FeSens/openTPU/THIRD_PARTY.md

# Third-party material

openTPU is licensed under the Apache License 2.0 ([LICENSE](LICENSE)). The files below are
generated by, derived from or copied from other projects and keep their own licences. No vendor
IP source is in this repository: the Xilinx / AMD cores (XDMA, DDR4 MIG, Aurora 64B/66B,
SmartConnect, clocking and system-management wizards) are created by the boards' Tcl at build
time from the builder's own Vivado install.

| Files | From | Licence |
|---|---|---|
| `boards/ypcb-00338/litedram/otpu_litedram.v`, `boards/bcu1525/litedram/otpu_ld4.v`, `boards/bcu1525/litedram_udimm/otpu_ld4.v`, `sim/verilator/otpu_ldc_ch.v` (Migen, through `tools/litedram/gen_ldc.py`) and their `csr.csv` / `sdram_init.py` (also under `opentpu/host/litedram*/` and `tests/data/litedram*/`) | Netlists and software headers generated by [LiteX](https://github.com/enjoy-digital/litex) and [LiteDRAM](https://github.com/enjoy-digital/litedram) (Copyright Enjoy-Digital and the LiteX developers). Each directory's `core.json` records the repositories and commits. | BSD-2-Clause |
| the VexRiscv CPU inside those netlists | [VexRiscv](https://github.com/SpinalHDL/VexRiscv) through `pythondata-cpu-vexriscv` (Copyright Spinal HDL contributors) | MIT |
| the `*.init` memory images beside those netlists | The LiteX BIOS, compiled; it links [picolibc](https://github.com/picolibc/picolibc) and LLVM's compiler-rt builtins (`pythondata-software-picolibc`, `pythondata-software-compiler_rt`) | BSD-2-Clause (LiteX); BSD-style, see picolibc's `COPYING.picolibc`; Apache-2.0 with LLVM exceptions (compiler-rt) |
| `boards/bcu1525/constraints/ddr4_c*.pins.xdc`, `ddr4_c*.udimm.pins.xdc`, `bcu1525_pins.xdc`, `bcu1525_wg_pins.xdc` (pads) | AMD XilinxBoardStore 2024.1, `boards/Xilinx/vcu1525/1.3/part0_pins.xml` (Copyright 2023 Advanced Micro Devices, Inc.) | Apache-2.0 |
| the same files (drive settings) | LiteX-Boards' `sqrl_xcu1525` platform | BSD-2-Clause |
| `boards/bcu1525/x2/pins_x2.xdc` (QSFP28 pads) | [Corundum](https://github.com/corundum/corundum)'s AU200 / VCU1525 constraints (Copyright The Regents of the University of California) | BSD-2-Clause-Views |
| `boards/bcu1525/link/otpu_link_gtcommon_bcu.v` | This project's module around the `GTYE4_COMMON` primitive. Its attribute values and tie-offs are the settings AMD's Aurora 64B/66B 13.0 core computes for 25.78125 Gb/s from a 161.1328125 MHz reference, extracted by `boards/bcu1525/link/scripts/gen_gtcommon.py` from the core's example design; none of the core's source is included. | Apache-2.0 (this project) |
| `boards/bcu1525/link/sim/otpu_link_phy_stubs.sv` (port lists) | Yosys `cells_xtra.v` | ISC |
| `tests/data/qwen36_chat_template.jinja`, `tools/pf500_models/Qwen3.6-35B-A3B/config.json` | The Qwen3.6-35B-A3B checkpoint's chat template and configuration (Alibaba Cloud), unmodified | Apache-2.0 |
| `tests/data/lfm2_chat_template.jinja` | The LFM2-2.6B checkpoint's chat template (Liquid AI, Inc.), unmodified | LFM Open License v1.0, a copy at `tests/data/LFM_OPEN_LICENSE_v1.0.txt` |
| `asic/nangate45/openlayout/skills/` | see its own `LICENSE` | as stated there |

Model weights are not in this repository; each checkpoint's licence applies to its use.
