FeSens/openTPU/docs/mxu_systolic.md

# A 2D systolic MXU (`MXU_IMPL=2`)

Goal: an MXU that scales to MCOLS = 8 (4 and 12 must also build) on the xc7k480t without the
broadcast fan-outs and the fabric adder tree that make MCOLS = 4 fail timing today
([mxu_study.md](mxu_study.md); the MCOLS = 4 builds of 2026-09-28: fmax 101-119 MHz at 97% of the
slices, worst paths route-dominated). Results must stay bit-identical to the ISA simulator, and
decode must not lose cycles.

**Since the MX column** ([mx_mxu.md](mx_mxu.md) section 9, branch `mx-rtl-prod`): the systolic
array is the only MXU (`IMPL` 0 and 1 are gone; `MXU_IMPL` must be 2), and everything after the
chain ends is new. The four `otpu_colend` DSPs and the per-column fp32 epilogue (i2f, the two
scale multiplies, the isum_4 loop) are replaced by `otpu_mxce` (rtl/tech: eight DSPs that take
each chain end times m << sh and a ninth that accumulates the whole row exactly in 48 bits), the
result FIFO holds the rows' integers, and E = MCOLS/2 lanes the columns share do the epilogue
once per output. The array below (hops, skews, the PAIR select in `otpu_pe`, row-gated pops,
command overlap) is unchanged; the column-end and epilogue lines of this page describe the
previous design.

## What changes, what stays

The MXU is a D x MCOLS dot-product engine: each advance, one D = 128-byte weight chunk (one K-block
of one output row, or two 4-bit blocks under PAIR) meets MCOLS activation blocks (ACT RAM, one per
column = one activation row), and each column reduces its 128 int8 x int8 products exactly, then
runs a per-column fp32 epilogue. `IMPL=0` broadcasts the decoded chunk to every column and sums in
a fabric tree; `IMPL=1` (study) sums along D in DSP cascades but still broadcasts the (skewed)
weights, and supports neither 4-bit weights nor PAIR.

`IMPL=2` keeps the MXU's front and back unchanged:

- the issuer, the chunk / scale FIFOs, the pop logic, the ACT RAM interface;
- the fp32 epilogue per column, in the ISA's order: i2f (exact) -> x weight scale -> x activation
  scale -> [PAIR: + partner column] -> isum_4 partial loop -> (p0+p2)+(p1+p3) -> result FIFO ->
  drain (ACC / ASCALE read-modify-write, RMAX). Integer sums are order-free; every fp op here is
  not, so the epilogue is not touched.

and replaces the dot product (operands -> s4, the exact integer block sum) with a systolic array.

## The array

```
            column 0            column 1                 column MCOLS-1
w chunk -> decode -> skew -> [hop] -> ... -> [hop] -> ... -> [hop]
                      |          |                        |
position i (chain g = i/16, stage k = i%16), in each column:
    act[j][i] (ACT RAM, delayed 1 + k + j: one SRLC32E per bit)
    M  = act * w          (DSP48E1 M register, one product per DSP)
    P  = PCIN + M         (stage k > 0; stage 0: P = M)  -> the chain's running sum
chain ends (8 per column): sub-block b = chains 2b, 2b+1 (32 positions, the 4-bit sub-block)
    v[b] = (chain 2b + chain 2b+1) * m_b   (otpu_colend: DSP b's pre-adder, multiplier, M)
    s4   = v0 + v1 + v2 + v3               (the four DSPs' PCIN cascade, DSP 3's P register)
deskew: column j's s4 delayed MCOLS-1-j cycles -> all columns aligned for the epilogue
```

- **Weights flow, not broadcast.** The chunk is decoded once (int8; int4 / E2M1 nibbles -> int8),
  skewed once per chain stage (shared SRLs, delay k), and then moves one register hop per column:
  column j sees it j cycles after column 0. Each hop register drives one DSP per position and the
  next hop: fan-out 2, not MCOLS.
- **PAIR (4-bit, 2M <= MCOLS):** columns j < M take the chunk's low block, columns j >= M its high
  block. Both decoded streams flow (2 x 8 bits per position per hop) and each column selects its
  stream with a per-command constant (`hi0[j]`) in the DSP48E1 itself (`otpu_pe`, in
  `rtl/tech/xilinx7/otpu_tech_dsp.sv`; the generic and DSP48E2 versions in `rtl/tech/generic`,
  `rtl/tech/xilinxus`: A = low, D =
  high, INMODE selects one through the pre-adder), so there is no fabric mux per position and
  column. `hi0[j]` drives the INMODE of the column's 128 DSPs (a 128 fan-out, the OOC's worst path
  at MCOLS 4: 152 MHz); it only changes between commands whose rows do not overlap.
- **Activations** stay per column (ACT RAM rows). Their delay, 1 (the decode register) + k (chain
  stage) + j (column), is at most 1 + 15 + 11 = 27 cycles for MCOLS <= 12: one SRLC32E per bit,
  the same cost as IMPL=1's chain skew alone. The column delay is free.
- **One product per DSP.** Two int8 products per DSP48E1 is not exact on a cascade (the study:
  the low field overflows after 3 accumulations), so each column has 128 product DSPs, 4 sub-block
  multipliers and the epilogue's fp multipliers: 138 DSP per column, 1,106 at MCOLS = 8 of the
  part's 1920 (measured; the rest of the design uses ~150).
- **The 4-bit sub-blocks** are 32 positions = two 16-stage chains, so the sub-block multipliers
  m_b apply at the chain ends, exactly as IMPL=0 applies them to its group sums. int8 uses
  m_b = 1. Chain length is fixed at 16 (`CL`).
- **Latency** S0 -> aligned s4: 1 (decode) + 16 (chain) + 1 (product) + 2 (v, s4) + MCOLS - 1
  (column skew, then deskew) = MCOLS + 19 cycles (23 at MCOLS 4, 27 at 8), against 7 for IMPL=0.
  It is paid once per MM command's drain (the study measured +17 cycles per MM chain for
  IMPL=1: negligible).

## Control travels with the data

Today every compute-pipeline register has the clock enable `en_c` (the pipeline freezes when a
row's next chunk has not arrived). Its fan-out and the control logic in front of it are the MXU's
worst paths on the board (the MXU `q_h` -> `mk` CE / tree / combine CE paths: 15-16 levels, ~88%
route). IMPL 2 removes it:

- **Row-gated pops.** A row's first block pops only when all of the row's chunks and scales are
  in the FIFOs (the FIFO holds a whole row already: replay requires KB <= DEPTH). A row then never
  stalls in its middle, `en_c` is constant 1, and the compute pipeline (array and epilogue) has no
  clock enable at all: a cycle without a pop is a bubble (an invalid slot), which the epilogue
  already handles between rows. The simulation checks that no row stalls.
- **Commands overlap.** The consumer used to run one command at a time: the next command's pops
  waited for the previous command's full drain (pipeline + epilogue + drain), so every MM paid the
  pipeline's latency, and IMPL 2's longer dot product (MCOLS + 19 cycles against 7) made that 16-20
  cycles more per MM. Now there are two heads over the command queue's two entries, the head `h`
  and the next command `n` (the tournament's `5cd6c39`: separate registers, no head pointer). The
  drain's head is `h` (the oldest command: its results, its ACC / ASCALE / RMAX state, its
  completion); the pop head moves to `n` (`pn`) as soon as the head's chunks have all popped,
  provided the pipeline treats both alike (the same PAIR and, under PAIR, the same M: `pr0`,
  `hi0` and `M0` are the only per-command state read after S0). The pop reads its command from
  `pop_q`, a register copy of the pop head's entry loaded with `h` and `n`, so neither side reads
  its command through a mux. The next command's rows follow the head's through the pipeline; the
  drain takes the head's rows (counted in `rows_live`, the pop head's in `rows_p`) and then moves
  on. IMPL 0 / 1 pop from `h` (no overlap).
- **Off the sequencer's path.** A command that becomes the head as it is accepted takes its chunk
  count (`c_left`) and its pop entry a cycle later, from `h` (`cl_ld`), not from the command
  (through the 16 x 16 multiply of its total) in the start cycle: it cannot pop before its release
  anyway, the pipeline is empty then, and the drained test waits for the load.
- **The result FIFO** is 64 rows for IMPL 2 (32 before): a row pops only while fewer than RF rows
  are between the pop and the drain, and one-block rows (attention scores, K = 128) fill the longer
  pipeline one per cycle; 32 blocked the pops (MLP decode +18%, LFM2 decode +4.8%).
- The drain keeps its own enable (the TMEM grant); it is outside the compute pipeline.

## Measured: area and fmax of `otpu_mxu` alone (Vivado 2026.1 OOC, synthesis + P&R)

xc7k480t-2, `otpu_mxu` out of context at a 6.667 ns clock (150 MHz), D = 128, board FIFO depth.
IMPL 0 is the tree with the DSP-cascade pair sums (`49ed2e0`); "use_dsp" is `465d629` (Vivado
infers the product DSPs); "DSP48E1" is `0cb4a7d` (`otpu_pe` instances, the stream select in the
pre-adder), the version on this branch.

| MXU | MCOLS | LUT | of which SRL | FF | slices | DSP | WNS | fmax |
|---|---|---|---|---|---|---|---|---|
| IMPL 0 (tree) | 4 | 26,389 | 163 | 15,504 | 9,479 | 282 | +0.153 | 153.5 MHz |
| IMPL 2, use_dsp | 4 | 24,426 | 2,651 | 31,540 | 12,232 | 554 | +0.332 | 157.9 MHz |
| IMPL 2, use_dsp | 8 | 47,822 | 5,440 | 60,926 | 23,706 | 1,106 | +0.045 | 151.0 MHz |
| IMPL 2, DSP48E1 | 4 | 22,504 | 2,699 | 34,894 | 12,298 | 554 | +0.109 | 152.5 MHz |
| IMPL 2, DSP48E1 | 8 | 44,779 | 5,304 | 67,997 | 24,214 | 1,106 | +0.068 | 151.5 MHz |

Per column (MCOLS 4 -> 8, DSP48E1): +5.6K LUT, +8.3K FF, +2.5K slices, +138 DSP. IMPL 0 per
column (synthesis, MCOLS 2 -> 4): +7.3K LUT, +3.4K FF, +70 DSP; in the MCOLS 2 -> 4 full builds
+7.8K LUT and +5.1K FF per column.

What this says, and what it does not:

- **LUTs go down** (-15% at MCOLS 4 against the tree; ~1.2K LUT less per column than the tree's
  synthesis). **Flip-flops more than double** (the weight hops, 2 x 8 bits per position and column,
  and the skew registers) and **DSPs double** (one product per DSP: 1,106 at MCOLS 8, ~1,250 with
  the rest of the design, 65% of the part; MCOLS 12 ~1,800, 94%).
- **OOC slices are higher** (12.3K against 9.5K at MCOLS 4). OOC P&R does not pack densely (the
  tree's 26.4K LUT would fit in 6.6K slices, the systolic array's 22.5K LUT / 34.9K FF in ~5.6K),
  so this is not the in-context density, but it is not the slice saving that would settle the
  MCOLS = 4 density cliff on its own: the full build has to show it.
- **Standalone fmax does not separate them**: the tree also makes 153 MHz alone. Its MCOLS = 4
  failure is in context (97% of the slices, route-dominated broadcast and control paths); the
  systolic array has no broadcast (fan-out 2 per hop), no compute clock enable and no fabric
  adder tree, which is what the full build tests.
- The worst paths alone: IMPL 0, the pair-sum pack register into the DSP C port; IMPL 2 at
  MCOLS 4, `hi0[j]` into the INMODE of its column's 128 DSPs (fan-out; a register per chain would
  remove it); at MCOLS 8, the weight skew SRL output into a DSP's A port (route).

## Measured: cycles (perf_qwen, board configuration, DDR3-1066, 120.755 MHz, fp4 weights)

`tools/perf_qwen.py --layers 0 --pos 256 --ddr 1066 --mhz 120.755 --wformat fp4 --head-format
int8 --bl 32 --wbl 8 --check` with PAIR and DSTEP; every run bit-exact with the ISA simulator.
Decode is one token at position 256; prefill is 6 rows (positions 256..261, `--rows 6 --logits
none`).

| model | IMPL 0, MCOLS 2 | IMPL 0, MCOLS 4 | IMPL 2, MCOLS 4 | IMPL 2, MCOLS 8 |
|---|---|---|---|---|
| LFM2 decode | 1,319,029 | 1,319,029 | 1,320,453 (+0.11%) | 1,320,668 (+0.12%) |
| Qwen3.5 decode | 4,848,785 | 4,832,273 | 4,832,035 (-0.35%) | 4,832,472 (-0.34%) |
| Qwen3 decode | 3,537,826 | | 3,541,285 (+0.10%) | |
| LFM2 prefill, 6 rows | 4,243,796 | | 2,949,361 (-31%) | 1,736,596 (-59%) |
| Qwen3.5 prefill, 6 rows | | 12,059,908 | 11,998,949 (-0.5%) | 9,323,037 (-23%) |
| Qwen3 prefill, 6 rows | 12,441,375 | | 8,979,279 (-28%) | 5,837,044 (-53%) |
| LFM2 prefill, 8 rows | 5,689,462 | | | 1,958,019 (-66%) |
| Qwen3 prefill, 8 rows | 16,559,838 | | | 6,813,500 (-59%) |

(Percentages against IMPL 0 at MCOLS 2 where it was measured; Qwen3.5's prefill against IMPL 0
at MCOLS 4. IMPL 0 ran on `11e00c4` (the tree with the DSP-cascade pair sums), IMPL 2 on the
systolic branches before the stream engine merge: `465d629` (MCOLS 4 and the 6-row MCOLS 8 runs)
and `0cb4a7d` (the 8-row runs), which have the same pipeline latency (LDOT).)

Decode does not regress (the gate: <= 1%). The overlap of commands pays IMPL 2's longer pipeline.

**The next bottleneck at MCOLS 8.** LFM2's prefill is still MXU-bound (MXU busy 95%, MAC 80.6% of
the cycles: 6 rows leave 2 of 8 columns idle). Qwen3.5's is not: DeltaNet is 65% of the cycles,
the DSTEP head steps (serial per token, 3.54M cycles of work in 9.32M, the same at any MCOLS) set
the pace, and the MXU waits 5.3M cycles in gaps after the QACT flush (`qwen35.py:1029`) and the
state window stores (`qwen35.py:1104`) in front of them. More columns do not help there; the
stream engine's state step does. Qwen3 sits between the two: MXU busy 90%, MAC 73.8%, but 9.7% of the
cycles the chunk FIFO is empty while streaming (the weight stream, not the array), and attention
is 63% of the cycles with the longest MXU gap (0.61M cycles) after the attention setup's QACT
(`attention.py:42`).

## Measured: the full build at MCOLS 4 (se-sys `2f80230`, 2026-09-29)

`make bit DDR=1066 AXI_BL=32 MCOLS=4 SE=v2`, CORE_MHZ 120.755, Vivado 2026.1 on the build host (the
stream engine v2 with its timing fixes, `202856d`, and `MXU_IMPL=2`). Timing not met: WNS
-0.381 ns (fmax 115.4 MHz), TNS -312 ns on 2,320 endpoints, WHS +0.016 ns.

| build | fmax | LUT | FF | slices | DSP | u_mxu LUT / FF / DSP |
|---|---|---|---|---|---|---|
| SE v2, MCOLS 2, IMPL 0 (`600c087`) | 117.9 MHz | 206,064 | | 64,441 (86.3%) | 301 | 19,600 / 10,435 / 142 |
| SE v2, MCOLS 4, IMPL 2 (`2f80230`) | 115.4 MHz | 210,766 | 178,678 | 68,898 (92.3%) | 713 | 25,418 / 31,570 / 554 |
| SE v1, MCOLS 4, IMPL 0 (m4b, 2026-09-28) | 115.8 MHz | 227,516 | 175,643 | ~72.3K (96.9%) | 493 | 31,459 / 19,662 / 282 |

MCOLS 2 -> 4 costs +4.7K LUT and +4.5K slices with the systolic MXU (+15.6K LUT with the tree),
so the design is 4.6 points of slices below the MCOLS 4 cliff. It still does not make
120.755 MHz: the failing paths are spread over the MXU's drain control (`q_h` -> `mk` CE and
`rx` resets, 15-16 levels, 89% route; `u_seq` -> `c_left`), the TMEM port-1 BRAM -> DMA `lb`
register (BRAM to BRAM, 5-6 levels), the AXI adapter (`qc` -> `qb_n` / `k1r_n`, 17-18 levels,
failing at MCOLS 2 too), and a few VPU / sequencer paths, all within -0.35 to -0.38 ns. The
compute array itself (hops, chains, skews) is not among them.

## Placement on the YPCB (release r2, MCOLS 8)

r2's first MCOLS 8 build (`f55949f9`, FAST, 100 MHz; MX MXU, MXU_E 8, one TMEM copy) placed but did
not route: "not routable, global congestion level 6", the router's first estimate South level 7
over 23.8% of the tiles (tile X 32-95, Y 80-239), and the same with Congestion_SpreadLogic_high.
Utilization was not the cause (60% LUT, 79% slices, 68% DSP). Each pin-box half perimeter per
net, summed per driver > load sub-block over the placed design, put about 55% of the level 7
window's wire demand on the array and its feed: the activation skews (`g_ask.g_p.u_a`) into the
PEs 15.5%, the weight hops (`wc`) 12.4% + 9%, the weight skew into column 0 6.2%, the chain ends
into the column ends 7%; the TMEM's single bank was not among the top 15. The placer had spread
each array column's 16-DSP cascade chains over 5-7 of the device's 12 DSP columns, across the
whole die, so position i of column j sat nowhere near position i of column j+1: the hop bits'
pin boxes were ~220 tiles, the design's longest.

`boards/ypcb-00338/constraints/otpu_mxu_place.tcl` (read by `create_project.tcl` for every build,
late, on the implemented netlist) LOCs the array as a grid at MCOLS 8 and up; below MCOLS 8 it
leaves the array to the placer (MCOLS 4 is better without it, below). It reads MCOLS and D from
the netlist's PE names and takes the part's column table:
- Array column j goes on one DSP column, positions 0..D-1 in order up it (the chains stay whole,
  position i is level in every column), with its column end (`otpu_mxce`, a 9-DSP cascade) above
  them and the column's scale RAM level with it. At MCOLS 8 that is DSP48_X1..X8 (tile X 14 29 34
  49 54 69 74 89), rows 10..146 of 160. Each chain's last DSP feeds its own DSP of the column end
  through fabric from its P register, so chain 0's end crosses 113 DSP rows (r2.1's m8 163ab46d:
  0 levels, 5.3-5.8 ns of route, -0.005 ns before userclk1's reroute; 76 such endpoints under
  +0.2 ns). `OTPU_MXU_CE=mid` puts the column end in the middle instead: chains 0..3 (positions
  0..63), the column end on rows 74..82, chains 4..7, the longest chain-end hop 65 rows. It does
  not pay: r2.1's m8 4f8be3d2 (mid) put the congestion on the column ends, three placer windows
  at level 5 (101-103%, tile X 27-58, Y 200-238: u_mxu, u_mem, u_seq, u_ch1) against 163ab46d's
  one, the weight feed's endpoints under +0.2 ns went from 88 to 455, and core_clk from -0.003 to
  -0.156 ns, so the default stays above the array (`top`, the same LOCs as before `mid` existed).
- The ACT RAM's memory of column j (`otpu_actram g_row[j]`: 4 pieces of 4 RAMB36, piece p = bytes
  32p..32p+31, and its scale RAM) goes in the block RAM column beside it, RAMB36_X1..X8 (tile X 17
  26 37 46 57 66 77 86). Each block RAM sits level with the 8 positions its bytes feed.
- The weight RAMs (`g_fd`, `u_fs0`, `u_fs1`) go in RAMB36_X0 (tile X 6), beside column 0. Through
  `wsel` a `g_fd` RAM's bits reach two position ranges, an 8-bit format's and a 4-bit one's (the
  high half's D/2 lower): `g_fd[1]`'s `mem_reg_5` reaches positions 58-62 and 117-125. Each goes
  level with the middle of the rows of the positions its outputs reach (`OTPU_MXU_WRAM=loads`,
  the default since r2.1: `all_fanout` from its outputs to the `g_wsk` skews), `u_fs0` / `u_fs1`
  (the scale entries, no position) at their places of the linear spread. On 163ab46d's opt
  checkpoint that leaves the farthest position 35 DSP rows from its RAM (65 for `g_fd[1]`'s
  `mem_reg_6`, which reaches positions 0-6, 63-67 and 126-127) where the linear spread in name order
  (`OTPU_MXU_WRAM=linear`, release r2 and r2.1's 163ab46d) left 75: in 163ab46d the weight feed's
  endpoints (2-3 levels, 5.0-5.7 ns of route) were 88 under +0.2 ns (worst +0.009), in 4f8be3d2
  (column ends in the middle) 455 (-0.156 ns, its worst).
- DSP X0 and X9..X11 (640 sites) stay free for the VPU, QUANT and the epilogue lanes.

It stops (an error, and `build.tcl` fails the build if its summary line is missing from the run's
log) when a name pattern matches no cells, the PEs are not MCOLS x D, or a chain is not in
position order. The LOCs it set are in the run's `otpu_mxu_place.xdc`. The environment overrides
the table: `OTPU_MXU_DSP_COLS`, `OTPU_MXU_BRAM_COLS`, `OTPU_MXU_WRAM_COL`, `OTPU_MXU_BASE`.
`OTPU_MXU_PLACE=1` places the array at any MCOLS, `OTPU_MXU_PLACE=0` at none (the summary line
then says off, as it does below MCOLS 8). DSP cascades cross clock-region rows on the
xc7k480t (25 of the free placement's 64 chains did, and every region boundary's PCOUT reaches the
next PCIN through one pip), so the columns need no gaps.

On the same opt checkpoint (`f55949f9`, default directives, 1,266 LOCs), the placer's congestion
estimate fell from 64x64 regions (North) to 16x16 (8x8 West), with no window in
`report_design_analysis -congestion`, and the design routed with no routing errors:

| | free placement | the grid |
|---|---|---|
| route | not routable (level 6; router estimate South level 7) | routed, 0 errors |
| core_clk (100 MHz) | post-place WNS -0.245 ns | routed WNS +0.013 ns, WHS +0.050 ns |
| sum of pin-box half perimeters | 6.09M tiles | 4.59M (-25%) |
| activation skews -> PEs | 587K | 33K |
| weight hops (`wc`) | 549K | 121K |
| weight skew -> column 0 | 340K | 50K |
| ACT RAM -> activation skews | 72K | 38K |
| chain ends -> column ends | 170K | 234K (the column ends above the array) |
| LUT / FF / slices | 179.3K / 148.7K / 79.1% | 177.9K / 148.7K / 78.7% |

The only failing endpoint was in the PCIe block's 500 MHz `userclk1` (-0.003 ns, inside the IP),
the class `build.tcl`'s `userclk1_reroute.tcl` routes again. The router's final report keeps
only Long-line level 5 windows (tile X 64-95, Y 240-271: XDMA's DMA 17% + 11%, u_mxu 16%). The SRL
skews and the hop registers came next to their DSPs on their own, so there are no pblocks.
No logic or cycles change.

At MCOLS 4 the grid is the worse placement, so it is off there by default. The same tree
(`d352e53d`, release r2's m4 at 133.33 MHz, the production strategy) built with it (r2m4) and
without it (r2m4ng):

| | the grid (r2m4) | the placer's (r2m4ng) |
|---|---|---|
| core_clk WNS / TNS | -0.536 / -236.1 ns | -0.281 / -33.9 ns |
| core_clk -> core_clk2x WNS / TNS | -0.390 / -146.2 ns | -0.175 / -9.8 ns |
| core_clk2x -> core_clk WNS | -0.187 ns | +0.026 ns |
| all clocks' TNS | -382.6 ns | -43.7 ns |
| the memory core's sys clock (crg) WNS | +0.019 ns | +0.098 ns |
| slices / LUT | 57,519 (77.05%) / 172,736 | 54,176 (72.57%) / 169,571 |
| the router's worst congestion | South level 5, 110% | North and East level 5, 105% / 104% |

## Plan and status

1. Done: `IMPL=2` dot product with the unchanged epilogue, bit-exact on the MM / 4-bit / PAIR RTL
   tests, the MM fuzz and test_perf at MCOLS 4 and 8, and the full models (`perf_qwen --check`).
2. Done: row-gated pops (`en_c` = 1), command overlap, the 64-row result FIFO; cycles above.
3. Done: OOC area and fmax at MCOLS 4 and 8 (above); MCOLS 12 queued.
4. Done: the PAIR select in the DSP pre-adder (`otpu_pe`).
5. The combined build (branch `se-sys`: the stream engine v2 + `MXU_IMPL=2`, MCOLS 4). `make bit`
   selects the MXU through `create_project.tcl`'s MXU argument (systolic, the default on this
   branch, or tree). MCOLS 8 after the LiteDRAM memory path frees its area.
6. Done on `se-sys2` (se-cand2 + se-sys): the drain's and the pop's command state from the head /
   next registers and `pop_q` (no head-pointer mux; `c_left` off the sequencer's path), and the
   DMA's ST read data registered before the buffer (TMEM -> `lb`). The adapter's paths go with the
   LiteDRAM memory path. The next full build waits for the user's OK.
7. Later: a registered copy of `hi0` per chain (the INMODE fan-out); the fp epilogue's area (now
   the MXU's largest LUT consumer per column).
