FeSens/openTPU/docs/offload.md

# Bigger than DRAM: MoE expert offloading

Status: phase 1, a design study, revised for path (a). Nothing here has run on the card yet.
Every number is marked as one of: measured (with where), simulated from real router traces, or
an *estimate*.

The goal (the user's) is to run models that do not fit in the card's 4 GiB, streaming from the
host and its SSD, starting with mixture-of-experts (MoE) models. An MoE decode token reads only
its top-k experts per layer, a few percent of the weights. So the card can keep the dense part
and a cache of experts on board, and fetch the rest.

**The rule: openTPU does all the computing.** The host CPU is not a compute resource. It stores
the model (SSD, page cache, RAM) and is the source of the DMA; nothing else. The card:

- routes (the router MM, and the top-k by autodecode's ARGMAX knock-out);
- asks for the experts it lacks;
- waits for them inside its own run;
- computes every expert.

A host daemon only moves bytes. An earlier version of this study also modelled a hybrid, where
the host computed the missing experts, and host-side routing. Both are gone, along with the
host fp4 kernel.

**Summary.**

- **Models (section 2).**
  - Gemma 4 E4B is dense. Its per-layer-embedding (PLE) table is what exceeds 4 GiB, and the
    host can write the token's row (section 7).
  - The Gemma 4 MoE is gemma-4-26B-A4B.
  - The best fits for the card are LFM2.5-8B-A1B (just over 4 GiB), gemma-4-26B-A4B and
    Qwen3.5-35B-A3B (3-4x the card, inside host RAM), and Qwen3-Next-80B-A3B (larger than host
    RAM: the SSD tier).
- **The hierarchy (section 1, measured on the card host).** Card DRAM runs at 14 GB/s, PCIe Gen1 at
  1.3 GB/s and the SSD at 0.51 GB/s. A missing expert costs about 10x its compute time to bring
  over Gen1.
- **Router traces (section 3; 4 texts x 2048 tokens, CPU).** At the card's cache size, a
  per-layer LRU hits:
  - 98.6% of LFM2.5-8B-A1B's picks (85% of its experts fit);
  - 76% of Gemma 4 26B-A4B's (19% fit);
  - 66% of Qwen3.5-35B-A3B's (13% fit).

  Fixed profiles transfer badly across texts: Gemma 4 gets 22-41%, Qwen3.5 11-23%.
- **Tokens per second, path (a) (section 4, simulated).**

  | Model | Gen1 | Gen2 | All resident |
  |:--|--:|--:|--:|
  | LFM2.5-8B-A1B | 13.0 | 13.5 | 13.7 |
  | gemma-4-26B-A4B | 3.9 | 5.0 | 5.9 |
  | Qwen3.5-35B-A3B | 4.2 | 5.8 | 7.8 |

  - The card computes the experts it has while the missing ones stream. That is worth +12-14%
    over waiting for the last one on Gemma 4 and Qwen3.5.
  - Prefetch from router predictions is at best neutral (Qwen3.5 at Gen2) under LRU slots.
    Otherwise it loses 1-14% with the prediction's k best, and more with its 2k best: cache
    pollution, plus the link and DRAM time of wrong guesses. With the slots by decayed use
    the model gives the k best +3-6.5% on Qwen3.5-35B-A3B, but as built they lost 5% on the
    card (section 12.5); they are off by default.
  - 4-bit experts are worth 2.3-2.9x over int8.
  - Request and flag latency (10-100 us) moves results by under 1%.
- **Design (section 5).** One new instruction, `WAITW` (wait on a DRAM word), agreed with
  autodecode. Everything else is built from autodecode's `ARGMAX`, `RLD`, the register-count
  `LOOP` and `CHAIN`. Per MoE layer, the card:
  1. posts its k expert ids to a mailbox in DRAM;
  2. computes the experts a directory in DRAM says it has;
  3. `WAITW`s on each missing expert's directory entry, which the host writes after that
     expert's DMA.

  One run per reply; no halts.
- **PCIe Gen2 (section 6).** +30% for Gemma 4, +39% for Qwen3.5-35B and +3.5% for LFM2.5.
  Parked until phase 2 runs. It is then the biggest single lever for models 3-4x the card.
- **SSD tier (section 8).** Models larger than host RAM run at the link's and the SSD's pace:
  - Qwen3-Next-80B-A3B: ~2.4 tok/s at Gen1, ~3.5 at Gen2 (*extrapolated* from Qwen3.5-35B's
    traces);
  - gpt-oss-120b and Qwen3.5-122B-A10B: under ~1 tok/s at Gen1. Their experts are large and the
    card caches only 1-4% of them.
- **Next (section 9).** LFM2.5-8B-A1B end to end on the ISA simulator, with the card's 4 GiB,
  the router on the card, per-layer LRU slots and a host DMA daemon.
- **otpu-chat (section 14).** The chat runs LFM2.5-8B-A1B, Qwen3.5-35B-A3B and gemma-4-26B-A4B
  with moe_card's engine and settings (opentpu/host/streamed.py). Each model's pool is packed
  once beside its checkpoint and checked before the image is built.
- **Lookahead expert scheduling (section 15).** OpenBMB's LES, asked for by name for MiniCPM-V
  4.7 (Qwen3.5-35B-A3B's backbone). Its prefetch of the next layer's predicted experts models
  at +1-3% here (+12% even for a perfect predictor), so it is closed. Its other half, the
  card doing the work it has while the misses stream, is taken: the shared expert now runs
  beside the request. A k = 1 MTP loop bounds at 1.25x on the 35B (15.6), and the base's MTP
  head drafts for MiniCPM-V, which has none, as well as for the base (0.78 accepted).

The tools:

- `tools/offload/survey.py`: the model survey, from the checkpoints' safetensors headers.
- `router_trace.py`: the expert choices of a Hugging Face model on a text, on CPU.
- `cachesim.py`: expert-cache hit rates on those traces, and path (a)'s event model.
- `lesim.py`: the next layer's predictions against those traces, and the decode's timeline
  with and without their prefetch (section 15).
- `mtp_bound.py`: the same timeline with a two-row MTP verify a step (15.6);
  `mtp_transplant.py`: the base 35B's MTP head's acceptance on a model's own replies (15.6).

## 1. The memory hierarchy

| Level | Size | Bandwidth | Source |
|:--|--:|--:|:--|
| Card DRAM (2 x DDR3-1066) | 4 GiB | 13.9-14.5 GB/s while decoding | card counters, README |
| PCIe Gen1 x8 (XDMA), host -> card | | 1.26-1.34 GB/s (the card host); 1.42 (the build host); 1.7 in best-placed 8 MiB calls (the build host) | `otpu-selftest`, docs/host.md |
| card -> host | | 0.84-1.00 GB/s (the card host) | `otpu-selftest` |
| one small DMA call (64 B - 4 KiB) | | 11-15 us (the build host, interrupt mode) | docs/host.md |
| Host RAM (the card host, DDR3, i7-4790) | 31 GB (23-28 free) | 22.6 GB/s (4-thread fp32 GEMV), 13.6 (1-thread sum) | measured 2026-09-29 |
| SSD (Crucial BX500 240 GB, SATA, LUKS + btrfs zstd) | 123-140 GB free | 512 MB/s (O_DIRECT, 4 MiB, 1 reader), 515-524 (2-4 readers), 227 MiB/s (128 KiB x 4) | measured 2026-09-29 |

Everything is measured on the card host, the card's host, unless marked otherwise.

- The SSD figures read a 4 GiB file of random bytes written for the test
  (`dd iflag=direct`). Reads of the models' own files go through btrfs compression, are not
  O_DIRECT, and come from the page cache.
- the card host's other disk is an HDD that is not ours.
- The card sits in the CPU's x16 slot (`max_link_speed` 8 GT/s x16 on the root port, 00:01.0),
  so a Gen2 card would train at 5 GT/s.

The ratios decide the design. Card DRAM : PCIe : SSD is 14 : 1.3 : 0.5. An expert that misses
the card's cache costs about 10x its compute time over Gen1, and 28x from the SSD. The design
has to miss rarely: size the cache, choose the eviction policy, keep experts in 4 bits. It must
also hide what it can of each miss behind the card's own work.

## 2. Models

`python3 tools/offload/survey.py --json survey.json` reads the safetensors headers of each
checkpoint, leaving out vision, audio and MTP weights. The columns:

- **Bytes:** our formats: fp4 blocks (4.25 bits per weight, docs/quant.md), with the LM head in
  int8.
- **Bytes / token:** what a decode token streams: dense, shared, top-k experts and head. The
  embedding row is looked up, not streamed.
- **On-card part:** what must stay on the card: dense, shared, head, and the embedding in int8
  when it is not tied.
- **Fits card:** allows 0.3 GB for KV / state, I/O and programs.
- **Fits host RAM:** the fp4 model in 26 GB.

| Model | Layers (MoE) | Experts, top-k | One expert | Params, total / active | Bytes / token | On-card part | Expert pool | Fits card / host RAM |
|:--|--:|--:|--:|--:|--:|--:|--:|:--|
| gemma-4-26B-A4B | 30 (30) | 128, top-8 | 3.16 MB | 25.2 / 3.82 B | 2.40 GB | 1.64 GB | 12.1 GB | no / yes |
| gemma-4-E4B | 42 (0) | dense | - | 7.5 / 4.70 B | 2.83 GB | 2.83 GB | 0.0 GB | no (yes without the PLE) / yes |
| LFM2.5-8B-A1B | 24 (22) | 32, top-4 | 5.85 MB | 8.5 / 1.69 B | 1.03 GB | 0.51 GB | 4.1 GB | no / yes |
| LFM2-8B-A1B | 24 (22) | 32, top-4 | 5.85 MB | 8.3 / 1.56 B | 0.89 GB | 0.38 GB | 4.1 GB | no / yes |
| LFM2-24B-A2B | 40 (38) | 64, top-4 | 5.01 MB | 23.8 / 2.33 B | 1.30 GB | 0.54 GB | 12.2 GB | no / yes |
| Qwen3-30B-A3B | 48 (48) | 128, top-8 | 2.51 MB | 30.5 / 3.04 B | 1.77 GB | 1.13 GB | 15.4 GB | no / yes |
| Qwen3.5-35B-A3B | 40 (40) | 256, top-8 + shared | 1.67 MB | 34.7 / 2.95 B | 1.82 GB | 1.81 GB | 17.1 GB | no / yes |
| Qwen3-Next-80B-A3B-Instruct | 48 (48) | 512, top-10 + shared | 1.67 MB | 79.7 / 3.56 B | 2.05 GB | 1.57 GB | 41.1 GB | no / no |
| Qwen3.5-122B-A10B | 48 (48) | 256, top-8 + shared | 5.01 MB | 122.1 / 9.01 B | 5.17 GB | 4.03 GB | 61.6 GB | no / no |
| gpt-oss-20b | 24 (24) | 32, top-4 | 13.22 MB | 20.9 / 3.61 B | 2.21 GB | 1.53 GB | 10.2 GB | no / yes |
| gpt-oss-120b | 36 (36) | 128, top-4 | 13.22 MB | 116.8 / 5.13 B | 3.02 GB | 1.71 GB | 60.9 GB | no / no |
| OLMoE-1B-7B-0125 | 16 (16) | 64, top-8 | 3.34 MB | 6.9 / 1.18 B | 0.68 GB | 0.36 GB | 3.4 GB | yes / yes |
| granite-3.1-3b-a800m-instruct | 32 (32) | 40, top-8 | 1.25 MB | 3.3 / 0.88 B | 0.51 GB | 0.19 GB | 1.6 GB | yes / yes |
| granite-4.0-h-tiny | 40 (40) | 64, top-6 + shared | 1.25 MB | 6.9 / 1.47 B | 0.86 GB | 0.55 GB | 3.2 GB | yes / yes |
| granite-4.0-h-small | 40 (40) | 72, top-10 + shared | 5.01 MB | 32.2 / 8.80 B | 4.88 GB | 2.88 GB | 14.4 GB | no / yes |
| DeepSeek-V2-Lite | 27 (26) | 64, top-6 + shared | 4.60 MB | 15.7 / 2.45 B | 1.41 GB | 0.91 GB | 7.6 GB | no / yes |
| Moonlight-16B-A3B-Instruct | 27 (26) | 64, top-6 + shared | 4.60 MB | 16.0 / 2.58 B | 1.54 GB | 1.17 GB | 7.6 GB | no / yes |
| SmallThinker-21BA3B-Instruct | 52 (52) | 64, top-6 | 3.13 MB | 21.5 / 3.33 B | 1.96 GB | 1.39 GB | 10.4 GB | no / yes |
| SmallThinker-4BA0.6B-Instruct | 32 (32) | 32, top-4 | 1.88 MB | 4.3 / 0.86 B | 0.58 GB | 0.58 GB | 1.9 GB | yes / yes |
| Phi-mini-MoE-instruct | 32 (32) | 16, top-2 | 6.27 MB | 7.6 / 2.23 B | 1.25 GB | 0.99 GB | 3.2 GB | no / yes |
| Mixtral-8x7B-v0.1 | 32 (32) | 8, top-2 | 93.59 MB | 46.7 / 12.75 B | 6.84 GB | 0.98 GB | 24.0 GB | no / yes |

Notes:
- **Gemma 4 E4B is dense** (`enable_moe_block` false). Its 2.82 B per-layer-embedding
  parameters (1.5 GB in fp4) are what push it over 4 GiB: 2.83 GB without them, 4.33 GB with.
- **The Gemma 4 MoE is gemma-4-26B-A4B.** It has 30 layers of 128 experts (width 704, top-8).
  Every layer also has a dense 2112-wide MLP beside the MoE, and the two outputs are added. The
  router reads the post-attention residual through its own RMSNorm, then applies softmax,
  renormalizes the top-8, and multiplies by a learned per-expert scale.
- The ones that already fit (OLMoE, Granite 3.1 3B, Granite 4.0 H Tiny, SmallThinker-4B) need
  no offloading, only the MoE block.
- Layer types:
  - Already covered: LFM2-MoE (convolution + attention: `opentpu/llm/lfm2.py`), Qwen3-MoE
    (`qwen3.py`), and Qwen3.5-MoE / Qwen3-Next (Gated DeltaNet + gated attention: `qwen35.py`).
  - Gemma 4 comes with the `gemma4` port (E2B).
  - New layers needed: gpt-oss (attention sinks, clamped SwiGLU with biases, MXFP4), DeepSeek-V2
    (MLA), Granite 4 (Mamba2).
- gpt-oss ships its experts in MXFP4 (E2M1, a power-of-two scale per 32). Our two-level format
  holds a 128-block of it exactly when its four sub-block exponents span at most 3 (a bf16 base
  times multipliers 1, 2, 4, 8). A conversion can check that per block (not measured).

## 3. Router traces and the expert cache

`tools/offload/router_trace.py` runs the Hugging Face model in bf16 on CPU, on the build host. The
weights are memory-mapped from the checkpoint under a cgroup memory limit, or offloaded to disk.
It runs over four texts of 2048 tokens each, teacher-forced:

- prose: the first chapters of *Pride and Prejudice*;
- wiki: the Wikipedia article "Roman Empire";
- code: `opentpu/isasim.py`;
- technical markdown: `docs/host.md`.

Routing is causal, so a token's experts in this prefill are the ones a decode producing that
text would pick. For every MoE layer and token, the tool records the top-k and three predictions
of it. Each prediction applies the layer's router, through its norm, to an earlier state:

- `pre`: the layer's input, before the mixer;
- `prev_r`: the previous layer's router input;
- `prev_in`: the previous layer's input.

A check re-runs each router on the recorded residual. It gets back the recorded experts for this
share of the tokens:

- LFM2.5: 98.9-99.1%;
- Gemma 4: 92.8-98.4%;
- Qwen3.5-35B-A3B: 83-89%, whose 8 of 256 experts leave more near-ties.

The rest are ties between the k-th and (k+1)-th expert. bf16 logits make those common, and a
second top-k (of 2k) breaks them the other way. The recorded choice is the model's own.

`tools/offload/cachesim.py` replays each trace in decode order: token by token, layer by layer,
a layer's k experts at once. It plays them against a cache of C expert slots, under six
policies:

- `static`: the C experts most picked in the other three texts, never replaced;
- `lru`: shared by all layers;
- `lru_layer`: the slots split evenly over the layers;
- `lfu_layer`: per layer too, the victim the cached expert of least decayed use (section 5.5);
- `lfu`: counts, with the profile as a prior (until 2026-10-23 it made room for one miss a
  request and took them all in, up to k - 1 experts over C; the column is the fixed one's,
  docs/bend.md);
- `opt`: Belady, the upper bound.

Every policy starts from the static set, because the host fills the card from a profile at
load. Hit rates are the mean over the four texts, each scored with the profile of the other
three.

Hit rates, and a token's misses under the per-layer LRU (out of L x k requests):

| Model | Cache | static | lru | lru_layer | lfu | opt | misses / token (lru_layer: mean, p90) |
|:--|:--|--:|--:|--:|--:|--:|--:|
| LFM2.5-8B-A1B | 70 slots (10%) | 0.174 | 0.000 | 0.475 | 0.216 | 0.578 | 46.2, 59 of 88 |
| LFM2.5-8B-A1B | 141 slots (20%) | 0.321 | 0.554 | 0.586 | 0.375 | 0.768 | 36.4, 50 of 88 |
| LFM2.5-8B-A1B | 211 slots (30%) | 0.425 | 0.691 | 0.704 | 0.500 | 0.861 | 26.0, 38 of 88 |
| LFM2.5-8B-A1B | 352 slots (50%) | 0.642 | 0.874 | 0.862 | 0.721 | 0.954 | 12.1, 20 of 88 |
| LFM2.5-8B-A1B | 528 slots (75%) | 0.872 | 0.983 | 0.966 | 0.925 | 0.994 | 3.0, 6 of 88 |
| LFM2.5-8B-A1B | 595 slots (85%), the card | 0.942 | 0.996 | 0.986 | 0.972 | 0.998 | 1.2, 3 of 88 |
| gemma-4-26B-A4B | 192 slots (5%) | 0.084 | 0.000 | 0.459 | 0.140 | 0.576 | 129.8, 171 of 240 |
| gemma-4-26B-A4B | 384 slots (10%) | 0.168 | 0.536 | 0.573 | 0.257 | 0.756 | 102.4, 143 of 240 |
| gemma-4-26B-A4B | 744 slots (19%), the card | 0.293 | 0.755 | 0.761 | 0.435 | 0.885 | 57.3, 91 of 240 |
| gemma-4-26B-A4B | 768 slots (20%) | 0.302 | 0.765 | 0.770 | 0.446 | 0.890 | 55.3, 89 of 240 |
| gemma-4-26B-A4B | 1152 slots (30%) | 0.437 | 0.874 | 0.869 | 0.605 | 0.947 | 31.4, 55 of 240 |
| gemma-4-26B-A4B | 1920 slots (50%) | 0.670 | 0.971 | 0.963 | 0.827 | 0.988 | 8.9, 17 of 240 |
| gemma-4-26B-A4B | 2880 slots (75%) | 0.904 | 0.997 | 0.995 | 0.977 | 0.999 | 1.2, 3 of 240 |
| Qwen3.5-35B-A3B | 512 slots (5%) | 0.072 | 0.433 | 0.471 | 0.162 | 0.659 | 169.4, 226 of 320 |
| Qwen3.5-35B-A3B | 1024 slots (10%) | 0.138 | 0.598 | 0.608 | 0.277 | 0.776 | 125.4, 179 of 320 |
| Qwen3.5-35B-A3B | 1307 slots (13%), the card | 0.177 | 0.650 | 0.656 | 0.330 | 0.815 | 110.2, 162 of 320 |
| Qwen3.5-35B-A3B | 2048 slots (20%) | 0.264 | 0.748 | 0.748 | 0.450 | 0.882 | 80.8, 124 of 320 |
| Qwen3.5-35B-A3B | 3072 slots (30%) | 0.386 | 0.845 | 0.835 | 0.586 | 0.933 | 52.8, 84 of 320 |
| Qwen3.5-35B-A3B | 5120 slots (50%) | 0.610 | 0.943 | 0.929 | 0.801 | 0.977 | 22.6, 37 of 320 |
| Qwen3.5-35B-A3B | 7680 slots (75%) | 0.862 | 0.989 | 0.982 | 0.956 | 0.996 | 5.9, 12 of 320 |

Prediction accuracy: the share of a layer's top-k that the prediction's top-k names.

| Model | pre | prev_r | prev_in |
|:--|--:|--:|--:|
| LFM2.5-8B-A1B | 0.82 | 0.67 | 0.72 |
| gemma-4-26B-A4B | 0.79 | 0.72 | 0.65 |
| Qwen3.5-35B-A3B | 0.80 | 0.64 | 0.71 |

- **Adapt, do not profile.** At the card's size, a fixed set of the experts most picked in the
  other texts catches:
  - 0.92-0.96 of LFM2.5's picks (85% of the pool);
  - only 0.22-0.41 of Gemma 4's (19%), whose own-text profile would catch 0.80;
  - 0.11-0.23 of Qwen3.5-35B-A3B's (13%).

  Which experts are popular depends on the text. LRU adapts within a few tokens (0.74-0.78 on
  every text). LFU seeded with the profile adapts too slowly (0.40-0.51).
- **Global LRU thrashes below one token's sweep.** A token asks every layer in turn, a loop of
  L x k experts. At 5% of Gemma 4's pool (192 slots, fewer than the 240 a token asks for) it
  hits nothing. Split per layer, it degrades gracefully. At the card's sizes the two are within
  a point. The runtime splits its slots per layer, which also makes eviction race-free on the
  card (section 5.2).
- **Decayed use beats recency.** Per layer, replacing the expert whose uses, each halving every
  32 requests of its layer, sum least (`lfu_layer`) misses 9-15% less than `lru_layer` at the
  card's sizes (misses a token):

  | Model | slots | lru_layer | lfu_layer |
  |:--|:--|--:|--:|
  | LFM2.5-8B-A1B | 28 a layer | 0.83 | 0.73 |
  | gemma-4-26B-A4B | 682, fp4 experts and int8 head (section 11.3) | 62.9 | 53.6 |
  | gemma-4-26B-A4B | 789, fp4 head | 53.5 | 45.3 |
  | Qwen3.5-35B-A3B | 1280, the card's (32 a layer) | 111.4 | 100.7 |

  Half-lives of 16 to 128 requests are within a point. Allotting the slots unevenly over the
  layers (from the other texts' curves) gains nothing. Unlike the undecayed `lfu` above, it
  forgets a text's old experts within some 100 tokens.
- **Room above LRU.** Belady's bound misses half as often as LRU: 27.6 against 57.3 per token
  on Gemma 4, and 59 against 110 on Qwen3.5. A policy that knew reuse better could find up to
  2x fewer misses, but the predictions below do not (section 5.4).
- **Predictions.**
  - They name 79-82% of a layer's experts one mixer ahead (`pre`), and 64-72% one layer ahead
    (`prev_r`).
  - Of the per-layer LRU's misses at the card's size, the prediction's 2k best hold 90-92%
    (`pre`) and 71-81% (`prev_r`).

## 4. Path (a): tokens per second

`cachesim.py --survey survey.json` replays each trace through an event model of path (a)
(`linksim`): the card computes everything, and the host moves the experts it lacks over PCIe.
Per token, and per MoE layer in order:

1. **The card runs the layer's mixer and router** (`d_pre` bytes of weights). It then posts its
   k expert ids: an ST to a mailbox in DRAM.
2. **The host sees the request `t_req` later.** It DMAs the missing experts one after another
   into LRU victim slots of that layer's cache. Each costs x / B_pcie + t_call. The link is one
   queue across layers.
3. **The card, meanwhile, computes what needs no missing expert:**
   - the part of the layer that needs no expert (`d_post`: Gemma 4's dense MLP, Qwen3.5's shared
     expert);
   - then the experts it has.
4. **It computes each missing expert as soon as that expert lands**, plus `t_done` for the
   directory write the host makes after the DMA and the card's `WAITW` seeing it (section 5.2).
   Each transfer's DRAM writes are charged to the card's time.
5. **After the last layer, the LM head.**

| Constant | Value | Source |
|:--|--:|:--|
| B_dram, card DRAM while decoding | 14.1 GB/s | measured (README) |
| B_pcie, host -> card | 1.3 GB/s (Gen1), 2.6 GB/s (Gen2) | measured / *estimate* x2 |
| t_call, per DMA call | 30 us | *estimate* (11-15 us measured per small call) |
| t_req, the card's ST to the host's first DMA | 30 us | *estimate*: the host polls the mailbox, one small c2h read |
| t_done, a DMA's end to the card's WAITW seeing its flag | 15 us | *estimate*: one small h2c write |
| B_ssd | 0.51 GB/s | measured |

The cache is the per-layer LRU at the card's size from the survey: 4 GiB less the on-card part
and 0.3 GB. It is warmed from the profile of the other texts, and all four texts are averaged.

| Model | card cache | all resident (bound) | Gen1, wait for the last | **Gen1** | **Gen2** | misses / token | link busy, Gen1 |
|:--|:--|--:|--:|--:|--:|--:|--:|
| LFM2.5-8B-A1B | 595 slots (85%) | 13.73 | 12.78 | **13.02** | **13.48** | 1.2 of 88 | 7% |
| gemma-4-26B-A4B | 744 slots (19%) | 5.88 | 3.38 | **3.86** | **5.00** | 57 of 240 | 54% |
| Qwen3.5-35B-A3B | 1307 slots (13%) | 7.75 | 3.69 | **4.15** | **5.77** | 110 of 320 | 60% |

(tok/s, *simulated*. "wait for the last": the card computes a layer's k experts only after its
last missing one lands.)

- **Nearly fits (LFM2.5-8B-A1B).** 85% of the experts stay on the card, and a token misses 1.2
  of its 88. Streaming them over Gen1 runs at 95% of the all-resident bound; offloading is close
  to free.
- **Three times the card (gemma-4-26B-A4B, 13.8 GB at fp4).**
  - A token misses 57 of its 240 experts: 180 MB, 138 ms of Gen1, against 170 ms of card time.
  - Waiting for each layer's last expert gives 3.38 tok/s. Computing the ones the card has while
    the others stream gives 3.86 (+14%). Gen2 gives 5.00 (+30%).
  - What is left is the link. It is 54% busy at Gen1 and in series with the card on every
    layer that misses.
- **Four times the card (Qwen3.5-35B-A3B, 18.9 GB at fp4).**
  - A token misses 110 of its 320 experts: 184 MB, 141 ms of Gen1, against 129 ms of card time.
  - Its experts are the smallest here (1.67 MB), so it misses more of them than Gemma 4 does,
    but each costs less.
  - It gets 4.15 tok/s at Gen1 (+12% from hits first) and 5.77 at Gen2 (+39%), against a
    bound of 7.75.
- **Latency does not matter.**
  - With t_req / t_done / t_call at 10 / 5 / 15 us: LFM2.5 13.03, Gemma 4 3.89.
  - At 100 / 50 / 30 us: 13.00 and 3.83.
  - The bytes are what count, so a card-side DMA engine that saves the host's reaction time
    (the XDMA descriptor bypass) is not worth building.
- **What limits Gemma 4 beyond the link is its int8 LM head:** 761 MB of the 2.4 GB a token
  reads (262,144 x 2816). An fp4 head would raise the bound from 5.9 to ~6.9 tok/s (*estimate*).

Other levers (same model, Gen1 / Gen2):

| Lever | LFM2.5-8B-A1B | gemma-4-26B-A4B |
|:--|--:|--:|
| path (a) as above: fp4 experts, card cache | 13.02 / 13.48 | 3.86 / 5.00 |
| int8 experts (8.25 bits: twice the bytes, half the slots) | 4.56 / 6.64 (306 slots; bound 9.33) | 1.68 / 2.75 (383 slots; bound 4.53) |
| smaller cache (more KV reserve) | 10.60 / 12.40 (450 slots); 7.48 / 10.34 (300) | 3.19 / 4.52 (500 slots) |
| best prefetch (section 5.4) | 12.90 / 13.45 (`pre`, k best) | 3.39 / 4.68 (`prev_r`, k best) |
| prefetch of the prediction's 2k best | 12.34 / 13.09 | 2.61 / 3.76 |

On Qwen3.5-35B-A3B the best prefetch (`pre`, k best) gives 3.89 / 5.78, against 4.15 / 5.77.

- **4-bit experts** are the largest lever after the cache itself. They halve the bytes per
  miss and double the slots in the same DRAM.
- **The cache size** matters most for the models that nearly fit. LFM2.5 loses 19% going from
  595 to 450 slots, so its KV reserve should stay small.

## 5. Design

### 5.1 Where things live

- **Card DRAM** (4 GiB):
  - **the resident part:** dense layers, shared experts, norms, the LM head, the KV cache and
    convolution / DeltaNet state, I/O, and programs;
  - **the expert cache:** fixed-size slots, one expert per slot, split per MoE layer (section
    5.5). Every part of an expert is contiguous in its slot, with the gate, up and down rows and
    their scale words at fixed offsets, so one base address names an expert. All experts of a
    model have one size, so the slots need no allocator;
  - **the directory:** one entry {slot address, present} per global expert id (the j-th MoE
    layer's expert e is j x E + e). The host writes it; the card reads it;
  - **a mailbox:** `seq`, the card's last request, and one row of its k ids; `served`, the last
    request the host has finished.
- **Host RAM:** the **expert pool**, every expert already in the card's slot format (fp4 rows
  and scale words), in 4 KiB-aligned buffers placed for fast DMA (`board.DMA_PLACE`,
  docs/host.md). The host also keeps its own copy of the directory and the LRU state. A miss is
  one DMA write, with no conversion. Every model in the table except Qwen3-Next-80B,
  Qwen3.5-122B and gpt-oss-120b fits in 26 GB at fp4.
- **SSD:** the pool as one file of slot-sized records, for models larger than host RAM
  (section 8).

### 5.2 Control: the card routes, the host serves

The card runs the whole reply as one run: autodecode's decode loop, in which the card samples
and feeds back each token. The MoE layers wait inside it. Per MoE layer, as built in phase 2
(`opentpu/llm/moe.py`, branch offload-p2):

1. **Route.**
   - The router MM gives E scores, with the model's rule on the VPU: LFM2 takes sigmoid plus
     the expert bias for the choice; Gemma 4 takes softmax.
   - A `LOOP` of k `ARGMAX` with knock-out (`RLD` of the position, a `FILL` of -3e38 there)
     gives the k ids in order and their scores; ties go to the first, as `np.argmax`.
   - The combine weights are the model's: renormalized and scaled. The global ids are the
     ids plus the layer's j x E (a word in the layer's block).
2. **Fence.** `WAITW served GE seq`, with `seq` the card's last request, read from the
   mailbox: the host has finished every earlier request. From here on, the host's only work on
   this layer's slots is the request about to be posted, which never evicts an expert it
   names. The fence is normally immediate: the host served the previous layer while the card
   computed it.
3. **Post.** The k ids to the mailbox's row, then `seq + 1` in a second `ST`, so the host never
   reads a torn request. The fence comes first, so one row is enough. `seq` is a float, and
   positive floats compare by their bits, so it works directly in `WAITW`'s GE compare. A
   float counts exactly up to 2^24 only: there `seq + 1` rounds back to `seq`, the post
   repeats the last request's number, the host sees no request, and every miss after waits
   out its WAITW (about 22 h of the 35B's decode, or 2.3 h of layer-major prefill, in one
   process). So between runs (`BoardBackend.start`), once `seq` has reached 2^23
   (`offload.SEQ_REBASE`), the host serves a request still unserved and sets the mailbox's
   `seq` and `served` back to 0 (`ExpertServer.rebase`, `RowServer.rebase`). The card reads
   both from DRAM at every post, so the programs do not change.
4. **Look up.** A `LOOP` over the ids: `RLD` of the entry's offset (id x 8, one `VOP` for
   all), `LD` of its present flag.
5. **Hits first.** A second `LOOP` over the ids with `LOOP R[present]` inside:
   - `WAITW NE 0` on the entry's address word copies the slot address to a TMEM word at once,
     and an `RLD` (RAW) puts it into a register;
   - the expert's MMs run at that register plus fixed offsets (`kernels.mlp.swiglu_down`);
   - its weighted output goes to its own row of a [k, H] tile.
6. **Misses.** A third `LOOP` with count 1 - present: the same code. There, `WAITW` waits until
   the host has written the entry after the expert's DMA, so each missing expert is computed
   as soon as it lands while the others still stream.
7. **Combine.** The k rows summed in the router's order, then added to the residual. The logits
   therefore do not depend on what the cache held.

A slot address never passes through the VPU, which would flush it as a denormal: `WAITW`
copies it from the directory to TMEM and `RLD` (RAW) takes its bits into the register. The MoE
block holds one register in all. The
resident decode's run arguments and the layer loops hold the others: LFM2.5-8B-A1B's generate
program had 2 of 15 left. It needs no index register: the per-expert values are the columns of
a small tile that each loop rotates by one, so expert i is always at column 0.

The host daemon (`opentpu/host/offload.py`, phase 2) only moves data:

1. It polls `seq` with a small c2h read.
2. It reads the k ids.
3. For each id missing from its directory copy, it:
   - picks the layer's LRU victim among the experts the request does not name;
   - writes {0, 0.0} to the victim's entry;
   - DMAs the expert into the slot;
   - writes {slot address, 1.0} to the entry.
4. It writes `served = seq`.

Hits need nothing from the host but its bookkeeping. The mailbox, directory and `served` are
ordinary DRAM words: the host reads and writes them the way `run_generate` already reads
tokens and writes the stop word during a run.

**Why it is race-free.** The only hazard would be the host evicting an expert the card is
using. Each layer has its own slots. Once the fence has passed, the only host work on a
layer's slots is the request the card then posts, which protects its own ids. The card uses a
layer's slots only between its fence and its next fence for that layer, a token later. With
S slices, only slice 0 would post, and every slice would run the same fence and waits.
Phase 2 runs one slice, as the board does.

**The instruction: `WAITW` (0x07), reserved by autodecode, run by the DMA.** Its fields follow
`LD`'s. It waits until `cmp(M32[R[ra] + w1] & w4, R[rc] + w3)` holds, then writes the word to
TMEM at `R[rb] + w2`, and an `RLD` (RAW) takes it into a register.

- Flags bits 1:0 choose the compare: 0 EQ, 1 NE, 2 GE. GE means the 32-bit difference is
  >= 0 as signed.
- `w5`: cycles between polls. The first read is immediate.
- `w6`: a timeout in cycles, 0 for none. On timeout the DMA stops the slice with an error the
  host sees, so a dead daemon cannot hang the card silently.
- It runs on the DMA unit (autodecode's form), polling through the DMA's DRAM read.
  - Its footprint is all of DRAM (read) plus the one TMEM word. Every younger instruction that
    reads or writes DRAM waits for it, and older stores (the mailbox's) land before it polls.
  - The sequencer needs nothing beyond RLD's hold.
- One requirement on the RTL: after `WAITW` sees a word the host wrote after a completed h2c
  DMA, every younger MM or LD reads that DMA's data. The host orders its data before its flag;
  the card orders its flag before its reads. The XDMA and the core meet in each channel's
  `otpu_mem_ch` and LiteDRAM, whose ordering must give this. team-lead has made this a gate of
  ld-memch's two-port work.
- In the ISA simulator, the host hook is called when every slice that can run is waiting: the
  simulated daemon, which copies experts and writes the directory. A `WAITW` that still does not
  hold is the timeout.

Everything else is built from instructions autodecode already added: `ARGMAX` (func 20), `RLD`,
`LOOP R[ra]` (predication), and `HALT CHAIN` when a program outgrows the 4096-instruction IMEM.

The hits-first split costs, per expert, an RLD of the entry's offset, an LD of its flag, an
RLD of the flag, one `WAITW` read and an RLD of the slot address: a few DRAM round trips per layer, ~0.2% of a token
(*estimate*).

**Not needed.**
- Halts per MoE layer. The first version of this study had one per MoE layer, 1.3-2.9 ms per
  token.
- Baking run-time values into immediates.
- A TOPK instruction: `ARGMAX` knock-out does it at k <= 8.
- The XDMA descriptor bypass (the card fetching by itself): latency does not matter
  (section 4), and the bypass would need a kernel driver pinning the pool.

### 5.3 Overlap

DMA into the card's DRAM runs while the card computes. The XDMA shares LiteDRAM's ports with
the core through `otpu_mem_ch`, and the streamed logits are already read during runs. On a
layer with misses, the card computes in this order while the link works:

1. the work that needs no expert (Gemma 4's dense MLP, Qwen3.5's shared expert);
2. its resident experts;
3. each missing expert as it lands.

On Gemma 4 that is +14% over waiting for the last expert, and on LFM2.5 +2% (it misses
rarely). The DMA's writes cost the card DRAM time, x / B_dram per expert, which the model
charges. That is 9% of the expert's transfer time at Gen1 and 18% at Gen2.

### 5.4 Prefetch: measured not to pay

The traces measure three early predictions of a layer's experts (section 3). In the model, a
prediction posts prefetches as a hint in the mailbox:

- it takes a slot at once (an LRU victim);
- it uses the link only when no demand transfer needs it (a demand preempts it at the next
  512 KiB chunk, each chunk one DMA call);
- its DRAM writes are charged to the card.

Every variant loses:
- with the k best: 1% on LFM2.5, and 12-14% on Gemma 4 at Gen1 (`pre` 3.34, `prev_r` 3.39,
  against 3.86);
- with the 2k best: 5-6% on LFM2.5 and 32-35% on Gemma 4.

The reasons, on Gemma 4 with `prev_r`, per token:
- 32 prefetches land, but 25 of them are evicted unused;
- the slots they take raise the demand misses from 57 to 66;
- the link goes from 54% to 84% busy.

The correct predictions are mostly experts the LRU already holds. The misses are the experts
that are hard to predict.

A perfect predictor would at most start each transfer one mixer earlier: Gemma 4's `d_pre` is
1.4 ms against 2.4 ms per expert over Gen1.

Prefetch does help when the card waits for a layer's last expert: +7% on Qwen3.5 at Gen2 (5.35
against 4.99). Computing the hits first already hides that time (5.77). The design therefore
carries no hints, and the ISA needs nothing for them.

With the slots replaced by decayed use (section 5.5), wrong guesses cost less: a prefetched
expert holds no use until a request names it, so the next miss replaces it first, not a used
expert. At 1.4 GB/s the k best of `pre` then pay on Qwen3.5-35B-A3B: 4.42 against 4.15 tok/s
at 1280 slots (10 of 23 prefetches a token wasted, against 33 of 49 under LRU). On Gemma 4
they break even (3.79 against 3.78; `prev_r` 3.86). Section 12 builds them for Qwen3.5-MoE:
the card runs each layer's router before its mixer and posts the hint.

### 5.5 Eviction

Per layer, warmed at load from a profile, with every resident weight pinned outside the cache
(dense, shared experts, norms, head). The victim is the cached expert, not in the request, of
least decayed use (`ExpertServer` policy "lfu", the default since card session 4, section
10.3):
- each use counts 2^(-age / 32), its age in requests of its layer;
- a warm expert counts one use at load;
- ties go to the least recently used.

The server keeps each expert's sum as log2 + t / 32, one update per use. It misses 9-15% less
than per-layer LRU (section 3), and on the card 2.4% less over the 35B's first 16 tokens (6.4%
over their second half).

- Undecayed LFU and static profiles lose to LRU, by 30-50 points on Gemma 4.
- Belady's bound (0.885 against 0.761 on Gemma 4) is the headroom, but predictions do not
  reach it (section 5.4).
- The per-layer split is within a point of a global LRU at the card's sizes. It is what makes
  eviction race-free without extra synchronization (section 5.2).

### 5.6 Prefill

A prefill chunk touches nearly every expert of every layer (the union of k picks over hundreds
of tokens). So it streams a layer's missing experts once per chunk, not per token.

- The card computes prefill at its MXU rate. Qwen3-0.6B 4-bit measures 103.4 tok/s: 2 x
  parameters x tok/s, about 124 G operations per second.
- For gemma-4-26B-A4B's 3.8 B active parameters that is ~16 tok/s (*estimate*). A 512-token
  chunk takes ~1 s per layer, against ~0.3 s to bring a whole layer's 128 experts (405 MB)
  over Gen1.
- Fetching layer l + 1 while layer l computes hides the transfer for chunks above ~150 tokens.

The card-side protocol covers this too: a prefill layer posts the union of its chunk's picks
and computes the resident ones first. Prefill stays compute-bound, as it is today.

### 5.7 Correctness and tests

Every model stays token-exact against the Hugging Face reference (greedy): first in the ISA
simulator, then the RTL, then the card. Offloading changes where an expert's bytes come from,
never which bytes, so the expert cache is invisible in the outputs.

The ISA simulator runs with a DRAM the size of the card's (4 GiB) and with the daemon as its
host hook. Tests:
- the logits are bit-identical to an all-resident run, on a model that fits, with a small cache
  that forces misses;
- the protocol's corner cases: all hits, all misses, a request naming an expert that another
  request's DMA is evicting, a lagging host (the fence), and the timeout.

The router runs on the card in every backend, so the three agree bit for bit. The one new risk
is routing near-ties. The card's router logits differ from bf16's, so the k-th and (k+1)-th
experts can swap where HF's would not. The check against HF will show whether greedy tokens
move, as the argmax can today.

### 5.8 What path (a) needs from autodecode

With the router on the card there is no tension left with autodecode: the card samples, feeds
back its tokens and waits for experts within one run. From autodecode's loop, path (a) needs:

1. `WAITW` in the ISA, the simulator (with the host hook) and the RTL, plus the ordering
   requirement above.
2. A host-side daemon beside `BoardBackend.run_generate`'s token reader. It shares the DMA
   device files, with one lock around each call. The token reader and the daemon are the only
   host work during a reply.
3. Room in the program. An MoE layer's expert part is three short loops. LFM2.5-8B-A1B's
   generate programs are 2577-3722 instructions of IMEM's 4096. If a model's decode step
   outgrows IMEM, it `CHAIN`s between parts, as autodecode's buckets already do.
4. Registers. The resident decode's run arguments (6 for LFM2.5: R10-R15) and the address
   registers of its layer loops leave 2-3 of R1-R15 free inside autodecode's loop. That is why
   the MoE block holds exactly one (section 5.2). A second MoE-sized feature in the same step
   would need registers back from the run arguments or the layer loops (autodecode's and
   models3's IMEM and loop work).
5. Nothing from sampling: the MoE is inside the decode step, which autodecode's loop runs
   unchanged.

### 5.9 The token's embedding row

In autodecode's loop the card feeds back its own token, so the next token's embedding row must
come from the card's DRAM. The resident decode keeps the whole table there in fp32 (vocab x H
x 4 bytes, `Image(lookup=True)`); the survey's "on-card part" (section 2) did not count it.

- **LFM2.5-8B-A1B:** 1.05 GB. With it, the 4 GiB hold 20 expert slots per layer (440 of 704,
  62%) instead of ~27. At 450 slots the model above gives 10.6 tok/s at Gen1, against 13.0 at
  595.
- **gemma-4-26B-A4B:** 262,144 x 2816 x 4 = 2.95 GB, which cannot fit beside its 1.64 GB
  on-card part.

**The fix: the card gathers the row from the tied int8 LM head.** Both models tie their
embedding to the head. An MM against a one-hot operand reads the token's row out of the head
the card already holds.
- It uses no extra DRAM and no host, and gets LFM2.5 back to ~27 slots per layer (~13 tok/s at
  Gen1, by the model above).
- The shared `kernels/gather.py` (main 77405e5) does this, and phase 2 uses it: LFM2.5-8B-A1B
  gets 28 slots per layer, and Qwen3.5-35B-A3B 32 instead of 9. The 35B's embedding is untied,
  so its rows come from an int8 table of 0.5 GB. The int8 embeddings of SmolLM3,
  Phi-4-mini and Qwen3.5-4B use it too.
- It is `Spec.embed` "int8" (main 2a04beb, `qwen3._embed`), which a MoE checkpoint's `from_hf`
  sets at any vocabulary size: beside a MoE's layers the DRAM is expert slots. The prompt's
  per-position programs and the resident decode then read every input from the image, so the
  host writes no embedding or RoPE row.

A host-written row fetched by `WAITW` (section 7) stays for rows that are not in the card at
all, such as E4B's per-layer embeddings. Phase 2's first 8B run kept the fp32 table (20 slots
per layer).

**An untied table on the host (`embed_host`).** A model whose int8 embedding table is its own
(untied, as Qwen3.5-35B-A3B's 0.5 GB) can keep it on the host instead, the way E4B keeps its
PLE records:
- The card holds a slot of the image's rows (one for a MoE engine), each row a record: its
  H int8 values, then its H / D scale words (the head's format), in whole MXU chunks
  (`qwen3.embed_record`), and a row mailbox (`RowLayout`).
- Before a run the host writes the run's rows into the slot (`Image.host_rows`, as for E4B).
  In the card's generate loop each sampled token is posted to the mailbox (`MB.post`), the
  host's `RowServer` writes its row into slot row 0 (one DMA call through the expert server's
  `BoardDram`, in order with its writes), and the next token's gather waits for `served`
  first (`MB.wait_served`, then `gather_row` of row 0). Data movement only: the host keeps
  the table as the card would hold it (`qwen3.embed_store`).
- The default: on for a MoE model with an int8 table of its own (its DRAM is expert slots),
  off for a dense one unless its image does not fit with the table (the Engine then retries
  with it on the host). A tied int8 head's rows stay the gather's. `Engine(embed_host=...)`
  and `moe_card --embed-table host|card` choose.
- Qwen3.5-35B-A3B at the board's 4 GiB: 34-35 slots a layer fit with the table on the card,
  42 (1680) with it on the host (cap 512-4096). The model of section 10.3 (decayed use, Gen1)
  gives 4.41 tok/s at 1560 slots and 4.45 at 1600, against 4.15 at the card runs' 1280
  (*projection*). On the card (sessions 5-7, section 10.4), 128 tokens: 3.86 against 3.60
  tok/s with the table on the card (+7.2%), 103 misses a decode token against 119. Its
  programs change (the gather's wait and the post); every other model's are the same (sha256:
  E2B, E4B, LFM2.5-8B-A1B, the tiny MoEs; the 35B with `embed_host=False`).
- Tests: tests/test_qwen35_moe.py (prefill, the generate loop and the resident steps bit for
  bit against the table on the card; the live fake card with both servers through one
  `BoardDram`), test_lfm2_moe.py (the generate loop), test_qwen3.py (a dense model moved to
  the host when its image does not fit, the same logits).

## 6. PCIe Gen2

| Model | tok/s, Gen1 -> Gen2 | link busy, Gen1 -> Gen2 |
|:--|--:|--:|
| LFM2.5-8B-A1B | 13.02 -> 13.48 (+3.5%) | 7% -> 4% |
| gemma-4-26B-A4B | 3.86 -> 5.00 (+30%) | 54% -> 35% |
| Qwen3.5-35B-A3B | 4.15 -> 5.77 (+39%) | 60% -> 43% |

(tok/s, *simulated* as in section 4, with Gen2 taken as twice the measured Gen1 rate.)

Gen2 x8 doubles the link: 5 GT/s, with XDMA's AXI side at 128 bits and 250 MHz instead of 125.
- It pays in proportion to the bytes that cross PCIe. For a model 3x the card it is the largest
  single lever left after 4-bit experts and hits-first overlap.
- It also halves a prefill chunk's per-layer expert stream (405 MB: 0.31 -> 0.16 s) and the
  image load (4 GiB: ~3.3 -> ~1.7 s).

The cost is a build that may not close:
- Everything in xdma_aclk goes from 125 to 250 MHz: otpu_axi_split2, the XDMA side of
  otpu_mem_ch, the LiteDRAM CSR crossing and the AXI-Lite SmartConnect.
- The earlier Gen2 attempt missed by ~0.1 ns in the IP's own placed paths (an 80 MHz build,
  docs/board.md section 5).

**Verdict: parked until phase 2 runs LFM2.5-8B-A1B end to end, then the first build for
models 3-4x the card.** LFM2.5 gains 3.5%, which does not justify a Vivado slot. Gemma 4 26B
gains 30% and Qwen3.5-35B 39%, which do once they are the target. The build to try then is a
timing-only FAST=1 CORE_MHZ=100 build with `pl_link_cap_max_link_speed {5.0_GT/s}` and
`axisten_freq {250}` in `bd_native.tcl`.

**Feasibility, 2026-10-01 (ld-memch, before any build).** The verdict's condition is met: the
35B runs end to end on the card and its token is link-bound (107 of 258 ms in PCIe writes at
1.455 GB/s).
- **The host takes 5 GT/s.** the card host's root port (00:01.0, Haswell's PEG x16) reads
  `max_link_speed` 8.0 GT/s and runs the card at x8, 2.5 GT/s. The card (01:00.0) advertises 2.5
  GT/s because the XDMA is built for Gen1. Device ID 7028 is already Xilinx's Gen2 x8 default.
- **What runs in xdma_aclk** (125 -> 250 MHz; XDMA's 7-series Gen2 x8 has a 128-bit AXI side at
  250 MHz, and the PCIe block's userclk1 goes from 250 to 500 MHz). Its worst path in the memeff
  build (f8c6c950) is +0.555 ns at 8 ns: our read data, from u_ch0's read FIFO through
  otpu_axi_split2 into XDMA's read buffer, 6.74 of 7.23 ns route (the channel's bridge sits by
  its DDR3 bank, XDMA by the PCIe block). XDMA's own worst are its reset fanouts (6.5 ns, 95%
  route), which a 4 ns constraint makes the tools replicate.

| part | plan |
|---|---|
| XDMA (DMA engine at 250 MHz; the PCIe block's userclk1 at 500 MHz) | a supported -2 configuration. The earlier attempt's misses were the IP's own block RAM paths at 500 MHz (~0.1 ns). Levers: a pblock for the IP by the PCIe block and its GTX quad, phys_opt on those cells, place / route directives |
| the DMA master's boundary (M_AXI_DMA) | register every channel at XDMA (an AXI register slice in the block design, fully registered) and put otpu_mem_ch's read data out of a register (it is the FIFO's asynchronous read today, through the split's mux), so no path crosses the die in one 4 ns cycle |
| otpu_axi_split2 | stays at 250 MHz (order FIFOs, valids from registers); out-of-context check, pipelined if it misses |
| otpu_mem_ch's XDMA side (x2) | the burst packing (16 -> 64-byte beats), B, the read return and the FIFOs' xclk ends at 250 MHz; out-of-context (tools/memch_ooc.tcl) at 4 ns. otpu_mem_ch.tcl's crossing constraints follow xclk's period |
| the LiteDRAM CSR crossing | moved out of xdma_aclk: M_AXI_MEMCAL on the SmartConnect's core_clk side, the core's ctl_clk = core_clk (the core crosses it into sys as now; no regeneration; BAR0 0x10000 unchanged). otpu_top_native.tcl's CSR max delays follow it |
| the AXI-Lite SmartConnect | only its slave side (XDMA's AXI-Lite master) stays at 250 MHz, all three masters on core_clk; Xilinx IP, it crosses the clocks itself |

- **The probe build** (step 2): FAST=1, CORE_MHZ=100, `pl_link_cap_max_link_speed {5.0_GT/s}`,
  `axisten_freq {250}`, xdma_aclk's FREQ_HZ 250 MHz. It reports WNS per clock (userclk1 at 500 MHz
  first) before any of the RTL above changes.

## 7. Gemma 4 E4B: the per-layer embeddings from the host

E4B is dense, and misses 4 GiB only by its PLE table (262,144 x 42 x 256 = 2.82 B parameters).
A token uses one row of it: 42 x 256 values, 21.5 KB in bf16 (43 KB in fp32).

- **Where it lives.** The host keeps the table: 5.6 GB in bf16 in RAM, or 1.5 / 2.8 GB in
  fp4 / int8, in the format the card reads. The rest of E4B (2.83 GB) fits on the card, with
  ~1.1 GB to spare for its KV cache.
- **How the card gets the row.** The card asks for it like an expert. After sampling a token it
  posts the token id to the mailbox. The host DMAs that row into a fixed buffer (one write of
  ~22-43 KB, ~30-40 us at Gen1) and bumps a flag.
- **Why it costs nothing.** The card's first use of the row `WAITW`s on the flag. It is used
  only when layer 0 combines its per-layer input, after that layer's attention and MLP, so the
  ~0.1 ms round trip hides behind layer 0's ~4.8 ms of weights (*estimate*).
- **The host's part is a table lookup, i.e. data movement.** The E4B decode stays at ~5.0 tok/s
  (2.83 GB streamed at 14.1 GB/s, all resident, fp4 with an int8 head; *estimate*).

## 8. The SSD tier

Three models in the survey are larger than the host's RAM at fp4:

- Qwen3-Next-80B-A3B (41 GB of experts);
- gpt-oss-120b (61 GB);
- Qwen3.5-122B-A10B (62 GB).

The host RAM then becomes the second cache level: an LRU over the pool, about 24 GB of it, fed
by the card's misses. The SSD holds the pool as one file of slot-sized records. A host miss is
on the token's path: an SSD read at 0.51 GB/s (3.3 ms for a 1.67 MB expert, 26 ms for
gpt-oss's 13.2 MB), then the DMA.

The model below is `cachesim.py --host-frac`: the host RAM limited to part of the pool, the
SSD a queue of its own ahead of the link, and the card as in section 4. Two models that fit in
host RAM stand in for the larger ones:

| Model | host RAM holds | SSD reads / token | Gen1 | Gen2 |
|:--|--:|--:|--:|--:|
| gemma-4-26B-A4B | the whole pool | 0 | 3.86 | 5.00 |
| gemma-4-26B-A4B | 50% | 6.9 | 3.50 | 4.31 |
| gemma-4-26B-A4B | 25% | 34.3 | 2.44 | 2.68 |
| Qwen3.5-35B-A3B | the whole pool | 0 | 4.15 | 5.77 |
| Qwen3.5-35B-A3B | 50% | 18.4 | 3.67 | 4.63 |
| Qwen3.5-35B-A3B | 25% | 63.5 | 2.67 | 2.95 |

(tok/s, *simulated*.) At 25% the SSD is the limit, and Gen2 barely helps.

The three larger models:

- **Qwen3-Next-80B-A3B** is the SSD tier's best case. It has Qwen3.5's layers and expert size
  (1.67 MB), 512 experts and top-10.
  - Its card caches 1452 slots (5.9% of the pool), and host RAM holds ~58%.
  - Qwen3.5-35B-A3B's traces at those two fractions give 3.18 tok/s at Gen1 and 4.49 at Gen2,
    with 158 card misses and 11.6 SSD reads per token.
  - Qwen3-Next asks 1.5x as many experts per token (480 against 320). Scaling the time beyond
    the resident bound by that, and taking Qwen3-Next's own bound (2.05 GB per token), gives
    **~2.4 tok/s at Gen1 and ~3.5 at Gen2** (*extrapolated*).
- **gpt-oss-120b and Qwen3.5-122B-A10B** are link-bound.
  - Their experts are 13.2 and 5.0 MB. Their card caches are 172 slots (3.7%) and 150 slots
    (1.2%). Qwen3.5-122B's on-card part leaves room for those 150 only if its embedding rows
    come from the host, like E4B's PLE (section 7).
  - At Gemma 4's and Qwen3.5's per-layer LRU hit rates for such small caches (0.2-0.45), a
    token sends 1.1-1.5 GB over the link: **under ~1 tok/s at Gen1, ~1.5-2 at Gen2**
    (*estimate*), before any SSD reads.
  - They need a card with more DRAM, not a better policy.

Prediction cannot hide an SSD read (3-26 ms) behind a layer (3-9 ms). A faster disk moves the
host-RAM-limited rows directly; an NVMe drive at 2.5 GB/s would make the 25% rows link-bound.

Details for the pool file:
- fp4 does not compress, so write the file with btrfs compression off (`chattr +m`).
  Compressed extents fall back to the page cache, so this keeps O_DIRECT reads direct.
- Requests of one expert (1.7-13 MB) are in the 4 MiB regime measured above.

## 9. Phase 2

The target is LFM2.5-8B-A1B end to end on the ISA simulator: the card's 4 GiB DRAM, the
router on the card, per-layer LRU expert slots and host DMA. It is built on autodecode's ISA
(ARGMAX, RLD, CHAIN), with no Vivado and no card time.

Status (branch offload-p2, on autodecode's branch): items 1-4 are built. On a tiny LFM2 MoE
with 2 slots per layer, the logits are bit-identical to an all-resident run, in prefill and in
the card's generate loop. The MoE block also runs on the RTL (autodecode's WAITW, the Verilator
board model through the host driver) with every expert resident, bit-identical to the ISA
simulator. A live daemon is not tested there: the board model runs a fixed script, with no host
during a run.

LFM2.5-8B-A1B on the ISA simulator with the card's 4 GiB (fp4 experts, int8 head, the card's
generate loop), against HF's bf16 greedy tokens (`tools/offload/moe_card.py`):

| run | slots per layer | tokens | against HF | hit rate | misses per decode token |
|---|---|---|---|---|---|
| fp32 embedding table | 20 of 32 | 16 | token-exact | 86% | 9.9 |
| gathered embedding (section 5.9) | 28 of 32 | 144 | the first 19 | 97.8% | 1.54 (2.11 in the second half) |
| the same, a longer answer ("Describe the water cycle ...") | 28 of 32 | 160 | the first 4 | 98.5% | 0.87 (0.67) |

- Both first different picks are fp4's, not the device's. At token 19 HF's bf16 logits tie four
  ways (within 0.25). At token 4 of the longer run HF ties 600 and 358 at 46.75, with 278 at
  44.05. The card ranks 278, 358 and 600 at 46.65, 46.35 and 46.12. `lfm2.emulated_logits`'
  float64 decode of the same fp4 weights, with none of the device's rounding, gives 46.74,
  46.32 and 46.17 (`tools/offload/emul_step.py`, the experts fake-quantized per use):
  quantizing the weights moves 278 up 2.7 logits, and the device's arithmetic adds nothing.
- The misses are out of 88 expert uses per token.
- On the card's own routes, cachesim's per-layer LRU at 28 slots gives 98.0% and 1.7 misses per
  token (the card: 97.8%, 1.9 over all 163 tokens). The card warms its slots with experts 0..27,
  cachesim from a profile.
- By section 4's model, those routes run at 12.7 tok/s at Gen1 (13.4 at Gen2). The resident
  bound is 13.7.

Qwen3.5-35B-A3B (item 5) has:
- the softmax rule and the shared expert (`MoESpec.rule`, `shared`);
- 16 key heads for 32 value heads (main 4ab54a4);
- 32 slots per layer with the gathered embedding.

Its generate program fits IMEM with the DeltaNet pair loop (docs/qwen35.md, group-major
DeltaNet blocks): 2,282 instructions in bucket 1. On the ISA simulator with the card's 4 GiB
(4,084 MiB image, 1,280 slots of 1.67 MB, a pool of 10,240 experts) its 16 tokens are HF's
exactly, every one picked by the card's generate loop. Of 11,840 expert requests 62.4% hit;
decode missed 95.7 experts per token (113.4 in its second half), against 111 predicted.
cachesim's per-layer LRU on the card's routes gives 64.7% and 113.1 misses per token (37
tokens), its optimum 80.5% and 62.3. That run wrote the prompt's first three embedding rows
from the host. Run again with `Spec.embed` "int8" (above), every input comes from the image:
the same 16 tokens, and the same requests, hits and misses, since the gathered rows are the
host's bit for bit.

1. **The MoE block in `ol` kernels:**
   - the router MM;
   - the selection (autodecode's `_select`), with LFM2's sigmoid + bias rule and its
     renormalized, scaled weights;
   - the expert FFN (SwiGLU) at a slot base register;
   - the combine in a fixed order.

   Also the slot layout, the directory, the mailbox and the fence, and the pool in the card's
   format (`quant` per expert).
2. **`WAITW` in the ISA simulator**, in autodecode's DMA-side form, with its host hook.
3. **The daemon** (`opentpu/host/offload.py`):
   - the pool in host RAM;
   - the directory copy and per-layer LRU;
   - DMA of misses into slots.

   The same code serves the simulator (through the hook) and the card: `BoardBackend.host`
   polls it while a run is in flight, in `wait` and in `run_generate`'s token loop, on the
   one host thread. A fake card that computes in a thread over the host's DRAM
   (`tests/test_lfm2_moe.py`) checks it: with 2 slots per layer, misses are served while the
   card waits, and the logits and tokens are the ISA simulator's bit for bit.
4. **Tests:**
   - bit-identical logits against an all-resident run, on a small MoE with a tiny cache;
   - the protocol's corner cases (section 5.7);
   - LFM2.5-8B-A1B token-exact against HF (greedy), with the card's 4 GiB DRAM.
5. **Then** Gemma 4 26B-A4B on the `gemma4` port's layers, and Qwen3.5-35B-A3B on Qwen3.5's.
6. **The card** (through team-lead), done (section 10):
   - `WAITW` in RTL (autodecode) and its ordering check;
   - the misses' DMA while the core runs;
   - tok/s against the model above.

## 10. On the card

The production bitstream (build B, 79c5707a, 133.33 MHz, DDR3-1066, WAITW and the generate
loop) ran path (a) on 2026-09-30. The host side ran on the card host, with no reload. The models were
LFM2.5-8B-A1B and Qwen3.5-35B-A3B, fp4 with an int8 head, and every token was picked by the
card's generate loop. The experts streamed from a packed pool file (each expert in the card's
slot format, packed once) into the per-layer LRU slots. The host only read the file and wrote
DRAM:

    python3 tools/offload/moe_card.py MODEL --check hf.json --cfg dev.pkl --pool pool.bin --card

The reference for each run is the ISA simulator's run with the bitstream's configuration (`--cfg`:
PAIR, DSTEP and STREAM on). The configuration changes the arithmetic: the 8B's 160-token run
with `isasim.board_config()` leaves these tokens at token 111. The card gave the simulator's
tokens, the same prefill logits (sha256) and the same misses per token:

| run | against the simulator | against HF | tok/s (wall / device) | hit rate | misses per decode token | MB streamed per decode token | host serving per token |
|---|---|---|---|---|---|---|---|
| 8B, 16 tokens, 28 slots | bit for bit | token-exact | 8.61 / 9.38 | 96.4% | 1.47 | 8.4 | 18.8 ms |
| 8B, 160 tokens ("Describe the water cycle ...") | bit for bit | the first 4 (fp4, section 9) | 10.03 / 10.10 | 98.5% | 0.89 (0.65 in the second half) | 5.2 | 10.1 ms |
| 35B-A3B, 16 tokens, 32 slots | bit for bit | token-exact | 2.02 / 2.04 | 62.4% | 95.9 (113.9) | 155 | 370 ms |

- The device rate is the token count over the run's cycles, which include the WAITW stalls on
  misses. Wall time is within 1% of device time: the host's polling loop costs nothing visible.
- The 8B decodes at 99 ms per token, of which the host's serving is about 10 ms. Section 4's
  model gives 12.7 tok/s on these routes; models3's dense runs measured about 13% under the bank
  model too.
- The 35B decodes at 490 ms per token, of which the serving is 370 ms: the run is streaming-bound.
  - The PCIe writes take 285 ms. 155 MB goes at 544 MB/s, against the 1.37 GB/s selftest
    bandwidth: each expert is one synchronous 1.67 MB write, then its 8-byte directory entry.
  - The pool reads take 89 ms (the 17 GB file, from the page cache and the disk).
  - Compute is the remaining 120 ms, so about 8 tok/s is the ceiling with the streaming
    hidden. At the selftest's write rate the writes alone would take about 115 ms per token.
- On the simulator, the last request of an 8B run (all hits) is posted but never served: the
  simulator's host hook runs only while a WAITW blocks. On the card the host serves it, so the
  card counts one more request (4 more hits).
- The checkpoints on the card's host are the routed experts' complement (1.4 GB for the 8B, 4.6
  GB for the 35B). The image build reads no expert; the pool file holds them.

The sessions' scripts are in tools/offload/sessions: `card_moe.sh` (the runs, each checked against
its references), `session5.sh` to `session8.sh` and `gen2.sh` (each session's runs, its tree in
its header), `reference.sh` and `hf_reference.sh` (the ISA simulator's and HF's references), with
the paths in `env.sh`. The host's files come from `tools/offload/strip_experts.py` (the
checkpoint without its experts) and `pack_pool.py` (the pool, packed in workers or streamed to
another host).

A pool file has a key, `<pool>.key` (`moe.pool_key`): the MXU's numerics (key 2,
`"numerics": quant.MX_NUMERICS`: the MX MXU, docs/mx_mxu.md), the quantizer's code (quant.py and
fp32.py), the experts' format, D, the layout (the pool's and the slot's) and the
checkpoint's config.json (strip_experts.py copies it as it is). `pack_pool.py init` and a run that
creates the pool write it; every run that opens the pool checks it (`moe.open_pool`), and so do
`pack` and `recv` (against the key that `send` puts first in its stream). A pool packed by another
quantizer, in another format of the same size (int4 against fp4) or from another checkpoint is
refused, with how to repack it, and so is every pool of the MXU before MX: a key 1 pool, or one
packed before keys (no key file). Their scale words are the former MXU's, so the experts are
repacked (MX image: a new pool); `pack_pool.py MODEL POOL stamp` gives a pool without a key the
key of MODEL and `--wformat` only once `sums` shows it holds this tree's bytes, and
`pack_pool.py MODEL POOL info` prints the key, or for a pool without one its format as its slot
size says (int8, or 4-bit: fp4 and int4 have the same size).

The first run found a bug. The Engine's compile worker process, which the card's backend
compiles ahead in, built its image without the MoE's `experts`: every expert resident, over
DRAM (4568 MiB for 4096). It failed at the first prefill step, before the card ran anything.
The worker now builds the image with the Engine's own keywords (`Engine._image_kw`), and
tests/test_lfm2_moe.py checks it. The ISA simulator compiles in-process and never ran into it.

### 10.1 The expert server's DMA at the link's rate

`Board.write`, which the server used through `BackendDram`, sends an expert to the card in
three steps:
- The bytes are copied out of the pool, and CHASH's swaps and the two channel runs copy them
  three more times. A numpy buffer sits 16 bytes past a page, so each channel run then bounces
  through the staging buffer for the DMA's alignment.
- Two DMA calls follow, synchronously.
- Each 8-byte directory entry and the `served` word is widened to 128 bytes, with a read of the
  card first.

On the build host's i5-12600KF, with the DMA dropped (`tools/offload/slot_bench.py --null`), that is
1.3 ms of host CPU per 1.67 MB expert. On the card's slower host, plus the DMA, the 35B paid
about 3 ms per miss. `BoardDram` (opentpu/host/offload.py, used on any transport that DMAs from
a worker thread, `dram_of`) does three things instead:
- It writes an expert's two channel runs in one pass, `np.take` of 64-byte beats with CHASH's
  swaps, from the pool's bytes into page-aligned staging buffers, then makes one DMA call per
  channel. No bounce.
- It keeps the host's own words in a shadow (`served` and the directory: the card only reads
  them) and writes them as whole 128-byte blocks, without a read.
- One worker thread makes every DMA call in order while the server stages the next expert, so
  an expert's data lands before its entry and every entry before `served`. `ExpertServer.poll`
  flushes before it returns.

tests/test_offload_server.py checks that the card's two channel memories end up byte for byte as
`Board.write` leaves them, with and without CHASH. tests/test_lfm2_moe.py runs the fake card that
computes beside the host with `BoardDram`.

The card ran it on 2026-09-30 (build B, the same references as section 10, all bit for bit):

| | before (`Board.write`) | `BoardDram` |
|---|---|---|
| `slot_bench`, 1.67 MB experts from RAM, 3 misses a request | 3.46 ms an expert, 483 MB/s | 1.74 ms, 958 MB/s (the DMA thread 1.40 GB/s) |
| `slot_bench`, 5.85 MB experts from RAM | 11.1 ms, 528 MB/s | 5.28 ms, 1109 MB/s (1.48 GB/s) |
| 35B-A3B, 16 tokens | 2.02 / 2.04 tok/s | 2.75 / 2.80 tok/s |
| 8B, 16 tokens | 8.61 / 9.38 tok/s | 9.34 / 10.04 tok/s |

The 35B's token took 357 ms. The host spent 242 ms of it answering requests, of which the DMA
thread wrote for 111 ms at 1.405 GB/s. The rest was staging, on the critical path because it was
slower than the DMA it fed: 1.69 ms an expert on the card's host (an i7-4790) against 1.19 ms
of DMA. Two things made it slow:
- The pool's pages: `np.take` read the pool file's memmap. A page not yet in the process's map
  costs a fault, and a page not in the page cache a read of the disk (about 115 MB/s on scattered
  reads), with the GIL held: the DMA thread waits too. `posix_fadvise` only asks for the read:
  nothing waits for it, or keeps the pages.
- The gather itself: about 1 ms for 1.67 MB on the i7-4790, from a cold source.

So now:
- The pool file has a split format (`opentpu.host.offload.split_order`). Each 4 KiB of an
  expert is stored as its two channel runs under CHASH, as they are when the block lands where
  the card's chunk index has even parity above its low 5 bits. Where that parity is odd, the
  two runs trade channels. `BoardDram` reads an expert with one `os.preadv` whose buffers are
  the 2 KiB pieces of its staging runs, in file order and routed by each block's parity. There
  is no gather, and the GIL is released for the copy. A slot that is not page-aligned, or a
  card without CHASH, takes the slot's bytes as before. `MO.serve` writes new pool files in
  this format (`<pool>.format`), and tools/offload/pool_split.py converts a file packed before.
- A thread reads every packed expert of the pool file once. This is the host's RAM tier in the
  page cache: for the 35B, 4333 experts, 7.2 GB. The Engine opens the pool (`moe.open_pool`)
  before it builds the image, so the read runs during the build (9 minutes for the 35B). The
  pages stay the kernel's to reclaim: nothing is pinned or locked, so other jobs on the host
  cannot run out of memory because of it. `moe_card` logs the packed experts' bytes in the page
  cache (mincore) when the pool opens, at load and at decode, and how much the thread had read.
- When no DMA is in flight (a request's first miss), `BoardDram` reads the expert in parts
  (`pieces`, 2 by default) and queues each part's DMA as soon as it is read, so the link starts
  after the first part. Each part costs one more DMA call per channel, about 50 us each (session
  2's two expert sizes: 1.67 MB at 1.395 GB/s and 5.85 MB at 1.484 GB/s fit 1.52 GB/s plus 50 us
  a call). A later miss's read overlaps the DMA ahead of it, so it goes whole.
- `BoardDram` keeps each slot's beat indices for the gather of the slot format, and writes the
  host's own words without `Board.write`'s general path.

On the card's host, with the DMA dropped (`slot_bench --null`, 1.67 MB experts, 3 misses a
request; another job's card session ran beside it):

| experts from | host ms per expert | of which staging |
|---|---|---|
| RAM, slot format, session 2's code | 1.38 | 1.00 |
| RAM, slot format | 1.16 | 1.01 |
| the pool file, slot format, in the page cache | 1.46 | 0.97, plus the read |
| the pool file, split format, in the page cache | 0.67 | 0.57 |

The 35B's projection. The DMA, at 1.19 ms an expert (session 2's 1.405 GB/s), is now the bound:
111 ms per token for its 93 misses. Each request's first staging (about 0.6 ms, about 40
requests a token) adds about 25 ms, and the entries and `served` about 5 ms. That is about 141
ms of serving per token instead of 242, so a token of about 256 ms: 3.9 tok/s, against 2.75
measured with session 2's code. The first staging in two parts exposes about 0.3 ms of it plus
two DMA calls (0.1 ms): about 7 ms a token less, so about 4.0 tok/s. The 8B, at 0.89 misses
per token, changes little.

tests/test_offload_server.py checks the split format: the order is a permutation (a short last
block included), and the records read back give the slot's bytes. `BoardDram` reading a
split-format file leaves the card's channel memories as `Board.write` does, at slots of either
page parity and off a page, with a request's first miss in 1 to 3 parts; a staging pair goes back
only after its last part (one pair, a slow link). `preadv` resumes a short read. The conversion
tool is covered too, and `PoolFile.resident` (on Linux: a file dropped from the cache, then
warmed).
tests/test_lfm2_moe.py runs the fake card with CHASH's map and a split-format pool file,
bit for bit against the ISA simulator.

### 10.2 Session 3: the split pool on the card

The card ran 4ae8dac on 2026-10-01, 02:37-02:50, on build B (79c5707a, reloaded after another
session's qualification run; the selftest passed before and after), against the same references:

| run | session 2 (`BoardDram`, slot-format pool) | session 3 (split pool, RAM tier, parts) |
|---|---|---|
| 35B-A3B, 16 tokens | 2.75 / 2.80 tok/s | **3.79 / 3.87** tok/s (+38%) |
| 8B, 160 tokens | 10.03 / 10.10 (session 1) | **10.64 / 10.71** (+6%) |

(wall / device). Both runs give the simulator's tokens and prefill logits bit for bit. The 35B
gives HF's 16 tokens; the 8B differs from HF at token 4, as before (fp4, section 9).

The 35B's decode token is 258 ms, and the host answers requests for 153 ms of it (242 in
session 2):
- 92 ms waiting for the DMA queue;
- 53 ms in the main thread: staging (0.53 ms an expert, overlapped but for each request's first
  part) and the directory;
- the rest, the mailbox reads and `served`.

The DMA thread wrote 107 ms of it, at 1.455 GB/s: the host is now bound by the link. Section
11.3's event model, with this host, predicted 3.94 tok/s.

The RAM tier: after the card host's reboot, 0.41 GB of the 35B's 7.24 GB of packed experts was
in the page cache when the pool opened. The warm thread had all of it in by the end of the image
build (552 s), and all of it was still resident at decode. The 8B's 4.12 GB went from 0 to all.

`slot_bench` on the card (3 misses a request, 1.67 MB experts):

| experts from | ms per expert | the DMA thread |
|---|---|---|
| RAM, slot format (the gather) | 1.72 | 1.44 GB/s |
| the split pool as found after the reboot (the disk) | 3.84 | 1.33 GB/s |
| the split pool warm, the first miss whole | 1.66 | 1.42 GB/s |
| the split pool warm, in 2 parts (the default) | 1.54 | 1.39 GB/s |
| the split pool warm, in 4 parts | 1.58 | 1.35 GB/s |
| the slot-format pool warm (preadv, then the gather) | 1.84 | 1.41 GB/s |

What is left:
- **Small DMA calls (host).** Each directory entry and `served` changes one 64-byte beat, but
  goes to the card as a whole 128-byte block: two DMA calls of about 50 us. One call each
  would save about 7 ms a token (*estimate*).
- **The misses themselves.** 93 a token at 1.19 ms each is 111 ms of link time. The next
  levers are a better replacement policy and more slots.

### 10.3 Session 4: one-beat writes and the decayed-use policy

The card ran 929cf9e on 2026-10-01, 04:12-04:31, on build B (79c5707a, as loaded; the selftest
passed before and after), against session 3's references. Both changes are host-only:
- each directory entry and `served` goes to the card as its one 64-byte beat, one DMA call on
  its channel, not as its 128-byte block in two calls;
- the slots' replacement by decayed use (section 5.5), run beside LRU.

| Qwen3.5-35B-A3B, 16 tokens | session 3 | session 4, LRU | session 4, decayed use |
|---|--:|--:|--:|
| tok/s (wall / device) | 3.79 / 3.87 | **3.90 / 3.98** | **3.95 / 4.04** |
| decode cycles | 551.5 M | 535.6 M | 528.7 M |
| misses a decode token (second half) | 95.9 (113.9) | 95.9 (113.9) | 93.5 (106.6) |
| the host's flush / DMA (s) | 1.47 / 1.71 | 1.28 / 1.76 | 1.34 / 1.75 |

All three give the simulator's tokens and prefill logits bit for bit, and HF's 16 tokens.

- The one-beat writes save 7.4 ms a token (the estimate was 7).
- Decayed use misses 2.4% less over the 16 decode tokens and 6.4% less over their second half;
  the traces' 2048 tokens give 9.6%. It misses more in the prompt (4508 against 4457 in all),
  before its counts build up.

`slot_bench` (1.67 MB experts, 3 misses a request): from RAM 1.61 ms an expert (1.72 in session
3), the split pool warm 1.47 ms (1.54).

The event model (section 11.3's, `--stream-policies lru,lfu`) for more slots on the 35B, tok/s
at 1.4 GB/s:

| Qwen3.5-35B-A3B | LRU | decayed use |
|:--|--:|--:|
| 1280 slots, int8 head (the card's) | 3.94 | 4.15 |
| 1440 slots | 4.08 | 4.30 |
| 1600 slots | 4.22 | 4.45 |
| fp4 head, 1280 slots | 4.24 | 4.48 |
| fp4 head, 1440 slots (the head's freed bytes) | 4.40 | 4.66 |

The fp4 head pays twice, as on Gemma 4: 254 MB fewer a token and some 150 more slots, but it
costs the 35B 2.4% perplexity. Hugging Face's final hidden states (bf16) over 900 tokens of
docs/isa.md's prose, through the head in float and in openTPU's formats (its input int8 per
block, as QACT):

| Qwen3.5-35B-A3B LM head | perplexity | KL(float, head) | top-1 as float's |
|:--|--:|--:|--:|
| float | 22.62 | 0 | 1 |
| int8 | 22.63 | 0.0003 | 0.990 |
| fp4 | 23.16 (+2.4%) | 0.018 | 0.889 |

The model has memorized the opening of Pride and Prejudice (perplexity 1.05 in every format),
so that text says nothing here. The head stays int8 by default; fp4 is an opt-in
(`head_format`), as on Gemma 4 E2B. With decayed use, Gemma 4 26B-A4B's rows in section 11.3
become 3.78 (fp4 experts, int8 head), 4.52 (fp4 head), 1.68 (int8 experts, int8 head) and
1.92 (int8 experts, fp4 head) tok/s.

### 10.4 Sessions 5-7: the embedding table on the host

Card sessions 5-7 (2026-10-01, production build B, Gen1): Qwen3.5-35B-A3B with its slots by
decayed use filling the DRAM, the whole pool (all 10240 experts) in the split format. Every
run gave the ISA simulator's tokens and prefill logits bit for bit (`q35ref16`).

- **The pool must be whole.** The card host's checkpoint has no experts, so a run that warms
  more slots, or hints, needs every expert in the pool. Session 4's pool held the 4333 its runs
  had used; it was filled from the full checkpoint (52 min, four workers on the build host).
- **The page cache.** The 17.1 GB pool does not stay whole in the host's page cache beside an
  11 GB `moe_card` process. A run right after the fill (12.3 GB resident) ran at 3.24 against
  4.11 tok/s warm. The card scripts now read the pool before each timed run and log its
  residency.
- **Noise.** At 16 tokens the same run gave 4.23 and 3.78 tok/s (the host's serving 0.64 s
  against 1.10 s). Session 7 ran 128 tokens, each run twice:

| 35B, 128 tokens | slots a layer | tok/s wall / device | misses a decode token (2nd half) | MB a decode token |
|:--|--:|--:|--:|--:|
| the table on the card | 34 | 3.59, 3.60 / 3.59, 3.60 | 119.3 (126.9) | 199 |
| the table on the host (5.9) | 42 | **3.84, 3.87 / 3.85, 3.88** | 102.7 (109.0) | 171 |

- The table on the host: **+7.2%** (3.86 against 3.60 tok/s), 14% fewer misses. The repeats
  agree within 1%. The four runs' 128 tokens are the same.
- 128 tokens run slower than 16 (103 misses a token against 79: the text moves on). The event
  model (section 10.3's, 1680 slots) gives 4.52: about 15% above the card at 128 tokens.
- The polls' reads: 25-27 us each with `BoardDram.read`'s beat read, against 90 us (12.6). The
  link ran at 1.41 GB/s while busy.

### 10.5 Session 9: the paired experts

moe-pair (main d29bfe9) runs the experts' 4-bit MMs paired, as the layers' own; before it every
expert ran at one block a cycle (its slot address, a register, failed the pairing's alignment
test). The co-simulation gave LFM2.5-8B +35-40% and the link-bound 35B and 26B +3-4%. Card
session 9 (2026-10-01, the production build after B, 72256074: B with xdma_rnum_rids 8, Gen1;
`tools/offload/sessions/session9.sh`, the first run of the repo's `card_moe.sh`) ran both trees
in one session, A B A B: A main 7d879e6 against its references, B d29bfe9 against the ISA
simulator's references remade at d29bfe9 (`reference.sh` on the build host). All 12 runs gave their
tree's tokens and prefill logits bit for bit.

| tok/s (two runs) | A, unpaired | B, paired | B / A |
|:--|:--|:--|:--|
| LFM2.5-8B-A1B, 160 tokens, 28 slots a layer | 10.65, 10.67 | 14.49, 14.53 | **+36.1%** |
| Qwen3.5-35B-A3B, 128 tokens, the table on the host | 3.40, 3.35 | 2.78, 2.21 | (the host's) |
| gemma-4-26B-A4B, 128 tokens | 2.69, 2.66 | 2.40, 2.37 | (other tokens) |

- LFM2.5-8B decodes from its slots (0.9 misses a token): its cycles a run fell from 1.98e9 to
  1.46e9, the co-simulation's gain.
- The 35B's two trees missed the same experts (102.7 a token) and moved them at the same rate
  (DMA 16.0-16.3 s, 1.34-1.37 GB/s), but B's staging (the main thread's reads of the pool into
  the staging buffers, and its waits for a free pair) took 20.2 and 32.3 s against A's 10.5 and
  11.4, with as much of the pool in the page cache at decode (12.7-16.1 of 17.1 GB) and the same
  host code: the host's, and it hides the projected 3-4% (below). moe_card now records where
  staging goes (10.6).
- The 26B's paired sums changed its tokens (B's equal HF's greedy, as its new reference; A's
  part from it at token 5, a tie): B's text asks for 88.1 experts a token against 68.6, so its
  rate is not comparable.
- The build's H2C ran at 1.34-1.40 GB/s during the runs, against B's 1.41-1.42: the 8 read IDs'
  cost ld-memch measured.

The card's own share. `decode_cycles` includes the WAITW stalls, and no counter separates them.
moe_card's `poll` time is each served request's window, from the read that saw it to served
flushed, so the card's time outside the windows (`decode_cycles` over the clock, less `poll`) is
what moe-pair changes on the wall at a fixed host. It does not follow the host's speed: B's two
35B runs' windows differ by 11.7 s, their time outside by 0.05 s.

| ms a token outside the host's windows | A | B | B - A |
|:--|:--|:--|:--|
| LFM2.5-8B-A1B (0.9 misses a token) | 85.0, 84.5 | 60.0, 60.3 | -24.6 (-29.0%) |
| Qwen3.5-35B-A3B | 101.5, 101.1 | 95.9, 96.2 | -5.3 (-5.3%) |
| gemma-4-26B-A4B (other tokens; the same work a token) | 134.7, 134.3 | 120.5, 120.6 | -14.0 (-10.4%) |

- moe-pair helps the card on all three and hurts none. The 8B is the co-simulation's per-expert
  gain on the card: 88 experts a token at 0.65 -> 0.36 ms is 25.5 ms, against 24.6.
- On the link-bound two the experts' gain is mostly hidden. moe_ffn posts the request, runs
  `beside()`, computes the experts it has, then each missing one as its directory entry lands
  (each waits on its own entry, not on served). So under the streaming only the last landed
  expert's compute (a layer that misses) or all k (a layer that misses none) is outside the
  host's window. On the router traces (lfu_layer at the card's slots) the 35B has 5.5-9.4 layers
  a token that miss nothing at 74-93 misses a token, which gives 7.0-9.5 ms (5.3 measured at
  102.7 misses: fewer such layers); the 26B 2.7-5.7, 8.5-12 ms (14.0; its hits partly outside
  the window too: `beside()` plus 7 x 0.38 ms against its first miss's 3.4 ms).
- At A's host that is 1.8% of the 35B's decode and 3.7% of the 26B's.

### 10.6 Where the host's staging goes

After session 9's 35B (the same misses and DMA, staging 10.5 -> 20-32 s), moe_card records:
- `host_decode_s.reads`: the decode's pool reads by where they came from, `cached` (every page in
  the page cache just before the read: mincore) or `disk`, each [reads, seconds, bytes, bytes
  not in the cache] (`PoolFile.io`);
- `host_decode_s.stage_wait`: staging's waits for a free staging pair, the DMA thread's
  (`BoardDram.wait_s`); the rest of `stage` is the reads and the copies;
- `pool_warm.at_end`: the pool's bytes in the page cache after the decode, beside `at_decode`;
- `host_mem` at decode and at its end: the process's and its children's (the compile workers)
  resident and swapped GB (`rss_file`: the process's mapped files, page cache it may lose), and
  the host's available, page cache, anonymous and swap used;
- `device_counters`: the free-running counters' change over the decode (SNAP; MXU_BUSY, DMA_BUSY
  with the WAITW stalls, DRAM_RD / WR, INSTR, ...);
- `misses_per_request_decode`: each request's misses (a token's layers in order).

What the 35B needs (cachesim, the decode's misses under lfu_layer at the card's 1680 slots
replayed against a host cache over the pool; four 2048-token router traces, 128-token windows,
85 misses a token): disk reads a token by the pool's GB in the page cache:

| pool GB in RAM | LRU (the page cache) | admit the profile's 5000 / 7000 best only (O_DIRECT the rest) | the profile's best pinned (O_DIRECT the rest) | Belady |
|:--|:--|:--|:--|:--|
| 8 | 18.5 | 32.4 / 20.6 | 33.9 | 6.2 |
| 10 | 9.7 | 32.4 / 16.0 | 22.2 | 3.6 |
| 12 | 4.5 | 32.4 / 15.5 | 13.2 | 2.2 |
| 14 | 2.2 | 32.4 / 15.5 | 6.9 | 1.8 |

- The page cache's own LRU beats keeping cold experts out of it and pinning a hot set at every
  size; other slot policies miss more (lru_layer 95 a token, a global LFU 175). The 26B's 13.2 GB
  pool needs about 8 GB (1.9 disk reads a token; 0.4 at 10).
- the card host's SSD (a SATA BX500, btrfs on dm-crypt) reads an expert dropped from the page cache in
  4.2 ms one at a time (400 MB/s), 3.4-3.6 ms with a request's misses queued at once
  (POSIX_FADV_WILLNEED, threads, or O_DIRECT in threads): about 3.8 ms more than a cached read.
- With no disk read a token takes the card's 101 ms outside the windows plus 144 ms of windows
  (session 5's traces: 0.12-0.26 ms a request plus 1.27-1.36 ms a miss, the link's 1.24 ms): 4.08
  tok/s; by pool GB in RAM 14 -> 3.95, 12 -> 3.82, 10 -> 3.55, 8 -> 3.17.

So the lever is RAM for the pool. moe_card's `--release-weights` gives the checkpoint's pages back
after the build (`LazyWeights.release`: safe_open maps each file whole, and the pages the build
read stay mapped, held over the pool's; the 35B's stripped checkpoint is 4.9 GB, the 26B's 4.5;
a tensor read after reopens its file). On Linux a 537 MB checkpoint read whole held 526 MB of
RssFile and its pages; after release() neither. `--willneed` queues a request's misses' reads at
once (`ExpertServer.ahead`, `PoolFile.willneed`).

Card session 10 (2026-10-01, build 72256074, `tools/offload/sessions/session10.sh`; main d29bfe9's
programs with this host code, against session 9's references: every run's tokens and prefill
sha the simulator's) measured both, the 35B at 128 tokens with the same 102.85 misses a token in
every run:

| run | other checkpoints in the page cache | release | willneed | tok/s | disk reads (s) | staging s | windows s | pool GB cached at decode |
|:--|:--|:--|:--|:--|:--|:--|:--|:--|
| s10 t | 13.6 GB (the session before's) | | | 2.20 | 3261 (26.4) | 33.7 | 45.9 | 9.35 |
| s10 r | 13.6 GB | yes | | 3.05 | 1664 (9.4) | 17.0 | 29.6 | 9.64 |
| s10 rw | 13.6 GB | yes | yes | 3.50 | 1248 (2.5) | 10.4 | 24.2 | 12.70 |
| s10b t | dropped | | | 3.67 | 226 (1.0) | 8.8 | 22.4 | 16.50 |
| s10b r | dropped | yes | | **3.79** | 0 | 7.7 | 21.3 | 16.05 |

- The process is not what crowds the pool: 1.3 GB anonymous, its compile workers 0.1 GB (13.3 GB
  at its peak, the image build). The page cache held the checkpoints a session before had
  mmapped (Qwen3.5 0.8B / 2B / 4B, 13.6 GB) and the run's own (4.74 GB of RssFile): with MGLRU
  (the card host: on) once-mapped pages outlive the pool's read() pages. `fincore` shows them.
- So the Engine releases the checkpoint itself once the image is written when its experts
  stream from a pool file (`Engine(release_weights=True)`, the default; a LazyWeights read
  after reopens its file), moe_card queues a request's disk reads by default (`--keep-weights`,
  `--no-willneed` for the old way), and card_moe.sh drops every other file of 100 MB or more
  under ~/openTPU/models and the session directory before each run (`DROPOTHER`, "" for none;
  DONTNEED only, the next session's loads read them from the SSD; a link out of ~/openTPU and
  ~/otpu-build is skipped and logged, never opened).
- The card's side did not change: MXU_BUSY 2.13e9 cycles in every run, RUNNING - DMA_BUSY 1.76e9;
  only WAITW's share moved. Each request's window (`--hint-trace`): 0.6 ms + 1.57 ms a miss with
  the pool cached (rw), 1.57 + 2.85 with the disk (t, its 99th percentile 108 ms).
- 3.79 against the model's 4.08: the build's link (1.33 GB/s, not 1.40) and the windows' 21.3 s
  against the DMA thread's 16.4 s, each request's first expert staged before the link starts.
- The 26B (2.42, 2.39 with release) read nothing from the disk: its 13.2 GB pool fits. Its
  staging (21.4 s for 11,276 experts) is half in the copy path: an expert of 3,446,784 bytes is
  841.5 RUN blocks, so every other slot is not 4 KiB aligned and BoardDram reads it whole and
  reorders it (`direct` 5618), about 2.85 ms more an expert. So `Layout.build` now spaces the
  slots by whole RUN blocks (`Layout.pitch`: the 26B's 3,448,832, 1.1 MB more for its 540 slots,
  still 18 a layer in its 4052 MiB image; the 35B's and LFM2.5-8B's slots are whole blocks
  already) and every expert reads into its runs. The slot addresses are the directory's, so no
  program changes (program_sha.py: main's hashes under both configurations). Card session 11
  (2026-10-01, `tools/offload/sessions/session12.sh`'s first part, d29bfe9's programs, g26r
  twice, bit for bit): 2.65 and 2.69 tok/s against 2.39 and 2.42, every expert read in place
  (`direct` 11,310), staging 21.6 -> 12.3-12.8 s, the windows 38 -> 32 s against the DMA
  thread's 27.2 (2.8 was expected: the rest is each request's own cost, as the 35B's).

### 10.7 The pool under MGLRU

Session 10's 35B lost its pool's page cache to checkpoints that had been mapped once: the run's
own (LazyWeights' safe_open maps) and a session before's. With MGLRU (Linux's multi-generational
LRU: the card host's 7.2.5 and the build host's 7.1.4 kernels, `/sys/kernel/mm/lru_gen/enabled` 0x0007) a file
page some process mapped and touched outlives one read only through read(). The Engine now
releases its own checkpoint (10.6) and card sessions drop the others (DROPOTHER), but a user's
host has files a session cannot evict: other models, other applications.

The host test (the build host: a 1.9 GB memory cgroup, `systemd-run --user --scope -p MemoryMax`; a
1.0 GB "checkpoint" a child process mapped, touched and left; a 1.5 GB pool warmed, then read 3000
times in 1.67 MB records of zipf popularity), with PoolFile itself for the first and third rows:

| the pool read by | disk reads | pool resident (of 1.50 GB) | checkpoint resident (of 1.0) |
|:--|:--|:--|:--|
| read() (PoolFile before) | 11.0-16.5% | 0.96-1.13 | 0.82-1.00 |
| read() + POSIX_FADV_WILLNEED | 11.2% | 0.97 | 1.00 |
| read(), each read touched through a map (PoolFile now) | 0 | 1.50 | 0.45 |
| memcpy from a map (+ MADV_WILLNEED: the same) | 0 | 1.50 | 0.46 |
| read(), the run's own checkpoint still mapped | 10.9% | 0.96 | 1.00 |
| read() + touch, the run's own checkpoint still mapped | 4.6% | 1.40 | 0.56 |

So PoolFile (`mapped`, the default; `Engine(pool_map=False)`, moe_card `--no-pool-map` for
read() alone) keeps a read-only map of the pool (PROT_READ: its view is not writeable, nothing
writes through it) and touches every expert it reads or warms through it, a byte a page, after
the preadv (which keeps the reads' size and their GIL release). The pool's pages then compete
as mapped ones and the dead checkpoint goes first. Costs:
- the page tables of the pool's touched pages, 8 bytes per 4 KiB: about 33 MB for the 35B's
  17.1 GB pool (2 MB per GB);
- the touch, measured on the build host for an expert of 1.67 MB already in the page cache: 44 us the
  first time (fault-around maps 16 pages a fault: about 26 minor faults), 7.9 us after, against
  214 us for its cached preadv. The warm thread pays the first touches (0.45 s for the 35B's
  10,240 experts, off the critical path); a decode token's 102.7 misses pay about 0.8 ms;
- the pool counts in the process's `rss_file` (page cache, as before).

Not tried: MADV_HUGEPAGE (file-backed huge pages need READ_ONLY_THP_FOR_FS and khugepaged; the
touch already gives the standing). It does not change what the pool needs (about 14 GB of RAM
for the 35B, 10.6) or the SSD's 4.2 ms an expert.

The card's check, session 12 (2026-10-01, `tools/offload/sessions/session12.sh`, d29bfe9's
programs, every run bit for bit): card_moe.sh `HOG=dir:dir` mapped and touched the Qwen3.5
0.8B / 2B / 4B checkpoints (15.6 GB) from another process before each run, with DROPOTHER="",
then q35e128r (the checkpoint released) with the pool read through read() (A, the tree before
this change) or touched through its map (B), A B A B:

| run | the pool | tok/s | disk reads (s) | staging s | windows s | pool GB cached at decode, end |
|:--|:--|:--|:--|:--|:--|:--|
| A1 | read() | 2.67 | 2387 (15.5) | 23.0 | 35.5 | 8.9, 13.4 |
| B1 | mapped | **3.71** | 173 (0.4) | 8.6 | 22.1 | 16.7, 16.8 |
| A2 | read() | 3.08 | 1077 (8.2) | 16.0 | 29.1 | 15.6, 16.7 |
| B2 | mapped | **3.76** | 2 (0.0) | 8.2 | 21.5 | 17.1, 17.1 |

The mapped pool held its page cache against the other process's checkpoints: 3.71 and 3.76 tok/s
against session 10's 3.79 with them dropped (10.6), where read() lost 19-30%. B's `rss_file` at
decode was 16.2-16.7 GB: the pool, mapped (page cache, not the process's own memory).

### 10.8 Each request's own cost

After 10.6 and 10.7 the decode's windows still run about 5 s over the DMA thread's time per 128
tokens on both models: the 35B's 21.5 s against 16.6 (session 12's B2), the 26B's 32.0 against
27.2 (session 11). That is why the 26B made 2.69 tok/s and not the 2.8 that 10.6 expected. The
per-request traces (`--hint-trace`; session 12's B2: 5120 requests, 13,113 misses) fit 0.27 ms
+ 1.50 ms per miss, against 1.26 ms per miss of DMA. The excess is about 0.14 ms per request
with no miss, 0.4 ms more for a request's first miss, and 0.2 ms for each miss after it.

The card can't tell where that goes, so `tools/offload/serve_emu.py` runs the host side alone on the
card's host. It drives the real ExpertServer, BoardDram, PoolFile and XdmaTransport code,
replacing the XDMA calls with waits of the card's costs: 20 us per call plus the bytes at 1.365
GB/s for a write, and 22 us for a beat read. It replays a session's requests (layer, misses, the
device's gap), reads the real pool file, and logs every DMA call. On the card host it fits 0.30-0.33 ms
+ 1.65 ms per miss, close to the card's fit, so its breakdown is used below. The 35B, per
request with misses (1296 of 1500):

| | before | now |
|:--|:--|:--|
| post -> seen (poll loop period / 2 + its read) | 82 us | 26 us |
| seen -> the link's first expert DMA (row read, serve's Python, the first part's read) | 500 us | 330 us |
| link idle between calls, per miss (Python, the GIL, flock) | 160 us | 115 us on the critical path |
| victims' entry clears (a 64-byte call each, plus its gap) | before each expert | after the last entry |
| device-side stall, post -> last entry landed (mean over all 1500 requests) | 4.01 ms | 3.60 ms |

Four host-side changes:
- `preadv_iov`: BoardDram reads a split expert through libc's preadv on an iovec array
  (addresses, lengths) instead of os.preadv on a list of buffers. os.preadv holds the GIL while
  it gets each buffer (816 per 35B expert, 1684 per 26B expert; about 170 us per expert on
  the card host's i7-4790), and the DMA thread waits for that GIL between its calls. Records get
  `readiov` from `PoolFile.get`, and a hint's part keeps it.
- `BoardDram.lead` (0.2): a request's first miss is sent in a fifth plus the rest, not two
  halves. The link starts after 334 KB is read (35B), not 835 KB. Reading runs at about 4.5x the
  link, so the second part is read before the first one's DMA ends.
- The victims' entries are cleared at the end of the request, after its last new entry and
  before served (`ExpertServer._clear`). The card reads only the entries of the ids it posts,
  so a victim's entry is read only in a later request, after served. The link no longer spends
  a 64-byte call, about 70 us with its gap, before each miss.
- The poll loop spins (`XdmaTransport.host_idle` 0; other transports keep HOST_IDLE's 50 us).
  Each poll's seq read is a DMA call of about 30 us, and that read paces the loop. The 50 us
  sleep slept about 110 us on the card's host, making the loop period about 140 us. With a
  host hook, run_generate reads out[] at most every ms (`HOST_TAKE`); its two DMA calls would
  double the period.

moe_card `--legacy-serve` restores all four for an A/B (halves, buffer lists, each clear
first, the sleep, out[] every poll).

The emulator compares legacy against now, three runs each of 1500 requests (35B: session 12's
trace; 26B: session 11's misses at a 1.5 ms gap). Device stall is post -> last entry landed;
window is seen -> poll returns:

| model | device stall, legacy | now | window, legacy | now |
|:--|:--|:--|:--|:--|
| 35B | 6.01-6.07 s | 5.39-5.42 | 6.03-6.09 | 5.67-5.74 |
| 26B | 13.08-13.26 | 12.14-12.17 | 13.08-13.25 | 12.52-12.53 |

That is -0.42 ms per request on the 35B and -0.63 on the 26B. The emulator's link is about 10%
slower per miss than the card's, so scaled by 0.85 the prediction is:
- 35B: -1.9 s per 128 tokens, 3.76 -> about 4.0 tok/s.
- 26B: -2.0 s, 2.69 -> about 2.8 tok/s.

Card session 13 (2026-10-01, `tools/offload/sessions/session13.sh`, d29bfe9's programs on the
production build): one tree, `--legacy-serve` (L) against this serving (N), with `--hint-trace`
and the DMA calls. Every run matched the simulator bit for bit (tokens and prefill sha):

| run | serving | tok/s (device) | decode Gcycles | windows s | window fit (ms) | seen -> first expert DMA, median | link idle before data calls | DMA_BUSY G | MXU_STARVE G |
|:--|:--|:--|:--|:--|:--|:--|:--|:--|:--|
| 35B L1 | legacy | 3.74 (3.75) | 4.546 | 21.19 | 0.34 + 1.48 / miss | 449 us | 1.16 s | 2.777 | 0.077 |
| 35B N1 | now | **4.01** (4.02) | 4.241 | 20.23 | 0.33 + 1.41 | 273 us | 0.11 s | 2.416 | 0.105 |
| 35B L2 | legacy | 3.75 (3.76) | 4.544 | 21.15 | 0.30 + 1.50 | 462 us | 0.95 s | 2.774 | 0.078 |
| 35B N2 | now | **4.04** (4.05) | 4.217 | 20.02 | 0.34 + 1.39 | 269 us | 0.11 s | 2.386 | 0.108 |
| 26B L | legacy | 2.62 (2.63) | 6.497 | 33.10 | 0.54 + 2.75 | 716 us | 1.27 s | 2.804 | 0.212 |
| 26B N | now | **2.78** (2.78) | 6.138 | 31.34 | 0.52 + 2.60 | 316 us | 0.10 s | 2.256 | 0.284 |

- That is +7.2% on the 35B (predicted ~4.0) and +6.1% on the 26B (predicted ~2.8). Decode cycles
  fell 6.9% and 5.5%; DMA_BUSY (with the WAITW stalls) fell 0.38 G and 0.55 G cycles.
- The DMA calls show where it came from: the link's idle time before its data calls fell from
  ~1 s to 0.1 s per 128 tokens, and a request's first expert DMA starts 270-320 us after its
  request is seen instead of 450-720.
- Not all of the windows' gain reached the device. MXU_STARVE rose by 0.03 G cycles (35B) and
  0.07 G (26B), and RUNNING - DMA_BUSY by 0.06 G and 0.19 G (1.4 s on the 26B). That is either
  the spinning poll's card reads (98k -> 346k on the 35B, 64k -> 456k on the 26B, one every
  ~33 us outside the windows) competing with the MXU's weight reads, or the earlier expert DMA
  overlapping the hits' compute. To tell them apart, the next A/B is the poll's sleep alone.
- The 64-byte calls (entries, clears, served) take 49-68 us each on the card, not 20: 31,346
  of them per 128 tokens of the 35B, 1.8-2.1 s. Each miss still has its entry call on the
  critical path.

What remains of the excess is the link's own cost. Each expert takes two calls (one per
channel) plus its entry's 64-byte call, about 60 us with their gaps. On top of that come the
row read and served, plus the first part's read. Only a faster link (PCIe Gen2, on hold) or
fewer calls on the card's side (an expert's present flag in its slot, a program change) would
remove these.

### 10.9 PCIe Gen2 x8: the prediction

The Gen2 build (g2fix 0885d436, production since 2026-10-02 00:03) moves 2.29 GB/s host->card in
the selftest, against 1.35 on Gen1: 1.70x. Session 13's DMA calls give the Gen1 link as offload
uses it during a run:
- an expert's whole record (two calls, one per channel): 1183 us for the 35B's 1.67 MB (a fit of
  ~132 us fixed + 1.59 GB/s), 2360 us for the 26B's 3.45 MB;
- a request's first miss: 371 + 972 us (35B), 604 + 2032 us (26B);
- a 64-byte call (entry, clear, served): 49 us (35B), 61 us (26B).

Two bounds for Gen2: (a) only the bytes go 1.70x faster, and each call keeps its fixed cost
(`serve_emu.py --h2c-call 66e-6 --h2c-bps 2.70e9`); (b) the whole call goes 1.70x faster
(`--h2c-call 39e-6`). Either way the 64-byte calls stay 49-61 us (latency).

`serve_emu.py` replayed session 13's own traces (N2, gN1) with the Gen1 link calibrated to the
card's calls (`--h2c-call 66e-6 --h2c-bps 1.59e9 --beat-call 49e-6`; the 26B's 1.547e9 and 61e-6;
two runs each). Device stall is crit + detect:

| model | Gen1 (calibrated) | Gen2 (a) | Gen2 (b) | change |
|:--|:--|:--|:--|:--|
| 35B | 20.63-20.70 s | 14.58-14.59 | 13.85-13.92 | -29.5 to -32.8% |
| 26B | 31.30-31.48 s | 20.93-21.11 | 20.36-20.40 | -33 to -35% |

The emulator runs 5-11% slower than the card on Gen1 (its windows 22.3 against the card's 20.0;
33.1 against 31.3), so its relative change is applied to the card's windows. Session 13's N2 /
gN1 at 4.05 / 2.78 device tok/s then go to:
- 35B: -5.7 to -6.3 s per 128 tokens, about **5.0 tok/s** (4.9-5.1, +23-26%). The per-record
  arithmetic alone (102.85 misses a token, 36.6 of them a request's first) gives -45 to -52 ms a
  token: 4.95-5.13.
- 26B: -10.1 to -10.8 s, about **3.6 tok/s** (3.56-3.63, +28-31%). Per record: -78 to -89 ms a
  token: 3.55-3.69.

Below that, look at MXU_STARVE first. Session 13 already showed the expert DMA overlapping the
MXU's weight reads (10.8), and at 1.7x the writes take more of the DRAM.

What the 35B's pool in RAM costs at each rate: cachesim's disk reads per token (10.6), scaled to
the card's 102.85 misses per token (x1.21), each 3.8 ms on the critical path:

| pool GB in RAM | disk reads / token | Gen1 tok/s | Gen2 tok/s |
|:--|:--|:--|:--|
| 17.1 (all) | 0 | 4.05 | 5.0 |
| 14 | 2.7 | 3.89 | 4.76 |
| 12 | 5.4 | 3.73 | 4.53 |
| 10 | 11.7 | 3.43 | 4.09 |
| 8 | 22.4 | 3.01 | 3.51 |

At Gen2 the SSD costs relatively more: 8 GB of RAM loses 30% there, against 26% on Gen1. The 26B's
13.2 GB pool fits. With 8 GB of it in RAM (1.9 disk reads a token) it would make about 3.5 tok/s
on Gen2.

The check on the card is q35e128s and g26s (the default serving, `--hint-trace` with the DMA
calls), from session 13's tree, so the programs and references (refs-d29bfe9) are the same:
- tokens and prefill sha bit for bit;
- a whole expert's record about 0.70-0.75 ms (35B) and 1.39-1.49 ms (26B), from 1.18 and 2.36;
- the window fits near 0.45 + 1.01-1.07 ms per miss (35B) and 0.55 + 1.75-1.82 (26B);
- tok/s as above.

The card check (2026-10-02 00:31-00:37, production g2fix 0885d436 with no reload; session 13's
tree b40fc6f with d29bfe9's programs; `g2check.sh`: q35e128s twice, then g26s). Every run
matched the ISA simulator bit for bit (tokens, prefill sha 88225ff781699291 / 90e6b6e06e19da99).
Gen1 is session 13's N2 / gN1 (10.8):

| run | link | tok/s (device) | decode Gcycles | windows s | window fit (ms) | record, median | first miss (lead + rest) | 64-byte call | DMA_BUSY G | RUNNING - DMA_BUSY G | MXU_STARVE G | poll reads |
|:--|:--|:--|:--|:--|:--|:--|:--|:--|:--|:--|:--|:--|
| 35B | Gen1 | 4.04 (4.05) | 4.217 | 20.02 | 0.34 + 1.39 / miss | 1183 us | 371 + 972 us | 48.6 us | 2.386 | 1.831 | 0.108 | 352k |
| 35B | Gen2 | **5.07** (5.09) | 3.355 | 13.25 | 0.33 + 0.88 | 661 | 327 + 595 | 36.6 | 1.502 | 1.853 | 0.126 | 435k |
| 35B | Gen2 | **5.10** (5.12) | 3.336 | 13.07 | 0.37 + 0.85 | 659 | 324 + 597 | 35.6 | 1.478 | 1.858 | 0.129 | 456k |
| 26B | Gen1 | 2.78 (2.78) | 6.138 | 31.34 | 0.52 + 2.60 | 2360 | 604 + 2032 | 61.0 | 2.256 | 3.882 | 0.284 | 456k |
| 26B | Gen2 | **3.54** (3.55) | 4.810 | 20.68 | 0.79 + 1.56 | 1346 | 427 + 1318 | 49.3 | 0.842 | 3.968 | 0.316 | 561k |

- 35B: +25.5% and +26.2%, at the top of the predicted 4.9-5.1. Its windows fell 6.8-7.0 s (-5.7
  to -6.3 predicted).
- 26B: +27.3%, just under the predicted 3.56-3.63. Its windows fell 10.66 s, as predicted (-10.1
  to -10.8).
- The link beat bound (b): a record goes 1.75-1.79x faster, not 1.70x, so part of each call's
  fixed cost is the link's. The data calls run at 2.19-2.28 GB/s.
- The 64-byte calls are not pure latency either: 36 us on the 35B and 49 us on the 26B, from 49
  and 61.
- The 26B's shortfall is on the device's side. RUNNING - DMA_BUSY, the time the card computes,
  rose 0.086 G cycles (0.65 s per 128 tokens). Of that, MXU_STARVE accounts for 0.032 G. Without
  that rise, the 26B makes 3.61 tok/s. The 35B's compute rose too, by only 0.02-0.03 G.
- Two causes are possible. The expert writes now take 2.28 GB/s of the DRAM while the hits
  compute. The spinning poll reads 23% more often, because a Gen2 read returns sooner (one every
  ~27 us outside the windows on the 26B). The poll A/B (10.10) separates the two.

### 10.10 Pacing the poll

Session 13's spinning poll reads the card's seq every ~33 us while the card computes between
requests: 346k reads per 128 tokens on the 35B (98k with the 50 us sleep), 456k on the 26B (64k).
MXU_STARVE rose with it (+0.03 G and +0.07 G cycles), about 120-180 cycles per extra read if the
reads are the cause. The other candidate is the expert DMA, which now starts earlier and overlaps
the hits' compute (10.8).

`PollPacer` (`opentpu.host.offload`) wraps the servers' polls for the decode. For each kind of
request it keeps the last 8 gaps between serving a request and seeing the next one. The kind is
(server, layer, demand or hint), or a row. After serving, it sleeps 0.75 x the shortest of
those gaps (at most 5 ms), minus 100 us for the sleep's late wake-up, and then spins. The sleep
is skipped when it would be under 100 us or when a server has hints pending, and a hint's part
step is not a request. Detection stays the spin's ~26 us unless a gap comes in shorter than 0.75
x the shortest of its last 8.

moe_card `--poll-idle spin | S | predict` sets the decode's poll: spin (the card's default), a
fixed sleep of S seconds between empty polls (the legacy 50e-6), or the pacer. The JSON records
`poll_idle`, plus `pacer` (sleeps, seconds slept, kinds).

Session 14 (`tools/offload/sessions/session14.sh`, session 13's tree with the pacer: 17e99eb,
d29bfe9's programs and refs-d29bfe9) runs on the Gen2 production build:
- q35e128s, q35e128sp: the 35B spinning and paced (spinning on Gen2: 5.07-5.10 tok/s, 10.9);
- g26s, g26s50, g26sp, g26s, g26sp: the 26B's poll A/B (spinning on Gen2: 3.54 tok/s, 561k reads).

The prediction for the 26B A/B, per 128 tokens (about 3840 requests):
- Poll reads: spin about 560k (Gen2's check), 50 us 110-130k, paced 140-200k.
- If the reads cost the MXU (session 13's 120-180 cycles each):
  - MXU_STARVE falls 0.04-0.06 G both paced and with 50 us.
  - Paced gains 0.3-0.45 s (+1%).
  - 50 us gains 0.1-0.25 s, because its detection costs 56 us per request (82 against 26 us),
    0.2 s in all.
- If the reads don't cost the MXU:
  - MXU_STARVE stays within 0.01 G.
  - Paced equals spin within noise (0.1 s).
  - 50 us loses about 0.2 s (-0.6%).

The pacer becomes the decode's default if MXU_STARVE falls and it is not slower. Otherwise
spinning stays, and the RUNNING - DMA_BUSY rise is the expert DMA's overlap, a matter for the
DRAM's arbitration.

Card session 14 (2026-10-02 00:47-01:04, `session14.sh`, tree 17e99eb, production g2fix
0885d436 with no reload). All 7 runs matched the ISA simulator bit for bit:

| run | poll | tok/s (device) | decode Gcycles | windows s | DMA_BUSY G | RUNNING - DMA_BUSY G | MXU_STARVE G | poll reads | pacer: sleeps, s slept |
|:--|:--|:--|:--|:--|:--|:--|:--|:--|:--|
| 35B N1 | spin | 5.01 (5.02) | 3.396 | 13.60 | 1.549 | 1.847 | 0.122 | 442k | |
| 35B P1 | paced | 5.00 (5.02) | 3.401 | 13.59 | 1.557 | 1.844 | 0.122 | 225k | 5206, 4.41 |
| 26B gS1 | spin | 3.54 (3.55) | 4.809 | 20.64 | 0.839 | 3.970 | 0.317 | 573k | |
| 26B gF1 | 50 us | 3.55 (3.55) | 4.801 | 20.42 | 0.839 | 3.962 | 0.318 | 106k | |
| 26B gP1 | paced | 3.54 (3.54) | 4.815 | 20.67 | 0.858 | 3.957 | 0.313 | 249k | 3810, 6.98 |
| 26B gS2 | spin | 3.55 (3.55) | 4.802 | 20.46 | 0.829 | 3.972 | 0.319 | 587k | |
| 26B gP2 | paced | 3.54 (3.55) | 4.807 | 20.55 | 0.844 | 3.964 | 0.316 | 245k | 3810, 7.02 |

- The poll's reads do not cost the MXU. The pacer cut them by 57% and the 50 us sleep by 82%,
  and MXU_STARVE stayed within 0.006 G cycles of spinning, RUNNING - DMA_BUSY within 0.015 G.
  That is the prediction's second case. The compute's rise from Gen1 to Gen2 (10.9) is the
  expert DMA's writes, which overlap the hits' compute.
- Decode cycles are within 0.3% across all five 26B runs, and the 35B's two runs within 0.15%.
- The 50 us sleep did not lose the predicted 0.2 s. Its decode cycles are the lowest of the
  five, within noise. So its later detection doesn't show on Gen2: on the 26B the card stalls
  (DMA_BUSY) for only 6.3 s of its 20.5 s of windows, so most of a request's DMA is hidden
  behind its compute.
- The pacer slept 4.4 s (35B) and 7.0 s (26B) per 128 tokens. It cut fewer reads than the
  140-200k predicted, because it spins out the rest of each gap.
- The rule: MXU_STARVE did not fall beyond noise, so the pacer does not become the default and
  the decode keeps spinning. A sleep between polls costs nothing measurable on Gen2 and saves
  the host most of a core, so either --poll-idle 50e-6 or predict is safe where the host's CPU
  matters.
- The 35B's spin run made 5.01 tok/s against g2check's 5.07 / 5.10 an hour earlier. Its data
  calls ran at 2.13 GB/s against 2.19-2.21 (records 665 against 660 us, first pieces 344 + 612
  against 326 + 596 us), so the link varies by about 3% between sessions.

### 10.11 One call per request: design

Each miss ends in its directory entry, a 64-byte call the card waits for. On Gen2 these calls
take 41 us (35B) and 58 us (26B) each, plus about 10 us of link idle before each. That comes to
0.77-0.82 s per 128 tokens on the 35B (13,113 entries) and 0.93 s on the 26B (11,310), all on
the card's critical path. The design below removes them. Each miss's own data call says it has
landed, and one 64-byte call per request tells the card where its misses go.

The host, per request with misses:
1. **The answer**: one 64-byte beat (a new line after served; a two-line request's answer is
   two beats). Its word r is the slot address of rank r when that expert is missing, and 0 for
   the hits. It is written once the first expert's first part is on its way, so the link
   starts on the expert (10.13; A wrote it before the first data call, which on the card cost
   its 75-90 us ahead of the lead). The card waits on each word, so its place among the data
   calls does not matter to the card.
2. **Each missing expert's data, with a tag**: a 128-byte tag chunk after the record (the 35B's
   pitch grows by one 4 KiB block, the 26B's fits its padding). Its word 0 is nonzero. The
   record goes as today, one call per channel, and the channel that holds the tag word goes
   last. A hint's expert carries its tag in its last part.
3. **The directory**, after the last data and before served: the new entries and the victims'
   clears, as today. They can go one beat each (2m calls, as the clears do now), or as the
   layer's directory, 8 x E bytes, in one call per channel. Off the critical path either way.
4. **A victim whose tag is still set** (a hint's expert that was never used): its tag is cleared
   in a 64-byte call before its data. That happens only with hints.

The card (moe_ffn and moe_ffn_rows; the present flags still come from the directory, so a
request with no miss never waits for the host):
- For a present expert, as today: WAITW on its entry, then the expert. It also stores 0 to the
  slot's tag word.
- For a missing expert:
  1. WAITW `answer + 4r != 0` (r its rank; 4r a new row of pe), which gives its slot. The
     address goes into TMEM raw, as the entry's does now, never through the VPU.
  2. WAITW `M32[slot + tag] != 0`.
  3. Store 0 to the tag word.
  4. Compute the expert.
- After the layer's experts, store 0 to the answer's words.
- The cost is one register as now, and per expert one WAITW and one store more: about 45k of
  them per 128 tokens, about 0.01 s.

Every expert the card uses has its tag cleared by the card's own store. That store is older
than the card's next post, so it lands before the host can pick the slot as a victim again. A
nonzero tag then means this load's data. The answer works the same way: zeroed by the card
before its next post, written by the host only after it sees that post.

The new ordering contract: the tag is the last beat of the last call, and the card must not
see it before that call's earlier beats on the same channel. The other channel's call has
completed before then, which is the old contract. ld-memch confirmed the new one (2026-10-02)
for g2fix 0885d436 and for the porta-flush build; otpu_mem_ch is the same in both. Three
conditions:
1. The bitstream has xdma_rnum_rids 8 (xfix, g2fix, pa). On the 32-RID builds, XDMA could lap
   its 8 KiB completion ring under write backpressure, which the WAITW's polls create, and data
   from 8 KiB later appeared mid-burst.
2. One pwrite is one transfer on h2c_0, inside one channel's window, with the tag at its
   highest address.
   - XDMA emits a transfer's bursts in ascending address order. otpu_axi_split2 and otpu_mem_ch
     keep AW order per channel, and W follows AW.
   - LiteDRAM's two bank-parity ports may write the tag before an earlier beat. But the core
     reads that beat only after its tag read has returned, and the read goes to the same port,
     behind XDMA's write.
3. Port A, on g2fix only: an expert's scale arrays must not start in the beat of the last
   port-A read before the WAITW, nor in the next channel beat of a live port-A run. Every slot
   meets this, since each scale array follows its own port-B data. On porta-flush there is no
   condition: the WAITW's hold drops port A's reused beat and its runs.

`tools/qual/waitw.py --tag-rounds 2000` checks it on the bitstream. Each round sends 1-4 MiB with
the tag in either channel and bank parity, while the card's WAITW reads the tag's channel back
to back. The card then copies the 64 beats before the tag on each channel, and 64 random beats,
and all must be the new data.

The prediction, from the Gen2 traces (g2check). Entries removed, plus one answer call per
request with misses where it is not hidden (the upper bound):

| model | requests with misses | entries + their gaps | answer calls | saved per 128 tokens | tok/s |
|:--|:--|:--|:--|:--|:--|
| 35B | 4649 of 5120 (2.82 misses each) | 0.77-0.82 s | 0-0.19 s | 0.59-0.81 s | 5.07-5.10 -> 5.19-5.27 (+2.4-3.3%) |
| 26B | 3661 of 3840 (3.09 each) | 0.93 s | 0-0.21 s | 0.72-0.93 s | 3.54 -> 3.61-3.63 (+2.0-2.5%) |

A window's saving reaches the card only where the card is stalled at the window's end. On the
35B it stalls for most of its windows (DMA_BUSY 11.6 s of 13.6 s), so most of the saving
reaches it. On the 26B it stalls for 6.3 s of 20.5 s, its dense MLP and hits running while the
experts stream (session 14). Requests with many misses stall, and they carry most of the
entries, so perhaps 50-100% of the 26B's saving reaches the card: -0.4 to -0.9 s, 3.58-3.63
tok/s.

With the directory as one call per channel, the 35B's 64-byte calls fall from 31,346 to about
19,000 per 128 tokens. That leaves more of the link's idle time for hints. The 35B's +4 KiB per
slot keeps its 42 slots a layer (42.66 fit, from 42.77).

The proof:
- `test_offload_server`, the host's contract:
  - the answer comes after its first expert's first part, before the rest (10.13; A: before
    any data);
  - each record's tag is in the last beat of the last call;
  - the directory comes after the last data, and served after the directory;
  - an armed victim's tag is cleared before its data.
- ISA simulator, end to end:
  - the tiny MoE test models (16 heads, untied head) and Qwen3.5 / Gemma 4 / LFM2 MoE shapes;
  - all-miss, all-hit and mixed, with hints, layer-major and Gemma's beside();
  - tokens and logits must be bit-identical to the current programs, since the math is
    unchanged;
  - an adversarial host: SimDram writes each record a beat per host call, with the machine
    running in between, so the card would read any data it reaches before the tag;
  - a negative control (the tag first) that must break.
- Card: q35e128s / g26s on the new programs must match refs-d29bfe9's tokens and prefill sha.
  The math is unchanged, so new references are not needed for the result. The programs'
  references are still recomputed on the build host, for the record.

Program sha impact: every MoE model's programs change (moe_ffn, moe_ffn_rows; Qwen3.5-35B-A3B,
Gemma 4 26B-A4B, LFM2-8B-A1B, the tiny test MoEs). So do their images: the slot pitch, the
answer line, and the directory one line further. Dense models' programs do not change. The
program cache's keys change with them.

The implementation (branch offload-onecall):
- `Layout`: the answer line after served (two lines for a two-line layout), the directory one
  line further, and each slot's 128-byte tag chunk at `tag` (its bytes rounded up to whole
  chunks); the pitch rounds the slot and its chunk up to RUN blocks, or under RUN to the
  slot's own alignment.
- `ExpertServer`:
  - `serve` picks every missing expert's slot first, writes the answer, then each expert with
    its tag (`_write`), then the directory (`_dir_flush`: each changed beat, or from three
    beats of a layer its span as one write);
  - `armed` holds the slots whose tag the card may not have zeroed; `_reuse` clears one before
    its slot takes another expert;
  - `load` zeroes every tag and the answer.
  - `settle`: begin_prefill and end_prefill first serve the card's last request if it is
    still unserved. A request whose experts are all present does not wait for the host, so a
    run can halt before the host sees it, as a layer-major prefill's last run can. Served
    after the restore, such a request could name misses. Its answer line would then stay
    nonzero, because the card is done with that request, and the next request would read it
    as its own. Main's Qwen3.5 layer-major test, merged in, caught this.
- `BoardDram.write_slot(addr, data, tag)` puts the tag beat after the expert's runs in their
  staging buffers, and the last part's DMA goes on the other channel first, then on the tag's
  channel. A whole beat outside the shadow (a tag's clear) is one call with no read.
- `moe.slot_of`, used by moe_ffn and moe_ffn_rows: the present path WAITWs on the entry; the
  missing path WAITWs on the answer word (pe's ANS row: 4 x the id's place), then on the tag.
  Both store 0 to the tag; after the experts, the answer's words are stored 0.
- `checks.waitw_tag` (`tools/qual/waitw.py --tag-rounds N`) is the card's check of the order.
- `serve_emu.py` times crit to the last tag landed.

The proof on the ISA simulator (all on a laptop):
- `tests/beat_link.py` is the adversarial link. The server's writes land one 64-byte beat at a
  time, in order. The machine runs again as soon as a WAITW holds, so the card computes while
  later experts' beats are still queued.
- Over it, with k slots a layer, the logits match the full cache bit for bit:
  - LFM2-MoE;
  - Qwen3.5-MoE with hints (an expert still on its way, waited for by its tag), plus its
    generate loop;
  - Gemma 4 26B-A4B's block with its dense MLP beside, token by token and layer-major R = 2
    (moe_ffn_rows).
- The negative control lands each tag before its expert's bytes. It breaks the logits on
  LFM2-MoE and on Gemma 4's layer-major prefill.
- The three models' existing MoE tests all pass on the new programs (63). That includes the
  live-card ones, BoardDram's threaded and split modes, and the layer-major prefill.
- `test_offload_server` checks the contract call by call on the link: the answer first (since
  10.13, after the first expert's first part); each
  expert's last part on the other channel and then the tag's, with the tag as that call's last
  beat; the directory after them; served last. It also covers an armed victim's clear before
  its bytes, and a multi-row request's answer at each id's first place.

On the card, session 15 (2026-10-02 04:36-04:54 on the card host's clock):
- Setup: production pa e4db91c9, no reload. `session15.sh` ran tree 4ae2aa9 against its
  parent, main cb3dce5 (OLD), A B A B, q35e128s and g26s.
- `waitw.py --tag-rounds 2000` came first: PASS (2375 MB/s), with the 50 host-write rounds and
  the timeout check.
- Every run matched its own ISA reference bit for bit: refs-f725c2b for A, refs-cb3dce5 for
  OLD. Both equal refs-d29bfe9 (88225ff781699291, 90e6b6e06e19da99).

Column meanings in the table below:
- crit: seen to the request's critical end, summed over the requests with misses (4649 /
  3661). The critical end is OLD's last new entry's call, or A's last expert's last call (the
  tag in its last beat).
- head: seen to the request's first data call. body: the rest of crit.
- 64-byte calls: A adds the directory spans, two calls each.

| run | tok/s (device) | decode G cycles | DMA_BUSY G | windows s | crit s (head + body) | link busy s | 64-byte calls |
|:--|:--|:--|:--|:--|:--|:--|:--|
| 35B OLD | 5.02 (5.04) | 3.386 | 1.535 | 13.41 | 12.58 (1.42 + 11.15) | 11.35 | 31,346 |
| 35B A | **5.16** (5.18) | 3.297 | 1.476 | 13.00 | 11.98 (1.95 + 10.04) | 10.90 | 11,776 + 3,629 spans |
| 35B OLD | 5.02 (5.03) | 3.391 | 1.544 | 13.48 | 12.59 (1.50 + 11.09) | 11.32 | 31,346 |
| 35B A | **5.08** (5.10) | 3.347 | 1.537 | 13.45 | 12.37 (2.07 + 10.30) | 11.28 | 11,776 + 3,629 |
| 26B OLD | 3.52 (3.52) | 4.842 | 0.900 | 20.98 | 20.04 (1.46 + 18.58) | 18.72 | 26,460 |
| 26B A | **3.58** (3.59) | 4.752 | 0.802 | 20.26 | 19.30 (1.85 + 17.45) | 18.15 | 8,595 + 3,097 |
| 26B OLD | 3.52 (3.53) | 4.836 | 0.888 | 20.93 | 19.97 (1.43 + 18.54) | 18.74 | 26,460 |
| 26B A | **3.58** (3.59) | 4.757 | 0.814 | 20.46 | 19.40 (1.81 + 17.59) | 18.27 | 8,595 + 3,097 |

- The 35B gains +1.2 to +2.8% (predicted +2.4-3.3%). The 26B gains +1.7% (predicted +1-2.5%):
  its stall, DMA_BUSY, fell 0.09 G cycles (0.65 s).
- The body fell as much as predicted or more: -0.85 to -1.11 s (35B) and -1.0 to -1.1 s (26B),
  against entries plus their gaps of 0.77-0.82 and 0.93 s.
- The head rose, by 0.45-0.65 s (35B) and 0.35-0.42 s (26B): the answer is not hidden.
  - It goes out 232-246 us after seen, once every slot of the request is picked.
  - As the window's first call it takes 75-90 us; a warm 64-byte call takes 35-50.
  - The first expert's lead DMA starts 86-146 us after the answer. That is 397-472 us after
    seen, against OLD's 294-377.
  - In serve_emu's probe of the same code, the lead's read and staging also take ~40 us longer
    while the DMA thread runs the answer's call, as the two threads trade the GIL.
- OLD here (main cb3dce5 on pa) made 5.02 tok/s, against g2check's 5.07-5.10 (b40fc6f on
  g2fix). The card's compute is the same (RUNNING - DMA_BUSY 1.85 G). The host's windows are
  0.2-0.4 s longer: head +0.15-0.23 s, body +0.13-0.19 s.

- LFM2-8B-A1B's new programs are proven on the ISA simulator only: its pool is not on the card host.
  Its next card run must include a token-exact check against its own ISA reference.

Next, host only: send the answer after the first expert's lead DMA (between its two parts on
the link, ~35-50 us), and cut the head's own steps.
- serve_emu's probe of the head (35B, OLD), medians from seen:
  - the row read ends at 59 us: a 19 us read plus ~20 us of Python;
  - picking a slot takes 18 us;
  - building the iovec takes 25 us;
  - `PoolFile.io`'s mincore takes 37 us;
  - the lead's preadv takes 65 us, and its touch 22 us;
  - the DMA thread starts the call 74 us after it is queued.
- The lead's DMA starts about 300 us after seen, and the read itself is only 65 us of that.
- On the card the head is 1.4-2.1 s per 128 tokens.
- B (below) as MMIO would also take the answer off the DMA thread. serve_emu with B's costs
  shows no gain over A, but its answer costs only ~37 us at the head, against the card's ~100.

Two alternatives:
- **B: the 64-byte writes as MMIO.** Use XDMA's bypass BAR, or an AXI-Lite window onto DRAM
  through otpu_mem_ch. A posted write is about 1-2 us, so every 64-byte call (entries, clears,
  served, the answer) loses its 35-58 us without a program change. The poll's read could also go
  over the BAR, at ~2 us instead of a ~30 us C2H call, for faster detection. It saves about as
  much as A on the critical path (0.6-0.8 s per 128 tokens) and about 1 s of link time besides.
  It needs a bitstream (ld-memch's area), and a check that a posted write issued after a DMA's
  completion lands after that DMA's data.
- **C: XDMA's poll_mode=1** (a driver parameter: the user's setting). Completion by polling
  instead of the interrupt might cut every call's fixed cost, data calls included. It needs a
  dma_bench measurement after the user reloads the driver with it. That is a proposal, not
  something I change.

The recommendation is A first: no bitstream, +2-3% on Gen2, and the ordering test can run on
the current production bitstream. B later, with the next bitstream that has room for it
(10.12: parked; at most 0.3% after A on the emulator's model, up to 1-2% on the 35B by the
card's answer cost until a software reorder lands).

### 10.12 Alternative B: a host window onto DRAM (design, ld-memch; parked)

Parked on 2026-10-02. After design A the emulator shows nothing measurable, but on the card
A's answer is not hidden yet, so B could still be worth up to 1-2% on the 35B until a software
reorder lands ("What B is worth after A" and "On the card", below).

B moves the small calls from XDMA's DMA engine to MMIO. The host's 64-byte writes (the answer,
served, entries, clears) and the poll's reads become loads and stores on a window of BAR0, at
about 1-3 us instead of a 36-58 us call. The window maps onto DRAM, so the card's programs do
not change: WAITW still polls a DRAM word through port B.

**What exists.** XDMA's AXI-Lite master (BAR0, 1 MiB) already reaches the control registers
through `sc_ctl`, which crosses into the core clock (`M_AXI_CTL`, 64 KiB at 0). The host maps BAR0
with `/dev/xdma0_user` (XdmaTransport.regs, 0x40000 bytes, uncached), and a register read takes
about 1 us. otpu_ctrl decodes 12 address bits, so the CTL aperture's other 60 KiB are aliases
today.

**The RTL** (core clock only; no change to XDMA, the block design, the split or otpu_mem_ch):
- **The window.** CTL offsets 0x8000-0xFFFF (32 KiB) go to a new block, the rest to otpu_ctrl,
  through an AXI-Lite 1:2 split by address bit 15 in the board top. otpu_ctrl gets one register,
  WIN_BASE: the window's DRAM base, a logical byte address, 32 KiB aligned. The host moves the
  window with one register write. A request's answer line, served and the poll's word fit in
  one 32 KiB window. The directory (8 x E bytes a layer) stays a DMA call, which is off the
  critical path in A.
- **A host port H in otpu_native_dram,** a fifth source in each channel's command mux, after B,
  with its own tag kind, so its read data routes back like the others':
  - Writes are 32-bit words with byte enables. They gather in a one-beat buffer, as port SW's
    do. The beat goes out whole when all 16 words are written, when a write to another beat
    arrives, before a read of the same beat, or after a timeout longer than the host's gap
    between two stores (about 0.2 us, 27 cycles). A partial beat goes out with its mask, and
    otpu_mem_ch does the read-modify-write.
  - Reads are one beat each. The window's word comes back on AXI-Lite R.
  - H's writes go through the adapter's own stream, so they drop port A's reused beat and runs
    the way B's and SW's writes do. That is better than XDMA's writes, which the adapter never
    sees.
- **How the card sees it:** nothing changes on its side. WAITW polls the word through port B,
  and a host write is visible once it has entered the channel's stream. The host writes a
  line's flag word last: within a beat that is the order a partial flush keeps, and a whole
  beat lands at once.
- **Area:** about 1-1.5k LUTs and 1k flip-flops (a 576-bit gather buffer, an address register,
  a 512-to-32 read select, one more mux input and tag kind per channel), no block RAM. The pa
  build has 175k LUTs (58.8%) and 76% of its slices.
- **Timing:**
  - userclk1 and userclk2: no new logic in XDMA's domains (sc_ctl already crosses), so no new
    risk at 250 / 500 MHz.
  - Core clock at 133.33 MHz: pa's WNS there is +0.055 ns. The risk is otpu_native_dram's
    per-channel command mux, which gains an input. Mitigations: H's command is registered and
    has the lowest priority, and the read select is registered once more.
  - Before a build, an OOC of otpu_native_dram with H at 7.5 ns: the tournament's
    otpu_native_dram component flow.

**The host** (no driver change, no reload, no root):
- The window is inside the 0x40000 bytes of `/dev/xdma0_user` that XdmaTransport maps already.
  The driver exposes the whole BAR.
- A 64-byte line is 16 32-bit stores, flag last; on an uncached mapping each is a posted write.
  XDMA's AXI-Lite master takes one DW per request, so no 64-bit stores.
- A poll is one 32-bit load: about 1 us of PCIe round trip plus the DRAM read through the adapter
  (40-60 core cycles, about 0.4 us).
- The window replaces BoardDram's 64-byte calls and the poll's C2H read. XdmaTransport keeps
  the DMA calls for the data.
- CAPS gets a bit (WIN): the host uses the window only on bitstreams that have it.

**Ordering:**
- **Writes after data.** B's writes are issued after the data call has returned. XDMA has seen
  B for every beat, so every beat is in the controller's queues (otpu_mem_ch's B comes after
  the controller has taken a burst's beats). A window write enters later, and the card reads
  the data only after it has seen the window's flag. Those reads queue behind the data's writes
  on the beat's port: the WAITW contract of docs/isa.md as it is. It needs none of 10.11's
  conditions on the order within one transfer.
- **Design A's tag in the last beat** stays the data call's own order and needs nothing from
  the window. With both, A's tag removes the per-miss flag and B carries the rest (answer,
  served, directory, polls).
- **Window writes among themselves** are in order: AXI-Lite, then one queue. **Against the
  card's own stores** a window read follows them in the channel's stream once they have gone
  out (the card posts with a store; the host polls with a load).
- **A posted MMIO write and a later DMA call** are not ordered against each other: neither
  path waits for the other. B never needs that order: the card waits on the window's flag, and
  any data it then reads came in an earlier, completed call.

**What B is worth after A** (offload's serve_emu, 2026-10-02): nothing measurable, so B is
parked. The emulator replays g2check's Gen2 traces (35B N2, 26B gN1, two runs of each). Its
link is calibrated to the card's calls:
- Each pwrite costs what the card measured for its size: 162 / 298 / 330 us on the 35B
  (lead / rest / full) and 214 / 659 / 673 us on the 26B.
- A 64-byte call costs 35.6 / 49.3 us, and a C2H read 19.4 / 20.3 us.
- The card's next post comes after its own compute, counted from the request's critical end.
- In B a window write is 3 us of the worker's CPU and no link time, and a load is 1.5 us.

The emulator runs 10% (35B) and 4% (26B) slower than the card, so read the deltas. Per 128
tokens, against main's entry protocol, with a run-to-run spread of 0.05-0.1 s:

| | 35B wall | 35B link busy | 26B wall | 26B link busy |
|---|---|---|---|---|
| main | 27.59 s | 10.97 s | 37.51 s | 17.99 s |
| A | -0.81 | -0.44 | -0.92 | -0.57 |
| A + B, the directory by DMA | -0.77 | -0.86 | -0.84 | -1.00 |
| A + B, the directory as window beats | -0.66 | -1.12 | -0.91 | -1.30 |
| B alone (entries as window writes) | -0.44 | -1.12 | -0.33 | -1.30 |

- **B after A: 0 +- 0.05 s.** A already hides the answer: it goes out about 240 us after the
  request is seen, while the first data waits about 430 us for the pool's read. What B could
  still save is at most about 15 us a request: detection drops from 24 to 15.5 us, and the
  row's read is about 6 us faster. That is 0.07 s on the 35B and 0.06 s on the 26B,
  +0.3% / +0.15%.
- **B alone is 60-65% of A on the card.** The emulator shows 0.40-0.44 / 0.32-0.33 s, but its
  worker spends 40-55 us of Python between calls where the card's spends about 10. On the
  card that is 13,113 entries x (41 -> 3 us) = 0.50 s on the 35B and 11,310 x (58 -> 3 us)
  = 0.62 s on the 26B.
- **tok/s on the card's scale:**

  | | 35B | 26B |
  |---|---|---|
  | main | 5.10 | 3.54 |
  | A | 5.27 | 3.59-3.63 |
  | A + B | 5.27-5.28 | 3.59-3.64 |
  | B alone | 5.19-5.21 | 3.57-3.60 |

- **What B frees is link time.** It frees 0.86-1.30 s per 128 tokens, and nothing uses idle
  link time today (router hints are off).
- **The larger host lever is software.** From seen to the first data DMA takes 258 / 309 us
  (median, 35B / 26B): 1.27 / 1.20 s per 128 tokens on the critical path. Only about 20 us of
  it is the row's read; the rest is serve's Python and the pool's read.

**On the card** (offload, session 15, design A on production pa e4db91c9): the answer is not
hidden. It goes out 232-246 us after the request is seen, the window's first call is cold
(75-90 us), and the lead expert's DMA starts after it. A's net gain is +1.2-2.8% on the 35B and
+1.7% on the 26B, below the emulator's. So, B after A: at most 0.3% on the emulator's model,
but the card's answer cost suggests up to +1-2% on the 35B (0.3-0.5 s per 128 tokens) until a
software reorder lands. That reorder is offload's next step: the answer after the first
expert's lead DMA. Measure B's case again after it.

**Port H out of context** (the build host, otpu_native_dram alone, 7.5 ns, D = 128):
- **WNS +0.208 ns, against main's +0.530.** The worst paths in both are existing ones: the tag
  RAM's head pointer fanning out into the LUTRAMs' write addresses, at 0 logic levels and
  about 7 ns of route.
- **H's own worst path is +1.52 ns at 5 levels:** the gather mask's all-ones detect into the
  issue beat's load enables.
- **Area: +879 LUTs and +1,253 flip-flops.** The gather beat and the issue beat are both
  registered, which is why the flip-flop count is above the estimate.

**Parked.** No bitstream carries B. The port is on branch hwin (8fce830):
- otpu_native_dram's port H, tied off in otpu_board and otpu_top.
- Its gather timeout is the HGATHER parameter, 255 idle cycles.
- It is lint-clean and has no functional test.

The window block, WIN_BASE, the CAPS bit and the host side were not written. B is worth
reconsidering when something uses the link's idle time (router hints) or a build has spare
area for it.

### 10.13 The request's head (offload-head)

The head is the time from seen to the request's first data call. On the card it is 1.4-2.1 s per
128 tokens (session 15), and A made it 0.35-0.65 s longer: A's answer went first, as the
window's cold first call (75-90 us), and the first expert's lead DMA started 397-472 us after
seen (10.11).

Where the old path's ~300 us go (serve_emu's probe, 35B, medians from seen; 10.11):
- Python: the row read's ~22 us beyond its 19 us C2H call, the slot pick (18 us) and the iovec
  (25 us).
- The pool: mincore (37 us), the lead's preadv (65 us) and its touch (22 us).
- The handoff: the DMA thread starts the call 74 us after it is queued, as the threads trade
  the GIL.
- On the card, willneed adds ~15 us per other miss ahead of the lead.

offload-head changes the host only. The programs and the card's contract stay as they are (the
card waits on each answer word and each tag, 10.11):
- The answer goes once the first expert's first part is queued (`BoardDram.write_slot(...,
  then=)`). On the link it sits between that expert's two parts.
- The other misses' willneed goes with the answer, no longer ahead of the lead.
- A mapped pool's touches (10.7) wait until the request is served (`PoolFile.defer_touch`), and
  run while the card computes.
- mincore reuses one vector and its address. Each part's iovec is built as it is read, not the
  whole record's first.
- `_DmaLock` is reentrant. BoardDram's worker holds it across the calls queued behind each
  other, so each call inside skips the flock's two system calls (each one more wait for the GIL).

serve_emu (Gen2, card-calibrated, posts from the critical end; 128 tokens) gives crit in s.
Sweeps hs1-hs3 ran on the card host with the card idle; A, the merged design, is in every sweep (one
35B A run right after hs3's warm-up, 15.49, is left out):

| tree | 35B | 26B |
|:--|:--|:--|
| A | 13.57-14.72 | 20.26-21.35 |
| H: the answer after the lead only (hs1) | 14.65-14.78 (A 14.72) | 22.47-22.56 (A 21.16-21.35) |
| H2: H, willneed after the lead, touches deferred, mincore (hs2, hs3) | 13.09-13.35 (A 13.57-14.01) | 19.85-19.97 (A 20.26-20.49) |
| H3: H2 and the reentrant lock, offload-head (hs3) | 12.97-13.03 (A 13.57) | 19.80 (A 20.39) |

- The reorder alone did nothing for the 35B and cost the 26B 1.2 s. The gain comes with the
  head's own steps cut: -0.55 to -0.6 s per 128 tokens on both models.
- On the link, A's longest wait was the answer's for the first data: 150-185 us a request,
  0.58-0.74 s per 128 tokens on the 35B. With H3 the answer goes 31-35 us after the lead's
  part, and the next part 24-28 us after the answer.
- hs4 adds N: H3 with the answer first again. It ran while a card session was live, so it is
  indicative only. N matched H3 within 0.15 s on both models. On the emulator the answer's
  place no longer matters once the head's steps are cut. The card's cold first call (75-90 us,
  which the emulator does not model) may still favor H3.

Prediction for the card: the 35B 5.08-5.16 -> 5.20-5.27 tok/s, the 26B 3.58 -> 3.63-3.65.
The check is session 16 (`session16.sh`): main against this tree on the same bitstream, A B A
B, q35e128s and g26s. Both must match their ISA references bit for bit (refs-s16).
- Main's Qwen3.5-35B programs changed after f725c2b (b0b2b541 -> 1a32006f, the MTP and
  layer-compile merges). Their new ISA reference (refs-8100ffb, main a60df35's tree) gives the
  same tokens and prefill sha as before, 88225ff781699291.
- The 26B's programs did not change (4400270b, 6d7a8ec2), so refs-f725c2b's 90e6b6e06e19da99
  still holds for it.

On the card, session 16 (2026-10-02 08:58-09:19 on the card host's clock):
- Setup: production pa e4db91c9, no reload, one lock. M = main a60df35 (A), H = offload-head
  40baa60 (A'), M H M H.
- All ten runs matched bit for bit: the decode runs against refs-s16, the prefill pair against
  lmtime's sha 95426ebacc3b40a9. The selftests before and after were ALL PASS.

Column meanings in the table below:
- crit: as in 10.11, seen to the last tag's call, over the requests with misses (4649 / 3661).
- head: seen to the first data call. body: the rest of crit.
- lead: the median from seen to the lead's DMA.

| run | tok/s (device) | RUNNING G | DMA_BUSY G | crit s (head + body) | lead us |
|:--|:--|:--|:--|:--|:--|
| 35B M | 5.05 (5.06) | 3.370 | 1.558 | 12.55 (2.07 + 10.48) | 403 |
| 35B H | **5.29** (5.31) | 3.211 | 1.366 | 11.32 (1.43 + 9.89) | 290 |
| 35B M | 5.14 (5.16) | 3.305 | 1.488 | 12.05 (1.94 + 10.11) | 404 |
| 35B H | **5.23** (5.25) | 3.249 | 1.417 | 11.61 (1.43 + 10.18) | 297 |
| 26B M | 3.57 (3.58) | 4.768 | 0.835 | 19.49 (1.85 + 17.64) | 475 |
| 26B H | **3.59** (3.60) | 4.741 | 0.771 | 19.12 (1.21 + 17.91) | 311 |
| 26B M | 3.57 (3.58) | 4.773 | 0.847 | 19.57 (1.86 + 17.71) | 477 |
| 26B H | **3.60** (3.61) | 4.730 | 0.755 | 19.02 (1.21 + 17.82) | 313 |

- The 35B gains +3.2% on the means (5.10 -> 5.26), inside the prediction (5.20-5.27).
- The head fell as predicted on both models: -0.51 to -0.64 s (35B) and -0.64 s (26B). The
  lead's DMA now starts 290-313 us after seen, against A's 403-477.
- The answer now costs its 43-58 us call inside the body: +0.2 s on the 26B.
- The 26B gains only +0.7% (3.57 -> 3.60, predicted 3.63-3.65).
  - Its requests with 1 or 2 misses are compute-bound. The card is still on the present
    experts (3.45 MB each) when the last tag lands, so the head's gain moves into the card's time
    after the critical end.
  - That time, from the critical end to the next post, rose 150-200 us a request (1 miss: 4158-4189
    -> 4332-4334 us median; 2 misses: 3187-3223 -> 3382-3394).
  - Requests with 3-4 misses are unchanged (2971-2983 us).
  - serve_emu's card model takes that time per request from the old path's traces, as fixed. It
    misses the overlap, which is why it predicted the 26B's head gain as wall time.
  - The card model since then (`serve_emu.py --card-w`, fit by `card_fit.py w` on the M runs):
    the next post comes no sooner than the critical end + F, nor than the post + W(m) for m
    misses.
    - 26B: F 2.956 ms; W 6.39 / 7.08 / 7.89 ms for 1 / 2 / 3 misses.
    - 35B: F 1.705 ms; W never binds.
    - Checked on the H runs: after the critical end, 4314 / 4255 us (measured / model) for 1
      miss and 3367 / 3300 for 2.
    - W(m) holds the waits of the runs it was fit on, and for the 35B it is not identified (it
      never binds there). For levers that shorten the windows far, the floor is W0 instead:
      the card's own time per request, the median of the requests with no miss (35B 2.47 ms,
      26B 5.70 ms).
    - With next post = max(critical end + F, post + W0), replaying session 16 reproduces A ->
      A' to within 0.04 s:
      - 35B: -1.23 / -0.44 s, measured -1.19 / -0.42.
      - 26B: -0.22 / -0.34 s, measured -0.20 / -0.32.
  - On serve_emu with it (sweep hw1, the card host, the link as above), A -> A' saves:
    - 26B: 0.34 s per 128 tokens, wall 36.52-36.56 -> 36.18-36.22 s. The card saved 0.20-0.32 s;
      the fixed model said 0.59.
    - 35B: 0.56 s, 27.40 -> 26.84. The card saved 0.4-1.2 s.
    - Predictions use it from now on. `tests/test_serve_emu.py` runs the emulator on a tiny
      trace and checks the fit on a made-up run.
    - serve_emu does not run while the card is in use: its lock with a live holder, a live
      runner's status, or a session's quiet file. It checks as runstate's monitors do, without
      taking the lock; `--force` overrides.
- H2C writes during the card's compute: they cost the card ~0.17 s per GB written (gemma4's
  layer-ahead, 13.8). Here A and A' write the same bytes in the same windows, and the 3-4-miss
  requests' time after the critical end did not change, so nothing points at a change in
  contention. The tail (critical end to the poll's return) grew 0.2-0.3 s with the deferred
  touches, but the next post is never sooner than 1.4 ms after it.
- The 35B prefill pair (pooled, R = 2, layer-major, one run each): wall 13.04 (M) and 13.08 s
  (H); demand serve 6.41 and 6.28 s for the same 6241 misses. With one run each, both
  differences are inside the noise. The prompt is bound by the card's runs (12.1-12.3 s), so the
  head's gain cannot reach its wall time. gemma4's 7.10 s demand serve on main (pfahead) came
  from another session's state.

Next, the answer's call (design note, 2026-10-02). With A' it sits on the critical path between
the lead's part and the rest: 43-58 us a request with misses.
- The bound: session 16's H runs, each request's answer call capped by its slack over the
  card's own time (the W model: next post = max(critical end + F, post + W(m)), fit on the M
  runs). That gives 0.22-0.28 s per 128 tokens on the 35B (+0.9-1.2%) and 0.14-0.16 s on the 26B
  (+0.4%), whose 1-2-miss requests wait on the card anyway.
- The card's contract does not order the answer against the data: the card waits on each
  answer word, then on each tag. Only the answer may leave the data's channel. The entries, the
  victims' tag clears and served must stay behind the data on one engine.
- Three ways to take the answer off the path:
  1. A second H2C channel. The current bitstream has only `/dev/xdma0_h2c_0` (read-only check
     on the card host), so this means XDMA's IP with two H2C channels, sharing its AXI master. The
     answer then goes from its own thread on h2c_1 while h2c_0 carries the lead. An IP option,
     no RTL of ours: it could ride in a fused build.
  2. B's window (10.12, parked): a posted MMIO write, ~1-2 us. The same bound, with port H's
     area.
  3. XDMA's poll_mode=1 (a driver parameter: the user's setting). It may cut every call's fixed
     cost, the answer's included, with no bitstream. dma_bench measures it first, after the user
     reloads the driver with it.
- Recommendation: at about 1% on the 35B, (1) only if a fused build has room. Propose (3) to the
  user first, since it is the cheapest to measure.

### 10.14 The link alone (serve_emu, 2026-10-02): lever 2 parked

ld-memch's H2C sweep (docs/host.md 2) measures a placed write call alone: about 30 us of fixed
cost plus 345 us a MiB (~3.0 GB/s), and a 64-byte call at 13.3 us. Run inside a card run, the
same calls cost more (session 16's per-size fit). The serve_emu run on the card host (emu/link1.jsonl,
tree 2ce26c5) replays session 16's runs under three calibrations: session 16's own fit, the link
alone with no --size-cost, and the link alone at 15 us less a data call. All use the card model of
its own compute (--card-w, 10.13), the default v1 path, and a discarded warm run first.

| calibration (emulated time per 128 tokens) | 26B | 35B |
|:--|--:|--:|
| session 16's in-run fit | 36.15 s | 26.96 s |
| the link alone (two runs) | 34.52 / 34.52 s: -1.63 s (-4.5%) | 25.71 / 25.62 s: -1.29 s (-4.8%) |
| the link alone, a data call 15 us cheaper | 34.38 s: -0.14 s more (-0.4%) | 25.40 s: -0.27 s more (-1.1%) |

The first row reproduces session 16's emulation (36.2 and 26.8 s). The repeats differ by 0.005 s
(26B) and 0.09 s (35B).

- Removing the in-run excess entirely is worth about 4.5-4.8%. On the 26B this matches the
  analytic bound (-1.51 s). On the 35B it is three times the analytic -0.43 s, because the
  analytic counted only the data records. The 35B's ~19,000 small calls (answers, entries,
  served) cost 35.6 us each in-run against 13.3 us alone, and that difference is most of its
  excess.
- The excess is the card's DRAM traffic slowing the link while the card computes (13.8's
  contention, on the link's side). The host cannot remove it. B's window writes (10.12; the
  bsweep emulation) gave ~0 on top of A.
- The host's own per-call cost is worth 0.4-1.1% (-15 us a data call). Two calls in flight
  across records (the tag rule: a tag-carrying call only after the call before it returns) is
  not in the emulator.

So lever 2, the host's link path, is parked behind the idle parts' v2 (13.12). It comes back if
a session shows the small calls as the gap.

## 11. Gemma 4 26B-A4B: design note

This is the next MoE target: Gemma 4's MoE, with its experts offloaded to host storage. The
note covers the model, how its layer maps onto `gemma4.py` and `moe.py`, the fit, and the
expected rate. The code waits for review, and is split with the gemma4 agent (below).

### 11.1 The model

From `config.json` and transformers' `modeling_gemma4.py`:
- 30 layers, hidden 2816, vocabulary 262,144, tied embedding, logits soft-capped at 30. No
  per-layer embeddings (`hidden_size_per_layer_input` 0) and no KV-shared layers.
- Attention:
  - 25 sliding layers: window 1024, 16 query heads and 8 KV heads of 256.
  - 5 full layers (every sixth): 16 query heads and 2 KV heads of 512, K = V. A full layer has
    no `v_proj`. V is `v_norm` (unit RMSNorm) of the K projection's raw output; K is
    `k_norm` then RoPE. The cache still holds both.
- Every layer has a MoE block beside a dense MLP. With r the residual after attention:

      dense = post_ffn_norm_1(mlp(pre_ffn_norm(r)))                  2112 wide, GELU-tanh
      w, ids = router(r)
      moe   = post_ffn_norm_2(sum_i w_i expert_ids[i](pre_ffn_norm_2(r)))
      x     = (r + post_ffn_norm(dense + moe)) * layer_scalar

  - The router: unit RMSNorm of r, times `router.scale` and H^-0.5, then `router.proj`
    [128, H], a softmax over all 128, the top 8 renormalized, and each weight times
    `router.per_expert_scale[id]`.
  - Experts: 128 per layer, top 8, width 704, GELU-tanh. The checkpoint stores them fused per
    layer: `experts.gate_up_proj` [128, 1408, 2816] (gate rows first) and `experts.down_proj`
    [128, 2816, 704].
- The checkpoint is 51.6 GB in bf16. The build host has it whole; the card host has the stripped one (11.4).
  The download is the base model: no chat template, so the references use plain-text prompts.

### 11.2 How the layer maps

On `moe.py`'s side (offload) no new card mechanism is needed:
- **The expert slot.** `ExpertFormat` with F padded from 704 to 768. fp4 blocks run 128
  along K, and gemma4's `ffn % 2D` check applies. The padding is zero rows of gate and up and
  zero columns of down, which is exact: gelu(0) * 0 = 0. The expert is 3.45 MB instead of 3.16.
- **Folds at packing:**
  - `per_expert_scale[e]` into expert e's W_down (it scales the expert's output linearly);
  - `router.scale` * H^-0.5 into `router.proj`'s columns.
  The router reads the unit RMSNorm of r, quantized, as `moe_ffn` does for every model.
- **The experts' own input.** `pre_ffn_norm_2`'s gain is not folded: the experts read the
  unit norm times the gain, quantized (`moe_ffn`'s `g_exp`; one `QACT` with column scale,
  8 more instructions a program). With the gain folded into the gate and up columns, the
  experts would read the unit norm quantized, whose blocks are scaled by the residual's
  outlier channels, which the gain all but zeroes (the 26B's layer 10: |x| 17 where the gain
  is 0, the gain up to 92 elsewhere), and the gain's own outliers would set the weights'
  column blocks. On the real model that gave perplexity 127 against float's 1.235 (int8 dense
  layers, fp4 experts; gemma4's emulation), the MoE block's relative error 0.27-0.51 from
  layer 10 on with int8 experts (the dense MLP, which quantizes norm times gain: 0.01-0.04).
  The router keeps the fold: a flipped route costs little. In tests/test_gemma4_moe.py's tiny
  model with 4 channels of the gain at 8x, the int8 device against HF goes from a median
  cosine of 0.977 (folded) to 0.994.
- **The rule.** The softmax rule as written (`MoESpec.rule` "softmax"): the softmax of the 8
  largest logits is the renormalized top 8 of the full softmax. The order is the same, ties to
  the first.
- **`MoESpec.act`.** GELU-tanh in the expert (`swiglu_down(act=gelu_tanh)`, as gemma4's dense
  MLP).
- **`moe_ffn` split into its parts.** It now returns `x + acc`. Gemma needs the experts' sum
  alone (`post_ffn_norm_2` is an RMSNorm of the sum), and wants its dense MLP to run after
  the request is posted, while the host streams. That is section 4's `d_post`, worth +14% in
  the model. So `moe_ffn` takes `beside` (code to emit after the post, before the expert
  loops) and can return the weighted sum without the residual. LFM2's and Qwen3.5's programs
  stay word for word the same.

On `gemma4.py`'s side (gemma4):
- `Spec.from_hf` accepts `enable_moe_block` and `attention_k_eq_v`.
- Global layers get their own KV head count (2 against 8) and K = V. ACT RAM holds 16 x 512
  = 8192 (board: 128 blocks of 128).
- The dense MLP is padded from 2112 to 2304 (`ffn % 2D`), or the check is relaxed to D (2176).
- The layer calls `moe_ffn` with the dense MLP as `beside` and combines the two norms. The
  image places the router weights and norms, and `Layout`'s slots after the rest.
- The generate loop polls the expert server too (qwen3.Engine already wires every server).

### 11.3 The fit and the rate

On the card: the non-expert weights are 1.64 GB (survey, fp4 with the int8 head and
embedding: 761 MB of it) plus 26 MB of dense padding. KV is about 0.2 GB: the 25 sliding
rings of 1024 + a block, 8 x 256, and the 5 full layers at 4096 positions, 2 x 512. With
0.3 GB kept for KV, I/O and programs, the rest holds the slots.

`cachesim.py` replays the four 2048-token traces through the event model, with:
- the per-layer LRU, warmed from the other texts' profile;
- the expert at 3.45 MB (`--expert-bits 4.636`) and the dense MLP's 9.5 MB after the router;
- the link at session 2's 1.4 GB/s, 50 us a DMA call, and a 450 us host lead (the first
  staging in parts plus the poll).

Calibration: the same model with session 2's effective host (staging-bound: 0.99 GB/s, 1.8
ms lead) gives the 35B 2.84 tok/s, against 2.80 measured on the card (device). With the host
as in 10.1 it gives 3.94.

| gemma-4-26B-A4B | slots (per layer) | misses / token (of 240) | MB / token streamed | tok/s | all resident (bound) |
|:--|--:|--:|--:|--:|--:|
| int8 head | 682 (22.7) | 62.5 | 216 | 3.51 | 5.71 |
| fp4 head (`--head-bits 4.25`) | 789 (26.3) | 53.2 | 184 | 4.19 | 6.72 |
| int8 experts (6.69 MB: `--expert-bits 9.0`), int8 head | 351 (11.7) | 107.5 | 719 | 1.55 | |
| int8 experts, fp4 head | 406 (13.5) | 97.0 | 649 | 1.75 | |

int8 experts give half the slots and twice the bytes a miss: under half the rate. The choice
waits for the perplexity of fp4 experts (gemma4's 900-token runs, both heads); a split by layer
range is the middle way (per-layer slot sizes in `Layout`).

- The fp4 head pays twice: 369 MB fewer bytes a token, and 107 more slots. On E2B it is an
  opt-in (cosine 0.974 -> 0.971, +14% decode), and its accuracy on the 26B is to be measured.
- Prefetch still loses here (3.0-3.7 against 3.5-4.2 without).

**The formats, decided (2026-10-01).** gemma4's perplexity matrix on the fixed design (899
positions of Austen, float NLL 0.2109): the dense layers stay int8 (fp4 dense costs +0.075 NLL
on top of fp4 experts), the experts are fp4 (+0.024), and the fp4 head adds +0.009. With int8
dense layers the slots shrink (gemma4.Image at the board's 4 GiB, cap 4096, lookup tables;
dense 1725 MB a token in int8, 911 in fp4). `cachesim.py --dense-mb`, decayed use, no
prefetch, tok/s (*simulated*; the model ran about 15% above the 35B's card at 128 tokens):

| dense / head | slots (a layer) | Gen1 (misses a token) | Gen2 | all resident | ΔNLL |
|:--|--:|--:|--:|--:|--:|
| int8 / int8 | 420 (14) | 2.66 (83.8) | 3.54 | 4.26 | +0.024 |
| **int8 / fp4** | 540 (18) | **3.19 (67.5)** | 4.11 | 4.79 | +0.033 |
| fp4 / int8 | 660 (22) | 3.70 (55.5) | 4.77 | 5.64 | +0.099 |
| fp4 / fp4 | 780 (26) | 4.45 (45.9) | 5.67 | 6.62 | ~+0.108 |

Against the bar of +0.01 NLL for +10%, the fp4 head pays (+0.009 for +20%) and fp4 dense
layers do not (+0.075 for +39%): int8 dense, fp4 experts, fp4 head, 540 slots. On unseen text
(this file's first 900 tokens, float perplexity 10.02; docs/gemma4.md) the choice holds: +0.036
NLL against float, the fp4 head +0.002 of it. `moe_card --wformat int8 --formats experts=fp4
--head-format fp4`; on the card: 11.5.

### 11.4 Host side and plan

- **Host files.** The card host gets a stripped checkpoint (the non-expert weights, about 7.4 GB in
  bf16, 4.8 GB of it the text model's) and a split-format pool (3840 experts x 3.45 MB = 13.2 GB fp4), both made on the build host
  from the whole checkpoint. The RAM tier then reads 13.2 GB into a 31 GB host's page cache.
- **Plan.**
  1. Emulation on the build host (float64 + fake quantization against HF bf16, a few prompts): the
     folds and padding, fp4 against int8 head, greedy tokens.
  2. `moe.py`'s parts (offload) and gemma4's attention and from_hf (gemma4), meeting at a
     tiny random Gemma4-MoE model in tests. The layer composition is checked against HF and
     the ISA simulator bit for bit, the card's side with the live fake card and a split pool.
  3. The full model's ISA-simulator reference on the build host, then a card session: done (11.5).

### 11.5 On the card: session 8

Card session 8 (2026-10-01, production build B, Gen1, main 2a0b962): the decided formats (int8
dense layers, fp4 experts and head), 540 slots (18 a layer) by decayed use, the split pool
warm, 128 tokens after wiki.txt's first paragraph (125 tokens, plain text), twice.

- **Correct.** Both runs gave the ISA simulator's 16 tokens and prefill logits bit for bit
  (`q26ref16`, sha 28a40421a62a0cd2; 77 min on the build host), and the same 128 tokens. HF's bf16
  greedy differs from token 5, where its top two tie at 26.125.

| 26B, 128 tokens | tok/s wall / device | misses a decode token (2nd half) | MB a decode token | link busy |
|:--|--:|--:|--:|--:|
| int8 / fp4 experts / fp4 head | **2.77, 2.77** / 2.77, 2.77 | 68.6 (66.4) | 238 | 21.4 of 46 s, 1.42 GB/s |

- The simulated 3.19 (11.3) is 15% above the card, as on the 35B at 128 tokens (10.4). Gen2's
  4.11 so scales to about 3.5.
- A run: the image 312 s the first time (the int8 layers quantized on the host), 44 s from the
  cache; prefill 47 s (a token a step, 125 of them); 128 tokens 46 s.
- **The DMA guard** (`XdmaTransport`'s lock, main 2a0b962: no host->card call overlaps a
  card->host one). The server's polls never wait on it: every poll reads with `BoardDram`'s
  queue drained (`poll` flushes before it returns). The lock costs 1.8 us a DMA call on the card host
  (flock on tmpfs 1.4, the thread lock 0.4). The polls' reads took 33 us against session 7's
  25; the lock is 2 us of that, the rest is unexplained (the host had rebooted; the XDMA
  options are the same). Two reads a request, at 12.6's 1.5% for each 100 us: about 0.25%.
- **The page cache between models.** A 35B run after the two 26B runs gave session 7's tokens
  at 1.70 tok/s against 3.84: 8.7 of its 17.1 GB pool in the page cache at decode (16.5 in
  session 7). The 26B pool's pages, read twice, outlived the 35B's, read once by the warm-up,
  so staging read the disk (49.9 s against 6.6). The card scripts now drop the other pools
  (`posix_fadvise` DONTNEED) before the warm-up.

## 12. Router hints: prefetch from the layer's input

Section 5.4 measured prefetch not to pay under LRU slots. With the slots replaced by decayed
use (section 5.5), one variant does: before its mixer, each MoE layer runs its router on the
layer's input (`pre`, section 3) and posts the k best as a hint. The host moves the missing
ones on the link's idle time. The card then routes as before, and the experts it names are on
their way, or in, by the time it asks. `MoESpec.hint` turns them on (`moe_card.py --hints
on`). They are off by default: on the card they lost 5% (section 12.5).

### 12.1 What it buys

`cachesim.py`'s event model (section 11.3's calibration: 2.84 against 2.80 tok/s in session 2,
3.94 against 3.87 in session 3), Qwen3.5-35B-A3B, slots by decayed use, tok/s (simulated):

| 35B | link | without | with hints (`pre`, k best) |
|:--|:--|--:|--:|
| 1280 slots (the table on the card) | Gen1, 1.4 GB/s | 4.15 | 4.42 (+6.5%) |
| 1560 slots (the table on the host, 5.9) | Gen1 | 4.41 | 4.69 (+6.3%) |
| 1280 slots | Gen2, 2.8 GB/s | 5.52 | 5.74 (+4.0%) |
| 1560 slots | Gen2 | 5.75 | 5.93 (+3.1%) |

Per token at 1280 slots, Gen1:
- demand transfers go from 100.7 to 93.9;
- 23.0 hinted experts land, 10.5 of them unused before they are replaced;
- the link goes from 52% to 70% busy.

Why it pays now and did not under LRU: a hinted expert holds no use until a request names it,
so the next miss in its layer replaces it first. A wrong hint costs one slot for a while, not
the least recently used expert, which LRU replaced with it (raising the misses: 33 of 49 hints
wasted, 110 demands a token). The k best are enough; 2k waste more than they catch.

The model gives Gemma 4 26B-A4B nothing from `pre` (3.79 against 3.78 at Gen1, 682 slots) and
2% from `prev_r` (the next layer's router at the end of this one). The hint stays off there.

The card's own cost, not in the model: one more router per MoE layer (the 35B's: an RMSNorm, a
257 x 2048 int8 MM of 0.5 MB, k `ARGMAX`, a post), about 50 us, 2 ms a token (0.8%;
*estimate*).

### 12.2 The card

`moe.moe_hint`, per MoE layer before its mixer:

1. **The k best.** The RMSNorm of the layer's input with the router's norm gain, `QACT`, the
   router MM, and the k best by the model's rule: the route's `ARGMAX` knock-out loop, without
   the weights.
2. **The post.** The global ids plus G = layers x E (an id at G or above marks a hint), as a
   request: `WAITW served GE seq`, the ids, `seq + 1`.

Then the mixer, then the route as before (section 5.2). The route's fence waits for the hint's
`served`, which the host writes once it has given the hinted experts their slots, before any
of their bytes move. A hinted expert still on its way reads as missing (present 0), and the
card's `WAITW NE 0` on its entry waits for it as for any miss.

No ISA change and no new word: the same mailbox, row and `served`, and one register, as the
route. The generate program's layer loops hold the hint's code once per layer kind. The
programs of every model without hints are unchanged (sha256: E2B, E4B, LFM2.5-8B-A1B, the
26B, the 35B with hints off, the tiny MoEs).

### 12.3 The host

`ExpertServer.hint`, for a request at G and above:
- each named expert not in a slot gets one at once: a free slot, or the victim (least decayed
  use, never one the hint names), its entry cleared;
- the expert joins `pending`, its bytes not moved yet; no use is counted, so a hinted expert
  no request names is its layer's next victim;
- then `served = seq`.

`ExpertServer.step`, from a poll that finds no request: the next part (512 KiB) of the oldest
pending expert, one DMA call per channel, and its entry when the last part is in. The poll
waits for that part (BoardDram's flush) before it returns, as for a request, so no DMA of the
server's is in flight while anything else uses the card. A request waits for at most the part
on the link, 0.37 ms at Gen1 (the model's preemption at the next chunk).

A request (`serve`):
- naming a pending expert: the rest of it at once, then its entry (a miss, `promoted`);
- missing an expert: a victim as before, which may be a pending expert (`dropped`: what was
  sent of it is lost, and its entry still reads 0).

BoardDram's staging pairs take a part in their first bytes (a part and an expert alternate
without new buffers); a split-format pool's part is its own blocks (`SplitRecord.part`).

The "lru" policy answers a hint with `served` alone: an LRU victim of a wrong hint is a recent
expert (section 5.4).

**Race-freedom.** The card uses layer j's slots between its route's fence and its next fence
for layer j, a token later. The hint for layer j comes before the route's fence, so the host's
hint work (victims, cleared entries) is done when the fence passes (`served` covers it), and
the card reads present flags only after. A hinted expert's slot is written only while its
entry reads 0, by idle steps or by the request that names it; its entry is set after its last
byte (BoardDram's one queue).

### 12.4 Tests and status

- `tests/test_offload_server.py`: a hint's slots and cleared entries at once, its parts on idle
  polls and its entry after the last; a request sending the rest of a pending expert, or
  replacing one; "lru" ignoring hints; BoardDram's writes of hinted parts equal to Board.write's
  (the bytes and split formats, with and without CHASH).
- `tests/test_qwen35_moe.py`: the tiny Qwen3.5-MoE with hints, k + 1 slots, gives the logits and
  the card's generated tokens of the same engine without hints bit for bit (ISA simulator,
  which calls the host only when the card waits: 96 hints, 107 hinted experts sent when the
  route named them). On the live fake card (CHASH, a split pool, the embedding table on the
  host: one BoardDram for the experts and the rows, 64 KiB parts) the hinted experts land on
  idle polls (84 hints, 102 landed, 4 misses against 101 without hints), and the logits and
  tokens are the ISA simulator's with the table on the card and no hints.
- `test_hints_are_off_by_default`: `Spec.from_hf`'s programs are those of `hint=False`. The
  35B's default program is the one with the table on the host and no hints.
- `tools/offload/program_sha.py CFGDIR [--cfg card.pkl]` gives the programs' sha256 from the
  configs alone, under `isasim.board_config()` or the card's configuration (`--cfg`: PAIR,
  DSTEP, STREAM on). moe-pair (main d29bfe9: the experts' 4-bit MMs paired) changed every MoE
  program under the card's configuration and none under `board_config()`, whose PAIR is off;
  moe-prefill (the count word) and fmt-b2 (Qwen3.5's and LFM2's layer blocks moved) changed the
  MoE programs under both, the logits bit for bit the same:

| programs | before moe-pair (7d879e6), card's | d29bfe9, card's | main f81070d, card's | main f81070d, `board_config()` |
|:--|:--|:--|:--|:--|
| LFM2.5-8B-A1B fp4 / int8 head, 28 slots | a8a77ef7dd5d9e68 | f3ee4b46b30a02c8 | b6fa581f65694d84 | 48f9128881c9a8e3 |
| Qwen3.5-35B-A3B fp4 / int8 head, 32 slots (default: the table on the host) | 98bd49dd45aea3ef | 2fa1b39f30cbae74 | 397058f4f6fa4fee | fd3f913e1fdb8e75 |
| the same, the table on the card | 6a4ec5701cd4dbbe | a76315cf6f7fbad3 | 591e5a7857d67298 | 24d53322fc433629 |
| gemma-4-26B-A4B fp4 / int8 head, 22 slots | ae48f2854896caed | 0d547648a5f4815b | 9f227c517759b907 | 5df28254c5c3e5e3 |
| gemma-4-26B-A4B int8 / fp4 experts / fp4 head, 18 slots (the card's) | a67dd5bb5e3d4dee | 48151736927d3e35 | b593ab41215a2883 | d913f5e18b657a20 |
| gemma-4 E2B, E4B (dense) | 01b705bf299ef984, f8547a57b9f6b3c2 | the same | the same | d511a6d7a138c7e3, 24be53bc4e6094a4 |

(Before moe-prefill the 35B's default under `board_config()` was 862438adb0e68f58.)

### 12.5 On the card: session 5

Card session 5 (2026-10-01, production build B, Gen1): the 35B, 16 tokens, slots by decayed use
filling the DRAM, the full pool (all 10240 experts) in the split format. Each run gave the ISA
simulator's tokens and prefill logits bit for bit (`q35ref16`).

| run | slots a layer | tok/s wall / device | misses a decode token (2nd half) | MB a decode token |
|:--|--:|--:|--:|--:|
| session 4: table on the card, 32 slots | 32 | 3.95 / 4.04 | 93.5 (106.6) | 147 |
| table on the card | 34 | 3.24 / 3.29 (cold page cache) | 89.5 (101.9) | 147 |
| table on the host (5.9) | 42 | **4.23 / 4.33** | 79.2 (89.9) | 130 |
| table on the host, hints | 42 | 4.02 / 4.11 | 79.8 (90.8) | 152 |

- The table-on-the-card run had a cold pool: 12.3 of the pool's 17.1 GB were in the page cache at
  open, right after the pool's fill. Its staging took 1.72 s against session 4's 0.68 s. The
  card scripts now read the pool before each timed run and log its residency.
- The hints named the right experts, but too late. Of the hinted experts not in a slot, 474
  landed on idle polls before their request, 3112 were sent only when the request named them,
  and 629 were replaced before they landed; 77% of the misses had been hinted. The wrong hints
  added 22 MB a token on the link. The model's gain needs the link idle between a hint and its
  request; on the card there is little, and the oldest pending expert (often another layer's
  unrequested hint) goes first.
- So hints are off by default. Two host-side variants are next: a request withdrawing its
  layer's hinted experts it does not name, and 128 KiB parts. They come back on only when one
  beats the table on the host without hints on the card.

### 12.6 Session 6: the variants, and the host's timeline

Card session 6 (2026-10-01, build B, Gen1): the 35B, 16 tokens, the pool read into the page
cache before each run (17.11 of 17.11 GB resident). Each run bit for bit as the ISA simulator's.
`ExpertServer(drop=True)` (`moe_card --hint-drop`): a request withdraws its layer's hinted
experts it does not name that have not landed; `--hint-part` sets the part; `--hint-trace`
writes the decode's timeline (when each hint, request and part was seen and done).

| run | tok/s wall / device | misses a decode token | MB a decode token |
|:--|--:|--:|--:|
| table on the host, no hints (session 5's run again) | 3.78 / 3.86 | 79.2 | 130 |
| + hints, 512 KiB parts | 3.97 / 4.06 | 79.8 | 152 |
| + hints, drop | 4.11 / 4.21 | 80.9 | 136 |
| + hints, 128 KiB parts | 4.04 / 4.13 | 80.0 | 147 |
| + hints, drop, 128 KiB parts | 4.21 / 4.30 | 80.9 | 134 |
| table on the card, no hints (warm) | 4.11 / 4.20 | 89.5 | 147 |

- **Noise.** The same run as session 5's 4.23 / 4.33 gave 3.78 / 3.86: the same misses and
  bytes, the host's serving 1.10 s against 0.64 s. At 16 tokens the host's variance is about
  6%, as large as every difference here.
- **The timeline.** The host sees a request 1.2-1.4 ms after it served the layer's hint (the
  mixer's time). A 512 KiB part takes 0.61 ms from poll to flush (0.86 GB/s: the poll's read,
  the staging and the wait), a 128 KiB one 0.28 ms. So less than one 1.67 MB expert moves
  before its request: with drop no hinted expert landed early (all 3160 sent on request), and
  drop only saves the link's time on wrong hints. The event model assumed the link's full rate
  for parts and found +6.5%; the card cannot get there with synchronous parts in the mixer's
  1.3 ms. Hints would need asynchronous parts and an earlier post (the next layer's router at
  the end of this one, `prev_r`); parked.
- **The polls' reads.** 9663 reads took 0.87 s, 90 us each: Board.read fetches a whole 128-byte
  chunk, one c2h call per channel. `BoardDram.read` now reads bytes within one 64-byte beat (a
  seq, a request's row) as that beat alone, one call. The event model gives about 1.5% tok/s
  for each 100 us the host sees a request sooner (35B, 1680 slots, Gen1: 4.66 / 4.52 / 4.39
  tok/s at 250 / 450 / 650 us). Next steps for the latency, in order:
  1. one read for both mailboxes (the row server's beside the expert server's: an image layout
     change);
  2. spinning without the 50 us sleep while a request is due;
  3. a future bitstream: the card writing its request's seq where the host sees it without a
     DMA read (a doorbell register or an MSI), so that the host waits on no read at all.

### 12.7 Capped hints (offload-hintcap)

Since session 6 the request's path changed (designs A and A', 10.11 and 10.13), the link runs at
Gen2 (2.29 GB/s: a 1.67 MB 35B expert in 0.73 ms), and a hinted expert can go as one DMA call.
Session 6's timeline has its request 1.6-1.7 ms (median) after a hint is seen: room for one
expert, not for every hinted one. Capped hints send only the best:

- `ExpertServer.hint_n` and `hint_top` (moe_card `--hint-n`, `--hint-top`): of a hint's first
  hint_top ids (its router's best first), the first hint_n not in a slot get one. The others get
  nothing: no slot, no eviction. 0, the default, leaves a hint uncapped, as before. Hints stay
  off by default.
- The slot is still taken at the hint, not when the expert's first part goes (as ahead_layer's
  queue does in a prefill). In decode the victim is one of the hinted layer's own slots, and the
  card posts that layer's request as soon as served covers the hint, then reads the entries of
  the ids it names. The victim's cleared entry has to go before served, or a request naming the
  victim could read its old entry while its slot is overwritten. ahead_layer can wait because
  its victims are outside the two layers the runs read.
- `cachesim.py --prefetch PRED:TOP:N` replays this offline (`prefetch`: the server's capped
  hints, each landed before its request; test_offload checks it against ExpertServer, miss for
  miss). Tests: test_offload_server (the caps), test_qwen35_moe (the live card with caps 1 / 1
  bit for bit, and moe_card's `--hint-n` / `--hint-top` end to end).

Offline, on the four 2048-token traces: lfu_layer at the card's slots, each text warmed by the
other texts' profile. A prefetched expert takes the slot of least decayed use and gets no use,
so a wrong one evicts an expert a later request may want; that cost is in the misses. `pre` is
the layer's router on its input (the hint programs' post), `prev_r` the router on the layer
before's output (a layer ahead).

| prediction, top, n | 35B (1680 slots): misses a token | sent | precision | 26B (540 slots): misses a token | sent | precision |
|:--|--:|--:|--:|--:|--:|--:|
| none | 84.0 | | | 67.5 | | |
| pre, 4, 1 | 66.4 (-20.9%) | 20.7 | 0.88 | 49.8 (-26.3%) | 20.8 | 0.89 |
| pre, 4, 2 | 59.6 (-29.0%) | 29.9 | 0.85 | 41.4 (-38.6%) | 32.3 | 0.85 |
| pre, 8, 1 | 58.7 (-30.1%) | 34.6 | 0.76 | 45.9 (-32.0%) | 27.7 | 0.82 |
| prev_r, 4, 1 | 70.9 (-15.6%) | 22.4 | 0.64 | 54.0 (-20.1%) | 19.0 | 0.78 |
| prev_r, 4, 2 | 66.4 (-20.9%) | 33.1 | 0.59 | 48.6 (-28.0%) | 28.7 | 0.73 |

The time per 128 tokens comes from session 16's runs of A' through the W0 card model (10.13),
each saved miss taken off its request's critical window. Every byte sent while the card computes
costs it 0.13-0.18 s a GB of compute (13.8's contention):

| prediction, top, n | 35B: misses | contention, 0.13 / 0.17 s a GB | net at 0.17 | 26B: misses | contention | net at 0.17 |
|:--|--:|--:|--:|--:|--:|--:|
| pre, 4, 1 | -2.09 to -2.15 s | +0.58 / +0.75 s | -1.34 to -1.40 s (+5.8 to +6.0%) | -4.72 to -4.74 s | +1.19 / +1.56 s | -3.16 to -3.18 s (+9.9 to +10.0%) |
| pre, 8, 1 | -3.01 to -3.10 s | +0.96 / +1.26 s | -1.75 to -1.84 s (+7.7 to +8.0%) | -5.68 to -5.72 s | +1.59 / +2.08 s | -3.60 to -3.64 s (+11.5 to +11.6%) |

At n = 2 a second expert no longer fits the window, and its contention takes most of the gain.
`prev_r` nets less than `pre` at every setting.

Two costs are not in the table. The hint's own card time: each MoE layer reads its router again
(int8, 257 x 2048 bytes; 21 MB a token over 40 layers, about 0.2 s per 128 tokens at the
decode's DRAM rate). And its post waits for served, which the host writes inside the mixer's
window. So the 35B's prediction is about +5% (-1.15 to -1.2 s) with top 4 and about +7% with
top 8. Contention is the main uncertainty: at twice the measured rate (0.34 s a GB) top 4 nets
about +1.6% and top 8 about +1.2%, under the 2% rule below.

The card A/B (session 17, in one lock with the re-baseline on the fused build and LFM2-8B's
token-exact check): q35e128s (no hints) and q35e128hn (pre, top 4, n 1) A B A B, then one
q35e128hn8 (top 8) if the slot allows. Each run is checked against the ISA simulator's run of
its own programs: q35ref16 without hints, q35ref16h with them and the caps. Hints become the
35B's default only if top 4 gains at least 2% over the same lock's base with every run bit for
bit. The 26B has no decode hint programs (a gemma4.py change), so they wait for the 35B's
result.

### 12.8 An expert landing as its request is posted

The card posts a request, then reads the present flag of each id it names; a missing one's
slot comes from the request's answer word, which the host writes only for the ids it serves as
misses. An idle poll reads seq, finds no request, and lands a hinted (or ahead_layer's) expert:
its last part with the tag, then its entry. If the card posts a request naming that expert
after the poll read seq, it can read the entry before it lands, as missing, and wait on its
answer word, while the host, at the next poll, finds the expert landed and serves it as a hit:
answer word 0, and the card's WAITW never holds. Two polls later the race is over (the poll
between read seq after the entry had landed).

Only idle polls land experts, and only hinted experts (`MoESpec.hint`, the hint programs:
moe_card `--hints on`) and ahead_layer's queue (`Engine(layer_ahead=...)`, `--layer-ahead`) go
on idle polls; the default paths (hints off, no layer ahead) never had a pending or queued
expert, so they were never exposed. Exposed and passing by timing: card sessions 5-6 (the
decode hints, 16 tokens, most hinted experts sent on request), pfahead, pfhint and pfhint2
(the layer ahead).

Found by a hang of the live fake card (test_qwen35_moe's hints test under load, 2026-10-02:
`WAITW ... wait: its slot (the answer) never holds`). Capped hints make it likelier on the
card: a whole expert lands about 0.9 ms after its hint, the request comes 1.6-1.7 ms after.
The fix, host only: `poll` keeps the experts the last idle poll landed (`_fresh`); the request
served in the next poll names their slots in its answer too (`late`), and writes the answer
even with no miss. Their tags landed with them, so a card that read the entry as missing finds
its slot and its data; one that read it present never reads that answer word, and zeroes the
answer after its experts as always. test_offload_server's
`test_an_expert_landed_in_the_poll_before_a_request_is_answered` posts the request right after
the landing poll's read of seq; on the server before the fix its answer word is 0.

### 12.9 Session 17: capped hints on the card (the default stays off)

One otpu-lock, 2026-10-02 13:22-13:43 opentpu.
- Build and tree: production fmvf 542fc43a; tree offload-s17 2ce26c5 (b16071b with 12.8's fix).
- Length: 128 tokens.
- References: every run bit for bit against the ISA simulator's run of its own programs. The
  hinted runs used q35ref16h, computed on the build host for this tree with the caps.
- Order: a discarded warm-up run of each model's base, then the 35B in A B C C B A. A is
  q35e128s; B is q35e128hn (pre, top 4, n 1, whole-expert parts, --hint-drop); C is
  q35e128hn8 (top 8).

| run | tok/s | misses a token | serve s | hinted landed | link GB | requests with misses (host, seen to served) |
|:--|--:|--:|--:|--:|--:|--:|
| W (warm-up) | 5.28 | 102.85 | 6.02 | | 21.91 | |
| A1 / A2 | 5.31 / 5.29 | 102.85 | 5.99 / 6.09 | | 21.91 | 4649, 12.79 / 12.69 s |
| B1 / B2 | 5.34 / 5.37 | 80.09 / 80.06 | 4.66 / 4.69 | 3945 / 3944 | 22.68 | 4350, 10.18 / 10.06 s |
| C1 / C2 | 5.43 / 5.29 | 73.94 / 73.96 | 4.32 / 4.48 | 5557 / 5559 | 23.69 | 4018, 9.08 / 9.38 s |

- B against A: +1.0%, with pairs +0.6% and +1.5%.
- C against A: +1.1%, with pairs +2.3% and +0.0%.
- Both are under the 2% rule, so the 35B's default stays off, and the 26B's hint programs
  (gemma4.py) are not raised.

The misses fell as predicted: -22% for B (cachesim -20.9%) and -28% for C (-30.1%). Time is
from the host's timeline (`--hint-trace`). For each run, the run's span minus its requests' seen
to served time gives the time the card was not waiting on a request:

| | A | B | C |
|:--|--:|--:|--:|
| card not waiting on a request | 11.29 s | 13.66 s | 14.53 s |
| change against A | | +2.37 s | +3.24 s |
| request time saved against A | | -2.6 s | -3.5 s |

So nearly all of the saved request time went back into the card's own time. Estimated, for B:
- Contention: the hinted experts go while the card computes, about 3,900 whole experts and
  6.6 GB. At 13.8's 0.17 s a GB that is about 1.1 s of card time.
- Requests behind a part: an idle part (one whole expert) takes 1.17 ms (3.93 s in all), and
  a request posted during one is seen after it. That is about 0.5 s.
- The hint polls: 5120 polls at 0.21 ms each, 1.06 s of host time. Part of it is behind the
  mixer and part delays the next post's fence.

Contention and the requests behind a part come to about 1.6 s of the 2.37 s. The other ~0.8 s is
about three quarters of the hint polls' 1.06 s. Per token: about 20 ms of requests' time saved,
against about 12.5 ms for the parts and about 6 ms of the hint polls, which leaves the measured
~2 ms (+1.0%). 12.7's prediction left out the requests behind a part and the hint polls' own
time.

What would change the balance:
- v2 idle parts (13.12: one call each, read ahead, halt-aware) shorten a part and the wait
  behind one, but not the contention.
- A cheaper hint poll: its seq and row reads, then served, are about three DMA calls.
- Hinting only where a miss costs more than a sent expert does.
For now, hints stay opt-in.

The other runs, all bit for bit:
- The 26B base: 3.68 tok/s three times (warm-up, A1, A2), serve 8.66-8.68 s, 88.09 misses a
  token.
- LFM2-8B-A1B from /dev/shm, token-exact against its refs: 8b16 at 13.53 tok/s, 8b160 at 14.95
  tok/s.
- The 35B's warm-up ran 0.6% under A1 (gemma4's pfhint2 saw 5% on a prefill).

### 12.10 Hints: closed (off)

The 35B decode hints (top 4, n 1, whole-expert parts, `--hint-drop`) against no hints, on the
card:

| session | parts | pairs | mean |
|:--|:--|:--|--:|
| 17 (12.9) | v1 | +0.6%, +1.5% | +1.0% |
| 17 (12.9), top 8 | v1 | +2.3%, +0.0% | +1.1% |
| pfv2 (13.12) | v2, the hold not acting | +0.09, +0.13 tok/s | +2.09% |
| 18 (13.12) | ra | +0.030, +0.130 tok/s | +1.51% |
| 18 (13.12) | v2, the default | +0.010, +0.080 tok/s | +0.85% |

On the default parts the gain is +0.85%, under the 2% bar, so the hints stay off and are
closed.

The misses fall as predicted: -22% (102.85 to about 80 a token). It doesn't pay, because the
time saved on requests goes back into the card's own time (12.9's split for session 17):
- Contention: the hinted experts, about 3,900 a run and 6.6 GB, go while the card computes,
  at 13.8's 0.17 s a GB. That is about 1.1 s.
- The hint polls: about 1 s of host time, partly in the card's path.
- Requests seen behind an idle part: about 0.5 s with v1's parts. v2 shortens a part, but it
  cuts neither the contention nor the polls.

What could reopen them: hinting only where a miss costs more than a sent expert does, or a
hint poll of fewer DMA calls.

## 13. Layer-major prefill

Today a prompt runs token by token through the decode step. Each token's MoE layers ask for
their k experts with per-layer slots, so the prompt pays decode's miss rate: 69 misses a token
for gemma-4-26B-A4B, 183 s to the first token of a 512-token prompt at Gen1 (the event model
below; the card measured 361 ms a token in session 8, the model 357). More rows a program
(token-major, R rows through every layer) barely helps: 18 slots a layer hold about one row's
union, and 4 rows' union is already 18.2 experts.

Layer-major runs the whole prompt chunk through one layer before the next. Only one layer is
active, so every slot can serve it; the chunk's union per layer is nearly all its experts, each
brought once and used by every row that chose it.

### 13.1 The bound

`ttft.py`'s event model (scratchpad): the router traces of four texts, the card's times
co-simulated (`tools/moe_prefill_cosim.py`: RTL + LiteDRAM, 133.33 MHz, DDR3-1066, build B's
MCOLS 4 / PAIR / DSTEP / STREAM), the link at its measured 1.42 GB/s, 50 us a DMA call, a
request's 450 us lead and 0.42 ms of host time a miss (fitted so that R = 1 matches the card:
26B 357 against 361 ms a token, 35B 255 against 259). TTFT of a 512-token prompt, Gen1:

| | 26B | 35B |
|:--|--:|--:|
| today (token by token, experts unpaired) | 183 s | 131 s |
| token-major, R = 2 / 4 / 8 | 1.36 / 1.48 / 1.59x | 1.46 / 1.59 / 1.64x |
| layer-major, R = 1 / 2 / 4 | 1.91 / 2.95 / 3.97x | 2.19 / 3.11 / 3.55x |
| layer-major misses a token | 5.4 | 14.2 |

Layer-major then gives the decode slots back (a restore: 1.6 s for the 26B, 2.7 s for the
35B, in the table). With every slot one layer's (pooled), R = 1 already halves the TTFT: the
link stops being the bound, and the MoE runs at the card's rate.

### 13.2 The card

`Image.compile_layer_run(li, blocks, block, R)` (gemma4.py): one program for R rows through
layer li, at run-time positions (`RunPos`: the first row's position and its row in the chunk
are run arguments). The chunk's rows live in DRAM (`xbuf`, the image's prefill rows); a run
loads its R rows, runs attention (each row its own position, rope row and mask pair) and the
MLP, and stores them back. With R > 1 the chunk's embedding rows come first (one embed run a
token); with R = 1 layer 0 gathers its row itself. After the last layer, `compile_prefill_head`
runs the final norm and LM head on the chunk's last row. A run stays inside one attention
block (the host splits runs there), so the token-index tiles stay static.

Qwen3.5-MoE (qwen35.py, the same entry points): a DeltaNet layer of R rows is
`_deltanet_rows` (its state steps row after row, by DSTEP on the card), an attention layer
`_attention_rows` at run-time rows (`RunPos.offset`: row r's position and mask row from the
run's), a row alone the decode step's layer. From position conv_k - 1 on, every position
reads the whole convolution window, so one program serves them all; the first conv_k - 1
rows of a sequence run at compile-time positions, from their embedding rows. The embedding
rows come from the host's table as in decode (the host writes each before its run).

`moe.moe_ffn_rows` is the MoE layer on R rows (section 5.2's route, R times):
1. each row routes as moe_ffn's (the router, the k best, the weights): R x k global ids;
2. one request: the fence, the R x k ids to the row (repeats included), their count to
   mbox + 4, seq + 1; then the part beside the request (Gemma's dense MLP);
3. the union, on the card: for each row q, `eq = 1 - min(1, |id - id_q|)` against all R x k
   ids; an id is the union's at its first place, and every later place is a repeat;
4. each union expert once, on all R rows (present first, then the misses, as moe_ffn), its
   R outputs stored unweighted to each row's (row, rank) place in a DRAM scratch of
   [R k + 1, H]; a row that did not choose the expert stores to the sink row;
5. each row sums its k outputs times its weights in its router's order, then the shared
   expert and the residual.

So each row's result equals moe_ffn's bit for bit, whatever the slots held. R x k <= 16: the
request is one line. Build B runs a 4-bit MM paired at <= 2 rows; 3-4 rows run at half rate,
so R = 2 is the point for 4-bit experts until the TMEM layout for R = 4 is done.

### 13.3 The request

`mbox + 4` holds the request's count of ids as a float. Every post writes it: moe_ffn and
moe_hint write k, moe_ffn_rows writes R x k. The host reads seq and the count in one 8-byte
read, takes that many ids from the row, drops repeats in order, and reads 0.0 as k (images made
before the count). For R = 4 (32 ids) a second line holds ids 17-32: `row2`, the 128-byte block
after the directory (outside BoardDram's shadow of the host's words), in a layout built with
`Layout.build(..., lines=2)`; the card writes the ids, then the count, then seq, and the host
reads `row2` when the count is over 16. `lines=1` leaves every address as before, so R = 4
needs no protocol change and today's images do not move. The no-overlap invariant holds: the
card's fence (WAITW served >= seq) comes before every post, and the host flushes each request's
DMA before its next poll.

### 13.4 The host

`Engine(layer_major=R)`: `prefill` of sequence 0 goes to `prefill_layers`, which runs each
chunk of the image's prefill rows layer by layer, runs of `min(R, rows left, rows to the
block's end)`, then the head run, and reads the logits. Programs are compiled once per (layer,
blocks, rows). `moe_card.py --layer-major R` runs it on the card. With per-layer slots R = 2
runs (16 ids <= 18 slots), at token-major's miss rate.

The pooled slots are the expert server's, host only: the card reads an expert's slot from its
directory entry, whichever layer the slot was laid out for. `ExpertServer.begin_prefill()`
before the first layer run: a missing expert takes a free slot of any layer, else the slot of
the least recently used expert of any layer the request does not name (in layer-major order a
finished layer's), its entry cleared. `end_prefill(restore)` after the last run's request:
each layer gets its own number of slots back, keeping its experts of most decayed use up to it
(the others leave, their entries cleared); "lazy" (the default) leaves the free slots to
decode's misses, "eager" loads each layer's experts of most use in the prompt. Both run between
polls, with the server flushed. `Engine.prefill_layers` calls them around the layer runs (before
the first, then once the last has halted, before the head run): `Engine(pooled=True,
restore="lazy")` by default, `moe_card.py --per-layer-slots` for each layer's own.
`test_moe_pooled_slots_cut_the_prompts_misses` (test_gemma4_moe.py, lazy and eager): pooled
against per-layer slots, the same logits and decode steps bit for bit, under half the misses.

Lazy, by cachesim.py's event model (11.3) on the traces (four texts, two 512-token prompts each,
then N tokens of decode by decayed use; the 26B as on the card, 540 slots, the 35B 1680; Gen1
1.4 GB/s): eager's restore loads 443 experts (26B) / 1312 (35B), and the next tokens use too
few of them to pay it back.

| | eager: restore + N = 16 / 128 | lazy | lazy + the eager set as idle-link prefetches |
|:--|:--|:--|:--|
| 26B | 1.21 + 5.23 / 1.21 + 42.54 s | **5.94 / 43.31 s** | 5.92 / 43.29 s |
| 35B | 1.63 + 3.65 / 1.63 + 28.91 s | **4.33 / 29.68 s** | 4.38 / 29.74 s |

Lazy's decode starts with fewer of each layer's experts (26B: 84 against 67 misses a token over
the first 16), and pays about 0.7-0.8 s for it in all, less than eager's restore; the
prefetches find little idle link time beside decode's misses. The pooled prefill misses 5.4
experts a prompt token on the 26B, 15.1 on the 35B.

The layer ahead (`ExpertServer.ahead_layer(j, ids)`, gemma4's prefill schedule, 2026-10-02).
While one layer's runs go, the link's idle polls stream the next layer's experts, most wanted
first (a profile's order), so its runs find them in slots:
- `begin_prefill(ahead=True, part=...)` turns it on for the prefill. `part` is the bytes an idle
  poll sends of an expert, and end_prefill gives the server its own part back.
- `prefill_layers` calls `ahead_layer` only between runs: once after begin_prefill for the first
  MoE layer, then before each layer's first run of a chunk for the next one.
- Each call serves the card's last request first (`settle`) and stops arming that request's
  tags, since the halted run zeroed them.
- Each call replaces the last one's queue. Queued experts without a slot leave the queue. An
  expert already on its way is dropped and its slot freed; its tag and entry were never written.
  On gemma4's event model of the pooled R = 2 traces this beats keeping a FIFO at short prompts,
  where the queue would fill with layers that have already run.
- A queued expert takes a slot only when its first part goes, so a call that is replaced
  evicts nothing. It takes a free slot, else (pooled) the oldest expert outside layers j - 1 and
  j. Those are the only layers the runs until the next call can read: no slot the running layer
  may use changes under it.
- A request that names a queued expert takes it as a miss. A request that names one on its way
  sends its rest with its tag (promoted), as for a hint.
- `end_prefill` drops the queue and the expert on its way.
- A hint for the queue's layer adds its ids to the end of the queue, in arrival order. This is
  the card's own router on the layer before it, gemma4's predictor (13.9).
  - Each id is added once, and only if it is in no slot, not on its way and not queued.
  - The append takes no slot and evicts nothing; each expert takes a slot when its first part
    goes, as before.
  - The hint is served as any hint.
  - A hint for any other layer is ignored, as with pooled slots before. `hinted_ahead` counts
    the ids added.
- Without pooled slots, only free slots are used.
- Tests: test_offload_server's ahead tests: idle-poll landing in order, replace, promote and
  miss, victims outside the running layers, settle and end_prefill, and a hint's append.

### 13.5 Tests and status

`test_moe_layer_major_prefill_is_bit_exact` (test_gemma4_moe.py): a tiny Gemma 4 MoE, 262
tokens in chunks of 100 (a chunk crossing an attention block), int8 R = 1, fp4 R = 1 and 2,
int8 R = 4 (k = 2): the logits, the KV cache and the DRAM from layer 0 to the head equal
token-by-token prefill's, and three decode steps after it.

Co-simulated layer runs, the 26B at position 256 (RTL + LiteDRAM, 133.33 MHz; a zero image, so
every row picks the same 8 experts):

| layer | R = 1 | R = 2 (union 8) |
|:--|--:|--:|
| sliding | 6.13 ms | 7.30 ms |
| global | 6.69 ms | 7.47 ms |

With R = 2's real union (about 12 experts a run) that is about 4.1 ms a row, about 65 s to
the first token at Gen1 against 183 s (2.8x; R = 1: about 96-101 s, 1.8-1.9x), with the pooled
slots.

On the card (2026-10-01, build B, Gen1, `tools/offload/sessions/layer_major.sh`, tree 678b976):
the 26B as session 8's g26a (int8 layers, fp4 experts and head, 18 slots a layer by decayed
use), 16 tokens after wiki.txt's first paragraph (124 prompt tokens), its prompt three ways.
All three give the same prefill logits (sha256 90e6b6e06e19da99) and the same 16 tokens, HF's
greedy ones; decode 2.53 tok/s each. With per-layer slots (not pooled):

| prompt | prefill | requests | misses in the prompt |
|:--|--:|--:|--:|
| token by token (g26t16) | 45 s (363 ms a token) | 3720 | 9252 |
| layer-major R = 1 (g26lm1) | 44 s | 3720 | 9252 |
| layer-major R = 2 (g26lm2) | 35 s (282 ms a token) | 1860 | 9013 |

R = 1 with per-layer slots sees token by token's requests in the same order per layer, so the
same misses (10613 in the whole run, both). R = 2 is already 1.29x: two rows a run, and the
union's repeats (-2.6% misses). The rest of the bound needs the pooled slots.

Qwen3.5-35B-A3B's layer runs, co-simulated as the 26B's (position 256, a zero image: union 8):

| layer | R = 1 | R = 2 (per 2 rows) |
|:--|--:|--:|
| DeltaNet | 2.54 ms | 2.94 ms |
| attention | 2.00 ms | 2.25 ms |

That is 96 ms a token at R = 1 and 55 ms at R = 2 (union 8; about 65 with R = 2's real union),
before the link. `test_layer_major_prefill_is_bit_exact` (test_qwen35_moe.py): a tiny
Qwen3.5-MoE, 262 tokens in chunks of 100, int8 R = 1 and fp4 R = 2 with build B's PAIR /
DSTEP / STREAM, the table on the host: the logits, states, windows and KV cache equal token by
token's, then 3 decode steps. Dense Qwen3.5 programs are sha-identical; the MoE images gain
xbuf and the scratch (42 / 35 slots a layer, as before).

### 13.6 The card's port A, and the embed runs

The first layer-major session of the 35B (2026-10-01, lm2, build xfix 72256074) gave
24832180ab7cce3d at R = 1 where token by token and the ISA simulator give 88225ff781699291.
Dumps of the residual rows after every layer (`lmdiag`) put the first wrong row at layer 0, row
1, every column off by a few percent. 5 ms before each run, or the host waiting for WR_IDLE,
changed no bit; with the first conv_k - 1 rows token by token the rest was bit-exact. The
memory before each of layer 0's first runs, card against ISA (`lmsnap`), then showed it: after
the three embed runs, rows 1 and 2 held their own int8 values times row 0's block scales (the
ratio card / ISA per 128-column block was s0 / s1, and s0 / s2, on all 16 blocks), while the
states, windows, gates, offload words and expert slots were equal and every run's instruction
count matched (57 for an embed run; 1115, 1149, 1183 for layer 0's).

The embedding gather (kernels/gather.py) streams the slot's int8 row on port B and its scale
words on port A. otpu_native_dram reuses the beat of the last A read and keeps a run of 32
prefetched A beats; only the slice's own writes or the board's reset drop them. They outlive
runs and program loads, and the host's writes (XDMA, its own master in otpu_mem_ch) never
reach the adapter. So an embed run after another, the host having written the next token's
record to the same slot in between, read the old scale beat. Any other run starts with a
layer's weight scales, a different beat, after a run that ended on other scales: token by
token, the run-time layer runs (layer 0 gathers its row after the previous run's experts), the
decode steps and the 26B (its table on the card) never meet it.

Until a bitstream drops the A beat and run at RUN (ld-memch's next build), prefill_layers with
the table on the host (embed_host) has no embed runs: the rows before conv_k - 1 run token by
token (prefill_chunks) and layer 0's runs gather their rows from the host's slot (its rows 0
to R - 1, which the host writes before the run; the slot holds RUN_ROWS records).
Engine(..., embed_runs=True) brings back the embed runs and the compile-time-position runs; the ISA
simulator gives the same bits both ways (`test_layer_major_prefill_is_bit_exact`, the 35B's
layout at R = 1 and 2, and the embed runs at R = 1).

On the card with it (2026-10-02, production g2fix 0885d436, Gen2 x8, session lm3, tree
bc546a4; `layer_major.sh` RUNS="q35t16 q35lm1 q35lm2 q35lmp2"), the 35B's 16 tokens give the
same prefill logits (88225ff781699291) and tokens four ways: token by token, layer-major R = 1
and R = 2 with each layer's slots (840 and 480 requests in the prompt, 2755 and 2705 misses),
and R = 2 pooled (480, 3027).

### 13.7 Where the prompt's time goes

`moe_card.py`'s result has `prefill_time`. It holds the prompt's wall time and the sums of its
runs (start to the wait's return, the device's cycles, start to HALTED seen) and of the time
between them. It also holds the requests' serve time, the host's parts and the card's
free-running counters over the prompt. `--prefill-trace PATH` writes the timeline:
- each run, with its layer run's key (None for a token step), start, done, HALTED seen and
  counters;
- each request, with seen, served, misses and ids.

A layer run then splits into:
- pre: the mixer and the router, up to the request seen;
- wait: seen to served. The card computes each expert once its entry is present, so the hits
  overlap the misses' DMA;
- post: served to HALTED.

On the card (2026-10-02, pa e4db91c9, Gen2 x8, tree 333a6c1, sessions pftime and pfpool), the
35B took 134 tokens (wiki.txt's first paragraph in its chat template, the table on the host)
and the 26B took 124. All runs are bit-exact (95426ebacc3b40a9 and 90e6b6e06e19da99, the
latter q26ref16). Compute is each layer kind's device time on its zero-miss runs times the
number of runs. The R = 2 compute comes from the pooled runs, which have the most zero-miss
runs. Exposed misses are the rest of the layer runs' device time.

| | 35B R = 1 | 35B R = 2 | 35B R = 2 pooled | 26B R = 2 | 26B R = 2 pooled |
|:--|--:|--:|--:|--:|--:|
| prefill | 23.14 s | 18.50 s | **14.64 s** | 24.43 s | **17.33 s** |
| misses | 12499 | 12198 | 6241 | 9013 | 2234 |
| layer runs' compute | 12.25 | 8.29 | 8.29 | 13.72 | 13.72 |
| exposed misses | 8.06 | 7.24 | 3.46 | 8.99 | 2.12 |
| token steps (35B) or embed runs (26B) | 0.87 | 0.88 | 0.90 | 0.03 | 0.03 |
| between runs | 1.13 | 1.58 | 1.58 | 1.41 | 1.30 |
| run start, HALTED, counters, head | 0.82 | 0.52 | 0.38 | 0.28 | 0.16 |

Per run (ms):

| layer | zero-miss R = 1 | zero-miss R = 2 | pre | +wait a miss |
|:--|--:|--:|--:|--:|
| 35B DeltaNet | 2.48 | 3.38 | 1.94 | 0.78-0.82 |
| 35B attention | 1.98 | 2.61 | 1.18 | 0.78-0.82 |
| 26B sliding | | 7.29 | 3.33 | 1.54 |
| 26B global | | 7.81 | 3.85 | 1.54 |

The pre column is at R = 2. The 35B's runs are close to the co-simulation in 13.5.

The misses are bound by the link:
- A miss adds the DMA of its slot to the wait: 1.67 MB at 2.1 GB/s on the 35B, 3.45 MB at
  2.24 GB/s on the 26B.
- Only a run's first miss overlaps the hits' compute. The device time grows 0.47 ms (35B) or
  0.70 ms (26B) for it, then a whole slot's time for each miss after it.
- The time between runs is the layer programs' first compile, 22 / 34 / 41-46 ms a layer
  (35B R = 1, R = 2, the 26B). Within a layer the runs are 12-20 us apart.

Over this prompt each layer uses 144 of the 35B's 256 experts (100-226) and 75 of the 26B's
128 (49-101): 5777 and 2237 in all. Pooled slots load each of them once. That gives the 35B's
6241 misses (with the token steps' 645) against per-layer slots' 12198.

The pooled prompt leaves fewer of the decode's experts in place, so the lazy restore (13.4)
costs the decode a re-warming of its slots: a fixed 0.16 s on the 35B and 0.24 s on the 26B. The
16 tokens after the prompt took 3.52 s against 3.36 s and 4.78 s against 4.53 s. The 35B's
second half missed less than the per-layer run's, 84.9 experts a token against 101.6. The
prompt saved 3.86 s and 7.10 s.

What is left:
1. The compiles, now done. The layer runs' programs compile in the compile worker processes
   ahead of their runs, in run order (Engine._precompile_layers), 22-46 ms each against a
   layer's 200-460 ms. On the card (session pfcomp, same build and prompts) this took the 35B's
   pooled R = 2 prompt from 14.64 to 13.32 s. The gap at a new layer fell from 33 ms to 16 us.
   The 26B's was unchanged (17.30 s): its prompt starts right after the engine, before the
   workers are up, and nothing had been queued. Now the compiles are queued anyway, and a run
   compiles in line until the workers are up. With that (pfcomp2, tree 94e635e) the 26B's
   prompt went from 17.33 to 16.25 s, bit-exact. Its time between runs fell from 1.28 to
   0.18 s; the only wait left is layer 0's first run (130 ms while the workers came up).
2. The pooled misses, 4.5 s of link on the 35B and 3.4 s on the 26B. Streaming them a layer
   ahead, in a static order, was predicted at about 10 s and 14 s. On the card it gains nothing,
   because writes during compute slow the card's runs by 13-16% (13.8).
3. R = 4, if the TMEM layout for 4-bit experts at 4 rows allows it. The R = 1 / 2 runs fit
   1.58 + 0.90 R ms (DeltaNet) and 1.35 + 0.63 R ms (attention): 6.4 s of compute for the
   35B, against its 4.5 s of pooled misses, so about 8 s.

### 13.8 Layer-ahead streaming (opt-in: no gain on the card)

`Engine(layer_ahead=...)` (`moe_card.py --layer-ahead index|TRACES`) gives the expert server
the next MoE layer's experts to send while a layer runs: `ExpertServer.ahead_layer(j, ids)`,
global ids in the order to send. It is called between runs only:
- for the first MoE layer, after `begin_prefill(ahead=True)`;
- for MoE layer j + 1, before each layer j's first run in a chunk;
- for the first layer again, before a chunk's last layer when another chunk follows.

The order is index order, or a static profile: each layer's experts by their use in router
traces of other texts (`router_trace.py`, `--trace`). It is host bookkeeping on recorded routes,
with no model math on the host. Each call replaces what the last one queued and has not landed
(at short prompts a queue that only appends fills with layers that already ran). A request still
names its own experts. One not landed is a miss; one partly sent gets its rest at once
(promoted). The server side is 13.4's layer ahead (offload): slots taken when an expert's first
part goes out on an idle poll, `settle` first, and `end_prefill` dropping what has not landed.
It is off by default and changes nothing without `--layer-ahead`.

On the card (session pfahead, 2026-10-02 08:05-08:15 on the card host's clock, pa e4db91c9, tree ce8c8a5 = main
a3da5ff + offload-ahead 665b8a0), pooled slots, R = 2. Every run is bit-exact (95426ebacc3b40a9
and 90e6b6e06e19da99), and each is compared with a baseline on the same tree:

| | prefill | misses | device | ahead: calls / landed / dropped / promoted |
|:--|--:|--:|--:|:--|
| 35B, no ahead | 13.69 s | 6241 | 12.88 s | |
| 35B, index order | 13.62 s | 4566 | 12.35 s | 40 / 3175 / 32 / 1 |
| 35B, profile order | 13.51 s | 4339 | 12.18 s | 40 / 2996 / 29 / 0 |
| 26B, no ahead | 16.06 s | 2234 | 15.82 s | |
| 26B, profile order | 16.87 s | 157 | 16.12 s | 30 / 3523 / 13 / 0 |

Static orders gain nothing on the card: -0.2 s on the 35B, +0.8 s on the 26B. The experts land
and the misses fall, and three costs take it back:
1. DRAM write contention. A run with no misses waits for nothing, yet it slows down while
   parts stream into DRAM during it. This is 0.13-0.18 s of the card's compute per GB written
   during compute. A demand miss writes the same bytes while the card waits, and does not pay it.
   The bridge's batches (13.19) take a third off it in co-simulation.

   | run with no misses | no ahead | with ahead | parts during it | slower |
   |:--|--:|--:|--:|--:|
   | 35B DeltaNet | 3.375 ms | 3.818 ms | 6.5 (3.4 MB) | 13% |
   | 35B attention | 2.618 ms | 3.012 ms | 5.2 (2.7 MB) | 15% |
   | 26B sliding | 7.289 ms | 8.485 ms | 13.8 (7.2 MB) | 16% |
   | 26B global | 7.805 ms | 8.885 ms | 11.6 (6.1 MB) | 14% |

2. The parts' rate. An idle poll's part of 512 KiB takes 0.53 ms (median) against its 0.24 ms
   of DMA, plus 0.12 ms for the poll: about 1 GB/s, 2.6 ms a 35B expert. A layer's runs (about
   340 ms) carry about 79 of the 144 experts it needs, as landed (3175 / 40). At the link's
   0.78 ms an expert they would carry about 265.
3. Halts seen late. A part in flight when a run halts delays the host: 0.30 against 0.12 ms a
   run (35B), 0.29 against 0.04 ms (26B), about 0.5 s a prompt each.

The profile also sends experts the prompt never uses. Among a layer's first |used| experts in
the profile order, 65% are used on the 26B (index order: 58%), so 3523 landed against the 2237
needed, each one paying the contention. ld-memch's qual image prebuild ran from 08:10:58,
during both 26B runs. The 26B pool stayed resident in both (13.24 of 13.24 GB, decode reads
all cached, prefill pool reads 0.01-0.1 s), and the contention table compares the cycles of
runs with and without parts, which the host's page cache cannot change.

The first event model (on pfcomp's traces) left these costs out and predicted 9.9 s and
14.1 s. The refit model (`lahsim2.py`, scratchpad) adds them: contention at 0.17 s a GB, the
part and poll costs, and halts seen at the end of the part in flight. It gives the base runs
within 0.1-0.7 s and the ahead runs within about 0.65 s:
- Static orders, at any part size, with or without holding parts back near a run's end, and
  capped at a layer's expected number of experts: within about 0.5 s of the base, as on the
  card. A cap saves bytes but loses them again as misses (26B, top 74 of 128: 842 misses).
- An oracle order, exactly the experts the next layer's rows will use, in first use, with
  1 MiB parts: 11.9 s for the 35B (-1.9 s) and 15.4 s for the 26B (-1.4 s in the model), each
  good to about 0.7 s.

What is left needs the next layer's set nearly exactly, before it runs. Only the card can give
it without host compute: layer j's runs would run layer j + 1's router on their output rows
and post the ids as a hint for the ahead queue. That is the next step, measured offline first
(its recall against each layer's union).

`test_layer_ahead_sends_the_next_layers_experts` (test_qwen35_moe.py, ISA) drives the server's
own `ahead_layer`, with the link's idle time given before each run (polls until none sends; the
plain simulator polls only while a run waits). It checks the call schedule over two chunks, the
experts landed, fewer misses than without, and logits and decode bit-exact with token by
token's.

### 13.9 Design: a card-side predictor for the layer ahead

13.8 bounds what the layer ahead can win with an exact set. The card can come close to that
set itself, with no model math on the host. Layer j's runs end with layer j + 1's hint: layer
j + 1's router on the run's output rows (moe_hint's route: rmsnorm by layer j + 1's g_post,
quantized, the router, the k best by the model's rule). The run posts its R x k ids as a hint
line, and the server appends the ones not landed or queued to layer j + 1's ahead queue, in
arrival order. Layer j + 1's input is layer j's output, so this is the decode hint's
approximation, the router on the layer's input before its mixer.

Recall, offline. The router traces' `L_pre` is exactly this prediction, through the norm that
feeds the router. The predicted union of a prompt's rows is compared with its routes' union
(`hintrecall.py`, scratchpad; 2048-token traces of four texts cut into windows):

| | rows | top-8 per row: recall / precision | top-16: recall / precision |
|:--|--:|:--|:--|
| 35B (four texts) | 134 | 0.90-0.92 / 0.87-0.88 | 0.99 / 0.67-0.71 |
| 35B | 32 | 0.85-0.88 / 0.81-0.84 | 0.97-0.98 / 0.56-0.58 |
| 26B (two texts) | 134 | 0.96 / 0.86-0.88 | 0.99 / 0.66-0.70 |
| 26B | 32 | 0.93 / 0.84-0.85 | 0.99 / 0.59-0.61 |

The refit model of 13.8 (contention 0.17 s a GB on every streamed byte, the measured part and
poll costs, halts seen late) runs on the traces' windows (`lahsim3.py`). Each run's hint joins
the queue at the run's end. The numbers are the layer runs' seconds at R = 2, pooled, with
1 MiB parts:

| | rows | no ahead | profile (512 KiB) | predictor, top-8 | oracle |
|:--|--:|--:|--:|--:|--:|
| 35B (wiki) | 134 | 12.64 | 12.68 | **11.08 (-1.56)** | 10.65 (-1.99) |
| 35B (prose) | 134 | 12.25 | | 10.87 (-1.38) | 10.44 (-1.81) |
| 35B (wiki) | 66 | 7.33 | | 6.57 (-0.76) | 6.24 (-1.09) |
| 35B (wiki) | 34 | 4.42 | | 4.10 (-0.33) | 3.91 (-0.52) |
| 26B (wiki) | 125 | 16.49 | 16.02 | 15.42 (-1.07) | 15.20 (-1.29) |
| 26B (wiki) | 65 | 9.57 | | 8.61 (-0.96) | 8.36 (-1.21) |

Top-16 sends more bytes than its extra recall saves (35B 134 rows: -1.19 s). The model is
within 0.2 s of the card's 35B ahead runs, but about 1.3 s optimistic on the 26B's (13.8). So
the 26B's gain is more like 0 to -1 s.

What it costs the card:
- A run adds layer j + 1's router on its R rows: the router's E x H int8 weights (0.5 MB on the
  35B, about 0.36 MB on the 26B) at about 15 GB/s, the norm and quantization, and R x k
  knock-out argmaxes. That is about 50 us a run on the 35B (0.13 s over a 134-token prompt's
  2600 runs) and about 35 us on the 26B (0.07 s).
- The hint post is one line, its count and seq. The run's next request waits on the fence (WAITW
  served >= seq) about 2 ms later, long after the host has queued the hint.
- The last MoE layer's runs post nothing.

Net: about -1.4 s on the 35B (13.7 to about 12.3 s, 10%) and 0 to -1 s on the 26B at
124-134 tokens; less on short prompts.

The split follows 13.8's.
- Card / Engine (gemma4): compile_layer_run(li) ends with the hint for li + 1 (Qwen3.5:
  moe_hint's route on the output rows; Gemma 4: moe_ffn's router path on them, the router's
  scale folded as in moe_ffn), R x k ids in one line, hint_off as today. There is an ISA test
  that hints change no logit, and moe_card's ahead stats count the hints.
- Server (offload): with the ahead on, a hint for the queued layer is appended to its queue
  instead of taking per-layer slots. `ahead_layer` still starts each layer's queue; it may be
  seeded with the profile's top experts or left empty. Parts of 1 MiB come through
  begin_prefill(part=...).

Card check: the base and the predictor for the 35B and the 26B, R = 2, pooled, with
--prefill-trace, and the zero-miss runs' contention measured again.

The card side (Engine(layer_ahead="hint"), moe_card --layer-ahead hint):
- A layer run of layer li ends with `moe.moe_hint_rows` when li + 1 is a MoE layer: its
  router through its norm (g_post, quantized) on the R rows the run stored, each row's k best
  by the model's rule, one line of R x k global ids offset by hint_off (layers x E), its count
  and seq after the fence. The program compiles with `hint` (layer_programs, the worker
  processes' too); the other runs and every decode program are unchanged (program_sha on the
  card's configuration: the same nine sums for E2B, E4B, LFM2.5-8B-A1B, the 35B both ways, the
  26B both ways and the tiny models).
- The hint adds 37 instructions a run (its loops are hardware loops); the largest layer run
  is 14,344 words of IMEM's 32,768 (the 26B's at bucket 16).
- prefill_layers calls ahead_layer at the same points as 13.8, with no ids: each call starts
  the next layer's queue, and the hints fill it. begin_prefill gets 1 MiB parts (AHEAD_PART).
- A hint changes no row. The tests check the logits and the decode after them against token
  by token (Qwen3.5, Gemma 4), and that each hint equals the next layer's own request for the
  same rows when the mixers' output projections are zero, so that a layer's route reads its
  input.

### 13.10 The predictor on the card (sessions pfhint and pfhint2: opt-in, no gain yet)

Two sessions (gemma4, 2026-10-02, one otpu-lock each, production fmvf 542fc43a), R = 2, pooled,
16 tokens. Every run was bit-exact: the 35B gave lmtime's 95426ebacc3b40a9, the 26B q26ref16's
90e6b6e06e19da99. The ISA references of the hinted programs match the old ones (the build host: 35B
q35ref16 88225ff781699291, 26B q26ref16).
- pfhint (10:56-11:04 on the card host's clock, tree 5051032): one pair a model, base first.
- pfhint2 (11:29-11:48, tree ca913e4: the same programs, plus moe_card --ahead-part): base, hint
  with 1 MiB parts, hint with 4 MiB parts (one part an expert), twice a model, in that order.

Halts late is the sum over runs of the time from the run's device end (start + cycles) to the
host seeing HALTED.

| session | run | wall, s | device, s | halts late, s | serve, s | misses | landed ahead |
|:--|:--|--:|--:|--:|--:|--:|--:|
| pfhint | 35B base | 13.107 | 12.031 | 0.63 | 6.79 | 6241 | |
| pfhint | 35B hint 1 MiB | 12.387 | 10.949 | 0.92 | 2.24 | 1902 | 4856 |
| pfhint2 | 35B base 1 | 13.162 | 12.044 | 0.64 | 6.83 | 6241 | |
| pfhint2 | 35B hint 1 MiB | 12.906 | 11.378 | 1.04 | 3.05 | 2213 | 4466 |
| pfhint2 | 35B hint 4 MiB | 12.677 | 11.126 | 1.09 | 2.33 | 1602 | 5215 |
| pfhint2 | 35B base 2 | 12.455 | 11.728 | 0.24 | 5.93 | 6241 | |
| pfhint2 | 35B hint 1 MiB | 12.445 | 11.042 | 0.95 | 2.43 | 1987 | 4741 |
| pfhint2 | 35B hint 4 MiB | 12.402 | 10.939 | 0.99 | 2.01 | 1550 | 5283 |
| pfhint | 26B base | 15.861 | 15.547 | 0.15 | 4.18 | 2234 | |
| pfhint | 26B hint 1 MiB | 15.676 | 15.114 | 0.39 | 0.76 | 214 | 2259 |
| pfhint2 | 26B base 1 | 15.894 | 15.560 | 0.13 | 4.18 | 2234 | |
| pfhint2 | 26B hint 1 MiB | 15.743 | 15.100 | 0.38 | 0.73 | 214 | 2259 |
| pfhint2 | 26B hint 4 MiB | 15.821 | 15.116 | 0.45 | 0.74 | 213 | 2260 |
| pfhint2 | 26B base 2 | 15.817 | 15.544 | 0.12 | 4.12 | 2234 | |
| pfhint2 | 26B hint 1 MiB | 15.694 | 15.124 | 0.37 | 0.76 | 214 | 2259 |
| pfhint2 | 26B hint 4 MiB | 15.777 | 15.117 | 0.44 | 0.75 | 213 | 2260 |

The lead's rule, on pfhint2's means: the 35B must gain at least 0.7 s, and the 26B lose at most
0.3 s.
- 35B: 1 MiB -0.13 s, 4 MiB -0.27 s. It fails.
- 26B: 1 MiB -0.14 s, 4 MiB -0.06 s.
- The default stays off for both. The 26B's 0.9% is not enough on its own.

The run order explains pfhint's -0.72 s. A model's first run after its pool is read is slow:
35B base 1 against base 2 was 6.83 against 5.93 s of serve, because pool reads still hit the
disk, and 0.64 against 0.24 s of halts late, because the host is busy serving when a run halts.
pfhint's base ran first. In pfhint2's second, warm triple the 35B gains 0.01 s (1 MiB) and 0.05 s
(4 MiB). Card A/B sessions now start with an unmeasured warm-up run and use ABBA order.

Where it goes (pfhint2's warm triple, 35B base 2 against 4 MiB):
- Device -0.79 s. The 4691 avoided misses save more card wait than contention and the router
  cost. The router costs +47 us a 35B run, +37-41 us a 26B run, as 13.9 estimated.
  Contention was measured again at +15% on zero-miss runs with parts in flight (13.8: 13-16%).
- Halts late +0.75 s (0.24 to 0.99 s). 1311 runs ended with a part in flight and were seen a
  median 0.69 ms late. At 1 MiB parts, 1925 runs were seen 0.46 ms late. The host's part DMA
  blocks it, so it sees a run's end only after the part.
- 26B: device -0.44 s, halts late +0.25 to 0.32 s.

The 35B's link was busy 9.4 of the prompt's 12.4 s at 1 MiB parts. A part cost about 0.42 ms
fixed plus 0.33 ms a MiB. offload traced the fixed cost:
- each idle part goes as two DMA records (the lead cut meant for a miss), at 122 us each;
- staging (the pool read and the iovecs) is not overlapped;
- the last part writes the entry in a call of its own;
- the poll's mailbox read sits between parts.

Open items:
1. Halt-aware idle parts: no idle part starts when the run's expected end (BoardBackend's
   expected time for the program, from its start) is closer than the part's time. Requests
   are still served at once. This would recover most of the halts' +0.75 s (35B) and +0.3 s
   (26B), at the cost of some streaming.
2. The part path (offload): one record an idle part, and staging read ahead under the DMA.
   About 0.49 ms a 1 MiB part, against 0.76 now. Shorter parts also shorten the halt delay.
3. A design with less contention. Contention is per byte written during compute (DRAM
   bandwidth): about 1.1 s on both models. Fewer bytes per run (higher precision), or
   streaming only in the card's DRAM-idle phases, which needs a signal from the card.

The predictor stays opt-in (--layer-ahead hint, --ahead-part). Its card check repeats after
items 1 and 2.

### 13.11 Design: expert-major MoE in layer-major prefill

Today a layer-major run of R = 2 rows routes its rows and runs the union of their experts on both
rows (moe_ffn_rows). Two rows rarely share many experts, so a layer makes far more expert passes
than it has experts. On pa's base traces (ld-memch) the 35B makes 845 passes a layer for 140
distinct experts, and the 26B 752 for 75. A pass on two rows (PAIR) costs what a pass on one does,
and c(M), one expert's FFN on M rows (co-sim, RTL + LiteDRAM), grows by pairs of rows:

| M | 1 | 2 | 3 | 4 | 6 | 8 |
|:--|--:|--:|--:|--:|--:|--:|
| 35B, ms | 0.101 | 0.100 | 0.192 | 0.194 | 0.370 | 0.372 |
| 26B, ms | 0.210 | 0.210 | 0.390 | 0.393 | 0.763 | |

Expert-major splits each layer of a chunk into two parts.

1. Mixer runs (R rows, as today): the previous layer's combine for their rows, the mixer, then
   the MoE prologue. The prologue is the router and the k best with their weights (moe_ffn_rows'
   loop), plus the shared expert (Qwen3.5) or the dense MLP beside (Gemma 4). Its outputs are
   stored per row to a prefill scratch (below): the expert input (fp32, re-quantized when loaded:
   per row, so bit for bit), the ids and weights, and the shared or dense output. The run ends by
   posting its R x k ids as a need line (the protocol below).
2. One expert run: the bucketing, then each pass, which is two entries of one expert:
   - wait for the expert's directory entry;
   - load the two rows' inputs, quantize, swiglu_down at the slot;
   - store each output row at its (row, rank) place (an odd tail's second output goes to a sink).

The combine, in the next layer's runs, sums each row's k outputs in its router's order, then
adds the shared output (Qwen3.5: x + (sum + shared)), or does Gemma 4's
norm(dense) + norm(acc) and _add_norm, in moe_ffn_rows' order. So a row's result is today's,
bit for bit. The last layer combines only the head's row, in the head run. Token steps (rows
before conv_k - 1), decode and its programs do not change.

The kernels, measured by ld-memch (ISA against numpy, then RTL co-sim at 133.33 MHz; the build host
~/otpu-build/pf/kcost.py):
- Bucketing: a loop over the N = rows x k entries (pointer register, ADDI). Per entry it RLDs
  the id, toggles the expert's parity, and either opens a pass (FILL e, A, open[e]) or closes
  one (FILL B), with LOOPs counted by the parity for the branches. That is 10.2 instructions
  and 54.7 cycles an entry: 0.43 ms a layer on the 35B (N = 1040), 0.41 on the 26B, and the
  pass counts match numpy (587 / 529).
  - Its table is N / 2 + E rows of 4 words, so 512 rows fit.
  - A segments variant (an E x rows table, 0.32 / 0.26 ms) does not fit TMEM at 512 rows on the
    35B, so it is not used.
  - Raw integer words through the VPU are denormals and FILL / COPY flush them, so registers
    are written as 2^23 + R and corrected (ld-memch).
- A pass costs c(2) + 4.3-4.8 us: 7 RLDs, 3 LDs and 2 STs. The directory word read from DRAM
  overlaps the previous pass's stream. That is ~2.5 ms a layer.

The model (emsim.py, scratchpad; the router traces' windows, 6 x 131 rows on the 35B and 6 x 124
on the 26B):
- Calibration: the base's per-miss link time is fit so its card waits match pfhint2's warm base
  (35B 2.68 against 2.72 s, 26B 1.83 against 1.84).
- Inputs: the card's per-run times, c(M) and the kernel costs above; contention of 0.17 s a GB
  on every byte streamed during compute; halt-aware holds.
- Passes a layer: 35B 840 -> 564, 26B 767 -> 517.

| variant | 35B | 26B |
|:--|--:|--:|
| needs streamed during the mixer runs, an expert 0.79 / 1.29 ms (v2's one-call parts) | **-1.9 s** (-1.87 to -2.06) | **-2.0 s** (-1.80 to -2.05) |
| the same, an expert 0.95 / 1.10 ms (35B) | -1.7 / -1.1 s | |
| the same on today's part path (35B 1.55 ms) | +1.1 s | -1.9 s |
| demand only (the expert run's misses served one after another) | +0.3 s | -1.1 s |

On the 35B, the streamed variant removes about 2.6 s of waits and 1.1 s of expert passes, and
adds 1.56 s of contention. Contention is the model's largest uncertainty, about +-0.5 s. The 35B's
mixer phase (~150 ms a DeltaNet layer, ~105 ms an attention layer) carries its 138 experts only
at about 0.8 ms each. So B on the 35B comes after offload's v2 parts and a card re-measure of
their cost.

The server (agreed with offload, 2026-10-02; host only, with begin_prefill(expert_major=True)):
- Need lines: a mixer run posts its R x k ids for its own layer, offset by need_off =
  2 x layers x E, after the fence, as a hint line. Ids from 2G up are needs, G to 2G hints, and
  below G requests (G = layers x E).
  - Sixteen ids fill the first line (R = 2, k = 8); up to 32 go through row2, as today.
  - Poll writes served as for a hint: no answer, no use counted.
- The need queue is the server's own, apart from ahead_layer's.
  - Poll appends the ids in no slot (on their way included), not pending and not queued, in
    arrival order.
  - Needs stream on idle parts (v2: one call, read ahead, halt-aware), ahead of any ahead_layer
    queue.
  - A need is never dropped or withdrawn, and the queue is never replaced (begin_prefill,
    end_prefill, ahead_layer and _drop_ahead leave it alone).
  - end_prefill drains it first (settle), so nothing pending crosses into decode.
- Victims: while expert-major is on, every slot taken during layer j's runs (a need, an ahead
  queue's expert, a demand miss) has its victim outside layers {j - 1, j, j + 1}. A need's slot
  is never reused before the expert run has read it. This is the one way the card could read a
  stale entry.
- The card waits on the entry:
  - Each expert's data goes first, its tag in the last beat of its last part, then its directory
    entry, in the same poll and flushed before the poll returns (unchanged by 12.8's fix).
  - The expert run WAITWs on the entry's present word. An expert that lands between its read and
    the wait satisfies the wait, so 12.8's race does not arise.
  - _clear only clears victims, never a needed expert, so the wait never holds on a stale entry.
  - A WAITW timeout stops the prefill with a clear error. It never runs on with a missing expert.
- Tags: with no request there is no _used, so armed keeps the expert run's slots. That is
  harmless: _reuse zeroes a slot's tag before it takes another expert. The expert run still
  zeroes each tag after use, as slot_of does, so a later demand miss in that slot cannot see a
  stale tag.
- Requests and hints keep their paths (decode, token steps, other prefill).

The scratch (a constraint: not one decode slot), per row (k + 2) x H fp32: the k outputs,
the expert input and the shared or dense output, plus the ids and weights and a sink row.
- 35B: 80 KB a row, 41 MB at 512 rows; 26B: 113 KB a row, 58 MB.
- The server owns it. begin_prefill(scratch=bytes) takes the last ceil(bytes / pitch) slots of
  one layer's pooled region off the free lists (contiguous) for the prefill.
  - Experts in them are evicted first: their entries are cleared and flushed before the base
    address is handed out.
  - end_prefill hands them back empty, with their tag beats zeroed (or armed, so _reuse zeroes
    them). Scratch data in a tag beat would otherwise read as a landed expert.
- At 512 rows that is 25 of the 35B's 1680 slots and 17 of the 26B's 540. It is sized to the
  chunk's rows: 7 and 5 at a 133- / 124-row prompt (since the pipelined passes, the 512 rows'
  at any prompt where the slots past them are the expert runs': `moe.em_scratch`).

The changes:
- moe.py: the prologue, the expert run (bucketing, passes) and the combine.
- qwen35 / gemma4: layer runs in an expert-major variant, and an expert-run program per layer.
- Engine.prefill_layers: per chunk and layer, the mixer runs, then the expert run; begin_prefill's
  scratch.
- ExpertServer (offload): need lines, the need queue, the scratch.

Tests: the ISA, bit for bit, against token by token (tiny Qwen3.5 and Gemma 4, two chunks, odd
counts, R = 2); the bucketing against numpy; the server's need path (offload); then a card
session, with a warm-up run first and ABBA order, against the predicted column.

The order: offload's v2 parts and the v2 re-measure, which confirms an expert's part cost on the
card. Then this code, once this note is approved.

### 13.12 Idle parts: read ahead, one call each (offload-parts)

pfhint (gemma4, production fmvf 542fc43a, the 35B's layer-major prefill with the predictor,
1 MiB parts) measured each idle poll's part: the first 1 MiB of an expert 0.757 ms (median,
4868 parts), its 0.59 MiB rest 0.622 ms, events 0.085 ms apart; the link busy 9.4 of 12.4 s,
6.80 s of it parts, and 700 of 5568 queued experts never sent. A line through the two gives
about 0.42 ms a part plus 0.33 ms a MiB. Where the 0.42 ms goes:
- The lead cut. A poll flushes before it returns, so BoardDram finds nothing in flight at the
  next part and cuts it as it cuts a request's first miss: a fifth, then the rest, each one
  DMA call per channel. Session 16's data calls fit 122 us + bytes / 3.15 GB/s a pair of calls
  (1.67 MB: 622 us median; a 64-byte call 33 us), so a cut part pays 0.24 ms of calls where one
  pair would pay 0.12. The 0.33 ms a MiB is the 3.15 GB/s.
- The read in front of the link. The first fifth's read from the pool file and its iovecs
  come before any DMA (pfhint's stage time: 0.32 ms a part; the pool reads at 7.3 GB/s).
- The last part's entry, one more call (35-45 us). The 0.085 ms between events is the next
  poll's mailbox read (one 64-byte c2h call) and the loop.

Two changes (`moe_card --idle-parts`: v2, both, the default since session 18 below; v1 as
before, the default until then; ra; halt; `ExpertServer.read_ahead` and `halt_aware`, both on by
default since session 18):

`read_ahead`:
- `_stage_next`: before a poll flushes, the part the next idle poll would send is read into a
  staging pair (`BoardDram.stage`), beside the DMA in flight (the part's, or the request's
  experts and served; a hint's first part reads while the card runs its mixer). ahead_layer's
  next queued expert takes its slot for it then, by the same rule as at the next poll.
- The next idle poll queues a staged part as it is, one DMA call per channel (write_slot's
  `staged`, `cut=False`). A part that was not read ahead keeps the lead cut, and a request's
  misses keep theirs (the first with the cut, the rest one call each).
- A request, a hint, ahead_layer and the prefill's begin and end drop a staged part first
  (`_unstage`: the read is lost, not the link's time); the server's reads of the card still
  meet no DMA in flight.
- The staging pairs are sized for an expert and its tag chunk before the first stage, so none
  is reallocated under a staged part (BoardDram raises if one would be).

`halt_aware` (gemma4's pfhint2: a run's halt seen late behind an idle part costs the 35B's
prefill about 0.75 s and the 26B's 0.25-0.32 s):
- No idle part starts while the running program's expected end is nearer than a part takes.
  The end: `BoardBackend.run_clock()`, the run's start and its time with no waits (the
  shortest of the last 16 runs of its program's length, in seen wall seconds), plus the run's
  own waits so far (each of its requests with misses, seen to served; gemma4's pfhint2:
  zero-miss DeltaNet runs within about ±0.05 ms, a miss about 1 ms more). A part takes
  `part_s`, the measured idle parts' average (before the first, `PART_S0` + part / `PART_GBS`:
  0.2 ms + 3.15 GB/s). The poll returns 0 and the backend polls again, so requests are served
  at once as always.
- A run past that end by `HOLD_LATE` (1 ms) gets parts again (the estimate was short), and
  so does one with no run of its length before. `holds` counts the polls held. A poll that
  holds after ahead_layer's next expert took a victim's slot flushes the victim's entry first,
  so the next read of seq meets no DMA in flight.
- gemma4's estimate: 35B -0.5 to -0.7 s and 26B -0.3 to -0.4 s on the layer-ahead prefill.

Predicted per part (session 16's fit: 122 us a call pair + bytes / 3.15 GB/s; pfhint's
measured in brackets). ld-memch's H2C sweep (docs/host.md 2) puts a placed call at 20-37 us +
345 us a MiB in the driver, so about 25-40 us of each call is the host's (Python, the worker
hop, the lock); with none of it a 1 MiB part would take about 0.38 ms:

| part | v1 | ra (one pair, read ahead) |
|:--|--:|--:|
| 1 MiB, an expert's first | 0.20 lead + 0.80 rest: two pairs, ~0.75 ms (0.757) | ~0.12 + 0.33 + 0.05 = 0.50 ms |
| 0.59 MiB rest, its tag and entry | ~0.62 ms (0.622) | ~0.12 + 0.20 + 0.05 + 0.04 entry = 0.41 ms |
| a whole 35B expert (1.59 MiB) | two parts and a poll: 1.46 ms | ~0.12 + 0.53 + 0.05 + 0.04 = 0.74 ms |
| a whole 26B expert (3.29 MiB) | three parts and two polls: ~2.3 ms (0.795, 0.795, 0.505) | ~0.12 + 1.09 + 0.09 = 1.3 ms |

The contention (13.8) is per byte, so neither change touches it.

On the card: session pfv2 (gemma4; 2026-10-02 14:28-14:52 on the card host's clock; build 542fc43a; 15 runs, all
bit for bit). Each pair ran after a warm-up, in A B B A order. The prefills are layer-major with
the layer-ahead predictor (`--layer-ahead hint --ahead-part 4096`).

| | A (v1, or base) | B (v2) | pairs B - A | mean B - A | predicted |
|:--|:--|:--|:--|:--|:--|
| 35B prefill wall, s | 12.838, 12.645 | 12.469, 12.502 | -0.369, -0.143 | **-0.256** | -0.6 |
| 26B prefill wall, s | 15.813, 15.818 | 15.823, 15.845 | +0.010, +0.027 | **+0.018** | -0.3 |
| 35B decode, hints top 4 + v2 against no hints, tok/s | 5.28, 5.25 | 5.37, 5.38 | +0.09, +0.13 | **+2.09%** | +2% |

- A whole expert's idle part took 0.961 / 0.963 ms on the 35B (v1: 1.21-1.45 ms) and 1.73 /
  1.68 ms on the 26B (v1: 1.92 ms). A 1632 KiB decode part took 0.87-0.89 ms.
- The 35B's -0.26 s comes from the shorter parts alone. Device time fell 0.13 s (fewer
  waits). The late halts fell 0.15 s: a run ending with a part in flight was seen late by
  0.58 ms median, against 0.73 ms with v1.
- The hold never acted: holds was 0 in every v2 run, so as many runs ended with a part in
  flight as with v1 (1296 / 1280 against 1295 / 1273).
- The 26B lands its whole queue either way (213 misses). Its runs with no part in flight were
  seen 0.09 s later with v2 (0.18 s to 0.27 s). That is the read-ahead's host reads (3.3 MB a
  part) at a run's end.

Why the hold never acted. BoardBackend.wait cleared the running programs before it served the
run, so run_clock() returned None at every poll of the run. It worked in the unit tests, which
put a clock on the memory, and the live-card tests never counted holds.
- Fixed (offload-hold): the running programs are cleared once the run has halted.
- With halt_aware on, _stage_next also reads nothing ahead near a run's expected end; `stage_holds`
  counts those skips.
- Tests: test_board's `test_run_clock_is_there_while_the_host_serves_a_run` (fails on the old
  wait); test_qwen35_moe's v2 live-card prefill now needs holds > 0 (26 there; 0 before the fix);
  `test_halt_aware_reads_no_part_ahead_near_a_runs_end`.
- The card's generate loop is one run with no clock, so it holds nothing; its halt comes once a
  generation.

The lead's rulings on pfv2:
- read-ahead (`ra`) becomes the default for moe_card and the server (it landed as part of
  session 18's v2, below).
- halt_aware stays opt-in until a card session shows it holding, in a re-measure of the 35B
  prefill, ra against v2.
- The 35B decode hints (top 4, n 1) get a confirm session against the then-default parts.
  They become the default only at >= 2% with both pairs positive.

On the card: session 18 (2026-10-02 16:09-16:28 on the card host's clock; build 542fc43a; tree offload-hold
651876c, with the fix; 12 runs, all bit for bit; one lock). Each part ran a warm-up first. The
prefill is the 35B's layer-major prefill with the layer-ahead predictor (`--layer-major 2
--layer-ahead hint --ahead-part 4096`), A = ra and B = v2 in A B B A order.

| run | wall s | device s | halts seen late, s | misses | parts read ahead | holds | stage holds | part ms |
|:--|--:|--:|--:|--:|--:|--:|--:|--:|
| W (ra, warm-up) | 13.204 | 11.491 | 1.195 | 1621 | 5189 | 0 | 0 | 1.894 |
| A1 (ra) | 12.701 | 11.128 | 1.075 | 1606 | 5210 | 0 | 0 | 0.932 |
| B1 (v2) | 12.425 | 11.531 | 0.338 | 2349 | 3861 | 21902 | 2746 | 1.344 |
| B2 (v2) | 12.024 | 11.193 | 0.344 | 2145 | 3980 | 26004 | 2613 | 0.925 |
| A2 (ra) | 12.732 | 11.182 | 1.029 | 1620 | 5189 | 0 | 0 | 1.077 |

"Halts seen late" is prefill_time's halted_s - device_s: each run's start to its halt seen,
past its device time.
- The pairs B - A: -0.276 and -0.708 s. The mean is **-0.492 s (-3.9%)**.
- The gain is the host seeing halts sooner. Wall - device - between fell from 1.18 / 1.14 s
  (ra) to 0.44 / 0.45 s (v2). The hold acts now, at 8-10 held polls a run, and the halts are
  seen 0.71 s sooner, about 0.27 ms a run.
- It costs device time. The held polls send nothing, so fewer experts land ahead: about
  1,280 fewer parts read ahead, about 630 more misses a prompt (+39%), and +0.21 s on the
  device (the means, B against A; +0.40 s in the first pair, +0.01 s in the second).
- A possible next step, not tried: near a run's end, send a part sized to the time left
  instead of none.
- The 26B is untested with the fixed hold and stage_holds. pfv2's +0.018 s was measured
  before the fix. Its re-measure was to ride with gemma4's expert-major B session (13.11),
  which runs both models.

The decode part: the 35B, a warm-up, then A B C C B A.
- A has no hints.
- B is hints top 4, n 1 (`--hint-drop --hint-part 1632`) with ra.
- C is the same hints with v2.

| run | tok/s | misses a token | hinted landed |
|:--|--:|--:|--:|
| W (warm-up, no hints) | 5.29 | 102.85 | |
| A1 / A2 | 5.34 / 5.26 | 102.85 | |
| B1 / B2 | 5.37 / 5.39 | 80.42 / 80.37 | 3912 / 3916 |
| C1 / C2 | 5.35 / 5.34 | 80.54 / 80.54 | 3892 / 3892 |

- B against A: pairs +0.030 and +0.130 tok/s, mean **+1.51%**.
- C against A: pairs +0.010 and +0.080 tok/s, mean **+0.85%**. pfv2's B was this same mode
  and measured +2.09%.
- v2 held nothing in the decode. C - B (-0.02, -0.05 tok/s) is inside the A pairs' own
  spread (0.08).

halt_aware's known limit in the decode:
- The card's generate loop is one run a generation, so run_clock() has no earlier run of its
  length and nothing is held.
- With a run a token, it would still hold little. T0, the least of a program's last 16 run
  times, comes from cycles that count the card's waits. Every decode run waits on about 100
  misses, so T0 already holds waits, and adding the run's own waits counts them twice. The
  expected end then lands late.
- Not chased, since the hints are off (12.10).

The lead's rulings, applied:
- v2 becomes the default (`moe_card --idle-parts v2`, `ExpertServer.halt_aware` on). It
  holds on the card, the 35B prefill is faster in both pairs, and every run was bit for bit.
- The hints stay off. On v2, the default from the first ruling, they gain +0.85%, under the
  2% bar. On ra the gain is +1.51%, also under it. They are closed (12.10).

Tests: test_offload_server's `test_idle_parts_go_as_one_call_each_and_are_read_ahead` (an idle
part's calls with and without, a request's misses with the lead cut, the staged reads, a
request dropping one, ahead_layer's slot at its stage, the card's memories as Board.write's)
`test_halt_aware_idle_parts_wait_near_a_runs_expected_end` and
`test_a_held_idle_poll_leaves_no_dma_in_flight`; test_qwen35_moe's live card
(BoardDram, CHASH, a split pool) bit for bit with v2: the decode hints and the layer-ahead
prefill (`test_layer_ahead_on_a_live_card_with_idle_parts_v2`), and moe_card's `--idle-parts`.

### 13.13 Expert-major: the card side (Engine(expert_major=True))

The card and Engine parts of 13.11 (opentpu/llm/moe.py, qwen35.py, gemma4.py, qwen3.py), bit for
bit against token by token on the ISA (tiny Qwen3.5 and Gemma 4). The server parts are offload's
(13.14); the tests run against that ExpertServer.

The scratch is one record a chunk row, `moe.em_record(H, k)` bytes, row q's at the first slot's
address + q x record:
- X [H]: the row's residual. In expert-major the records replace `xbuf`: the embed runs, layer
  runs and head read and write X. One run argument, row x record, addresses a run's records, so
  an attention run keeps its 7 of 8 arguments.
- OUT [k, H]: the row's experts' outputs, by rank, unweighted.
- SH [H]: the shared expert's output times its gate (Qwen3.5), or the dense MLP's output after
  its norm (Gemma 4).
- The tail: the k global ids, the k weights and the 1 / rms of the norm before the router, padded
  to whole lines.
- 35B: 82,048 bytes a row, 26 slots at 512 rows. 26B: 112,768 bytes, 17 slots. `moe.em_slots`
  lists the slots the scratch covers: the slot area's first ones.

The runs of a MoE layer:
- A mixer run (`moe_prologue_rows`):
  - it first ends the layer before for its rows (`moe_combine_rows`; Gemma 4 `_em_end`);
  - then the mixer, X stored, the norm (its 1 / rms kept), the router and the k best (moe_ffn_rows'
    loop and expressions);
  - then the tail stored and the need line posted (`need_off` = 2 x layers x E, a hint's post);
  - then SH: the shared expert, or Gemma 4's dense MLP beside, while the host streams.
- The expert run (`moe_expert_run`, one program a layer; run arguments rows and entries = rows x k):
  1. A loop over the rows loads each row's ids and fills two tables: each entry's row, and its
     output's place (in lines).
  2. The bucketing, as ld-memch's kernel. An entry that opens a pass also sets B = A, so an odd
     count's last pass computes its row twice and stores the same output twice. There is no
     sink row.
  3. The passes. Each WAITWs on its expert's directory slot word (!= 0) with MB.TIMEOUT and
     zeroes the slot's tag. It loads both rows' X and 1 / rms and norms them again with
     moe_ffn_rows' own expression: Qwen3.5's fused QACT with row and column scales, or Gemma 4's
     norm times g_exp. Then swiglu_down at the slot, and each output to its place.
- The head run combines the last layer for its row, then the final norm and the LM head. It runs
  before end_prefill, which takes the scratch's slots back.

The server's side, as the Engine calls it:
- begin_prefill(expert_major=True, scratch=bytes) (`moe.em_scratch`: the image's prefill rows
  x record when the slots past those are the expert runs' (`moe.em_expert_slots`, the pipelined
  passes' bound: their MMs then do not wait for the records' stores), else the first chunk's
  rows x record) carves em_slots(layout, bytes) for the prefill. On the 35B that is 25 slots
  of 1680 at any prompt, the largest chunk's, which the slot budget already leaves
  (`streamed.expert_major_fits`).
- A need line is ids from 2G (at most 16 at R = 2, k = 8: one line), no answer, served as a hint
  is.
- The expert run reads entries only after its layer's last need line has been posted.
- end_prefill hands the slots back with their tag beats zeroed, after the head run.

The needs go in idle-poll parts of the Engine's `ahead_part` (begin_prefill's part; moe_card
`--ahead-part`, AHEAD_PART's 1 MiB by default), as the layer-ahead hints' do. 13.11's model
assumed whole experts a part (v2's one-call parts), so the card A/B runs `--ahead-part 4096`. An
expert run that fails (its WAITW's timeout: the card's 'a WAITW timed out', the ISA's 'never
holds') raises with its layer and the server's `need_report()`.

In the tests (6 slots a layer, the ISA's WAITW hook `qwen3._isa_host`), every need lands while
an expert run waits on its entry: `needs_landed` equals `needs_queued`, and `drained` is 0.
The scratch's base is the first slot's address, and the server hands back the same slots that
`moe.em_slots` lists. moe_card `--expert-major` on the ISA: each MoE layer's runs, then its
expert run (key ("x", layer)); no request in the prompt, one need line per layer run, and one
idle part per need at `--ahead-part 2048`.

Compiled for the card (the board's config; the 35B fp4 with an int8 head, the 26B int8 with fp4
experts; cap 4096): the layer runs take at most 1005 (35B) and 1525 (26B) of IMEM's 4096
instructions. The expert run at 512 rows is 106 / 128 instructions and fits TMEM: its tables, at
most 4096 entries and 2304 passes, take about 21K words.

Status (2026-10-02): expert-major is merged and dormant. It is off by default
(Engine(expert_major=False); moe_card runs it only with `--expert-major`). It is built and bit
for bit on the ISA with offload's ExpertServer. It has not run on the card: the A/B session pfB
was staged (the card host ~/otpu-build/offload/card2/pfB/README.md, with its predicted column) and
then not run, because the work wrapped up. When it runs, the plan is:
- Models: the 35B (lmtime's 134-token prompt) and the 26B (q26-hf.json's 124 rows), 16 tokens
  each.
- Order: per model, one unmeasured warm-up run, then A B B A (optionally C as A B C C B A), each
  pair's difference reported.
- Arms:
  - A: today's default, layer-major pooled with no layer-ahead (`--layer-major 2`);
  - B: `--layer-major 2 --expert-major`;
  - C (optional, to check 13.11's model): `--layer-ahead hint`. A against B decides.
- Every arm: `--idle-parts v2`, the default since session 18 (with offload-hold's hold fix), and
  `--ahead-part 4096` (whole-expert parts, as 13.11's model assumed).
- Pass rule: every run bit for bit with today's references (35B 95426ebacc3b40a9 and lmtime's
  tokens, 26B q26ref16). B becomes the 35B and 26B prefill default only if both models gain and
  the 35B gains at least 0.5 s (predicted B - A, against a base with no layer-ahead: about -1.7 s
  on the 35B and -1.9 s on the 26B; 13.11's table).

Status (2026-10-12): session pfB ran this plan on the card (13.15). B was bit for bit with A in
every run and cut the prefill by 1.91 s on the 35B and 1.78 s on the 26B, so it meets the rule
above. Expert-major has been the default since (13.15, "The default"), for a prompt's calls
of EM_ROWS new rows or more (13.16), and in production since 2026-10-12 (deploy_em_91a9c2d3,
session emdef4, 13.16).

### 13.14 The need path on the host (offload-need)

The server's share of 13.11, host only (opentpu/host/offload.py). The card and Engine parts are
gemma4's.
- `Layout.need_off` is 2 x layers x E. A post whose first id is at or above it is a need line;
  from layers x E up it is a hint, and below that a request. `poll` writes served at once, with
  no answer, no use and no `history` entry; `last` and the events say "n".
- `ExpertServer.need`: each id in no slot (one on its way is in a slot) joins the end of
  `needs`, once, in arrival order. An id in ahead_layer's queue moves to `needs`. An id that
  ahead_layer has on its way becomes a need's (`_needed`), so the next ahead_layer call,
  which drops its own experts on their way, keeps it. A hint for the queue's layer never
  queues an id that `needs` holds.
- Idle polls start a need before any queued ahead expert (`_next_ahead` calls `_next_need`
  first). Each need takes its slot when its first part goes; its tag goes with its last part,
  then its entry, all in the same poll, flushed before the poll returns. halt_aware holds and
  read-ahead apply as to any idle part (13.12). A request that names a need on its way
  promotes it, as it would a hint's expert. Requests' `drop` never withdraws a need.
- Victims (`_at`, `_pool_slot`): the running layer j is set by each need line and each request.
  While the prefill is expert-major, no victim comes from layers j - 1, j and j + 1 (mod
  layers), for a need's slot, a request's miss and an ahead expert alike. A need with no such
  victim stops with an error; it is never dropped.
- Tags: the first need line of layer j + 1 means layer j's expert run is done, and that run
  zeroed the tag of every expert its need lines named. Those slots leave `armed`, so reusing
  one later costs no zero-tag write first (one DMA call each: about 138 a layer on the 35B).
- `begin_prefill(expert_major=True, scratch=bytes)` returns the scratch's base: the slot
  region's first ceil(bytes / pitch) slots, from the first slot on (`Layout.scratch`, the same
  as the card side's `moe.em_slots`: one span across layers if it needs to, and the programs
  take the address from the layout alone; 13.11 said the last). Those slots leave the free
  lists. Their experts are evicted, and their entries cleared and flushed, before the base is
  returned. No slot of the scratch is handed out until end_prefill.
- `end_prefill` serves the last post (settle), drops ahead_layer's queue, then sends every need
  still queued or on its way whole (`drained` counts them; the expert runs waited on them all,
  so a nonzero count means a run did not). It zeroes the scratch's tag beats (scratch data in a
  tag beat would read as a landed expert's tag), returns those slots to the free lists, and
  restores each layer's slots as before.
- `need_report()`, for the Engine's error on an expert run's WAITW timeout (Board's 'a WAITW
  timed out', the ISA's 'never holds'): the running layer's needed experts whose entries are
  not present, and for each whether it is on its way (bytes sent), queued, or in no slot.
- Counters: `need_lines`, `needs_queued`, `need_hits` (ids already in a slot), `needs_landed`,
  `drained`.
- On the ISA simulator, the Engine's WAITW hook (`qwen3._isa_host`) polls until a waiting
  slice's WAITW holds (`isasim.Slice.holds`), or until a poll has nothing to do. The simulator
  calls its host once when every slice waits, and a wait still not holding after that is the
  timeout. A request is served whole in one poll, but an expert run waiting on a need's entry
  takes one idle poll a part. The card's backend polls the same way while a run is in flight.

Checked against the card side (gemma4's expert-major 2ad3129 merged onto this, not pushed):
test_qwen35_moe's `test_expert_major_prefill_is_bit_exact` (4 cases) and test_gemma4_moe's
`test_moe_expert_major_prefill_is_bit_exact` (3 cases) pass with this ExpertServer in place of
their stand-in. The logits, states, KV and decode are bit for bit; up to 48 needs land on
victims outside the guarded layers, and none is drained at end_prefill.

Open points for the card A/B:
- In expert-major mode only requests count a use, so end_prefill's lazy restore keeps
  each layer's earliest-landed experts (ties keep LRU order).
- Whether halt_aware should hold needs at all. On the 35B the mixer phase is link-bound
  (13.11), so a hold there idles the link.

Tests (test_offload_server):
- `test_a_need_line_queues_its_experts_and_idle_polls_land_them_ahead_of_the_queue`;
- `test_a_need_takes_over_an_ahead_expert_and_no_ahead_layer_call_drops_it`;
- `test_expert_major_victims_spare_the_running_layer_and_its_neighbours`;
- `test_the_next_layers_need_line_disarms_the_tags_the_expert_run_zeroed`;
- `test_end_prefill_drains_the_needs_and_hands_the_scratch_back_with_zeroed_tags`;
- `test_need_report_names_the_running_layers_experts_without_an_entry`.

Each test fails with its rule removed: the victims' guard, the scratch's removal from the free
lists, the drain, the disarm, the tag zeroing.

### 13.15 Expert-major on the card (session pfB)

Session pfB ran 13.13's plan on 2026-10-12, 00:49-00:58 by the card host's clock: 14 runs under one
otpu-lock for 9.3 minutes, all bit for bit.
- Card: production deploy_mt4_91a9c2d3 as loaded (build 91a9c2d3, register map 4). Its selftest
  passed before and after, and the device configuration equalled production's qual/cfg.pkl.
- Tree: main ee8f118d, whose opentpu/ is production host 23b68089's.
- Script: tools/offload/sessions/pfB.sh. Logs: the card host ~/otpu-build/moe-ab/pfB.
- A first launch stopped at its selftest's config stage, before any run. The tree copy lacked
  targets/, which opentpu.target reads since the multi-target work, so a card tree needs
  targets/ beside opentpu/.

How it ran:
- Per model, a discarded warm-up run W (arm B), then A B C C B A.
- Arms:
  - A: today's default (`--layer-major 2`, pooled, no layer-ahead);
  - B: `--expert-major`;
  - C: `--layer-ahead hint`.
- Every arm: `--idle-parts v2 --ahead-part 4096`, slots filling the DRAM, lfu.
- 35B: Qwen3.5-35B-A3B, lmtime's 134-token prompt, 16 tokens, 42 slots a layer, fp4 with an int8
  head, the embedding table on the host, hints off.
- 26B: gemma-4-26B-A4B-it, q26-hf.json's 124 rows as plain text, 16 tokens, 18 slots a layer.
  The instruct checkpoint and its pool have been the 26B since 2026-10-09; the base checkpoint and
  its pool are no longer on the card host.
- Images: each model's image was built once, in its W (70 s and 78 s), into a cache of the
  session's own, removed after. Every other run loaded in 7-10 s. moe_card's images never hit
  chat's cache entries, because their keys differ in the KV capacity (4096) and OTPU_FORMATS.

The references:
- 35B: every run gave sha 9c4f41d27ced99f1 and the tokens [8160, 579, 264, 7047, 1817, 421, 11177,
  310, 279, 11488, 2468, 25, 271, 16, 13, 220].
  - The 16 tokens are pfv2's (2026-10-02).
  - The sha is not (95426ebacc3b40a9 then). Fix-math (2026-10-08) changed the logits, not the
    picks.
- 26B: every run gave 730fc57cf74123ef and [108, 19780, 236772, 1074, 236772, 1074, 236772,
  12592, 569, 236772, 107, 19780, 236772, 1074, 236772, 1074].
  - No earlier reference applies: q26ref16 (90e6b6e06e19da99) is the base checkpoint's.
  - An instruct checkpoint given the prompt as plain text repeats itself. Here it is a timing
    prompt.
- So the pass rule was: every run equal to its model's W, which made A equal to B.

The prefill's wall time (prefill_time's wall_s):

| | A1, A2 | B1, B2 | pairs B - A | mean B - A | predicted | C1, C2 | pairs C - A | mean C - A |
|:--|:--|:--|:--|--:|--:|:--|:--|--:|
| 35B, s | 12.952, 12.738 | 10.852, 11.009 | -2.100, -1.729 | **-1.914** | -1.7 | 12.202, 12.148 | -0.750, -0.590 | -0.670 |
| 26B, s | 16.179, 16.263 | 14.393, 14.482 | -1.786, -1.781 | **-1.784** | -1.9 | 16.258, 16.181 | +0.079, -0.082 | -0.002 |

Where the time goes (each arm's mean of its two runs; prefill_time and the prefill traces):

| | 35B A | 35B B | 35B C | 26B A | 26B B | 26B C |
|:--|--:|--:|--:|--:|--:|--:|
| device, s | 11.89 | 9.95 | 11.20 | 15.76 | 13.47 | 15.18 |
| halts seen late (halted - device), s | 0.49 | 0.54 | 0.48 | 0.27 | 0.76 | 0.81 |
| mixer (layer) runs' wall, s | 11.66 | 6.19 | 10.98 | 16.11 | 10.63 | 16.08 |
| expert runs' wall, s | | 3.55 (40) | | | 3.69 (30) | |
| the prompt's requests / misses | 2720 / 6209 | 120 / 643 | 2720 / 2201 | 1860 / 2265 | 0 / 0 | 1860 / 237 |
| serve, s | 6.28 | 0.61 | 2.72 | 4.53 | 0 | 1.01 |
| need lines / needs landed / drained | | 2600 / 5505 / 0 | | | 1860 / 2248 / 0 | |
| idle parts: holds, part ms | 0 | 29.1K, 0.92 | 27.8K, 0.94 | 0 | 39.3K, 1.97 | 35.0K, 1.85 |

- The gain is the device's.
  - On the 35B the device time falls 1.94 s and the wall 1.91 s. The prompt's demand misses (A:
    6209, 6.3 s of serving while the card waits) become needs streamed in idle parts during the
    mixer runs: 5505, every one landed, none drained. Only the three token steps' requests are
    left (643 misses).
  - Each chosen expert runs once a layer, on the rows that chose it, instead of once in every
    run whose rows chose it.
- An expert run takes 89 ms a layer on the 35B and 123 ms on the 26B, wall, including its waits on
  needs not yet landed. 13.11's kernel costs give *about 60 and 111 ms* with every need landed
  (564 / 517 passes a layer; the card does not count them).
- The 26B leaves about 0.5 s on the table. Its device time falls 2.29 s, but its halts are seen
  0.49 s later than A's: B's mixer runs end with an idle part in flight (A sends none), as C's do
  (0.81 s). 13.12's untried step would serve both: near a run's end, send a part sized to the
  time left.
- C against A: -0.67 s on the 35B (both pairs) and nothing on the 26B. There the device time
  falls 0.58 s and the halts come 0.54 s later. B beats C by 1.24 s (35B) and 1.78 s (26B).
- The decode after the prompt (16 tokens, the card's loop) was bit for bit in every arm. It was
  faster after B:
  - 35B: 5.20 / 5.06 tok/s against A's 4.98 / 4.96, with 97.9 misses a token against 103.3;
  - 26B: 3.53 / 3.54 against 3.40 / 3.35.
  In expert-major only requests count a use, so end_prefill's lazy restore keeps each layer's
  earliest-landed experts (13.14's open point), and over 16 tokens that start is better. Not
  measured over a longer decode.
- The warm-up runs, discarded:
  - 35B W: 16.34 s. Its image build left 15.97 of the pool's 17.11 GB in the page cache, and its
    read-ahead took 5.4 s of host time.
  - 26B W: 14.42 s, as its B runs.
- moe_card reports `misses_per_token_decode` as null for a run with no request in its prompt (the
  26B's B). `pre` counts the prompt's requests, and 0 reads as token by token. Not fixed here.

The rule (13.13): B becomes the 35B and 26B prefill default only if both models gain and the 35B
gains at least 0.5 s. **B meets it**: every pair is negative, and the 35B gains 1.91 s.

The default (since 2026-10-12, after the session):
- streamed.engine (otpu-chat, otpu-serve, chatmoe, moe_card): `expert_major=None` turns it on
  wherever the prompt is layer-major with pooled slots and no layer-ahead, that is for
  Qwen3.5-MoE and Gemma 4 MoE. LFM2-MoE's prompt stays token by token.
- It also needs room for its needs (`streamed.expert_major_fits`). While layer j runs, the server
  takes no victim from layers j - 1, j and j + 1, whose experts can hold up to 3 E slots. So the
  pooled slots, less the scratch of the largest chunk (the image's 512 prefill rows), must be at
  least 3 E.
  - The card, from its layouts: the 35B has 1720 - 26 = 1694 slots at chat's KV capacity and
    1654 at moe_card's, against 768; the 26B has 540 - 17 = 523, against 384.
  - With fewer slots the prompt stays layer-major. The first version of this default had no such
    check, and the gate failed 12 chat tests: the tiny models' 2 slots a layer met "no slot
    outside layers [j - 1, j, j + 1]".
- What turns it off: `expert_major=False` (moe_card `--no-expert-major`), each layer's own slots
  (`--per-layer-slots`), `--layer-ahead`, or `--layer-major 0`.
- Its needs go in whole-expert idle parts: `streamed.NEED_PART`, 4 MiB, as this session ran.
  `--ahead-part` overrides it; the hints keep qwen3.AHEAD_PART's 1 MiB.
- moe_card: `--expert-major` is the default with `--layer-major R`. `prefill_requests` and the
  decode's misses a token now count a layer-major prompt that made no request (they were null).
- Only opentpu/host/streamed.py changed, so the image and program keys are the same and the
  image cache's entries still hit.
- Since 13.16 the default is expert-major only in a prompt's calls of at least EM_ROWS new rows.

### 13.16 Expert-major from a prompt length on (session emdef, EM_ROWS)

Session emdef ran the default on the card on 2026-10-12, 10:17-10:33 by the card host's clock (the
lead's run of tools/offload/sessions/emdefault.sh).
- Card: production deploy_mt4_91a9c2d3 (build 91a9c2d3, register map 4).
- Hosts: the candidate deploy_em_91a9c2d3 (N, 950ff0c5) against production's (P, 23b68089).
- The production qual's chatmoe step and otpu-chat by name passed from N, token-exact.
- Per model a warm-up, then P N N P. Each run was a chatmoe.py chat of three turns: TURNS' two,
  then lmtime's passage with a question. Every run gave its model's tokens.

TTFT, N - P:

| turn: new tokens (35B / 26B) | 35B pairs, s | 35B mean | 26B pairs, s | 26B mean |
|:--|:--|--:|:--|--:|
| 1: 24 / 25 | +0.354, +0.637 | **+0.495** | +0.091, -0.055 | +0.018 |
| 2: 31 / 31 | +0.296, +0.482 | **+0.389** | -0.509, -0.213 | -0.361 |
| 3: 163 / 162 | -2.310, -2.113 | -2.211 | -2.164, -2.133 | -2.149 |

- The device time moved with it on the 35B: +0.52, +0.40 and -2.28 s.
- The 26B's first turn lost the device's -0.27 s on the host: TTFT +0.02 s.
- The decode after the prompt: 35B +0.13 to +0.18 tok/s, 26B -0.07 to +0.13.
- Not swapped: the 35B's short turns lose up to half a second.

Why the 35B's short prompts lose:
- **A turn is two calls.** With state to keep (the 35B's DeltaNet layers; the 26B's sliding
  rings, 1024 positions and an attention block, shorter than chat's 2048) chat runs a turn's
  prompt in two prefill_layers calls: up to the snapshot at the reply's start (14.2's turns),
  then the 4 rows after it, the generation prompt's empty thinking block, which the next turn
  rolls back over. Each call carries all its fixed costs: an expert run a MoE layer (40 on the
  35B), need lines, a scratch. The 35B's 24-token turn was 3 token steps and 17 rows, then 4
  rows; its 31-token turn 27 rows, then 4.
- **Where needs land.** The needs stream in idle parts while the runs go. pfB's traces (13.15,
  131 rows) give what each costs:

  | | 35B | 26B |
  |:--|--:|--:|
  | layer-major run (A), wall, ms | 4.47 | 8.58 |
  | A's request: fixed + a miss, ms | 0.50 + 0.82 | 0.47 + 1.59 |
  | expert-major mixer run (B), wall, ms | 2.35 | 5.62 |
  | B's idle part (a whole expert), seen to done, ms | 1.06 | 1.89 |
  | B's needs a layer: landed in the mixer runs / in the expert run | 75 / 62 | 75 / 0.3 |
  | B's mixer runs / expert run a layer, wall, ms | 156 / 86 | 352 / 123 |

  - At 131 rows the 35B's mixer runs carry half a layer's needs; the expert run waits for the
    rest, 65 of its 86 ms in parts.
  - The 26B's mixer runs carry all of them, so its expert run is compute alone.
- **The short call.**
  - The 35B's 17-row call has 9 mixer runs a layer, about 21 ms. A layer needs up to about 66
    experts (P's 2659 layer-major misses in that turn's two calls, over 40 layers), about 70 ms
    of idle parts.
  - So most needs land while the expert run waits. Each costs 1.06 ms against a layer-major
    miss's 0.82, and the expert run adds its fixed costs a layer: its start and halt, its tables,
    and halt-aware's held parts near its expected end.
  - What grows with the rows does not cover it at this length: each chosen expert runs once a
    layer, and more needs hide behind the mixer runs.
  - The 4-row call is all fixed cost; *about +0.2 s a turn* (estimated, not measured).
- **The 26B.** Its mixer runs are 2.4 times as long, so its first turn's 21-row call, 11 runs a
  layer (62 ms), already carries part of its needs, and the turn breaks even with its 4-row call.
  Its expert-major runs' halts are seen later: an idle part of 1.89 ms is in flight at a mixer
  run's end (pfB: 0.38 ms a run against 0.14 layer-major).
- *An estimate of the crossover.* Both arms a layer from these costs, the needs about 0.55 (35B)
  and 0.6 (26B) of the distinct experts a call's rows choose, and an expert-major call's fixed
  cost fitted to the three turns (about 4.5 and 6 ms a layer): the 4-row call costs about +0.2 s
  (35B) and +0.13 s (26B); the 35B's call breaks even at about 33 rows (28-40 within the fit's
  error), and the 26B's 21-row call already gains on the device.

The threshold (streamed.EM_ROWS):
- A prefill_layers call runs expert-major only with at least EM_ROWS new rows: Qwen3.5-MoE 44
  (48 at first), Gemma 4 MoE 20 (24 at first). Below, it runs as production's: layer-major,
  pooled, a request a run.
  - 48 lay above the 35B's estimated crossover; emdef2 measured it at about 37 rows, so 44.
  - 24 lay between the 26B's 21-row call (even, with its 4-row call's cost) and its 27-row call
    (-0.36 s with it). emdef2 and emdef3 measured the 21-row call expert-major in four pairs, a
    gain on the device in each, so 20 (emdef3 below).
- So a turn's 4 rows after its snapshot always run layer-major, and its part before it from 44
  rows (35B) or 20 (26B).
- `streamed.gate_expert_major` sets Engine.expert_major for each call and swaps the layer runs'
  compiled programs per mode: a run's key does not hold the mode, and an expert-major run posts
  needs where a layer-major one requests its experts. After the call the Engine is expert-major
  again. eng.em_rows, eng.em_last (the last call's rows and mode) and eng.em_calls tell what ran.
- `em_rows` overrides it (streamed.engine, chatmoe.py `--em-rows`); 0 runs every call
  expert-major. An explicit `expert_major=True` (moe_card `--expert-major`) is every call.
- Only opentpu/host and tools changed: the image and program keys stay.
- chatmoe.py reports each turn's calls: rows, mode, wall and device seconds, runs, the server's
  counts (misses, needs, parts, holds), and the host's time on its requests and idle parts
  (`serve_s`, `parts_s`). `--trace` adds each call's runs and the server's timeline. It passes
  `em_rows` only when given, so it also runs on a tree without it (production's).

Session emdef2 (tools/offload/sessions/emdef2.sh) checked the threshold (then 48 / 24) and found
the crossover. It ran on 2026-10-12, 11:39-12:03 by the card host's clock.
- Same card, hosts and checks as emdef. N was 0c2b6f6a.
- Five turns continuing one context: about 24, 31, 49, 80 and 163 new tokens on the 35B (TURNS'
  two, a question, a request, lmtime's passage with a question).
- Arms: P (production), N (EM_ROWS), X (`--em-rows 8`: every call but the 4-row ones
  expert-major). A warm-up (N), then P N X X N P.
- Everything passed and every run was token-exact. Not swapped: the 35B's turn 2 failed the rule.

TTFT against P, s (pairs; L layer-major, E expert-major; each turn also has a 4-row call, always L):

| turn: new tokens | 35B N's call | 35B N - P | 35B X - P | 26B N's call | 26B N - P | 26B X - P |
|:--|:--|:--|:--|:--|:--|:--|
| 1: 24 / 25 | 20 L | -0.018, -0.020 | +0.306, +0.273 | 21 L | +0.179, -0.132 | -0.170, -0.017 |
| 2: 31 / 31 | 27 L | **+0.400, +0.515** | +0.198, +0.347 | 27 E | -0.425, -0.468 | -0.678, -0.657 |
| 3: 49 / 50 | 45 L | -0.157, -0.015 | -0.240, -0.175 | 46 E | -0.782, -1.036 | -0.766, -0.980 |
| 4: 80 / 79 | 76 E | -0.697, -0.734 | -0.827, -0.964 | 75 E | -1.295, -1.546 | -1.488, -1.460 |
| 5: 163 / 161 | 159 E | -1.758, -2.372 | -2.108, -2.158 | 157 E | -2.408, -2.494 | -2.422, -2.540 |

- **The crossover (X - P).** The 35B's expert-major call loses at 20 and 27 rows (+0.29, +0.27 s)
  and gains from 45 (-0.21 s), so it breaks even at about 37 rows. The 26B's already gains at 21
  rows (-0.09 s).
- **The 4-row call.** With it layer-major (X) the 35B's 24- and 31-token turns lost 0.29 and 0.27
  s, against emdef's 0.50 and 0.39 with it expert-major: about +0.1 to +0.2 s a turn, as
  estimated.
- **N's 35B turn 2.** Its 27-row call ran layer-major, as P's, and took +0.46 s.
  - The misses were the same as P's (3535 in the prompt, 3136 in that call), and the device time
    was +0.22 / +0.35 s (31 tokens at 7.27 / 7.06 tok/s against 7.66 / 7.68).
  - On the ISA simulator the two run the same calls: a 3-turn chat of the tiny Qwen3.5-MoE (2
    slots a layer, a Qwen3-shaped template, so two calls a turn) through production's tree
    (23b68089) and through 0c2b6f6a's gated engine (expert-major built, every call below
    em_rows). Every call compiled the same layer runs (13 keys, the same program words, none
    compiled after turn 1 in either), made the same requests and left the same slot map, with
    the same snapshots and tokens.
  - So the card ran the same work. The extra device time is its waits on the host. N1's trace
    shows that call's requests served at 0.92-0.96 ms a miss all along it, against 0.82-0.89 in
    the same run's turn 3 and 0.83-0.96 in its turn 1. emdef2 recorded the host's time for N and X
    only, so P's cannot be compared.
  - The host's time varies by turn and run without a code change. The decode, the same misses in
    every arm, ran 4.86 / 5.22 tok/s in N's turn 2 against P's 5.06 / 5.09. The warm-up's turn 3
    (N's settings, its first run after a pool read) took +0.43 s of device time.

EM_ROWS then: Qwen3.5 44 (the crossover about 37; both pairs gain at 45), Gemma 4 24.

Session emdef3 (tools/offload/sessions/emdef3.sh) checked EM_ROWS 44 / 24 and the host's share.
It ran on 2026-10-12, 12:50-13:15 by the card host's clock, at ff4bb8e9.
- emdef2's arms, turns and checks. P ran this tree's chatmoe.py on production's opentpu
  (PYTHONPATH): the tool only records, so P's calls have the same counts as N's and X's and their
  requests' host time (`serve_s`). Every run but the warm-up wrote its trace, and the host's load
  was logged before each (0.8-3.1; top showed no 1Password / Hyprland spin).
- Everything passed and every run was token-exact. The 35B passed the rule (N - P, mean of the
  pairs: -0.03, +0.06, +0.06, -0.89, -2.33 s; the first three pairs straddle zero). The 26B did
  not, at its first turn.

TTFT against P, s (pairs):

| turn | 35B N's call | 35B N - P | 35B X - P | 26B N's call | 26B N - P | 26B X - P |
|:--|:--|:--|:--|:--|:--|:--|
| 1 | 20 L | +0.100, -0.158 | +0.474, +0.307 | 21 L | **+0.197, +0.135** | +0.112, -0.267 |
| 2 | 27 L | +0.190, -0.076 | +0.231, +0.132 | 27 E | -0.648, -0.253 | -0.555, -0.499 |
| 3 | 45 E | -0.073, +0.190 | -0.053, -0.184 | 46 E | -1.023, -0.885 | -0.936, -0.824 |
| 4 | 76 E | -0.898, -0.887 | -0.861, -0.963 | 75 E | -1.472, -1.251 | -1.375, -1.304 |
| 5 | 159 E | -2.325, -2.325 | -2.394, -2.348 | 157 E | -2.376, -2.551 | -2.304, -2.492 |

The 26B's first turn:
- Its 21-row call ran layer-major in both arms, with the same requests in each: 330 requests,
  1516 misses, request by request the same layers and misses.
- N served them for longer: `serve_s` 2.921 / 2.782 s against 2.710 / 2.681. The device time was
  4.073 / 4.020 against 3.975 / 3.968 s, the 4-row call after it the same in all four.
- N1's excess is localized. By fifths of the call, its requests took +0.18, -0.21, +1.51, +1.18
  and +0.54 ms each against P1's. Its halts were also seen later (run wall less device, median
  0.60 ms against 0.38-0.41), as were the 35B N1's (0.55 and 0.62 against 0.36-0.53). N2's
  excess was +0.07-0.10 s (+0.22 ms a request against N1's +0.64).
- The same arm varies as much elsewhere. The 35B's P2 against P1: +0.115 and +0.121 s of
  `serve_s` in its first two calls (+0.24 and +0.22 ms a request), more than its N1's against P1
  (+0.18 and +0.21 ms) and as much as the 26B's N2.
- Gaps move between sessions on the same code. The 35B's turn-2 gap of emdef2 (+0.46 s; the same
  27-row layer-major call) was +0.06 s here. The 26B's turn 1 was +0.02 s in emdef2 and +0.17 s
  here.
- Host-side checks (no card):
  - The code a layer-major call runs in N is production's. Since 23b68089, opentpu/ changed only
    in host/streamed.py: the default, the gate, ahead_part = NEED_PART (read only by expert-major
    and hint prefills). The server, pool file, pool map, willneed, read-ahead and halt-aware
    settings are the same, and no thread was added: the pool's warm read and the DMA worker are
    production's.
  - The ISA comparison (emdef2's: the same calls, programs, requests, slots and tokens).
  - A host microbenchmark, the server's time a request on the ISA backend, the tiny model with 2
    slots a layer, 40-token prompts, alternating production's tree and N's gated engine. Medians
    30.5 µs (N) and 30.6 µs (P), 10 prompts each. The outliers (+15-50 %) came in both arms, with
    a laptop's gate running beside it.
- So no host-side difference in the code was found. The gaps are run-to-run host time, which
  ABBA pairs of one run each do not average out at these lengths.

EM_ROWS since: Qwen3.5 44, Gemma 4 20. The 26B's first turn (21 rows) is then expert-major.
X - P there over four pairs (emdef2, emdef3) is -0.170, -0.017, +0.112 and -0.267 s TTFT, mean
-0.086. Its device time against P's is -0.41, -0.23, -0.18 and -0.56 s, a gain in every pair.

Session emdef4 (tools/offload/sessions/emdef4.sh) checks EM_ROWS 44 / 20 for the
swap, short:
- The same card, hosts and checks (selftest, configuration, the qual's chatmoe step, whose 26B
  turns are now both expert-major, and otpu-chat by name).
- Per model, emdef2's first three turns, P and N, every run traced.
- A warm-up, then ORDER: P1 N1 N2 P2 by default. `ORDER="P1 N1 N2 P2 N3 P3 P4 N4"` gives two
  balanced ABBA blocks for about 8 minutes more. The run after P1 was N's slower one in each
  model of emdef3, and in both emdef2 turns that missed.
- The summary: each run's TTFT and device time per turn, N - P per pair and of the means, and
  each run's layer-major host ms a miss.

The lead ran emdef4 on 2026-10-12 at 7f815b57 in the balanced order (four pairs). It was
token-exact, everything passed, and the chatmoe step and otpu-chat exited 0. N - P of the means,
TTFT, s:

| turn | 35B (N's call) | 35B | 26B (N's call) | 26B | 26B device |
|:--|:--|--:|:--|--:|--:|
| 1 | 20 L | -0.006 | 21 E | -0.083 | -0.37 |
| 2 | 27 L | -0.058 | 27 E | -0.029 | -0.28 |
| 3 | 45 E | -0.053 | 46 E | -0.883 | -1.31 |

- The layer-major calls' host ms a miss came out even across the arms.
- With emdef3's long turns (35B -0.89 and -2.33 s, 26B -1.36 and -2.46 s), the rule holds: no
  turn is worse, and the long ones are much faster.
- In production since 2026-10-12 16:26 local (15:26:30 by the card host's clock): deploy_em_91a9c2d3,
  host 7f815b57, promoted host-only by its promote.sh (scrub and selftest passed on build
  91a9c2d3, link 5.0 GT/s x8). production-prev is deploy_mt4_91a9c2d3.

### 13.17 The expert run in the co-sim (tools/moe_prefill_cosim.py em)

`moe_prefill_cosim.py em MODEL_DIR --rows ...` co-simulates one MoE layer's expert run
(compile_expert_run) on a chunk of rows. It uses the RTL with the card's LiteDRAM controllers,
DDR3-1066, the core at 133.33 MHz and build B's configuration. The image is zeros (config.json
only), and the DRAM holds the server's words as an expert-major prefill has them once every
expert its chunk needs has landed:
- each row's record in the scratch on the first slots, its tail holding the k global ids, the
  weights and 1 / rms;
- each expert the rows chose in a pooled slot of its own after the scratch, with its tag set and
  its directory entry {slot, 1.0};
- the layer's gbase.

Routing:
- By default each row takes k distinct experts, uniformly, from `used` of them: the prompts'
  measured 144 of the 35B's 256 and 75 of the 26B's 128.
- `--route` takes a router trace's layer-local ids instead.
- With the defaults the passes match the router traces' windows (13.11): 565 against 564 on the
  35B at 131 rows, and 515 against 517 on the 26B at 124.

After the run:
- every used expert's tag must be zero and every (row, rank) output written, or the tool raises;
- the check fails on the DRAM before the run, and a missing entry stops the run.

The record: passes, cycles, the DRAM bytes by kind (em_bytes, in whole lines), and layer-major's
passes on the same ids.
- Its lm2 passes overstate a prompt's, because the synthetic rows are independent.
- `--isa` runs the ISA simulator: the check, no cycles.
- `--set KEY=VALUE` overrides the configuration (MCOLS=16, or a branch's fields such as SEQ_WC).

Measured on the simulation host, 2026-10-12, at 7f815b57 with the harness of dc26103b; every check passed.
The layer is the first; ms is a layer's expert run.

| model | rows | experts | passes | cycles | ms | ms a row | ms a pass | MB a row (weights) | GB/s |
|:--|--:|--:|--:|--:|--:|--:|--:|--:|--:|
| 35B | 16 | 80 | 89 | 1329816 | 9.97 | 0.623 | 0.1121 | 9.48 (9.30) | 15.2 |
| 35B | 131 | 144 | 565 | 8425295 | 63.19 | 0.482 | 0.1118 | 7.35 (7.21) | 15.2 |
| 35B | 512 | 144 | 2081 | 31025443 | 232.70 | 0.454 | 0.1118 | 6.93 (6.79) | 15.2 |
| 26B | 16 | 64 | 81 | 2557432 | 19.18 | 1.199 | 0.2368 | 17.68 (17.45) | 14.8 |
| 26B | 124 | 75 | 515 | 16236422 | 121.78 | 0.982 | 0.2365 | 14.50 (14.32) | 14.8 |
| 26B | 512 | 75 | 2066 | 65124417 | 488.45 | 0.954 | 0.2364 | 14.09 (13.91) | 14.8 |

- The expert run streams at 15.2 GB/s (35B) and 14.8 GB/s (26B): 89 % and 87 % of the two
  DDR3-1066 channels' 17.06 GB/s.
  - The experts' weights are 98-99 % of its bytes: an expert, 1.67 MB (35B) or 3.45 MB (26B),
    each pass.
  - The rows' inputs and outputs are 0.13-0.23 MB a row; the tables and words under 1 kB.
- A pass costs the same at every chunk size: 0.112 ms (35B) and 0.236 ms (26B).
  - That is c(2) (13.11: the expert's FFN alone, 0.100 / 0.210) plus 12 / 27 µs.
  - The excess grows with the expert's size, so it is the stream's rate, not a fixed cost a pass.
- Bytes a row against layer-major R = 2 on the traces' routing (840 passes on the 35B's 131-row
  windows, 767 on the 26B's 124):
  - 35B: 10.72 MB of expert weights a row, against expert-major's 7.21 (-33 %).
  - 26B: 21.32 against 14.32 (-33 %).
- At 16 rows nearly every expert has one or two entries (89 passes for 80 experts on the 35B), so
  a row costs 1.2-1.3x what it does at 124-131.

A pass's row capacity. A pass streams its expert's weights once for up to C of its entries, so a
layer makes sum_e ceil(n_e / C) passes. C is 2 today: PAIR, and c(M) grows with each pair of rows
(13.11). The expert weight bytes a row are those passes x the expert's bytes / rows.

Method:
- The router traces: ~/otpu-build/offload/traces on the build host, four texts x 2048 tokens, every MoE
  layer's top-k.
- Every non-overlapping window of W prompt rows, every layer, means over them.
- Computed with tools/offload/em_capacity.py; no RTL.

| model | W | distinct | layer-major R = 2 | C = 2 (today) | C = 32 | C = 64 |
|:--|--:|--:|--:|--:|--:|--:|
| 35B | 131 | 138 | 845 passes, 10.77 MB | 564, 7.19 MB | 147, 1.87 MB | 140, 1.79 MB |
| 35B | 512 | 194 | 3292, 10.75 | 2100, 6.85 | 262, 0.85 | 217, 0.71 |
| 26B | 124 | 72 | 764, 21.25 | 516, 14.34 | 84, 2.32 | 75, 2.07 |
| 26B | 512 | 91 | 3156, 21.25 | 2072, 13.95 | 185, 1.25 | 127, 0.86 |

(MB: the expert weights a prompt row, a layer.)

- Against today's C = 2:
  - C = 32 cuts the dominant byte stream by 74 % (35B) and 84 % (26B) at 124-131 rows, and by
    88 % and 91 % at 512.
  - C = 64 cuts it by 75 % and 86 %, and by 90 % and 94 %.
- At 124-131 rows C = 32 is already near the floor of one pass per distinct expert (138 and 72).
  The extra gain of 64 shows at 512 rows, where the popular experts have more than 32 entries.
- The traces reproduce the co-sims' C = 2 passes: 564 and 516 against the synthetic routing's
  565 and 515.

The ISA check:
- The harness counts the ISA's passes (`isa_passes`: its WAITWs) and checks them against the
  bucketing.
- The prose trace's layer 0, first window (35B 131 rows, 210 experts; 26B 124 rows, 78) runs 580
  and 516 passes.
- With `--set MCOLS=16 --set ACT_ROWS=64` it runs the same passes, the same instruction count and
  the same check.
- So today's kernel pairs its entries whatever the configuration. C = 32 or 64 needs:
  - the expert run's pass table to take up to C entries a pass (its bucketing closes a pass at C);
  - a pass to load, quantize and store up to C rows;
  - an MXU that takes them at the stream's rate (dsp-pump's MCOLS 16 with ACT_ROWS 64,
    mx_mxu.md 10).

The balance point (em_capacity.py, the same windows; no new RTL). The model:
- A pass of m entries takes max(S, c(m)).
  - S is its expert's stream: the co-sim's pass at C = 2, 0.112 ms (35B) and 0.237 ms (26B).
  - c(m) = ceil(m / 2) x c(2) / x on an MXU x times today's, with c(2) = 0.100 and 0.210 ms
    (13.11). The measured c(4) and c(8) are within 3 % and 7 % of this.
- Each window's actual passes are counted, the part-filled last ones included.
- At C = 2 it reproduces the co-sim: 0.481 / 0.984 ms a row.

ms is a layer's expert run, per prompt row:

| model | rows | C | MB a row | ms a row, today | ms a row, MXU 4x |
|:--|--:|--:|--:|--:|--:|
| 35B | 131 | 2 | 7.19 | 0.481 | 0.481 |
| 35B | 131 | 4 | 4.16 | 0.438 | 0.278 |
| 35B | 131 | 8 | 2.72 | 0.436 | 0.182 |
| 35B | 131 | 32 | 1.87 | 0.435 | 0.163 |
| 35B | 512 | 2 | 6.85 | 0.459 | 0.459 |
| 35B | 512 | 4 | 3.61 | 0.413 | 0.241 |
| 35B | 512 | 8 | 2.00 | 0.412 | 0.134 |
| 35B | 512 | 32 | 0.85 | 0.411 | 0.115 |
| 26B | 124 | 2 | 14.34 | 0.984 | 0.984 |
| 26B | 124 | 4 | 7.76 | 0.883 | 0.532 |
| 26B | 124 | 8 | 4.52 | 0.880 | 0.310 |
| 26B | 124 | 32 | 2.32 | 0.878 | 0.265 |
| 26B | 512 | 2 | 13.95 | 0.957 | 0.957 |
| 26B | 512 | 4 | 7.15 | 0.853 | 0.490 |
| 26B | 512 | 8 | 3.75 | 0.852 | 0.257 |
| 26B | 512 | 32 | 1.25 | 0.851 | 0.223 |

- Today the stream and the MXU meet at C = 2.2 (35B) and 2.3 (26B), so the expert run is nearly
  balanced as it is.
  - A C = 4 kernel still pays on the card: -9 to -11 % of the run's time, and the bytes nearly
    halved (less contention with the link's H2C writes, 13.11).
  - Beyond 4 the run is compute-bound: the time stays put while the bytes keep falling.
- An MXU 4x faster (MCOLS 16) meets the stream at C = 8.9 and 9.0.
  - C = 8 then cuts the run by 62-73 %, C = 32 by 66-77 %.
  - At 124-131 rows little is left past C = 8. Most experts' one pass is stream-bound (140 x
    0.112 ms, 0.12 ms a row on the 35B), and only the popular ones are compute-bound.
- In general the stream and the MXU meet at C* = 2 S x / c(2). For passes of 32 or 64 rows to
  stay stream-bound, the MXU must take an expert's 32 or 64 rows in its stream time: about 14x or
  29x today's MXU against today's DRAM. That is the MXU-to-DRAM ratio MoE prefill wants from an
  ASIC.

### 13.18 Passes of C entries (moe.em_pass_rows)

The expert run's bucketing closes a pass at C entries of one expert, not two. Each pass loads,
norms and quantizes up to C rows, streams its expert once and stores the rows' outputs. C comes
from the configuration alone; there are no per-model constants.

The rule (moe.em_pass_order, em_pass_rows):
- A pass of m entries costs max(EM_RHO, em_mxu_cost(m)) MXU cycles per chunk of the expert's
  weights: the stream, or the MXU when that takes longer.
  - EM_RHO = 1.12: the stream's cycles per chunk on the card (17.07 / 15.2 GB/s, 13.17).
  - em_mxu_cost(m): 4-bit weights with PAIR and 2 m <= MCOLS take 1; other 4-bit passes take
    2 ceil(m / MCOLS); int8 takes ceil(m / MCOLS).
- C is the m <= ACT_ROWS with the least cost per entry, the fewest rows on a tie. Any EM_RHO in
  (1, 2) gives the same order. This is 13.17's C* = 2 S x / c(2), rounded to what the MXU's
  rows allow.
  - The card (MCOLS 4, PAIR, ACT_ROWS 4): C = 4. Two rows cost the stream (1.12 / 2 = 0.56 an
    entry); four cost twice the MXU's cycle (2 / 4 = 0.5).
  - MCOLS 16 with ACT_ROWS >= 16, 4-bit: C = 16. int8 at MCOLS 4: C = 4. int8 at MCOLS 16,
    ACT_ROWS 64: C = 32.

Short passes (moe.em_short_rows):
- An expert's last pass holds n mod C entries. On the card a pass of 1-2 rows costs half the MXU
  time of 3-4 (PAIR).
- S is the largest m below C with a lower MXU cost: 2 on the card; 0 when every size below C
  costs as much as C (no PAIR, int8).
- The bucketing marks an expert's last pass short when it holds 1 .. S entries. The pass loop
  then runs the S-row body or the C-row body: two hardware loops whose counts (0 or 1) come
  from the flag.
- Without it, the 35B's 131-row layer would pay c(4) on its ~326 passes of 1-2 entries, about
  C = 2's time (13.17's model).

The kernel (moe.moe_expert_run(..., C, S)):
- The pass table's rows hold C + 2 words: the expert, the short flag, then C entries.
- Opening a pass fills all C entries with its first. A part-filled pass therefore loads and
  stores its first row again: the same output to the same place.
- Instructions: the 35B's run takes 189, the 26B's 234 (C = 2's kernel: 106 and 128).
- TMEM: the rows are normed into one [C, H] tile a row at a time.
  - Normed whole, the 26B's 4 x 2816 rows did not fit: 43,276 of 65,472 words in use.
  - compile_expert_run tries the rule's order and takes the first (C, S) that fits. The 26B
    fits (4, 2) but not (4, 0).

Choosing C (an A/B, a co-sim):
- Engine.em_pass; streamed.engine(em_pass=); chatmoe.py --em-pass; moe_prefill_cosim.py em
  --em-pass.
- The expert run's key is then ("x", layer, C).
- There is no environment variable. OTPU_* variables key the program and image caches
  (progcache.keyed_env), so an A/B on one would rebuild the image.

Bit for bit:
- Each row's math is unchanged; only the rows are grouped differently.
- On the MX MXU (mx-column, docs/mx_mxu.md) each output is one exact integer sum before the
  shared fp32 epilogue, and PAIR changes no bit. So the outputs equal C = 2's word for word.
- On the MXU before MX they would not: a PAIR MM's fp32 sums rounded differently from a plain
  one's. A pass of 4 runs without PAIR, a pass of 2 with it.
- Checked on the ISA simulator with random rows, gains and expert weights
  (`moe_prefill_cosim.py em --isa --random --compare 2`, the same DRAM through both programs).
  Every case had 0 differing words, and the ISA's passes (its WAITWs) matched the bucketing.

| model | rows | C, S | passes | output words |
|:--|--:|:--|--:|--:|
| tiny Qwen3.5-MoE | 7 | 4, 2 | 15 | 7,168 |
| tiny Qwen3.5-MoE | 40 | 4, 2 | 46 | 40,960 |
| tiny Qwen3.5-MoE, prefix 3, seed 5 | 40 | 4, 2 | 47 | 40,960 |
| tiny Qwen3.5-MoE (--em-pass 3) | 40 | 3, 2 | 62 | 40,960 |
| tiny Qwen3.5-MoE (--em-pass 1, against 4) | 9 | 1, 0 | 36 | 9,216 |
| tiny Gemma 4 MoE | 3 | 4, 2 | 9 | 3,072 |
| tiny Gemma 4 MoE | 33 | 4, 2 | 38 | 33,792 |
| Qwen3.5-35B-A3B | 131 | 4, 2 | 320 | 2,146,304 |
| gemma-4-26B-A4B-it | 124 | 4, 2 | 272 | 2,793,472 |
| Qwen3.5-35B-A3B, prose trace | 131 | 4, 2 | 350 | - |
| gemma-4-26B-A4B-it, prose trace | 124 | 4, 2 | 282 | - |

The tests:
- test_em_pass_rows_from_the_configuration: the rule on seven configurations.
- test_expert_major_prefill_is_bit_exact (Qwen3.5-MoE) and
  test_moe_expert_major_prefill_is_bit_exact (Gemma 4) compare against token-by-token decoding.
  - They run at the configuration's C (4 with build B's MCOLS 4 and PAIR; 8 for int8 at the
    tests' default MCOLS 8) and at C = 1, 2 and 3.
  - They cover the logits, the states, the KV cache and the decode steps after.

The co-sims (moe_prefill_cosim.py em on the simulation host, 2026-10-12, emc e7c65617). They use the MX RTL
with the card's LiteDRAM, DDR3-1066 and 133.33 MHz, 13.17's synthetic routing, and the first
layer; every check passed. C = 2 runs the same tree with --em-pass 2.

| model | rows | C, S | passes | ms | ms a pass | MB a row (weights) | instructions |
|:--|--:|:--|--:|--:|--:|--:|--:|
| 35B | 131 | 2, 0 | 565 | 69.41 | 0.1229 | 7.53 (7.38) | 117 |
| 35B | 131 | 4, 2 | 320 | 65.87 | 0.2059 | 4.32 (4.18) | 189 |
| 26B | 124 | 2, 0 | 515 | 127.02 | 0.2466 | 14.84 (14.65) | 139 |
| 26B | 124 | 4, 2 | 272 | 117.30 | 0.4312 | 7.92 (7.74) | 234 |

- C = 4 cuts the expert run by 5.1 % (35B) and 7.7 % (26B), and its bytes by 43 % and 47 %.
- 13.17's model said -9 to -11 %.
- The MX expert is a little larger than 13.17's (1.71 MB against 1.67 on the 35B), so C = 2 runs
  69.41 / 127.02 ms here against 13.17's 63.19 / 121.78.

Where the time goes. The 35B's runs with --profile (cycles by source line):

| place | C = 2 | C = 4 |
|:--|--:|--:|
| swiglu_down (the expert: stream and MXU) | 7,367,290 | 7,035,829 |
| the rows' norm, (x x 1 / rms) x g (VPU) | 735,082 | 795,123 |
| the quantize (QACT) | 464,430 | 388,970 |
| the outputs' stores | 344,078 | 345,445 |
| the rows' loads | 218,549 | 110,272 |
| the run | 9,254,664 | 8,782,803 |

- swiglu_down meets the model exactly. The expert is 12,288 chunks: a full pass of 4 takes 2
  cycles a chunk (MXU-bound), and a short pass or a pass of 2 takes the stream's ~1.12. At C = 4
  that is 245 x 24,576 + 75 x 13,800 = 7.06 M cycles; 7.04 M was measured.
- The rest, 1.6-1.8 M cycles (18-20 %), is each row's load, norm, quantize and store. It runs
  in series with the expert's stream, and its total does not change with C: 1,130 rows are
  loaded either way. 13.17's model folded it into a pass's fixed 12 µs, so it overstated C = 4's
  gain.
- Next lever: overlap a pass's rows (load, norm, quantize) with the previous pass's MM. That
  needs a second [C, H] row tile (16K words on the 35B; the 26B's TMEM is tight) and the
  sequencer letting VPU work run past an MM in flight.

The card (session emc1, 2026-10-12, tools/offload/sessions/emc1.sh):
- On MX production (deploy_mx_8b33206e, build 8b33206e), the host tree emc e7c65617.
- A: --em-pass 2. B: the configuration's C = 4. L: every call layer-major (--em-rows 100000).
- A warm-up, then A1 B1 B2 A2 L1 B3 A3 A4 B4 L2.
- Every run's tokens equal the warm-up's and the ISA references' first two turns. fail 0.

B - A, of the means over four pairs (TTFT; device time, the prompt's tokens over the device rate):

| model | turn | prompt | calls | TTFT B - A (pairs) | TTFT | device |
|:--|--:|--:|:--|:--|--:|--:|
| 35B | 3 | 49 | 45E + 4L | +0.017 -0.076 -0.178 +0.241 | +0.001 s | -0.001 s |
| 35B | 4 | 161 | 157E + 4L | +0.055 -0.478 -0.159 -0.272 | -0.213 s (-1.7 %) | -0.309 s (-2.6 %) |
| 26B | 1 | 25 | 21E + 4L | +0.049 -0.011 -0.007 -0.591 | -0.140 s | -0.143 s (-2.9 %) |
| 26B | 2 | 31 | 27E + 4L | -0.297 -0.145 -0.371 -0.526 | -0.335 s | -0.362 s (-6.9 %) |
| 26B | 3 | 50 | 46E + 4L | -0.273 -0.106 -0.294 -0.442 | -0.279 s | -0.240 s (-3.4 %) |
| 26B | 4 | 161 | 157E + 4L | -0.754 -0.755 -0.723 -0.647 | -0.720 s (-3.7 %) | -0.730 s (-3.9 %) |

- The 35B's turns 1-2 (20 and 27 rows) run layer-major in both arms, so they show no change.
- Decode is the same in A and B: the same tokens, hits and MB/token.
- The swap is host-only: it keeps deploy_mx's bitstream.

Expert-major against layer-major after the prompt (the A and B runs against L):

| model | turn | em - L: TTFT | decode hit rate | MB/token |
|:--|--:|--:|--:|--:|
| 35B | 3 | -0.014 s | -0.0131 | +7.19 |
| 35B | 4 | -2.566 s | -0.0346 | +18.94 (+9.4 %) |
| 26B | 1 | -0.218 s | -0.0089 | +8.16 |
| 26B | 2 | -0.449 s | +0.0308 | -28.19 |
| 26B | 3 | -1.083 s | +0.0070 | -6.35 |
| 26B | 4 | -3.014 s | +0.0147 | -13.46 |

Next steps (deferred to the release after r2; branch emc2). Step 1's server change is built on
branch les (15.4); step 2 is not.

1. The slots expert-major leaves for the decode.
- The 35B's long expert-major prompt leaves worse slots for the decode: -0.035 hits, +18.9
  MB/token on its first 16 tokens.
- The cause, from the server (opentpu/host/offload.py). Two things differ from layer-major:
  - Use. ExpertServer.need counts no use, while serve counts one per run for each id (t[j] and
    the decayed use[j]). end_prefill keeps, per layer, the experts of most decayed use, so after
    an expert-major prompt that choice rests only on the layer-major tail rows and earlier turns.
  - Recency. A need joins the pooled slots' LRU order (`order`) when it lands, in arrival order:
    each expert's first entry in the chunk, rare ones landing last. serve moves every id it
    names to the order's end on each run, so layer-major keeps the experts its latest rows use
    over the later layers' misses.
  - The expert run's own pass order does not decide what stays; the landings and use do.
- Next step, server-only and with no extra bytes:
  - need counts each line as serve counts a request: t[j] += 1, and a use for each id.
  - When the next layer's first need line arrives (need's layer switch), the finished layer's
    experts move to the end of `order` by the last need line that named them.
  - The slots then end with layer-major's accounting. No kernel change, and the outputs are
    unchanged.
- An offline bound on the router traces (tools/offload/em_slotsim.py).
  - The model:
    - 41 slots a layer on the 35B, 16 on the 26B;
    - a 157-row prompt, its last 4 rows layer-major as in the chat's;
    - then the trace's next rows as the decode, under LRU;
    - all windows, layers and texts.
  - It models per-layer LRU slots, not the pooled slots or end_prefill's use, so it
    approximates.
  - 35B, first 16 decode rows:

    | slots at the prompt's end | hits | MB/token |
    |:--|--:|--:|
    | layer-major | 0.696 | 166.5 |
    | first-appearance order (today's) | 0.677 | 177.0 |
    | last-row order | 0.696 | 166.7 |
    | the prompt's S most frequent | 0.706 | 161.1 |

    - Matching layer-major saves ~10.5 MB/token (6 %), the card's sign at about half its size.
    - Over 64 decode rows the loss shrinks to 3.0 MB/token, as the decode refills the slots.
  - 26B: the four layer-major tail rows' 32 entries cover its 16 slots, so every order gives the
    same 0.623. The card's expert-major gain there (turns 2-4) is not modeled.
- Bytes it would save:
  - On the card, 18.9 MB/token over a reply's first tokens after a long expert-major prompt on
    the 35B: ~0.3 GB of H2C a 16-token reply (~0.1 s at the link's placed ~3 GB/s).
  - Nothing on short prompts, which run layer-major already.
- A post-prompt refill instead costs what it loads. Refilling every slot of the 35B (41 x 40
  layers x 1.71 MB) is 2.8 GB, about 150 tokens of the saving.

2. Overlap a pass's rows with the previous pass's MM.
- The rows' load, norm, quantize and store are 18-20 % of the expert run (the profile above),
  in series with the expert's stream.
- First a co-sim bound: the per-row work timed as free (its instructions made NOPs), on the 35B
  at 131 rows.
- Then:
  - a second [C, H] row tile where TMEM allows (16K words on the 35B; the 26B only if it fits,
    else today's serial order), chosen from the configuration and TMEM;
  - the next pass's rows quantized to a second ACT RAM block range while the current pass's MMs
    read the first.

### 13.19 The write contention in co-simulation, and the bridge's batches (2026-10-14)

13.8's contention comes from the channel bridge, not from the link or the controller.
`tools/litedram/h2c_contention.py` runs a card program on the RTL with the card's LiteDRAM
controllers (DDR3-1066, the core at 133.33 MHz, the board's configuration), once alone and once
beside a host load on XDMA's side of each channel's `otpu_mem_ch`
(`sim/verilator/otpu_ldc_mem.sv`'s `+h2c_*`: 256-byte INCR bursts at a rate, into the channels'
top, which no program uses). CT is the run's extra time per GB the controllers took from the
load. The works are Qwen3.5-35B-A3B's: a layer run (`layer:PREFIX:R`, the prefix's last layer on
R rows; `1` DeltaNet, `4` attention) and the expert run on 131 rows (`em:131`, 13.17).

- **The card's case.** With the server's parts (512 KiB at 2.2 GB/s, 0.29 ms between them) the
  DeltaNet layer at R = 2 runs 12.9% slower and attention 13.6%: 13.8 measured 13% and 15% on the
  card.
- **Steady loads** (s a GB; R = 1 is a decode step's layer):

  | load | DeltaNet R = 1 | attention R = 1 | DeltaNet R = 2 | expert run |
  |:--|--:|--:|--:|--:|
  | 1 GB/s | 0.199 | 0.206 | 0.193 | 0.032 |
  | 2 GB/s | 0.128 | | 0.121 | |
  | 3 GB/s | 0.101 | 0.105 | 0.098 | 0.025 |
  | 2 GB/s in 4 KiB bursts | 0.092 | | 0.086 | 0.024 |

- **What it is.** The floor is the writes' own data on the bus, a beat a cycle on each channel:
  0.059 s a GB. Channel 0's cycles (`+ldc_break`) at 2 GB/s beside DeltaNet R = 1 split the
  extra time into the writes' column commands 46%, the multiplexer's read-write turnarounds 31%,
  rows 19%, the crossbar 8%, refresh 3% and 7% less idle. Everything but the data comes once per
  turn of the bridge's arbiter: it let XDMA in after each 32 of the accelerator's commands, and
  XDMA's 16-beat FIFOs held a burst or two, so each 256-byte burst paid a turnaround and a row
  change. CT falls as more beats come per turn: with the rate (0.20 at 1 GB/s, 0.10 at 3), and
  with the burst size.
- **LiteDRAM's own batching does not help** (`tools/litedram/gen_ldc.py` variants). Its
  multiplexer's read and write times (128 / 64, 512 / 256 and 1024 / 512 cycles against 256 /
  128) and command buffers of 16 (against 8) leave CT within 0.004 of the default, and move the
  runs alone by -0.3 to +0.3%. The controller already batches what it holds; the bridge gave it
  too little at a time.
- **The bridge's batches** (`otpu_mem_ch` XQD, XT, XB). Once the accelerator has had its RUN, a
  ready XDMA goes only when it has waited XT = 256 cycles since its last command or has XB = 24
  commands queued, in FIFOs of XQD = 32 beats. With the accelerator idle (a demand miss) it goes
  at once, and with XDMA idle the arbiter is the one before. CT, s a GB (load landed, GB/s):

  | load | work | without | XT 256 alone | XT 256, XB 24 |
  |:--|:--|--:|--:|--:|
  | 1 GB/s | DeltaNet R = 1 | 0.199 | 0.104 | 0.104 |
  | | DeltaNet R = 2 | 0.193 | 0.097 | 0.097 |
  | | expert run | 0.032 | 0.016 | 0.016 |
  | 2 GB/s | DeltaNet R = 1 | 0.128 | 0.078 | 0.082 |
  | | DeltaNet R = 2 | 0.121 | 0.074 | 0.078 |
  | | expert run | | 0.012 | 0.013 |
  | 3 GB/s | DeltaNet R = 1 | 0.101 | 0.070 (2.80) | 0.075 (3.00) |
  | | DeltaNet R = 2 | 0.098 | 0.067 (2.75) | 0.073 (3.00) |
  | | expert run | 0.025 (2.98) | 0.013 (2.98) | 0.015 (3.00) |
  | parts, 2.2 GB/s | DeltaNet R = 2 | 0.107 (12.9% slower) | | 0.075 (8.3%) |
  | | attention R = 2 | 0.119 (13.6%) | | 0.081 (9.1%) |

  The wait alone caps XDMA at RUN commands per XT + RUN cycles while the accelerator streams, so
  at the link's 3 GB/s it landed 2.75-2.80 GB/s beside a layer run; XB lets a stream go once its
  batch is in, and costs 0.005 s a GB at 2 GB/s for it. XT 512 gains under 0.005 over 256 and
  caps XDMA at 1.93-1.95 of 2 GB/s.
- **Cost** (Vivado out of context, routed, xc7k480t-2, a channel; `tools/memch_ooc.tcl`
  MEMCH_GENERICS): +51 LUTs and +32 flip-flops a channel, no LUTRAM (a RAM32M is 32 deep, so 16
  -> 32 beats takes the same cells) and no block RAM. uclk's worst slack +0.120 -> +0.174 ns
  (the same output path, which the change does not touch), the arbiter's registers 3.4-4.2 ns;
  every crossing constrained as before.
- **No host writes, no change.** The layer and expert runs alone take the same cycles with and
  without the batches, and so does a whole decode token (`tools/perf_ddr.py`, fp4 at 133.33 MHz:
  Qwen3 3,714,482 cycles, Qwen3.5 4,803,926, the same DRAM commands).
- **Tests.** `test_ldc_host_writes` (test_rtl.py): a stream of loads at 400 MHz beside 2 GB/s,
  the core bit-exact, every burst landed, CT 0.006 s a GB against 0.034 without the batches.
  `tools/memch_test.py`'s functional suite runs the bridge at its defaults (and `ldcn` without
  batches); its perf run "acc seq rd + xdma seq wr" has the accelerators at 0.88 / 0.83 beats a
  cycle beside XDMA's full rate (0.78 / 0.77 without the batches).

In the card's case the batches take 30-32% off CT (0.107-0.119 -> 0.075-0.081 s a GB); on
13.8's 0.13-0.18 measured on the card that would be about 0.09-0.13, which moves LES's estimate
(15.3) part of the way toward its CT = 0.07 column. An ASIC's memory system needs the same: host
writes batched per arbitration turn (docs/asic.md).

## 14. Chatting with a streamed MoE (otpu-chat)

otpu-chat runs the three MoE models bigger than the card's 4 GiB. Their experts stream from a pool
file on the host into per-layer slots in the card's DRAM. The card routes every token and computes
every expert; the host reads the pool file and writes DRAM, nothing else.

```sh
otpu-chat --backend board --model lfm2-8b       # LFM2.5-8B-A1B
otpu-chat --backend board --model qwen35-35b    # Qwen3.5-35B-A3B
otpu-chat --backend board --model gemma4-26b    # gemma-4-26B-A4B-it
otpu-chat --backend board --model qwen35-35b --pool /data/pools/q35.bin
otpu-chat --backend isa --model lfm2-8b         # the ISA simulator, with the card's 4 GiB
```

The engine is moe_card's: `opentpu/host/streamed.py` builds it for both tools, with the settings
measured best on the card. tools/offload/moe_card.py stays the tool for measurements; its options
reach every setting.

The 26B is Google's instruct checkpoint, gemma-4-26B-A4B-it, since 2026-10-09. The base
checkpoint of sections 11-13 (gemma-4-26B-A4B, the same architecture, formats and pool layout)
has no chat template: the chat fed it the turns as plain text, and its scripted chat (14.5)
answered "What is the capital of France? Answer in one sentence." with "\n\nWhat is the capital
of France?\n\nWhat is the capital of France?". otpu-chat now refuses a checkpoint without a chat
template (docs/host.md 6). The instruct checkpoint's config.json lists its stop ids, so its pool
key differs from the base's: the base pool is refused, and the 26B-it has its own.

### 14.1 The pool

Each model's experts are packed once into a pool file in the card's slot format (split, 10.4).
otpu-chat looks for it in the checkpoint's directory, as `pool-<the MXU's numerics>-<the experts'
format>.bin`: LFM2.5-8B-A1B and gemma-4-26B-A4B-it stream nvfp4 experts (`pool-mx1-nvfp4.bin`, e.g.
`models/LFM2.5-8B-A1B/pool-mx1-nvfp4.bin`), Qwen3.5-35B-A3B fp4 (`pool-mx1-fp4.bin`). A pool of the
MXU before MX (`pool-fp4.bin`, key 1) keeps its name beside it, for a qualification and a rollback;
this tree refuses it. Its `.packed`, `.format` and `.key` sit beside it. `--pool PATH` names another
file. A symbolic link with no `.packed` beside it is followed: the companions then sit beside the
file it names.

Packing takes the whole checkpoint (the card's host may keep one without the experts,
strip_experts.py) and runs on any host:

```sh
python3 tools/offload/pack_pool.py MODEL POOL init                 # the sparse file and its companions
python3 tools/offload/pack_pool.py MODEL POOL pack I N             # worker I of N (each in its own process)
python3 tools/offload/pack_pool.py MODEL POOL init --wformat nvfp4  # LFM2.5-8B-A1B (nvfp4 experts)
OTPU_FORMATS=experts=nvfp4 python3 tools/offload/pack_pool.py MODEL POOL init --wformat int8   # gemma-4-26B-A4B
```

`--wformat` is the experts' format (default fp4): LFM2.5-8B-A1B's pool needs `--wformat nvfp4` on
every command. Gemma 4 26B's needs `OTPU_FORMATS=experts=nvfp4` and `--wformat int8` on every
command (its layers are int8, its experts nvfp4; with `experts=fp4` it takes pool-mx1-fp4.bin).
Qwen3.5-35B-A3B's nvfp4 layers do not change its experts' bytes or its key. The pools are 4.6 GB
(LFM2.5-8B-A1B, nvfp4, 704 experts), 17.5 GB (Qwen3.5-35B-A3B, fp4, 10240) and 14.6 GB
(gemma-4-26B-A4B-it, nvfp4, 3840; 13.5 GB in fp4); before MX, all fp4, 4.1, 17.1 and 13.2 GB. Every
pool packed before MX has a key 1 and is refused: repack it. LFM2.5-8B-A1B's packed in 15 minutes
with three workers on the build host (2026-10-08).

otpu-chat checks the pool before it builds the image, so a bad pool costs seconds rather than the
build's minutes. It stops with the reason and the commands to fix it when the pool:
- is missing (the message gives the pack commands);
- has another size (another model or format; the runtime would take it for a new pool and
  truncate it);
- has another key (moe.pool_key: the MXU's numerics, the quantizer's code, the format, D, the
  layout, the checkpoint's config.json): packed for the MXU before MX, by an older quantizer or
  from another checkpoint. Repack it;
- is not whole, beside a checkpoint without the experts to pack the rest.

A pool packed before keys has none: it is refused (it predates the MX MXU) until
`pack_pool.py MODEL POOL stamp` writes its key. Stamp a pool only once it is known current:
`pack_pool.py MODEL POOL sums 32` prints the sha256 of 32 of its experts, and
`pack_pool.py MODEL - sums 32` (on a host with the whole checkpoint) the same experts as this
tree packs them. The lists must be equal.

### 14.2 What runs

- **Formats.** `--wformat auto` (the default) takes each family's formats (`streamed.FORMATS`), the
  MX formats' per-kind choices ([mx_mxu.md](mx_mxu.md) 3.6): LFM2.5-8B-A1B nvfp4, its experts
  included, with an int8 LM head; Qwen3.5-35B-A3B nvfp4 attention, DeltaNet and shared expert, fp4
  experts and an int8 head; Gemma 4 26B int8 layers with nvfp4 experts and an fp4 head. The 26B's
  nvfp4 experts are the user's choice (2026-10-12), over the formats rule
  ([formats.md](formats.md)): on chat text they gain nothing over fp4x6, but they are the more
  robust to text off the scan's distribution, for an estimated 6.6% more decode time. Before MX the
  first two ran fp4 with an int8 head (10), the 26B fp4 experts (11.5). `--wformat`, `--head-format`
  and `OTPU_FORMATS` override them; the pool must hold the experts' format. At the default `--cap
  2048` this tree's images hold 26 slots a layer of LFM2.5-8B-A1B's 32 (6.48 MB each in nvfp4; 28 of
  5.99 MB in fp4), 41 of Qwen3.5-35B-A3B's 256 (42 with fp4 layers) and 16 of gemma-4-26B-A4B-it's
  128 (3.81 MB each in nvfp4; 18 of 3.53 MB in fp4).
- **Slots.** As many a layer as fill the DRAM beside the rest of the image (`--experts N` sets
  them), replaced by least decayed use (`--policy lru` for least recently used).
- **The prompt.** Qwen3.5-MoE and Gemma 4 MoE run it layer by layer in runs of two rows, every
  slot serving the running layer (13; `--layer-major R`, 0 for token by token). In a call of at
  least EM_ROWS new rows (Qwen3.5 44, Gemma 4 20; 13.16) each MoE layer's experts run once, in
  one expert run, after the layer's runs have posted them as needs (expert-major, 13.11-13.15).
  LFM2-MoE runs it token by token.
- **Turns** keep the context as a dense model's do (docs/host.md 6): a later turn rolls back to
  where its rendering and what was fed part and feeds the rest, the recurrent and windowed
  state from the snapshot the turn before took at its reply's start. The slots fill the DRAM,
  so a streamed MoE's snapshots sit on the host and each copy crosses PCIe. A layer-major
  prompt's part up to the snapshot runs no LM head.
- **The embedding table.** Qwen3.5-35B-A3B's untied int8 table stays on the host, which writes
  each token's row, so more slots fit (`--embed-table card` puts it on the card).
- **Decode.** The card's decode loop picks every token, greedy or sampled, when the card takes
  the sampling settings (top-k 1 to 64). A default top-k above 64 is clamped to 64 with a note
  (LFM2.5-8B-A1B's generation_config.json asks for 80; docs/host.md 6). With an explicit
  `--top-k` above 64 the host samples each step from its logits.
- **The server.** The expert server is polled while every run is in flight: the prompt's runs,
  the decode loop, and each step the host samples. `--poll-idle` sets its idle polls (10.10).
- **Not supported:** `--mtp`, `--per-position`, `--backend board-sim` and `rtl`.

The other settings are the defaults of 10-13: a request's disk reads queued at once, the idle
parts read ahead and halt-aware, the pool mapped, the checkpoint released once the image is
written, no hints, no layer-ahead, no expert-major prefill.

### 14.3 What it shows

At load, LFM2.5-8B-A1B at the default `--cap 2048`: `experts: 638 slots of 704 experts (91%),
5.85 MB each; pool models/LFM2.5-8B-A1B/pool-fp4.bin` before MX; this tree's nvfp4 image holds
572 slots (81%) of 6.48 MB, from `pool-mx1-nvfp4.bin`.

Each turn's numbers add the experts (LFM2.5-8B-A1B's first turn in 14.5):
- the status line: `· 99% hit · 6.6 MB/tok` after the decode rate;
- `--plain` and `--prompt`: `; experts 98.7% hits, 6.6 MB/token, 76 misses in the prompt`;
- the side panel and `/stats`: the slots, and the turn's hits, MB a token and the prompt's
  misses.

The hits and misses are those of the reply's expert uses (each token's top-k per layer). MB a
token is what the reply streamed over the link, divided by its tokens after the first. The
prompt's misses are counted apart.

### 14.4 What to expect

Measured with moe_card and these settings (the chat's own runs on the card: 14.5):

| Model | Decode | Streamed a token | Prompt | Source |
|:--|--:|--:|--:|:--|
| LFM2.5-8B-A1B | 13.5 tok/s (16 tokens), 15.0 (160); the pool in /dev/shm | 5.2 MB (98.5% hits) | token by token | 12.9, README |
| Qwen3.5-35B-A3B | 5.3 tok/s (128 tokens) | 103 misses, about 170 MB | 134 tokens in 14.6 s | 12.9, 13.7 |
| gemma-4-26B-A4B | 3.7 tok/s (128 tokens) | 88 misses, about 280 MB | 124 tokens in 17.3 s | 12.9, 13.7 |

- **Loading** builds the image on the host, then writes it: about 9 minutes for the 35B (10.4).
  The pool's read into the page cache runs during the build.
- **Host memory.** The process peaks at about 13 GB during the 35B's image build, then holds
  about 1.3 GB (10.7). The pool lives in the page cache. Nothing is pinned, so the kernel can
  reclaim it, at the cost of disk reads for the experts it drops. On the card host (31 GB) the 35B's
  17.1 GB pool and the chat fit together once the build is done. Other large files in the page
  cache (other checkpoints) cost speed: 3.05 against 3.79 tok/s in 10.7.
- **Speed.** Decode depends on the conversation: a new topic's first tokens miss more. The first
  reply after a load also warms the slots.

### 14.5 The check on the card

`tools/qual/chatmoe.py` scripts a conversation through otpu-chat's own Chat, engine and settings:
two turns (a question, then one about its answer), greedy, 16 tokens a reply, with the chat
template's date pinned. It writes each turn's tokens, the ids fed so far, TTFT, prefill and
decode rates, hits and MB a token as JSON. The run on the ISA simulator with the card's
configuration (`tools/qual/refs.py cfg`) is the card's reference bit for bit, and `--check`
compares each turn's tokens with it.

```sh
python3 tools/qual/chatmoe.py CHECKPOINT --cfg cfg.pkl --pool POOL --out ref.json      # ISA simulator
python3 tools/qual/chatmoe.py CHECKPOINT --backend board --cfg dev.pkl --pool POOL --check ref.json
```

`tools/qual/chatmoe.sh` is the card session, under otpu-lock and with the offload sessions'
paths (tools/offload/sessions/env.sh). It runs a selftest and checks that the device's
configuration is the references'. Then, for each staged model, it drops the other large files
from the page cache, reads the pool in, and runs the scripted chat against its reference.

On the ISA simulator with the card's configuration (the build host, 2026-10-08, tree 21402a25),
LFM2.5-8B-A1B with the repacked pool:
- Turn 1 (21 prompt tokens, 16 generated): the tokens equal moe_card's on the same ids and pool,
  and the card's reference from session 17 (its ref16, the same prompt).
- The slots: 638 of 704 experts (29 a layer). Turn 1 hit 98.7% of its decode's expert uses
  (6.6 MB a token) with 76 misses in its prompt. Turn 2 hit 99.8% (0.8 MB a token) with 22.
- The process peaked at 10.7 GB, the simulator's 4 GiB DRAM included.

On the card (the card host, build 1025907f, 2026-10-08), LFM2.5-8B-A1B against that reference:
[PASS], both turns' tokens the same, on tree 936f8a5f and again on 171a1b50 (with chat-kv's
rollback: turn 2 reused 36 positions). Turn 1: 21 prompt tokens in 2.16 s (device 13.8 tok/s),
76 misses, TTFT 2.16 s, decode 13.2 tok/s (device 15.0), 98.7% hits, 6.6 MB a token. Turn 2:
TTFT 1.43 s, decode 15.2 tok/s (device 15.4), 99.85% hits, 0.78 MB a token. Loading took 186 s
on 936f8a5f (the image's matrices quantized on one core) and 24 s on 171a1b50 (in workers).

Qwen3.5-35B-A3B on the card (tree 171a1b50; its reference from the ISA simulator on 24a7e3f8,
the build host): [PASS], both turns' tokens the same. 1720 slots (17% of the 10240 experts), the prompt
layer by layer (R = 2), the pool 15.2 of 17.1 GB in the page cache after its read. Turn 1: 24
prompt tokens in 6.53 s (device 4.38 tok/s), 3301 misses, TTFT 6.53 s, 7 tokens to the EOS at
4.13 tok/s (device 4.39), 60.3% hits, 212 MB a token. Turn 2: 31 tokens fed (20 reused) in
5.25 s, TTFT 5.25 s, decode 4.55 tok/s (device 4.56), 62.4% hits, 201 MB a token. Loading took
192 s (10.4's 9 minutes before the parallel build). The 26B's chat has not run on the card yet.

### 14.6 Tests

`tests/test_chatmoe.py` runs tiny random MoEs of the three families (Qwen3.5-MoE with an untied
head, LFM2-MoE, Gemma 4 MoE) on the ISA simulator with 2 slots a layer:
- `test_a_chat_turn_is_moe_cards_run`: a greedy chat turn gives moe_card's tokens on the same
  prompt and pool;
- `test_the_next_turn_continues_the_context`: the second turn feeds only what the conversation
  added (layer by layer from the context's position for Qwen3.5 and Gemma 4), and its reply is,
  bit for bit, that of an engine with every expert resident fed the whole conversation;
- `test_a_streamed_chat_rolls_back_to_the_reply`: with a template that renders a past reply
  otherwise than it was fed, the later turns roll back to the reply's start (reused > 0, not
  restarted; the snapshots on the host or the device), and each turn's logits and reply equal a
  fresh streamed engine's on the turn's rendering, bit for bit;
- `test_a_sampled_reply_streams_its_experts`: sampled replies, picked on the host (top-k 80)
  and by the card's loop (top-k 20), equal those of an engine with every expert resident, and
  the turn counts the steps' experts;
- `test_the_pool_is_checked_before_the_image`, `test_pack_pool_sums_tell_a_current_pool`;
- `test_otpu_chat_runs_a_streamed_moe` (otpu-chat's main), `test_the_interface_shows_the_streaming`,
  `test_the_scripted_chat_checks_a_run_against_its_reference` (chatmoe.py).

test_qwen35_moe's `test_layer_major_prompts_as_prefill_chunks` covers the Engine's part: a
layer-major prompt through prefill_chunks is one part with its runs' stats in one entry, and
`prefill_layers(logits=False)` runs no head.

## 15. Lookahead expert scheduling (LES)

The user asked for OpenBMB's MiniCPM-V 4.7 (35B-A3B) to be served "with LES". Its language
model is the Qwen3.5-35B-A3B architecture (qwen3_5_moe_text), which the card already serves as
`qwen35-35b` with its experts streamed from the host (sections 10-14). So LES was measured on the
35B and the 26B, and whatever it gives applies to MiniCPM-V unchanged.

LES (llama.cpp-omni, docs/les/lookahead-expert-scheduling.md; no paper) is training-free and has
three parts:
1. cross-layer routing prediction, which prefetches the experts the next layer will likely want;
2. once the router decides, the experts already resident compute first while the missing ones
   load;
3. routing stays exact: the prediction drives only the prefetch and the order.

LES also uses layer-wise mixed precision, repacked contiguous expert storage and DSpark
speculative decoding. It reports 2.97 -> 9.81 tok/s on an iPad M4 from the scheduling and load
work alone. Fate (arXiv 2502.12224) predicts with the next layer's gate applied to this layer's
gate input.

What path (a) already had:
- part 2 since phase 2, as hits first (section 5.2);
- repacked contiguous storage, as the split pool (10.1);
- a predictor of the layer's own experts one mixer ahead, as router hints (section 12: closed at
  +0.85-1.5% on the card);
- the next layer's experts in layer-major prefill (13.8-13.10).

The open question was part 1 in decode: a prediction one layer ahead has a whole layer to
land in, not just a mixer.

### 15.1 Recall

`tools/offload/lesim.py recall` uses the router traces (section 3: four texts of 2048 tokens,
each warmed by the other three's profile) and the server's slots by decayed use: 43 a layer on
the 35B, 16 on the 26B. Each predictor is a layer's router through its norm applied to an
earlier state:
- `pre`: the layer's input, one mixer ahead;
- `prev_r`: the previous layer's router input, one layer ahead. This is Fate's, with the next
  layer's norm gain;
- `prev_in`: the previous layer's input, one layer and one mixer ahead. The card has it as early
  as `prev_r`.

Two baselines: `same` takes the previous layer's choice as this layer's ids, and `static`
takes the profile's best of the layer. Two measures:
- the share of the true top-8 that a predictor's 8 / 12 / 16 best name;
- the share of the server's misses they name. This is what a prefetch needs: the slots already
  hold the easy experts.

| | 35B: true top-8 | 35B: misses | 26B: true top-8 | 26B: misses |
|:--|:--|:--|:--|:--|
| pre | 0.80 / 0.90 / 0.94 | 0.70 / 0.83 / 0.89 | 0.79 / 0.89 / 0.92 | 0.79 / 0.88 / 0.91 |
| prev_r | 0.64 / 0.75 / 0.80 | 0.49 / 0.61 / 0.68 | 0.72 / 0.83 / 0.88 | 0.63 / 0.76 / 0.83 |
| prev_in | 0.71 / 0.82 / 0.87 | 0.57 / 0.71 / 0.78 | 0.65 / 0.76 / 0.82 | 0.62 / 0.73 / 0.79 |
| same | 0.03 | 0.03 | 0.06 | 0.06 |
| static | 0.04 / 0.06 / 0.09 | 0.02 / 0.03 / 0.05 | 0.10 / 0.16 / 0.20 | 0.05 / 0.08 / 0.11 |

The capped prefetch is cachesim's replay of 12.7: before each request, the first n of the
predictor's first `top` ids not in a slot each take one (the victim of least decayed use outside
the prediction, no use counted). The table gives misses a token, experts sent a token, the share
of them a request used (precision), and MB a token sent early (used) and wasted. The 35B's base
is 82.5 misses a token (141 MB), the 26B's 75.0 (286 MB).

| model | predictor, top, n | misses | sent | precision | MB early / wasted |
|:--|:--|--:|--:|--:|:--|
| 35B | pre, 4, 1 | 65.3 (-20.9%) | 20.4 | 0.88 | 30.6 / 4.3 |
| 35B | pre, 4, 2 | 58.6 (-29.0%) | 29.4 | 0.85 | 42.5 / 7.7 |
| 35B | prev_in, 4, 1 | 68.0 (-17.7%) | 21.0 | 0.74 | 26.6 / 9.3 |
| 35B | prev_in, 4, 2 | 62.8 (-23.9%) | 30.4 | 0.70 | 36.2 / 15.8 |
| 35B | prev_r, 4, 1 | 69.7 (-15.6%) | 22.1 | 0.64 | 24.1 / 13.8 |
| 35B | prev_r, 4, 2 | 65.3 (-20.9%) | 32.6 | 0.59 | 32.7 / 23.2 |
| 35B | prev_r, 8, 8 | 49.0 (-40.6%) | 102.6 | 0.38 | 66.5 / 109.1 |
| 26B | pre, 4, 1 | 56.1 (-25.2%) | 21.9 | 0.90 | 75.3 / 8.2 |
| 26B | prev_r, 4, 1 | 60.4 (-19.5%) | 20.1 | 0.79 | 60.6 / 16.0 |
| 26B | prev_r, 4, 2 | 54.2 (-27.7%) | 30.9 | 0.74 | 87.4 / 30.2 |
| 26B | prev_in, 4, 2 | 53.8 (-28.2%) | 36.1 | 0.67 | 91.5 / 46.0 |
| 26B | prev_r, 8, 8 | 37.6 (-49.9%) | 85.1 | 0.54 | 175.5 / 148.7 |

- Cross-layer prediction works, as LES and Fate say: 0.64-0.72 of the next layer's top-8 from
  this layer's state, and ten to twenty times the static profile.
- Against the misses it is weaker. Only 0.49-0.63 of them are in the 8 best. The more ids it
  sends, the lower its precision: 0.38-0.54 when every predicted id not in a slot goes.
- On the 35B `prev_in` beats `prev_r` (0.74 against 0.64 at top 4, n 1). On the 26B it is
  the other way round.

### 15.2 The decode's timeline

`tools/offload/lesim.py time` replays the same traces through the card's own model of a request.
It uses design A' as the card ran it in session 16 (10.13, card_fit.py's fit), at r2's 41 slots
a layer:
- the host sees a request 45 us after its post;
- the critical end comes 0.308 ms + 0.751 ms a miss later, after any part already on the link;
- the next post comes at max(critical end + F, post + W0), where F = 1.705 ms and W0 = 2.47 ms
  (the card's own time with no miss);
- each prefetched expert that lands while the card computes adds CT x MB to the card's time:
  13.8's 0.17 s a GB, or 0.29 ms for a 1.71 MB expert;
- a token adds C0 = 29 ms for the head and sampling.

The 26B uses session 16's F (2.956 ms), W0 (5.70 ms) and W(m), with its record scaled to the
3.81 MB nvfp4 experts.

A prefetch goes on the link after the request's demand, from the moment its prediction is
known:
- `prev_r` and `prev_in`: posted with this layer's request;
- `pre`: at this layer's output;
- the oracle: the next layer's true misses at this layer's request.

The prefetch goes as whole experts of 0.88 ms each (an idle part, 13.12). "Gated" starts a part
only if it lands before the next post is due. A landed expert is a hit. One still on its way is
finished at once (its rest, no head). A queued one is a miss.

The model leaves out two costs:
- the predictor's own card time: the next router's 0.5 MB int8 MM and the top-k, about 50 us a
  layer, or about -1%;
- any host cost of a hint.

Calibration:
- On session 16's 102.85 misses a token the model gives about 190 ms a token, the card's
  measured value (5.26 tok/s).
- `pre`, top 4, n 1 models at +3.5% with no poll cost. Sessions 17 and 18 measured +0.85-1.5%
  on the card with about 3% of hint polls (12.9).

tok/s against no prefetch, the best setting of each (gated unless marked):

| model (base) | oracle, n 1 / 2 / 4 | pre | prev_in | prev_r | oracle / pre / prev_in at CT = 0 |
|:--|:--|:--|:--|:--|:--|
| 35B (5.60 tok/s, 85.5 misses) | +6.2 / +10.4 / +11.9% (n 3 ungated +12.8%) | +5.0% (top 8, n 2) | +2.9% (top 4, n 2) | +1.4% (top 4, n 1-2) | +15.6 / +9.9 / +8.4% |
| 26B (3.54 tok/s, 75.0 misses) | +4.8 / +7.6 / +8.3% | +4.5% (top 4, n 2, ungated) | +1.7% (top 2, n 2) | +2.5% (top 4, n 2) | |

Sending more of a weak prediction loses: `prev_r` at top 8, n 4 ungated is -6.5% on the 35B,
and `prev_in` -3.5%.

### 15.3 Why LES's prefetch does not pay here

LES and Fate measure on unified memory, with experts read from flash. There the prefetch's reads
compete with nothing else, and a miss costs much more than any compute. Path (a) differs in three
ways:
1. **A prefetched byte is not free.** Every byte the link writes while the card computes costs
   the card's DRAM 0.17 s a GB (13.8): 0.29 ms for each 1.71 MB expert. A miss it saves is
   worth at most 0.751 ms of the link plus its request's head. So a prediction pays only well
   above 0.4 precision, and only for experts the card would really have waited on.
2. **The window is short.** The link carries this layer's own misses until the critical end.
   The next request comes F = 1.7 ms after that, room for about two whole experts. A
   one-layer-ahead prediction is known at the request, but the link is not free for it until
   the window. Even a perfect predictor gains only +12% (35B) and +8% (26B).
3. **The slots already hold the easy experts.** The predictions name 64-80% of a layer's
   experts, but only 49-79% of its misses (the 8 best), and their precision on what they send
   falls to 0.4-0.75 as they send more.

So the LES prefetch is closed on the measurement above (not built). It is worth another look
if any of these change, since each moves the balance; `lesim.py time --set K=V` re-runs it:
- the write contention falls: CT = 0 lifts `pre` to +10% and `prev_in` to +8%. It comes from
  the controller's write and read turnarounds, which the bridge's batches cut by about a third
  (13.19);
- the link gets faster (PART and REC shorter);
- the slot count changes (`--slots`);
- MCOLS 8 changes the card's own time (F, W0).

### 15.4 What we took: the card's own work first

LES's part 2 was there, but not all of it. A Qwen3.5-MoE layer computed its shared expert after
the last routed expert: after the last miss had landed. So in every layer whose request missed,
the card's wait grew by the shared expert's time: 1.77 MB of nvfp4, about 0.136 ms. Gemma 4's
dense MLP already ran beside the request (5.3).

Now `moe_ffn` and `moe_ffn_rows` run the shared expert right after the post, before beside()'s
work. Its output is still added last, after the routed rows' sum in the router's order: the same
operations on the same operands, bit for bit.
- The model gives 178.4 -> 174.0 ms a token on the 35B (+2.5%, F less 0.136 ms).
- A layer-major prompt's runs gain the same way, per request with misses.
- Only Qwen3.5-MoE's programs change. LFM2 and Gemma 4 have no shared expert.
- On the ISA simulator, the tiny Qwen3.5-MoE gives the same logits as r2 (4ead4e53): decode with
  misses, and a layer-major prefill of R = 2 with the decode after.
- The 35B's chatmoe reference on les (five turns, r2's configuration, the MX pool) gives
  production's tokens in the turns production's reference has (its two layer-major prompts
  and their decode). tools/offload/program_sha.py on r2's configuration: LFM2.5-8B-A1B's and
  Gemma 4's programs are byte-identical to production's (the 26B at 16 slots a layer).

The same branch (les) carries 13.18's slot-order fix, from moe-ab's design on emc2:
- an expert-major need line counts as a request (one more of its layer's, and a use of each id);
- at the layer switch, the finished layer's experts go to the pooled order's end by the last
  line that named them.

It changes no bytes and no program. em_slotsim bounds it at 177.0 -> 166.7 MB a token for the
35B's decode after a long expert-major prompt.

Card session les1 is the check: the production host against les on the production bitstream,
both models, in ABBA order. It splits the two parts by turn:
- the short turns' decode and prefill measure the shared expert alone;
- the decode after the long expert-major turn adds the slot order: its hit rate and MB a token
  move, and its time beyond the shared expert's.

**les1's result** (2026-10-13, card, production's bitstream b10245f5; 20 runs, every one token
for token les's ISA reference; means of four ABBA pairs):
- S: the 35B's decode -4.09 ms a token (-1.96%). It ships with the next host release.
- O: the 35B's decode after its long expert-major prompt (turn 4) +2.8 points of hits, -15.1 MB
  and -9.6 ms a token; but its turn-3 prompt (61 rows expert-major) +0.29 s. The 26B lost: turns
  2-4 +26.3 / +5.1 / +12.3 MB a token (+8.6 / +2.4 / +6.5 ms). O is not shipped.

**O explained** (`tools/offload/server_replay.py`). The routing does not depend on the server
(the outputs are bit for bit the same whatever it keeps), so one record of a chat's server
calls on the ISA simulator replays through any server offline: the load's warm set, each
prefill's begin and end, its requests and need lines, the decode's requests. les1's five turns
were recorded for both models (r2's configuration, the MX pools). Replayed through production's
server and through les's, the replay gives the card's decode hit rates of both arms, every turn
of both models, within 0.0001 (35B turn 4: 0.6483 and 0.6759; 26B turn 2: 0.6712 and 0.6425),
and the card's prompt misses and needs queued. O's two parts and three variants
(decode hit rate; MB a token in turns of 32 tokens):

| server | 35B t3 | 35B t4 | 35B t5 | 26B t1 | 26B t2 | 26B t3 | 26B t4 |
|:--|:--|:--|:--|:--|:--|:--|:--|
| production (A) | 0.616, 210.2 | 0.648, 192.7 | 0.676, 177.3 | 0.604 | 0.671, 300.6 | 0.616, 351.6 | 0.640, 328.9 |
| count: a need line counts a use | 0.622, 207.3 | 0.675, 177.9 | 0.673, 179.1 | 0.613 | 0.643, 326.9 | 0.610, 356.7 | 0.627, 341.2 |
| order: the layer switch's reorder | 0.616, 210.2 | 0.649, 192.4 | 0.677, 176.9 | 0.604 | 0.671, 300.6 | 0.616, 351.6 | 0.640, 328.9 |
| O = count + order (les, B) | 0.622, 207.2 | 0.676, 177.6 | 0.674, 178.6 | 0.613 | 0.643, 326.9 | 0.610, 356.7 | 0.627, 341.2 |
| keep: the prompt's uses only in end_prefill | 0.616, 210.2 | 0.651, 191.4 | 0.676, 177.6 | 0.604 | 0.671, 300.6 | 0.616, 351.6 | 0.640, 328.9 |
| long: count, calls of >= ~100 rows only | 0.616, 210.2 | 0.676, 177.5 | 0.678, 176.2 | 0.604 | 0.671, 300.6 | 0.616, 351.6 | 0.628, 340.1 |

- All of O's decode effect is its use counting. A need line counts a use of each id and one more
  of its layer's requests, so the decode's LFU (decayed use) weighs an expert-major prompt as it
  weighs a layer-major one. The reorder moves the decode by at most 0.1 point and the prompt's
  needs not at all (the 35B's turn 3: 4442 queued in every variant, as on the card). So its
  +0.29 s there is not streaming; the card's per-call lines show the same needs with 316 fewer
  need hits (ids named again while on their way), a timing effect or noise.
- Counting helps where a long prompt predicts its reply: the 35B's turn 4 summarizes the text it
  was given. It hurts where the reply follows the previous reply more than the question: the
  26B's short expert-major turns (its EM_ROWS is 20), with 16 slots a layer for a top-8 router.
- What each layer keeps at the prompt's end (keep) matters little; the decode's use counts do.

**Not the cache's capacity either** (`server_replay.py replay --slots N`: the same records on N
slots a layer). A switch by capacity (count where the slots a layer are several times the
router's top-k) would generalize without a per-model knob, but the sign is the model's at every
capacity. The decode's MB a token over all five turns, base -> count:

| slots a layer (x k = 8) | 35B | 26B |
|:--|:--|:--|
| 10 (1.2) | | 478.5 -> 483.5 (+1.0%) |
| 16 (2.0) | 275.6 -> 271.3 (-1.5%) | 340.7 -> 352.1 (+3.3%) |
| 24 (3.0) | 243.5 -> 238.7 (-2.0%) | 242.5 -> 257.7 (+6.3%) |
| 32 (4.0) | 219.0 -> 214.2 (-2.2%) | 180.2 -> 196.8 (+9.2%) |
| 38 (4.8) | 203.0 -> 198.8 (-2.1%) | 147.6 -> 159.9 (+8.3%) |
| 41 (5.1) | 195.3 -> 191.5 (-1.9%) | 131.5 -> 142.5 (+8.4%) |
| 48 (6.0) | 179.3 -> 175.9 (-1.9%) | 102.8 -> 106.4 (+3.5%) |
| 64 (8.0) | 146.1 -> 142.3 (-2.6%) | |

- At the same 16 slots the two go opposite ways, so no threshold on slots / k separates them.
- Gentler counts do not escape it. Each expert a layer's lines name counted once at the layer
  switch, or each line a use of weight 0.25 or 0.1: the effect shrinks with the weight on both
  models, the 35B -0.8 to -1.5%, the 26B +0.2 to +2.9%. keep is about 0 on both at their own
  capacities. Whether a prompt's experts predict its reply's is the model's and its prompts',
  not the cache's.
- **O is dropped, count and reorder both**; production's server stays. What it could give is
  about -4 MB a token on the 35B: ~2.5 ms of ~190 at les1's 0.64 ms a MB, ~1.3% of its decode.
- Parked: the one form without a per-model knob is a duel on the host. Two directories of ids
  only (with the need lines' uses and without) follow the same requests, and the slots take the
  policy whose ghost missed less over the last turns. Too much machinery for ~1% on one model.

**On a resident pool** (every expert in DRAM above 4 GiB, AW 36: bcu1525-wg) there is no request
and no host to wait for: each expert streams from DRAM as its MMs ask. There `moe_ffn` and
`moe_ffn_rows` issue the shared expert's gate and up MMs right after the router's MM, before the
ARGMAX loop (they need only the normed input: `swiglu_down`'s `each(0)` runs the routing), so the
DRAM streams them while the VPU routes; its activation and down MMs follow the routing, and its
output is added last as before.
- The tiny Qwen3.5-MoE's logits on the resident pool are the low image's (the server's slots, the
  old order) bit for bit: per position, the resident decode loop, and the streamed engine's
  layer-major prompt (test_qwen35_moe, test_chatmoe).
- The 35B's decode program at bcu1525-wg: 4 MMs (its shared expert's 2 chunks of 256, gate and
  up) between each router MM and its ARGMAX, 0 before. Every bucket of a 4K context still fits
  IMEM (at most 2899 instructions, 2903 before).
- The programs of the server's slots (the offload path) are unchanged, word for word.

### 15.5 What we did not take, and the bigger levers

Not taken:
- the prefetch (15.3);
- LES's layer-wise mixed precision: experts below 4 bits are not pursued (the user's decision,
  2026-10-13);
- DSpark, MiniCPM-V's separate draft model: its 16-row block verify streams about 740 misses a
  step on the 35B's slots (2075 distinct experts), against 85.5 for a token. Base 35B's MTP
  head serves MiniCPM-V as well (15.6), so DSpark is not ported.

Levers larger than LES's scheduling, from `lesim.py time` on the 35B. Not built; each needs its
own decision:
- **More slots**: +10 a layer gives +5.5%.
- **An MTP verify of two rows a step** (15.6): bound 1.25x on the 35B, and the same on MiniCPM-V.

### 15.6 MTP on the streamed MoE: the bound, and the transplant to MiniCPM-V

A k = 1 MTP loop on path (a): each step is a verify run of two rows (the token and its draft)
through every layer, then the MTP layer drafts the next. Per layer the card asks for both
rows' experts: their union, 12.86 distinct a request against 8 (514 a step over 40 layers).

**The bound** (`tools/offload/mtp_bound.py`: lesim's card timeline and session 16's fit, the four
router traces, both rows' routes from consecutive tokens, the draft accepted with probability a):
- the second row of a layer, co-simulated (`moe_prefill_cosim.py layer`, r2's configuration,
  every expert present): DeltaNet 2.579 -> 2.974 ms, attention 2.053 -> 2.328 ms, so +0.365 ms a
  layer; each union expert beyond the 8, 0.1025 ms (`expert`: one FFN on 2 rows, port bound);
- the head on 2 rows +1 ms; the MTP draft 9.1 ms a step (the attention layer on 2 rows 2.33,
  its 4.9 more union experts 0.50, fc 0.26, a 32K fp4 head 2.13, about 4 misses of its own
  3.9); its slots come from the others (40 a layer).

| a | ms a token | tok/s | vs plain (178.4 ms) | misses a token | c_2 + c_draft |
|--:|--:|--:|--:|--:|--:|
| 0.75 | 143.9 | 6.95 | 1.24x | 85.4 | 1.40 |
| 0.78 | 142.3 | 7.03 | 1.25x | 85.3 | 1.41 |
| 0.85 | 138.9 | 7.20 | 1.28x | 85.3 | 1.43 |
| 1.00 | 132.6 | 7.54 | 1.35x | 85.0 | 1.48 |

The misses a token barely move: a step of two tokens streams twice a token's. What MTP saves is
the card's per-step time (the mixers' weights, the shared experts, the 29 ms head), read once
for 1.77 tokens at a = 0.78.

**The acceptance** (`tools/offload/mtp_transplant.py`, on the simulation host: HF transformers 5.18 with
minicpmv's LazyExperts, float32; greedy replies to tools/mtp_accept.py's nine prompts, up to
256 tokens, thinking off; teacher-forced drafts; the 32K fp4 head with int8 activations, as
docs/mtp.md's):

| drafter on | drafts | full float head | fp4, 32K ids |
|:--|--:|--:|--:|
| Qwen3.5-35B-A3B, its own MTP | 1706 | 0.836 | 0.782 |
| MiniCPM-V-4.7-35B-A3B, the base's MTP (its embedding and head) | 2295 | 0.850 | 0.796 |
| the same, each prompt's first drafts as many as the base's | 1706 | 0.831 | 0.784 |
| MiniCPM-V, the base's MTP with the base's embedding and head | 2295 | 0.854 | 0.795 |

By kind (fp4 32K, matched drafts): chat 0.745 / 0.753, code 0.897 / 0.883, summaries 0.684 /
0.699 (base / MiniCPM-V). MiniCPM-V's summaries run to the 256-token cap with 27-48% of their
8-grams repeated, which raises its all-drafts row; matched, the transplant equals the base.

So MiniCPM-V, which has no mtp.* weights, drafts with the base 35B's MTP layer as well as the
base does, and one MTP port serves both. The bound is greedy; sampled acceptance (docs/mtp.md:
about 0.04 lower on the dense models) and the host's per-step costs are not in it.

**The port** (branch les-mtp, on S; docs/mtp.md 12 for the loop's programs):
- `streamed.engine(mtp=True, mtp_from=None)`, otpu-chat and tools/qual/chatmoe.py `--mtp`
  (`--mtp-from DIR`): an MTP image of 2 rows, the checkpoint read with its mtp.* tensors, or
  with another checkpoint's (MiniCPM-V's: the base 35B's); a checkpoint without them is refused.
- Its pool has one more layer: the MTP layer's 256 experts after the model's (g = 40 E + e),
  by default pool-mx1-<format>-mtp.bin. `pack_pool.py extend SRC` makes it from the model's
  own pool, checked by its key, without packing it again: SRC's experts and marks, the MTP
  layer's unpacked (the run packs each on its first use, or `pack --mtp`, or `recv --mtp`).
  On btrfs or XFS (the card host's /home) the experts are reflinked: the disk holds only the
  MTP layer's 438 MB more and production's file is never written. A source with entries past
  its experts (MiniCPM-V's staged vision pieces) gives its experts only; the pieces go after
  the MTP layer (41 E + i).
- The pool's key names the MTP layer's checkpoint when it is another's (`mtp_from`), and so
  does the image cache's key.
- The card host's checkpoint has no mtp.* (strip_experts.py drops them):
  `strip_experts.py BASE DIR --mtp --only mtp. --out mtp.safetensors` (0.1 GiB) beside links
  to that checkpoint's files makes the MTP image's, production's directory unchanged.

**Bit for bit on the 35B** (ISA simulator, the simulation host, r2's configuration, the 41-layer pool
extended from the MX pool, the MTP layer's experts packed on their first use): les1's five chat
turns through chatmoe --mtp (otpu-chat's Chat: the MTP prefill, layer-major and expert-major,
the loop on the device, the turns' rollbacks) give plain decode's 135 tokens, every one. The
drafts were accepted 3 of 4, 13 of 18, 11 of 20, 14 of 17 and 14 of 17 times by turn: 0.72 in
all (the 32K fp4 head; mtp_transplant's teacher-forced 0.78).

That run found a chat bug: from the second turn on every turn started over (the whole context
prefilled again: turn 5's 333 tokens against plain's 55), its tokens still exact. The MTP
prefill's first conv_k - 1 rows (the rows kernel's runs before the layer runs) did not report
to on_run, so Chat.fed missed three tokens and the next turn found no common part. Fixed
(MTPDecoder.prefill); test_moe_mtp_chat_turns_roll_back_to_the_reply (three turns on the tiny
MoE: each rolls back a token before the reply's start; replies equal plain greedy decode's).

**The real programs, co-simulated** (`moe_prefill_cosim.py mtp`: the plain loop's token against
V and D of mtp.compile_gen, the 35B cut to 4 and 8 layers, the production formats, r2's
configuration, every expert present; a layer's cost the difference of the prefixes):

| | per 4 layers | 40 layers and the head |
|:--|--:|--:|
| plain decode, a token | 9.97 ms | 130.8 ms |
| V, the verify of 2 rows | 11.64 ms | 147.6 ms |
| D, the draft | | 5.02 ms |

So the second row costs 0.42 ms a layer (the bound took 0.365), the 248K head on 2 rows +0.05 ms
(1.0), and the draft 5.02 ms besides its union experts (~0.5 ms) and its own misses (~3.9 ms).
The MTP image leaves 38 expert slots a layer at the card's 4 GiB (fit_experts; plain 41): the
2-row buffers, the second DeltaNet state slot, the MTP layer and its draft head. mtp_bound.py
with these (`--slots 38 --slots-plain 41 --dmix 0.4175 --dhead 0.05 --cdraft 9.42`): 178.4 ->
145.3 ms a token at a = 0.78 (1.228x; 1.215x at 0.75, about 1.21x at the ISA run's 0.72).

The card check is session mtp1 (tools/offload/sessions/mtp1.sh): production's host, plain,
against les-mtp's with --mtp on production's bitstream, the 35B's five les1 turns in ABBA order,
each run's tokens les's reference, each pool wholly in the page cache before its run. The two
pools (17.5 GB, the MTP one 18.0) do not fit the card host's page cache (31 GB) together, so
each switch of arm reads the next arm's from the SSD again (~130 s), and before each read every
other file of 100 MB or more under ~/openTPU, ~/otpu-build and /data/otpu leaves the page cache:
mtp1's second run (mtp1b) stopped before its first run with production's pool 63% in the page
cache, beside MiniCPM-V's pool on /data/otpu, cached since session hostr21.

**mtp1's first run hung** (2026-10-14, B's warm-up): the card ran and never halted (STATUS RUN,
no error), and the host's wait for HALTED timed out after RUN_TIMEOUT; the card itself was fine
(the final selftest passed, ECC 0 / 0). The cause is the host's, in BoardBackend.run_generate:
with a host hook (a streamed MoE's servers) it served the card only until the n-th token landed,
then waited for HALTED. Plain decode halts right after its last token, but the MTP loop does not:
its last D runs the MTP layer after the verify that wrote the last token (the MTP layer's KV row
and the draft, for a later run to continue from), and the MTP layer's MoE request and the rows of
its two tokens wait for the host's answers. A reply that ends at max_new (les1's turns 2-5; turn
1 ends at its end id, before n, and was served to the halt) therefore waited forever. The ISA
simulator serves inside its WAITW, so no ISA run could show it. Now run_generate with a hook
serves until the card halts (tests/test_host_runs.py test_a_generate_run_is_served_until_it_halts:
a fake card that posts its last request 20 ms after its last token; the previous code stops at
the token and waits).

**mtp1c passed** (2026-10-14, production deploy_hostr21_b10245f5 as arm A, so A has S and B - A
is MTP alone; ABBA x 2 after a warm-up of each arm; every run's tokens les's five-turn ISA
reference, the first two production's). Decode, token-weighted over the turns: A 196.8, B 174.7
ms a token, 1.127x (turns 1.129 / 1.177 / 1.041 / 1.143 / 1.161x), acceptance 0.75 / 0.72 / 0.55 /
0.82 / 0.82; decode MB a token +15 to +44 (hits -0.05 to -0.09). TTFT +0.02 / +0.37 / +0.65 /
+0.65 / +0.88 s, the means' parts (turns 2-5):

| part of B - A | turn 2 | turn 3 | turn 4 | turn 5 |
|---|---|---|---|---|
| the prompt's last call (5 rows against 4) | +0.16  | +0.19  | +0.20  | +0.16  |
| after the calls (the first draft's run) | +0.16  | +0.13  | +0.13  | +0.14  |
| the first call (layer-major / expert-major) | +0.05  | +0.32  | +0.32  | +0.59  |

- The last call's extra row: Chat took MTP's snapshot a token before the reply's start and rolled
  back to k - 1 (the MTP layer's row at k - 1 takes the token at k, which the next turn changes),
  so each turn fed that position again through the whole model, and 5 rows at R = 2 are 3 runs a
  layer (122 runs against 81). Now (F2) the snapshot is plain's: the part before it keeps its last
  row's residual (Engine.prefill_layers(keep=True)), the snapshot holds it, and after a rollback
  to it the next prefill appends the MTP layer's row before it from that row and the new token
  (one 1-row K / V run, Engine.prefill_layers(fix=...)), bit for bit a re-run's
  (tests/test_mtp_moe.py test_moe_mtp_rollback_to_a_held_snapshot_is_a_rerun).
- The first draft: after the head, a 1-row MTP run of its own (compiled at its position, its MoE
  request served) before a0 came back. Now (F1b) the prefill returns a0 at once and the loop's run
  starts with the D1 of the last prompt row's bucket (the loop's own program, its request served
  in the run), bit for bit the former draft (test_moe_mtp_loop_drafts_the_prompts_last_row_first).
- The first call: the layer-major one (turn 2) costs only its K / V runs (7: +0.03 s device). The
  expert-major ones (turns 3-5) streamed the same needs and bytes in both arms (needs queued 4442
  / 6602 / 4394, 7.6 / 11.3 / 7.5 GB) and still took +0.20 to +0.40 s more device time, their idle
  parts +0.16 to +0.29 s more; the MTP image's 38 slots a layer against 41 do not explain it
  (server_replay of the 35B's record at 38 and 41: +6 needs a prompt, decode +7 MB a token). Open:
  a --trace of an expert-major turn in each arm on the card.

The next card check is session mtp2 (tools/offload/sessions/mtp2.sh): mtp1c's arms and runs with
B on F1b and F2, then one more run of each arm with chatmoe --trace (outside the timed ones). It
puts the measured TTFT B - A of each turn beside the model's, mtp1c's means less the parts the
two fixes remove (-0.31 / +0.06 / +0.33 / +0.33 / +0.59 s: the first call's part left in turns
2-5), and from the traced pair the expert-major turns' (3-5) calls by run kind (layer, expert,
K / V, head): device and wall time, the gaps between runs, the server's idle parts and requests.

mtp2 passed (2026-10-14, token-exact throughout): decode 1.123x, TTFT B - A +0.00 / +0.29 / +0.23 /
+0.33 / +0.32 s. F2 took the last call's extra row away (its part +0.02 to -0.02 s, from +0.16 to
+0.20); F1b only ~0.035 s (0.08 in turn 1). What is left in turns 2-5, besides the first call's,
is +0.10 to +0.13 s outside the calls, which the call times cannot place. chatmoe.py --trace now
stamps each turn's host phases up to its first token (_Phases: the template, the rollback with its
restore, each prefill_layers and its end_prefill, the snapshot and MTP's held row's read, MTP's own
prefill, a0, and each device run outside the calls with its cycles; host bookkeeping, the same runs
and tokens: tests/test_mtp_moe.py test_chatmoe_traces_each_turns_host_phases, 16 DeltaNet heads). On
the ISA simulator only turn 1's MTP prefill of the first conv_k - 1 rows leaves time outside them
(its compiles, ~0.11 s); the card's step is tools/offload/sessions/mtpt.sh (~10 min: a traced run
of each arm from one tree, A's and B's tokens the same, each turn's TTFT B - A by phase).

Turn 3's 0.55 is the reply's content and the draft head, not the loop: on the fp32 reference
(Hugging Face's float32 35B along the card's tokens, the base's own mtp.* layer, mtp_transplant.py
accept, replayed as the k = 1 loop) the head the card has (fp4, the 32K lowest ids) accepts 12 of
20 there (the card 11 of 20) and 56 of 75 over the five turns (the card 55 of 76), the full fp32
head 13 of 18; 13% of turn 3's targets (a markdown list with an en dash, numbers and French names)
are outside the 32K ids.

Another 32K-id set does not pay (2026-10-14). Ranked by frequency on 10M tokens of UltraChat's
replies (MIT; none of mtp_accept.py's prompts), the 32K most frequent ids cover fewer reply
targets than the lowest 32K on gen-base (0.902 against 0.927: chat +2.1 points, summaries +6.0,
code -14.5, UltraChat having little code); the lowest 16K and then the most frequent above them
cover the most (0.953, code -0.9; the card's five turns 0.900 -> 0.954). On the fp32 reference
(mtp_transplant accept's drafts, the fp4 head, int8 activations) that set gains per position
+1.8 points on gen-base (0.782 -> 0.800), +1.5 on gen-mcpv (MiniCPM-V's replies, its embedding and
head: 0.796 -> 0.811) and +4.6 on the five turns (130 targets), but the k = 1 loop's acceptance,
which the decode follows, only +0.6 / +0.4 (0.775 -> 0.781, 0.791 -> 0.795; the five turns +6.1),
with code -1.2: ~+0.2-0.4% decode. The device's side would be cheap: the draft index's id from a
table in DRAM (an RLD MUL into a register and a one-word load, as qwen3._embed_word) costs D +372
cycles (+0.056%) and D1 +46 in co-sim (the prototype: branch draft-ids, e7c58f75), but not worth a
table and its mechanism in every MTP image: the draft head stays the lowest 32K ids.

### 15.7 MTP on m8, and the compiles in its TTFT

Session mtp_rel (2026-10-14, right after r2.1's promotion: production m8, bitstream 039b34d5,
host d57a3568; ~11 min under the lock after the emprol A/B, the selftest ALL PASS before and
after):
- (a) production's host, both arms with OTPU_TILE=0 (before mtp-slot-fix a tiled run refuses the
  states' slot 1; batch3's MTP engines run untiled), chatmoe.py's two default turns at
  --max-new 16: --mtp's tokens plain's, and both the release's chatmoe reference.
- (b) mtpt.sh's traced pair from mtp-stamps on mtp-slot-fix (tiled), each arm after a one-turn
  warm-up: les1's five turns at 32 tokens, the same tokens in every turn. Device decode, Mcycles a
  token A / B: 27.46 / 25.71, 25.45 / 22.12, 26.80 / 26.47, 26.20 / 22.05, 25.58 / 21.64, so
  1.12x token-weighted (m4's mtp1c: 1.127x), 1.15-1.19x in turns 2, 4 and 5 (13 of 18, 14 of 17
  and 14 of 17 drafts accepted), 1.01x in turn 3 (11 of 20). TTFT B - A: -0.02 / +3.40 / +0.58 /
  +9.40 / +0.15 s.

The two jumps are the host's, not the card's. In the grown calls the card's work is the same
(device 3.67 / 3.76 s in turn 2's layer-major call, 9.46 / 9.46 s in turn 4's expert-major one;
the server's serve and parts times, needs and misses within 0.1%), but B waits before nearly
every layer's first run: 29 gaps of 40-375 ms (2.96 s) in turn 2, 51 (9.30 s) in turn 4, where
A has none over 30 ms and 3 (0.15 s).

- **The states' slot 1, compiled per process.** Engine._layer_run keeps an MTP image's runs of
  the DeltaNet states' slot 1 apart from slot 0's (under (key, "slot", 1); mtp-slot-fix compiles
  them with that slot's descriptors), and layer_programs has no disk cache: each process
  compiles each run kind once per slot. After a reply the loop's committed slot is the parity of
  its accepted drafts (S_PAR: c ^= n, a draft accepted with an end id as a1 included), and a
  rollback restores into it, so the five prefills ran in slots 0, 1, 0, 1, 1 (3, 13, 11, 14
  accepted). Turn 2 is the first layer-major call in slot 1; turn 3 the first expert-major one
  (the tiles) in either arm, 17.0 / 17.6 s of gaps in A / B; turn 4 the first expert-major one in
  slot 1; turn 5 finds them compiled (no gap over 30 ms). On the ISA simulator (the tiny MTP MoE
  through chatmoe.py --mtp, the slot set to 1 before turn 2; a scratch run): turn 2 compiles all
  29 runs turn 1 did again (20 expert-major, 9 layer-major, 0.27 s against turn 1's 0.25 s), plain
  decode's turn 2 only its 5 new ones. Why the worker processes (_precompile_layers) hide turn
  1's first compiles on the card and not these is open: follow-up 1 times them by key.
- **Both arms:** turn 4's 4-row call, 3.6 / 3.7 s of gaps: the first layer-major runs past
  position 256 (the attention's next block).
- **The decode's first reply in a bucket.** Turn 4's reply is the first in the KV cache's second
  bucket: A 3.44 tok/s against the device's 5.09 (+3.0 s, the plain loop's bucket programs
  compiled on first use, gen_warm's ~3.6 s), B 1.94 against 6.05 (+11.2 s, the MTP loop's:
  compile_gen's verify and drafts). gen_warm compiles plain decode's buckets ahead in otpu-chat and
  otpu-serve but not the MTP loop's (chat.py starts it only without MTP; chatmoe.py starts none);
  the MTP loop's programs are in the program cache per tree (Engine.cached), the slot-1 layer runs
  in none.

So with --mtp (otpu-chat, otpu-serve --mtp) a process pays its slot-1 compiles once per run kind
(here +3 s layer-major, +9 s expert-major), and the first reply in each bucket ~11 s once per
tree; past them TTFT B - A is mtp2's (+0.0 to +0.3 s) and decode 1.12x. MTP stays opt-in in
r2.2, and mtps.sh (otpu-serve's A/B for MTP by default: a server per run, so B would pay the
slot-1 compiles in each) waits for:
1. DeltaNet runs that take the committed slot as a run word (the states' base) instead of in
   their compiled addresses: one set of programs, nothing compiled twice (smaller:
   _precompile_layers compiling both slots for an MTP image, or the layer runs through the
   program cache);
2. gen_warm for the MTP loop's bucket programs.
