FeSens/openTPU/docs/prefill.md

# Prefill at run-time positions

**Goal:** a prompt's prefill from programs compiled once per attention bucket, not once per
prompt. Each prefill run currently bakes its positions and token ids into its program, so the
host compiles every run of every prompt. With the prompt in DRAM and the position as a run-time
value, the programs repeat across prompts, the program cache keeps them, and TTFT falls to the
device's prefill time. This is (1b) in the MTP plan (docs/mtp.md 11.7).

## 1. Where TTFT goes today

The card, e4db91c9, 133.33 MHz, fp4 with an int8 head, phase 0's prompts, wall seconds
(docs/mtp.md 11.7):

| model | prompt | runs | device prefill | plain TTFT | MTP TTFT | MTP's host compile |
|---|---|---|---|---|---|---|
| Qwen3.5-0.8B | 30 | 8 | 0.40 | 1.14 | 2.31 | 1.82 |
| Qwen3.5-0.8B | 237 | 60 | 3.09 (+0.20 MTP layer) | 4.67 | 16.92 | 13.22 |
| Qwen3.5-2B | 30 | 8 | 0.74 | 1.44 | 2.81 | 1.95 |
| Qwen3.5-2B | 237 | 60 | 5.63 (+0.47) | 6.15 | 20.04 | 13.55 |
| Qwen3.5-4B | 30 | 10 | 2.36 | 3.24 | 5.49 | 2.91 |
| Qwen3.5-4B | 237 | 79 | 18.39 (+0.99) | 18.73 | 39.32 | 19.33 |

- **The device's part.** A prefill run streams every weight once for its R rows. One MXU pass
  takes MCOLS = 4 rows, so a run costs about a decode step: 6.9 / 12.5 / 31 M cycles. The
  0.8B and 2B take R = 4, and the 4B R = 3: R = 4 does not fit its TMEM (fit_chunk).
- **Plain prefill** compiles each run while the device runs the one before (Engine's worker
  pipeline). Short prompts still wait 0.6-0.9 s: the first run's compile, and R = 8 tried
  first, which fails TMEM.
- **MTP's prefill** compiles its runs one after the other on the host: a rows run and an MTP
  layer run per chunk, 0.1-0.25 s each on the card host. For a 237-token prompt that is
  13-19 s.

## 2. What exists

- `RunPos` / `RunRows` (qwen3.py): rows at a run-time position of a bucket, with RunPos.offset
  (gemma4: row r at tpos + r with its own mask row) and `bucket_row`.
- `Image.compile_rows_run` / `compile_mtp_run` (qwen35.py, gemma4): qwen35_rows and
  qwen35_mtp over RunRows, with the tokens as run arguments.
- `compile_layer_run` / `qwen35_embed_run` / `qwen35_prefill_head`: layer-major runs for the
  MoE models. Those stay as they are.
- The generate loop's state block, `run_words` (arguments from state words, RLD MUL) and
  HALT CHAIN; the program cache.

**But `compile_rows_run` does not compile on the real layouts.** On the 0.8B (cap 4096,
buckets 1, 2 and 16, `hidden=True`), R = 1 or 2 runs out of address registers, and R = 4 or 8
needs more than 8 run-time argument values. A decode bucket's arguments are already 7 (0.8B):
the token (x 4096, its embedding row) and tpos at six coefficients (128, 256, 8, 1, 4, -4: K
and its scales, V^T's column, V's scale, RoPE, the mask). R tokens as arguments make that
R + 6, so only R = 1 or 2 could ever fit, and even those leave the 16 DeltaNet heads no
registers.

## 3. Design

**The prompt's tokens go in DRAM, not in the arguments.** `out[]`, the generate loop's
token-per-position array, holds the token at each position q. The host writes the turn's new
tokens to out[p0 .. P) before the prefill. Each run then loads its R tokens, out[tpos + r], into
TMEM with one LD at a run-time address. Each embedding gather takes its row address from a
scratch register (RLD MUL, the row's bytes), released after the gather. The arguments are then
tpos's six coefficients for every R: R rows share one tpos, at r-row offsets as immediates
(RunPos.offset). Every one of those RLD MULs carries its bound (the arguments' c * [0, tpos's
bound), compiler.mul_bound; a token row's, the table's rows), so the waits pass takes the
addresses they form as theirs: unbounded, a register made each footprint all of DRAM (the 27B's
T 8 run: 285 of 4,942 wait entries tighter than they need be). The port-A rule is kept: out[] and the state are read by LD (port B), and since
4e0b866 port A is flushed at every run start anyway.

**Programs per bucket** (one image; R_max = 4, or 3 on the 4B):

| kind | rows | logits | count |
|---|---|---|---|
| P_r | r = 1 .. R_max, at tpos <= block - r | none | R_max |
| L_r | r = 1 .. R_max, the prompt's last run | last row's, then the first pick | R_max |
| (MTP image) M_r | the MTP layer over the run's rows (h_q, x_(q+1)) | the draft | R_max |

- That is 8 programs per bucket (12 with MTP), compiled when first used and then kept by the
  program cache. A typical prompt uses P_Rmax, one L_r, and a P_r where a run would cross the
  bucket's end. At cap 4096: 16 buckets, at most 128 / 192 programs, each 0.1-0.25 s once.
- **Positions 0 .. conv_k - 2** (a new conversation's first rows) stay at compile time:
  `_deltanet_rows`' taps take K - 1 as their run-time stand-in, as gemma4 noted. That is one
  head run H_r per R at p0 = 0, with run-time tokens, cached like the rest.
- **The runs' split** depends only on (p0, P, R_max, block): runs of R_max rows, cut at the
  bucket's end, the last one L. Plain and MTP engines get the same runs, so they get the
  same logits bit for bit, as today's fit_chunk gives both.

**MTP shares it.** The MTP image's P_r / L_r are the same kernels with `hidden=True` (the
rows' hidden to `hid`). After each rows run, M_r runs the MTP layer over the same rows. Its
tokens x_(q + 1) come from out[q + 1]. For the last run, x_P is the first token: the device's
pick, or the host's, written to out[P] before M_r. The last M_r's draft is the loop's first d,
as MTPDecoder.prefill gives today.

**Chaining (the target): one device run per turn.**
- Like the generate loop, every prefill program loads a state block (tpos, the rows left,
  the run's kind) and takes its arguments from it (`run_words`).
- At its end it advances tpos by R and HALT CHAINs to the next run's program: in this bucket
  or the next, P or L by the rows left, R = min(R_max, rows left, block - tpos). The bucket's
  table (like MTP's chain table) holds the programs' addresses.
- L_r picks the first token on the device: ARGMAX, or the Sampler with u[P]. It writes it to
  out[P], then chains into the generate loop's program at P (plain), or into M_r, then V or E
  (MTP).
- So a turn is one run, prefill and reply together. TTFT is the device's prefill plus the
  start, and the host streams out[] from the first token on, as it does today.
- otpu-chat's progress line reads the state's tpos while the run goes.
- **Checkpoint.** The same programs started one run at a time by the host (arguments per
  run), which is what `compile_rows_run`'s interface already is. This comes first; the chain
  goes on top once the programs are bit-exact. The first token then stays the host's pick.

**Models.** First the Qwen3.5 dense models, 0.8B / 2B / 4B, plain and MTP. Then Qwen3 and
LFM2 (qwen3_rows, lfm2's rows: RunPos with K - 1 static rows for LFM2's convolutions as well),
and Gemma 4 E2B (its rows kernel and per-row PLE rows from the gather the generate loop
already does).

The MoE models keep gemma4's layer-major runs, which are already at run-time positions
(`prefill_layers`, `compile_layer_run`, compiled in the worker processes ahead of their runs).
The new route takes `prefill_chunks` for dense images only (`spec.moe is None`). A MoE prompt's
rows below conv_k - 1 go through `prefill_chunks` as token steps (docs/offload.md 13.6, the
port-A workaround's default), and those stay as they are.

**Shared code, as agreed with gemma4.**
- This work changes: `_inputs_rows`' RunRows branch (the token source), `RunRows` (an out[]
  source beside the toks run variables), a helper for `_embed` / `_gather` with a token held in
  TMEM, the dense route of `prefill_chunks`, and `compile_rows_run` / `compile_mtp_run` /
  `_run_rows`.
- It leaves alone: RunPos.offset, `bucket_row`, `_attention_rows`, `prefill_layers` and its
  workers, `compile_layer_run`, and `qwen35_layer_run` / `_embed_run` / `_prefill_head`.

## 4. Expected TTFT

Device prefill as measured (the same runs, the same programs' arithmetic), plus about 0.05 s
of start-up per turn when chained; once per process and bucket, the cold compiles of 2-4
programs come on top (0.2-0.8 s, then the disk cache):

| model | prompt | plain now | plain (1b) | MTP now | MTP (1b) |
|---|---|---|---|---|---|
| Qwen3.5-0.8B | 30 | 1.14 | ~0.45 | 2.31 | ~0.48 |
| Qwen3.5-0.8B | 237 | 4.67 | ~3.1 | 16.92 | ~3.3 |
| Qwen3.5-2B | 30 | 1.44 | ~0.8 | 2.81 | ~0.85 |
| Qwen3.5-2B | 237 | 6.15 | ~5.7 | 20.04 | ~6.2 |
| Qwen3.5-4B | 30 | 3.24 | ~2.4 | 5.49 | ~2.5 |
| Qwen3.5-4B | 237 | 18.73 | ~18.4 | 39.32 | ~19.4 |

- A chat's later turns feed only what the template added, often 10-40 tokens: their TTFT
  becomes 0.2-0.8 s (0.8B, 2B).
- The 4B stays device-bound. Fitting R = 4 rows would buy nothing: with PAIR a 4-bit MM of
  at most MCOLS / 2 rows streams two blocks a cycle, so R = 4 costs R = 2's MXU time a row,
  and R = 3 pays R = 4's (ld-memch's RTL co-sim, LDC DDR3-1066, 133.33 MHz, position 544: the
  4B 278.0K cycles a row-layer at R = 2, 322.3K at R = 3). The 4B runs R = 2 instead (section
  7, prefer_rows). (Retired: the -24% item this line had.)

## 5. Plan

1. **Tokens from out[]** in qwen35_rows / qwen35_mtp over RunRows. Tests on the tiny Qwen3.5
   at 16 heads (kh16) and on the real layouts' compile: P_r / L_r / M_r for r = 1 .. R_max,
   buckets 1, 2 and 16, within 8 arguments and IMEM.
2. **Host-started runs** (Engine.prefill and MTPDecoder.prefill through them, cached). The
   logits and the KV cache, DeltaNet states and windows must equal today's fit_chunk prefill
   bit for bit, plain and MTP, from p0 = 0 and from a later p0 (a chat's next turn), across a
   bucket's end.
3. **The chain**: state block, the table, L into the generate loop or MTP's V. Tokens equal to
   step 2's runs, greedy and sampled; RTL across a bucket's end.
4. **Card**: TTFT for 0.8B / 2B / 4B, plain and MTP, prompts 30 and 237, against section 4;
   otpu-chat's TTFT on its line.
5. Qwen3, LFM2, Gemma 4 E2B.

Effort: steps 1 and 2 (the checkpoint, which already takes the compiles out of TTFT) about 1.5
days; the chain about 1 more day, then RTL and a card session.

**Risks.**
- The address registers of the 16-head rows kernel at a run-time position: MTP's V fit only
  with `_move_arg` (docs/mtp.md 10.1). With the token arguments gone it gains two or more
  registers, but this needs checking on the real layouts first (step 1).
- R_max is per bucket (its L program's fit; prefill.r_max), since a bucket's programs are all
  at one R and a later bucket's attention makes a longer program. The Qwen3.5 models take the
  same R in every bucket (4 / 4 / 3; the 4B now 2, section 7);
  Phi-4-mini's mix takes 3 rows in bucket 1 and 1 in bucket 16, as fit_chunk's runs shrink
  with the context today. Plain and MTP share it, so they split alike.
- The gate keeps test_qwen35_moe's layer-major tests (test_layer_major_prefill_is_bit_exact,
  test_layer_major_runs_compile_in_the_worker_processes), so the MoE path is shown untouched.

## 6. Measured: host-started runs, and the chain parked

Steps 1 and 2 are in (`opentpu/llm/prefill.py`, `qwen35_prompt_run`, tests/test_prefill.py).
The engine keeps each prompt program (on the card assembled once); `Engine(prompt_runs=True)`
and `MTPDecoder.prefill` use them, otpu-chat by default (`--no-prompt-runs`: the old route).
On the ISA simulator the logits and every slice's DRAM equal compile-time runs of the same split
word for word, and with int8 weights today's prefill too. Real layouts (cap 4096, fp4 and int8):
every program fits IMEM; R_max 4 / 4 / 3.

**Card** (pa e4db91c9, 133.33 MHz, 2026-10-02 07:18-07:37 on the card host's clock; fp4, int8 head; tree
76ef74b; `mtp_decode --loop device --prompt-runs`, prompts 0 and 7; MTP's tokens equal plain's in
every run; with prompt runs on and off the tokens are equal for all three models, both prompts,
plain and MTP). Wall seconds to the first token, warm program cache; "device" is the prefill
runs' cycles (MTP: rows and MTP layer runs):

| model | prompt | plain old | plain now | device | MTP old | MTP now | device |
|---|---|---|---|---|---|---|---|
| Qwen3.5-0.8B | 30 | 1.280 | 0.604 | 0.405 | 2.410 | 0.557 | 0.431 |
| Qwen3.5-0.8B | 237 | 4.594 | 3.146 | 3.096 | 16.622 | 3.435 | 3.302 |
| Qwen3.5-2B | 30 | 1.400 | 0.959 | 0.743 | 2.767 | 0.898 | 0.803 |
| Qwen3.5-2B | 237 | 6.084 | 5.689 | 5.645 | 20.029 | 6.247 | 6.114 |
| Qwen3.5-4B | 30 | 3.224 | 2.905 | 2.364 | 5.442 | 3.016 | 2.488 |
| Qwen3.5-4B | 237 | 18.643 | 18.478 | 18.425 | 38.705 | 19.577 | 19.413 |

- **Per run, the host adds 0.5-0.8 ms (plain) and 1.0-1.1 ms (MTP: its rows and MTP layer
  runs alternate, each loading its program).** On the 237-token prompt (60 / 79 runs, MTP twice
  that) that is 0.3-1.6% of TTFT plain and 0.8-3.9% MTP (0.13 s, the 0.8B's MTP).
- **A process's first prompt pays 0.1-0.5 s more** (prompt 0 above: 0.20 / 0.22 / 0.54 s
  plain): its programs read from the disk cache, the engine's compile workers still starting
  beside it, and on the 4B R_max's probe of R = 4 (traced until TMEM runs out, every process).
  The chain would not remove it: its programs load the same way. A warm-up of bucket 1's
  prompt programs when the engine starts (or a kept R_max) would.
- Cold (a new program cache), the first prompt also compiles its 4-6 programs: 0.87-1.35 s.
- otpu-chat on the 2B (23 tokens, cold cache): plain and `--mtp` replies byte-equal, TTFT 1.41 /
  1.68 s.

**The chain is parked.** Host-started runs cost at most ~4% of TTFT (the 0.8B's MTP), at most
0.16 s on any prompt measured, and under 2% for plain prefill; the chain (state block, chain
table, the first pick on the device, RTL and a card session) would save only that. Its design
above stays the plan if prefill runs get much shorter (more rows per weight pass, a faster
link to the host's pick) or the host's per-run cost grows. Next: the other dense models
(step 5).

## 7. Prompt runs against today's rows

A run's device time is about its weight passes, ceil(rows / MCOLS): each pass streams every
weight. A bucket where prompt runs took fewer rows than today's prefill (fit_chunk's
compile_rows runs) at the same positions would stream the weights more often. Compiled on
the real layouts (the build host, compile only; cap 4096, block 256, MCOLS 4, image rows 8; fp4 and
the mixes with an int8 head), the rows of a run in buckets 1 and 16 and the weight passes of
three prompts (P tokens from p0), prompt runs / today's:

| model | format | rows, bucket 1 | rows, bucket 16 | p0 0, P 30 | p0 3850, P 30 | p0 0, P 237 |
|---|---|---|---|---|---|---|
| Qwen3-0.6B | int8 | 4 / 8 | 4 / 4 | 8 / 8 | 8 / 8 | 60 / 60 |
| SmolLM3-3B | int8 | 4 / 4 | 4 / 4 | 8 / 8 | 8 / 8 | 60 / 60 |
| SmolLM3-3B | mix | 4 / 4 | 3 / 3 | 8 / 8 | 10 / 10 | 60 / 60 |
| Phi-4-mini | int8 | 3 / 3 | 3 / 3 | 10 / 10 | 10 / 10 | 79 / 79 |
| Phi-4-mini | mix | 3 / 3 | 1 / 1 | 10 / 10 | 30 / 30 | 79 / 79 |
| LFM2.5-230M | int8 | 4 / 8 | 4 / 4 | 8 / 8 | 8 / 8 | 60 / 60 |
| LFM2-2.6B | int8 | 4 / 4 | 1 / 1 | 8 / 8 | 30 / 30 | 60 / 60 |
| Qwen3.5-0.8B | fp4, int8 | 4 / 4 | 4 / 4 | 8 / 8 | 8 / 8 | 60 / 60 |
| Qwen3.5-2B | fp4 | 4 / 4 | 4 / 4 | 8 / 8 | 8 / 8 | 60 / 60 |
| Qwen3.5-4B | fp4, mix | 3 / 3 | 3 / 3 | 10 / 10 | 10 / 10 | 79 / 79 |

- **The passes are equal everywhere.** In bucket 16 Phi-4-mini's mix and LFM2-2.6B take one
  row a run with both routes: today's two-row run at 3840 is over IMEM too (4538 and 5116
  instructions), since attention is unrolled per row, head and block and so grows with the
  context. A long context there costs 3-4x the passes of bucket 1 either way (below).
- **Runs.** Qwen3-0.6B and LFM2.5-230M fit 8 rows (two passes) in one run of today's in
  bucket 1, where a prompt run takes one pass's 4: the same passes, more runs (30 tokens 8 / 5,
  237 tokens 60 / 31). On the card that cost Qwen3-0.6B's 236-token prompt 7% more device
  cycles and 2.2% of its TTFT (below), so R_max now takes fit_chunk's sizes: one pass, then
  whole passes up to the image's rows where the L program fits (Qwen3.5 stays at one pass: its
  MTP runs take R_max too, and its real layouts fit 4 rows at most). A new context's first run
  (compile-time positions before conv_k - 1) is sized on its own, R_max(0): LFM2.5-230M's fits
  8 rows at a run-time position but 4 from position 0 (its first card recheck stopped there).
- **A bucket's end.** A run-time run's rows stay in its bucket, so a prompt that crosses one
  can take one pass more than today's (3 tokens from 255: runs of 1 and 2 rows, today's one of
  3), at most one per bucket crossed.

**Which runs R_max must hold.** The split cuts a run at the prompt's end and at a bucket's end,
so a prompt asks for every R' <= R_max of a bucket, as P and as L (an MTP engine: its rows with
their hidden, and the MTP layer's M), and with convolutions for the first run at every
compile-time position 0 .. conv_k - 2. The probe takes the largest size at which all of those
fit, not the L program alone: main's L-only probe had LFM2-2.6B (int8 and the mix) at R = 4
from position 1 out of TMEM (a prompt after a one-token one); every other kind and size of
the 14 real layouts (the 12 above, Qwen3.5's MTP images, E2B) fit. Their programs land in the
program cache, so a later prompt compiles none.

**Odd R.** PAIR exists only for 4-bit MMs (of at most MCOLS / 2 rows): at MCOLS 4 a 4-bit run
of 3 rows takes 4 rows' MXU time and 2 rows cost 25% less a row by the MXU stream (13.8% in the
co-sim, the rest is attention and the vector unit; on the card the 4B's 237 tokens 18.355 ->
15.918 s, -13.3%, 79 -> 119 runs), while an int8 MM streams once per MCOLS rows, so 3 rows
cost 33% less a row than 2. prefer_rows (qwen3) takes R - 1 rows for an odd R > 1 where the
compiled runs' MXU time a row (mxu_time: each MM's streamed rows x K blocks, half of it
PAIRed, times its loops' counts) is at least PREFER_MARGIN = 10% lower; both routes use it
(the probe and fit_chunk), so they compare alike. The margin is ld-memch's co-sim's: mxu_time
leaves out what a run and a layer pay once, so it overstates R - 1's gain (Phi-4-mini's
fp4-MLP layer: 6.1% cheaper a row at 2 rows by mxu_time, 0.5% dearer in the co-sim, where 2
rows reach 89% of their MXU roofline and 3 rows 95%; the 4B: -25%, co-sim -13.8%). A layout
whose R - 1 lands at 5-15% is co-simmed before its rows change. A mix falls between, at about 2/3 of its MXU
blocks 4-bit (by the weights' shapes: Phi-4-mini's mix about 56% fp4 blocks, SmolLM3's
about 43%, both keep 3); the 4B, fp4 and its mix, goes from 3 rows to 2.

**Card, the row choice** (fmvf 542fc43a, 2026-10-02, tree 666b2ef 13:14 and 5dd7823 14:15-14:18
The card host; one engine a model, warm-ups first, then A / B / B / A; tokens equal in every phase,
and the 4B's R = 3 and R = 2 splits give the same 16 tokens a turn):

| model | prompt | A | B | per pair (B - A) |
|---|---|---|---|---|
| Qwen3.5-4B fp4 (A: R = 3, B: R = 2) | 237 | 18.350 / 18.360 | 15.904 / 15.932 | -2.437 s (-13.3%) |
| | 24 | 1.893 / 1.896 | 1.639 / 1.642 | -0.254 s |
| | 13 at 252 | 1.097 / 1.099 | 0.971 / 0.973 | -0.126 s |
| Qwen3-0.6B int8 (A: off, B: on at R = 8) | 236 | 2.203 / 2.215 | 2.145 / 2.143 | -0.065 s (-2.9%) |
| LFM2.5-230M int8 (A: on at R = 8, B: off) | 238 | 0.749 / 0.746 | 1.925 / 1.953 | off +1.19 s |

The 4B's device cycles fall 13.5% (2441.7 -> 2113.1 M, 79 -> 119 runs), the co-sim's 13.8%;
mxu_time a row at R = 2 against 3: the 4B fp4 -24.9%, its mix -18.8%, LFM2-2.6B's mix -22.3%
(they take 2), Phi-4-mini int8 +49.2%, its mix +7.7%, SmolLM3's mix +17.4%, E2B int8 +49.1%
(they keep 3). Qwen3-0.6B (0.6B, 8 rows a run in bucket 1) now prefills its 236 tokens in
today's 30 runs, 2.9% faster than today's route; its device cycles are still 5.4% more (the
open item below).

**The rule (prefill.covers).** A prompt takes prompt runs when in every bucket it touches
R_max(bucket) >= today's rows there (Qwen3.5: up to one pass), so no bucket streams the weights
or runs more often; otherwise Engine.prefill_chunks and MTPDecoder.prefill take today's route
for the whole prompt. Today's rows are checked only where R_max is below the largest size (the
image's rows, the cache's end): compile_rows of the next larger size at the bucket's first
run-time position must not fit, or take no more rows than R_max by prefer_rows. The answer is kept with R_max (progcache.fact: once per layout and bucket).
Every layout above is covered in buckets 1 and 16.

**Card** (fmvf 542fc43a, 2026-10-02 11:04-11:13 on the card host's clock, E2B 11:16-11:28; tree ce0f3b1, cap
1024; one engine a model: prompt runs on with a new program cache, off, on again; the qual
prompt (A0), PROMPTS[7] (B0) and a next turn of 13 tokens at the run-time position after B0's
reply (B1); up to 32 tokens each on the device loop; tokens equal in every phase for every
model, and equal to the ISA simulator's prompt runs for Qwen3-0.6B, LFM2.5-230M, LFM2-2.6B and
E2B, whose references fit the build host's memory). TTFT seconds, on (cold) / off / on (warm), and the
prefill's runs and device Mcycles (on / off):

| model | prompt | on cold | off | on warm | runs | Mcycles |
|---|---|---|---|---|---|---|
| Qwen3-0.6B int8 | A0 24 | 0.482 | 0.377 | 0.236 | 6 / 3 | 30.5 / 27.6 |
| | B0 236 | 2.199 | 2.150 | 2.197 | 59 / 30 | 288.0 / 268.7 |
| | B1 13 at 267 | 0.392 | 0.306 | 0.165 | 4 / 3 | 21.4 / 20.2 |
| LFM2.5-230M int8 | A0 21 | 0.561 | 0.417 | 0.079 | 6 / 4 | 9.9 / 9.5 |
| | B0 238 | 0.775 | 1.854 | 0.769 | 60 / 31 | 96.5 / 92.7 |
| | B1 13 at 269 | 0.355 | 0.377 | 0.057 | 4 / 3 | 7.0 / 6.8 |
| LFM2-2.6B mix | A0 21 | 1.856 | 1.661 | 0.842 | 6 / 6 | 111.3 / 110.5 |
| | B0 238 | 8.936 | 12.052 | 8.948 | 60 / 78 | 1185.5 / 1520.0 |
| | B1 13 at 269 | 1.990 | 1.393 | 0.692 | 5 / 5 | 91.5 / 90.8 |
| SmolLM3-3B mix | A0 80 | 4.029 | 3.967 | 3.633 | 20 / 20 | 482.4 / 474.2 |
| | B0 291 | 13.633 | 13.228 | 13.235 | 73 / 73 | 1757.7 / 1737.4 |
| | B1 13 at 322 | 0.903 | 0.886 | 0.713 | 4 / 4 | 94.3 / 93.3 |
| Phi-4-mini mix | A0 15 | 2.069 | 1.708 | 1.065 | 5 / 5 | 141.2 / 138.9 |
| | B0 227 | 15.539 | 15.566 | 15.548 | 76 / 76 | 2066.2 / 2044.5 |
| | B1 13 at 258 | 2.111 | 1.282 | 1.020 | 5 / 5 | 135.4 / 134.1 |
| Gemma 4 E2B int8 | A0 13 | 4.211 | 0.816 | 0.577 | 4 / 4 | 76.2 / 70.2 |
| | B0 224 | 7.960 | 7.691 | 7.962 | 56 / 56 | 1056.2 / 989.3 |
| | B1 13 at 224 | 0.576 | 0.747 | 0.576 | 4 / 4 | 76.2 / 75.6 |

- Warm, prompt runs take short prompts and a chat's next turn 1.3-6.6x faster, and long ones
  as fast (SmolLM3, Phi) or faster: LFM2-2.6B's 238 tokens 12.05 -> 8.95 s, where today's
  runs took 3 rows (78 runs) and the prompt runs 4 (60).
- Cold (the first prompt of a new program cache) the programs are compiled once: +0.2-1.3 s
  (E2B's first prompt 3.6 s).
- Slower on: Qwen3-0.6B's B0, +2.2% (the 8-row runs above, since taken by R_max: the card's
  recheck pending), and E2B's B0, +3.5% (below). Prompt runs stay on by default for E2B too:
  its 224-token first prompt costs 0.27 s more, its short prompts and next turns take 0.58 s
  against 0.75-0.82 s (and a chat's later turns compile nothing).
- **Open: more device cycles at the same runs**, +0.7-1.2% on LFM2-2.6B, SmolLM3 and Phi, and
  on E2B by position: +8.5% for rows at 0-12 (A0), +6.8% at 0-223 (B0), +0.8% at 224-236 (B1).
  A guess, not measured: a run-time row attends over its whole bucket (256 positions) with a
  run-time mask, where a compile-time row attends over exactly its p + 1 positions; the
  position dependence fits it, and E2B spends the largest share in attention. A co-sim or an
  ISA instruction count should confirm it before a fix is written (e.g. attention over the
  blocks up to the run's last row, a run-time block count).

**Later: a looped attention.** A run's program grows with its rows times the blocks its rows
attend over, because attention is unrolled per row, KV head and block. In bucket 16 (blocks
of 256, positions 3840-4095) Phi-4-mini's mix's prompt-run L program is 2597 instructions
at one row, and today's two-row run 4538 (LFM2-2.6B's 5116), against IMEM's 4096; in bucket 1
the same models fit 3 and 4 rows (Phi's mix: 2415 instructions at 3). So past the middle of the cache
both models prefill one row a run, by either route: 3-4x the weight passes of a run of 3-4
rows, for a long prompt or a later chat turn at a long context. Attention as a hardware loop
over the blocks (the loop body one block's scores, softmax update and V product, the block's
K / V address an induction variable) would make the program independent of the context, so
every bucket would take bucket 1's rows. A separate item, not started.

**Gemma 4 E2B** (`gemma4_prompt_run`): gemma4_step's rows over a RunRows, each row a `_RowPos`
(its slot, sliding window and mask pair as a layer run's), the tokens from out[]; each token's
embedding row and PLE record are gathered at addresses from scratch registers (RLD MUL of its
word, `_gathered_out`), the records into the I/O area's rows as compile-time runs store them.
With the PLE table on the host (OTPU_PLE_HOST=1) the run reads the slot's rows, which
prefill.run writes first (Image.prompt_host_rows, Engine._write_host_rows). An image with
lookup tables holds a mask pair per I/O row. MoE images keep the layer-major prefill.
tests/test_prefill_gemma4.py: int8, fp4, the host's PLE table and the sliding ring's wrap at
768, bit-exact against compile-time runs of the same split.

## 8. The device's part: co-sim levers

RTL co-simulation (the board's configuration, LiteDRAM at DDR3-1066, 133.33 MHz), position 544,
the whole model (tools/perf_qwen.py; timing hacks replace instructions with NOPs).

**The DeltaNet rows' VOPs (0.8B), measured: below the bar, not merged.** On the RTL an
elementwise VOP runs at 8 words a cycle plus about one cycle (14 more when it waits for the one
before); EXP2 and RECIP at 2.7 and 4 words a cycle; a small composite (a 1 x 8 RSQRT, a 1 x 16
EXP2) holds the unit 21-27 cycles and its result comes 85-110 cycles later. `_deltanet_rows`'
VPU time is therefore element work that today's ISA has no shorter form for: the convolution
(4 MUL and 3 ADD over a pair's [R, 2C] channels), the SiLUs (5 VOPs, 2 of them composites) and
the norms; there is no multiply-add. What merges with the same words per element (test_qwen35's
bit-exact tests pass): the gates over all R rows at once (one chain of [R, nl] VOPs instead of
R chains, exp2(A_log) once, one store) and the q and k L2 norms' sums side by side (one add and
one RSQRT for both). In the 0.8B's R = 4 program that is 192 fewer VOPs and 21 fewer stores;
prefill at R = 4 goes from 6,820,714 to 6,789,479 cycles (-0.46%), the MTP verify from
5,771,493 to 5,741,573 (-0.52%). Merging the convolution's two channel blocks per tap (a
(tap, block) taps layout) would save about a cycle per VOP.

**Rows a run: R = 3 against R = 2.** PAIR (4-bit weights only) streams the weights ceil(R / 2)
times, so on fp4 R = 3 pays R = 4's MXU time; int8 streams once per pass of up to MCOLS rows.
Cycles a row and layer (the slope from 4 to 8 layers; a mix's layer types measured apart, with
OTPU_FORMATS setting every layer, then weighted by their layers; int8 head, cap 4096, no
logits), and R = 2 against R = 3 in the co-sim and in MXU time (the roofline):

| model | layers | R = 3 | R = 2 | co-sim | MXU time |
|---|---|---|---|---|---|
| Qwen3.5-4B fp4, position 544 | all | 322.3K | 278.0K | -13.8% (card -13.3%) | -25% |
| Phi-4-mini mix mlp@4-27 (the mix before 8625cc2; today's mlp@4-29 weights the same layer types 26 / 6: +9.8%), bucket 1 (position 128) | 24 fp4 MLP | 277.9K | 279.2K | +0.5% | -6.2% |
| | 8 int8 | 291.0K | 431.1K | +48% | +49% |
| | model | 281.2K | 317.2K | +12.8% | +7.7% |
| SmolLM3-3B mix, bucket 16 (position 3968) | 27 fp4 gate/up | 255.1K | 281.2K | +10.2% | +5.8% |
| | 9 int8 | 263.6K | 372.0K | +41% | +43% |
| | model | 257.2K | 303.9K | +18.1% | +15.1% |

The MXU time overstates R - 1's gain by 3-11 points: an R = 2 run reaches ~89% of its MXU
roofline against ~95% at R = 3 (a run's and a layer's work outside the MXU goes over fewer
rows). Hence the probe's margin: R steps down only where the PAIR-aware MXU cost a row is at
least 10% lower. The two mixes keep R = 3, the 4B takes R = 2.

**Later (RTL area: the MCOLS = 4 build is at ~97% of the FPGA's slices).**
- **DSTEP over several rows.** If one DSTEP stepped a head's R rows in one pass over the state at
  no extra cost, the 0.8B's prefill at R = 4 would take -28.6% (6.82 -> 4.87 M cycles, port B
  3.28 -> 2.39 M chunks) and its MTP verify -11.6% (the last row's STREAM into the other slot
  dropped: 5.77 -> 5.10 M). The 2B's DeltaNet waits on its DSTEPs the same way (mm_x blocked
  ~6.7% of its run). But DSTEP is bound by its datapath, 8 state words a cycle (2,048 cycles of
  a 128 x 128 head and ~200 of fill, against 1,024 of port-B chunks; docs/isa.md DSTEP): at 8
  lanes, one pass for R rows saves only the fill, about -2.5% on the 0.8B. The gain needs 16
  lanes.
- **MCOLS = 8:** the 0.8B's prefill at R = 4 -17.2% (1.705 -> 1.413 M cycles a row).

## 9. The additive mask (prompt runs)

A prompt run's row attends over its bucket with its last block masked (attention.Bucket; a
sliding window's first block too, Gemma 4). Masked as min(s, row) such a block takes four
instructions: the MM of q.K^T, an LD of the +inf / -inf row, a VOP MIN by column and a VOP
RMAX (the MXU's row maxima would see the masked scores). Added instead, it takes two: an LD of
the row's mask tile into the score buffer, then the MM accumulating q.K^T into it with the row
maxima (ACC + RMAX: docs/isa.md, the maxima of the values written, after the add).

- **Exact.** The tile holds -0 where a token counts and -inf past it: s + -0 = s for every s
  (-0 included; +0 would turn a -0 score into +0) and s + -inf = -inf = min(s, -inf), so the
  scores, their maxima and everything after are bit for bit today's. RTL co-sim of one masked
  block both ways (tests/test_rtl.py test_additive_mask_block_rtl: 1-4 rows, the row's position
  -1 / 0 / 1 / 77 / 254 / 255 in the block, K blocks 1 and 2): RTL = ISA on the board's
  micro-architecture (AXI, boot) and the default one; the RTL's ACC read-modify-write keeps
  -inf + s = -inf and its RMAX takes the max after the add.
- **No NaN.** A Bucket's row is never fully masked (its own token is in its last block). A
  Gemma 4 sliding window's first block is, at tpos + r = 255 (the window starts at the next
  block's first token), as it is today: the online softmax starts at m = -1e30, so its max
  stays finite and exp2(-inf - m) = +0; no -inf - (-inf).
- **Tables.** LD is one-dimensional (it cannot repeat a row into M tile rows), so the image
  holds the tiles: per position q of an attention block, MCOLS rows of the block's entries and
  a pad word (the score buffer's odd row stride; qwen3.amask_table), -0 for c <= q: 1 MiB at
  256 x MCOLS 4. Gemma 4 adds the window starts' opposite table (1 MiB) and its prompt runs no
  longer compute their mask rows (`_pos_rows`, 9 instructions a row). Only dense images with
  lookup tables (the ones that run prompt runs) hold them; MoE images keep their slots. A row's
  tile is at the table + (tpos + r) x its stride: an argument register, no instruction.
  Decode at a run-time position keeps its mask rows.
- **A partial last bucket.** A capacity that is a multiple of D but not of the block (640, 384)
  ends its last bucket's masked block at the cache's end: cap - t0 tokens, so it reads no K row,
  K or V scale past the cache (it read up to a block past it: the next allocation's bytes, NaN
  logits). The mask row is that many entries; the tile is the first cap - t0 entries of each of
  its rows, loaded row by row (the table's stride is the whole block's). Bit for bit the
  per-position programs' tail block, with the KV regions followed by -NaN words (tests:
  test_qwen3.py and test_prefill.py, *_at_a_partial_last_bucket). Gemma 4 refuses such a
  capacity (gemma4.Image: cap % block).
- **Cycles** (RTL co-sim of E2B's mix, a checkpoint of layers 0-4, 15, 19, 25 and 29 with the
  mix's formats, its PLE table on the host to fit the RTL's 1 GiB DRAM model; the board's
  memory path, LiteDRAM DDR3-1066 at 133.33 MHz; a 208-token prompt in prompt runs of 4 rows,
  runs 0 and 50 on the RTL, RTL = ISA after each): 4,669,594 -> 4,670,456 cycles at position 0,
  4,669,694 -> 4,671,976 at 200 (+0.02% / +0.05%), 2382 -> 2283 instructions; the prompt's
  logits' argmax the same. Neutral: the VOPs it drops were off the critical path, the tile's
  LD (1027 words for 4 rows, against the row's 256) sits before its MM. Its gain is IMEM.
- **DRAM fit** (fit_check, the board configuration, caps 2048 and 4096): every layout keeps its
  fit and its choices; the tightest, E4B int8 at 4096, 4092.2 -> 4094.2 MiB (PLE table on the
  host either way, its formats unchanged), E2B's mix at 4096 4068.5 -> 4070.5 MiB with its int8
  PLE table on the card.

Instructions of the prompt runs' L programs at each bucket's R_max:

| layout | run | before | after |
|---|---|---|---|
| Gemma 4 E2B mix | bucket 2, 4 rows | 4106 | 3975 |
| Gemma 4 E2B int8 | bucket 6 (and 9, 12, 15), 4 rows | 4123 | 3992 |
| LFM2.5-230M | bucket 8 (and 11, 14), 4 rows | 4138 | 4074 |
| Qwen3-0.6B | bucket 1, 8 rows | 1904 | 1776 |
| LFM2-2.6B int8 / mix | bucket 1, 4 rows | 3620 | 3428 |
| Qwen3.5 (0.8B, 2B, 4B) | any | | -16 |

The runs that did not fit IMEM by 10-42 instructions now do: E2B's mix takes 4 rows in bucket
2 (was 3), E2B int8 4 in buckets 6, 9, 12 and 15, LFM2.5-230M 4 in buckets 8, 11 and 14, and
every bucket of the 16 layouts is covered (a prompt there took today's route before). No other
R_max changes (the next size stays over 4096: LFM2-2.6B int8 bucket 2 at 4 rows 4676 -> 4484,
SmolLM3's mix bucket 16 at 4 rows 4311 -> 4247, E2B int8 bucket 16 at 4 rows 4299 -> 4168).

On the card (window3, fmvf 542fc43a, 2026-10-02 16:36-16:54 on the card host's clock; one engine a model, a new
program cache each; prompt runs cold, prompt runs warm, then today's route; the tokens equal in
every phase):

| model | prompt (cap) | buckets | runs | warm | cold | today's route | device cycles |
|---|---|---|---|---|---|---|---|
| Gemma 4 E2B mix | 1500 (2048) | 1-6 | 538 | 72.79 s | 80.13 s | 100.46 s | +4.5% |
| Gemma 4 E2B mix | 300 (2048) | 1-2 | 75 | 10.54 s | 14.50 s | 10.22 s | +6.8% |
| LFM2.5-230M | 1850 (2048) | 0-8 | 368 | 6.81 s | 22.41 s | 122.89 s | +2.5% |
| Qwen3-0.6B | 236 (1024) | 1 | 30 | 2.12 s | 2.12 s | 2.20 s | +4.4% |

E2B's mix at 1500 tokens takes prompt runs end to end (R_max 4 in buckets 1-2, 3 in 3-4, 2 in
5-6): -27.5% against today's route (session mix5: 100.3 s), the device's time at 72.5 s of
it. The device cycles are prompt runs' against compile-time runs, as on main (the co-sim above:
the additive mask +0.02%): a prompt run's masked block is a whole block, a compile-time run's
last block its p + 1 - t0 entries. They bound what a masked block sized to the run can take
back. E2B int8 (bucket 6) was not on the card: its masked blocks are the mix's code (the formats
differ, not the attention path), which ISA and RTL tests cover; it goes in a later window that
builds an int8 E2B image anyway (636 s on the host: the prebuild caches 4-bit matrices only).
No ISA reference of these prompts was run (waived): the card's tokens equal today's route's,
which is ISA-verified on these models.

## 10. Later: looped attention (parked)

Built for tiled prompt runs (2026-10-14): docs/tiled_prefill.md 13 (A as a loop over KV heads
and a part's packed tiles; B not built).

A prompt run unrolls its attention entries (row r, KV head j, column group g), so its program
grows with R x heads x blocks; past the middle of the cache IMEM caps the rows (R_max by bucket:
Phi-4-mini's mix 3 3 3 2 2, then 1; LFM2-2.6B int8 4 3 2 2, then 1; E2B's mix 4 4 3 3, then 2),
and its masked block is a whole block (the card's +2.5 to +6.8% above). Two parts, built
together, both bit-exact against compile-time runs:

- **A. An entry loop.** KV heads outside, rows x column groups inside, so every address is affine
  (the K/V head base in j; the q tile, output row and mask tile in the inner index, G <= MCOLS
  or nh = 1 as on E2B): induction registers (ADDI a stride). The body is one entry (its block
  loop, the remaining blocks, the masked block), software-pipelined by one entry as prime(nxt)
  does today. Loop depth: layers, heads, rows x groups, then the block loop and B's variant
  LOOPs side by side (4, the ISA's limit), so the overlap across entries breaks at a head: one
  drain a KV head a layer. The program is about bucket 1's, so it fits wherever bucket 1 fits
  and TMEM is the limit (LFM2-2.6B's mix at bucket 16 runs out at 4 rows).
- **B. A masked block sized to the run.** Variants of N = 64, 128, 192, 256 tokens, each in a
  LOOP of count 0 or 1 from a per-tpos word, so a run takes the shortest N >= tpos + R; the
  extra tokens score -inf as today (section 9's 2-instruction block, repeated). The tokens
  wasted a row drop from ~128 on average to ~32; 32-token variants (8 bodies) only if the co-sim
  asks for them.

Predicted (compile-time counts; on the card a TTFT change has been 0.55-1.0x the MXU change):
- B: about 75% of the masked-block overhead goes (the ISA, Qwen3-0.6B at R = 4: MM chunks
  +9.6% at p = 0 to +0.03% at 252; the card: E2B's mix +4.5% at 1500 tokens, +6.8% at 300).
- A: every bucket takes bucket 1's rows as far as TMEM allows. MXU cycles a row in bucket 16:
  Phi-4-mini's mix 1 -> 3 rows -46.5%, LFM2-2.6B int8 1 -> 4 -73.5% (its mix 1 -> 2 -48.1%),
  E2B's mix 2 -> 4 -23.3%, E2B int8 3 -> 4 -22.1%, SmolLM3's mix 3 -> 4 -21.5%; Qwen3-0.6B and
  LFM2.5-230M (4 -> 8) ~0% (the replay pass); Phi-4-mini int8 and Qwen3.5 unchanged. A prompt
  or chat turn past ~1-1.3K tokens: Phi-4-mini's mix and LFM2-2.6B about -25 to -70% TTFT, E2B
  and SmolLM3's mix about -12 to -23%.

Gates, in order: an ISA count (one looped program per layout, the 16 and E4B, Qwen3.5's MTP
runs included: its size per bucket against today's, R_max per bucket after); an RTL co-sim of a
Phi-4-mini mix run in bucket 16, 3 rows looped against today's 1 (an E2B mix one if cheap);
then the code (bit-exact against compile-time runs on the ISA, an RTL test of one looped
program) and a card check of TTFT past ~1.3K tokens (Phi-4-mini's mix, LFM2-2.6B int8, E2B's
mix, token-exact). Prompt runs only: decode's attention stays as it is.
