FeSens/openTPU/docs/serve.md

# otpu-serve: an OpenAI-style server on the card

`otpu-serve` serves one model on the card to any number of clients over an OpenAI-compatible
HTTP API. It keeps every user's context, on the card while it runs and in the host's RAM and
on disk after that, and it decodes several users' requests together in one run of the card.
In that it follows SGLang: a prefix cache of contexts (SGLang's RadixAttention), a hierarchy of
memory under it (its HiCache: GPU, host RAM, disk), and continuous batching.

```sh
otpu-serve --model qwen3 --backend board                     # http://127.0.0.1:8000/v1
otpu-serve --model qwen3 --backend board --kv-ram-gb 8 --kv-disk-gb 32 --kv-dir /data/kv
otpu-serve --model lfm2 --backend board --port 8001          # one sequence: requests in turns
```

Any OpenAI client works against it (the `openai` Python package, checked: models, chat plain and
streamed with usage, completions):

```python
from openai import OpenAI
c = OpenAI(base_url="http://127.0.0.1:8000/v1", api_key="none")
r = c.chat.completions.create(model="Qwen3-0.6B", messages=[{"role": "user", "content": "Hi!"}])
```

## The API

| Route | |
|---|---|
| `POST /v1/chat/completions` | the chat template as otpu-chat renders it; `stream` (SSE), `n`, `max_tokens` / `max_completion_tokens`, `temperature`, `top_p`, `top_k`, `repetition_penalty`, `seed`, `stop` (strings), `stop_token_ids`, `ignore_eos`, `stream_options.include_usage`, `chat_template_kwargs.enable_thinking`, `skip_special_tokens`, `tools` and `tool_choice` (below); content as a string or text parts (and `image_url` parts and `max_slices` on a model with a vision side) |
| `POST /v1/completions` | a prompt string or token ids, `echo`, the same sampling and stops |
| `POST /generate` | SGLang's native call: `text` or `input_ids` (one, or a list), `sampling_params` (`max_new_tokens` (default 128), `temperature`, `top_p`, `top_k` (-1: all), `repetition_penalty`, `stop`, `stop_token_ids`, `ignore_eos`, `n`), `stream` (each event the whole text so far); `output_ids` and `meta_info` (prompt, completion and cached tokens, `finish_reason`, `e2e_latency`) |
| `GET /v1/models` | the model, its context length (`max_model_len`) |
| `GET /v1/stats` | the queue, throughput, the slots, the KV store and prefix cache, the steps' timing |
| `GET /health`, `/health_generate` | ok; a streamed MoE's 503 `warming` while its expert pool is read into the page cache (below) |
| `GET /get_model_info`, `/get_server_info` | |
| `POST /flush_cache` | forget every saved context and what idle slots hold |
| `POST /api/fan_gains` | one fan's kp, ki, kd and optionally die target for fan_pid (`{"fan": 1, "kp": 4, "ki": 0.1, "kd": 0, "target_c": 60}`, JSON content type; docs/dashboard.md) |
| `POST /tokenize`, `/detokenize` | vLLM's: a `prompt`'s or the `messages`' tokens as the completion routes render them (`add_generation_prompt`, default true; `chat_template_kwargs`), `count`, `max_model_len`; `tokens` back to text. Nothing runs on the device |

`usage.prompt_tokens_details.cached_tokens` counts the prompt tokens the server did not feed
(the card or the store held them). Sampling defaults are the model's (otpu-chat's: the
checkpoint's generation_config.json, or its family's), and a request's fields override them. A
top-k above 64 (or none) is 64, the most the card's sampler takes. `--reasoning-parser qwen3`
moves a reply's `<think> ... </think>` to `reasoning_content`, also while it streams. `--api-key`
(or `OTPU_API_KEY`) requires `Authorization: Bearer <key>`. Not supported: logprobs,
`suffix`, images on a model without a vision side; `presence_penalty` and `frequency_penalty`
are ignored.

### A request's own sampler

The generate loop's programs are compiled per context bucket and per sampler: greedy, or top-k's
band of 8 (1-8, 9-16, ... 57-64) with or without a repetition penalty. Temperature, top-p, top-k
inside its band and the penalty's value are the programs' arguments: they compile nothing. A warm
covers the server's default sampler and a request's `temperature: 0` (`warm35x2.dense_samplers`);
the startup's line `samplers on disk: ...` and `/api/stats`' `server.warm.samplers` name them. A request
with another band compiles its programs and computes their wait entries on its first use in the
process, for up to 16 buckets ahead as its `max_tokens` reaches, and its first token waits for that;
the same sampler after it does not (saves off: until the process ends; saves on: they stay on disk).

Measured on the two-card LFM2-2.6B server (2026-11-05, 10.7k-token prompt, bucket 42, saves off;
default sampler, warmed: first token 0.58 s):

| request | first token | compiled |
|---|---|---|
| `top_k` 20, `max_tokens` 60 | 10.91 s | 1 bucket, 4 entries |
| `top_k` 12, `max_tokens` 32768 | 169.37 s | 15 buckets, 60 entries |
| the same again | 0.40 s | none |

A bucket compiles slower further along the context (on a build host 4.3 s at 13k tokens, 13.1 s at
100k). A client sending its own `top_k` either stays in a warmed band or
pays this once per server process.

### Tool calls

OpenAI tool calling (`opentpu/serve/tools.py`) on the format the chat template writes (an agent
such as opencode drives everything through it): the qwen3_coder format of Qwen3.5's and
Qwen3.6's templates, the one vLLM's `qwen3_coder` parser reads, as below, or LFM2's (where the
template holds `<|tool_call_start|>`; "LFM2's calls" after this list):

- **The request.** `tools` (OpenAI's `{type: function, function: {name, description,
  parameters}}`) go to the chat template as given: its `<tools>` block is each one's
  `tojson`, as vLLM and transformers render them. `tool_choice` `"none"` renders no tools and
  parses nothing; `"auto"`, `"required"` and a named function are all auto: the model chooses,
  nothing forces a call. `parallel_tool_calls` is ignored (every call is returned). An
  assistant message takes `tool_calls` with `content` null or `""` (each
  `function.arguments` a JSON object's string, or the object); a `tool` message's content is a
  string or text parts (the template puts consecutive results in one user turn).
- **The reply.** `<tool_call>\n<function=NAME>\n<parameter=P>\nVALUE\n</parameter>
  ...</function>\n</tool_call>`, once or more: `message.tool_calls`
  (`[{id: "call_<hex>", type: "function", function: {name, arguments: a JSON string}}]`), the
  text before the first call `content` (null without), `finish_reason` `"tool_calls"`. A
  value takes its parameter's JSON-schema type: a string as is (the format's newline either
  side dropped, those inside kept), integer, number, boolean, object and array by
  `json.loads`, the text when it does not parse (or the schema does not name the parameter).
  A `<tool_call>` without a `<function=...>` stays content; a reply cut inside a call returns
  what it has.
- **Streamed.** Content deltas as they come, less a possible partial `<tool_call>` and the
  whitespace before a call; a call is held until its `</tool_call>`, then one delta
  `{tool_calls: [{index, id, type, function: {name, arguments}}]}` carries it whole; the last
  chunk's `finish_reason` is `"tool_calls"`, then the usage (`include_usage`) and `[DONE]`.
- **The next turn reuses the context.** The agent's next request re-renders each call from
  its arguments (the parameters in their order, a string as is, the rest `tojson`): the text
  the model wrote, so the prompt continues the context the card or the store holds, and only
  the tool results are fed. The exception is a non-string value written otherwise than
  `json.dumps` writes it (`{"a":1}` for `{"a": 1}`): the prompt parts from the context there.
  On a laptop (a scripted worker, Qwen3.6's tokenizer), opencode 2.2.5's first request
  rendered 10,996 tokens (13 tools' schemas, then its system prompt); after the read tool ran,
  its next request's 11,112 tokens began with all 11,053 of the first's prompt, reply and
  `<|im_end|>`.
- **The thinking kept** (`--preserve-thinking`, otpu-serve35's default; `--no-preserve-thinking`
  turns it off; a request's `chat_template_kwargs` `preserve_thinking` sets it for that
  request). By default Qwen3.6's template writes an assistant turn's think block only for the
  turns after the last user query. So the user's next message re-renders every turn since the
  previous one without its block: with thinking off, without the empty `<think>\n\n</think>\n\n`
  the generation prompt opened. The prompt then parts from the context at the first of those
  turns, and every tool step since the previous message is fed again. With the template's
  `preserve_thinking` every assistant turn keeps its block, as the model wrote it (its
  `reasoning_content`, when the client sends it back, goes to the template). Each request's
  prompt is then the last prompt, its reply and `<|im_end|>`, followed only by what is new: the
  tool's result, or the user's next message. Only a template with the switch gets it (the
  server checks the template's text). `test_serve_tools`: an opencode-shaped session of three
  requests, in characters and in Qwen3.6's tokens.

LFM2's calls are one block of Python-like calls, `<|tool_call_start|>[read(filePath='a.py',
limit=20), bash(command='ls')]<|tool_call_end|>`, read with Python's parser and its literals alone
(nothing evaluated; `true`, `false` and `null` too), positional values by the schema's order. The
model also writes what Python does not read: the checkpoint's own reply to a request for two
calls is `[bash(command=ls -la /tmp), read(filePath=/work/a.txt)]`. So a block that does not parse
is read loosely for the request's tools only, each value up to the next argument or the call's
end, by its parameter's type; the JSON form `{"name", "arguments"}` (or a list of them) is taken
too. A block that is none of these, or is cut short, stays content. The template renders a call
back with single quotes, so a call the model wrote that way continues the context exactly, and
one it wrote otherwise parts from it at the call: its tokens are fed again. The whitespace before
a block stays in `content`, since this template writes none of its own there.

**Which models call tools well.** The parser is not the limit; the model is. A screen on
opencode 2.2.5's own requests (2026-11-06): 8 prompts in a one-file project (what a file prints,
read it, list the files, add a line, run it, find the Python files, search for TODO, create a
file), on opencode's default config (12 tools, a 10.5k-token prompt) and a small one (10 tools,
2.9k), the first call and the turn after a tool that opencode really ran. Each model's own chat
template, thinking off, greedy, fp32 from the reference implementation. *Valid*: every call names
a listed tool with its required arguments. *Right*: the first call does what was asked. *Next
turn*: the answer reports the tool's result, with no invented file or output.

| model | config | valid of 8 | right of 8 | next turn right of 8 | |
|---|---|---|---|---|---|
| Qwen3.6-35B-A3B | default | 8 | 8 | 8 | |
| | small | 8 | 7 | 8 | |
| Qwen3.5-4B | default | 8 | 6 | 7 | Run goes to `execute` instead of `shell` |
| | small | 8 | 8 | 7 | |
| Qwen3.5-2B | default | 7 | 6 | 7 | |
| | small | 8 | 7 | 7 | |
| gemma-4-E4B-it | default | 8 | 7 | 4 | after `glob` and `write` its reply is empty |
| | small | 7 | 7 | 5 | |
| LFM2.5-8B-A1B | default | 8 | 4 | 4 | repeats the call it just ran |
| | small | 7 | 6 | 4 | one made-up output |
| LFM2-2.6B | default | 3 | 2 | 4 | tools and arguments not in the list; `edit` on requests to read |
| | small | 7 | 2 | 4 | invents files and results |
| SmolLM3-3B | default / small | 2 / 4 | 2 / 4 | | mostly no call |
| Phi-4-mini | default / small | 1 / 7 | 1 / 7 | | most default calls invalid; the small config's 7 counts bare and fenced JSON, which the server does not parse |

By valid >= 7, right >= 6 and next turn >= 6 on both configs with no unrequested edit or write (a
rule set after seeing the numbers), the 35B, Qwen3.5-4B and Qwen3.5-2B pass; all three write the
qwen3_coder format. Eight prompts and one path each: 1 of 8 means nothing, and those three are not
ranked by this.
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
