FeSens/openTPU/docs/timing_ffs.md

# Timing: the wire, and what flip-flops buy

The question (2026-10-16): the card's clock is limited by route delay, not by logic, so can added
flip-flops fix it, and what else in the flow can improve? This is the exploration's record: where
the delay is (the FPGA card, the ASIC card), what the tools do alone, three batches of
cycle-exact register copies (branch `worktree-timing-ffs`), FPGA builds at 133.33 MHz and at a
150 MHz equivalent, the ASIC flow's timing repair, (the follow-up question: reduce the
fanout) a census of what the card's nets fan out to and the batches that cut it, and (the third:
cut the MXU from TMEM, within 1% of the cycles) the MXU's TMEM interface, and (the fourth:
a real 150 MHz with comfortable margins, for production) the 150 MHz builds and what the
card's DRAM made of them.
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
