FeSens/openTPU/tools/tourney/runs/otpu_coll/LESSONS.md

# Lessons: otpu_coll

- [r20260923-195339-s0] otpu_coll GATHER: running-sum address registers replaced the ps*seg/pr*drs/r*w4 DSP multiply chains, and registered masks/last flag helped too. Accepted: 75→128 MHz, area -28%. Try strength reduction before pipelining.
