FeSens/openTPU/tools/tourney/runs/otpu_vpu/LESSONS.md

# Lessons: otpu_vpu

- [r20260924-011716-s0] RMAX stage 2 with pre-keyed FFs and all 6 compares run in parallel: only +1.3% fmax, -0.5% area. Flattening the serial compare chain barely helps, so the critical path is likely elsewhere (routing/fanout).
- [r20260924-011716-s1] Accepted (area -6.1%, fmax 107→108 MHz): otpu_delay's keep attribute blocks dead-bit removal, so carry only live fields per slot (tap meta 50/103 b; no u_st/u_dst in simple lanes); fmax still below target.
- [r20260924-014914-s0] Registering RSUM/RSSQ tree pb row/lane selects at issue time (is_ra/is_rb/is_big/is_nl, which drops the ia/ib adders) gave only +1.5% fmax at +0.5% area, so address carry isn't the real limit; the pb mux and fp_add_s1 are.
- [r20260924-014914-s1] NTB 4→2 fold buffers (4096 FFs) plus registering tree read rows at issue: -11.2% area, broke the 5.48 ns tree-read wall and reached 112 MHz; perf cost is only about 0.04% (≈23-cycle capture spacing)
- [r20260924-020218-s0] Broken by the sandbox: otpu_vpu must not refer to otpu_fp internals (fp_mul_s1). Retry the RSUM/RSSQ squarer idea: move ftz/mask/select off the DSP A/B pins using only otpu_fmul/fadd/fmadd ports.
- [r20260924-020218-s1] RSUM/RSSQ loop on the lanes' slot-0 fmadd (drop u_sq/u_acc/u_fb): area -11.7%, but fmax fell 112→110, so no_gain. Worth retrying if the fmadd's prev/ic_ mux leg gets pipelined.
- [r20260924-021147-s0] r20260924 u_sq FF-significand idea broken by the sandbox check, not by the RTL: the name `fp_mul_s1` in otpu_vpu.sv, even in a comment, trips the internals check. Retry without naming otpu_fp stages.
- [r20260924-021147-s1] Moving the RSUM/RSSQ squares onto the slot-0 lane multipliers (removing the 8 u_sq) cut area 3.1% but dropped fmax to 105 (-6.3%). The path pressure moved to the lane DSPs; don't retry without registering the mux.
- [r20260924-022033-s0] Registering the RSUM/RSSQ squarer operands (xin/F_ONE select) before the DSP cascade dropped fmax 112→106 (+0.5% area); the PCIN path isn't LUT-limited, so leave u_sq's inputs alone.
- [r20260924-022033-s1] RSUM/RSSQ fold buffers `pb` moved to LUT-RAM (RAM32M, one write port per buffer and lane): area −15.1%, but fmax fell 112→107 (misses 110) because the RAM read sits in the issue cycle. Keep `pb` in FFs, or register the RAM output.
- [r20260924-023208-s0] Feeding the RSUM/RSSQ squarer's significand bits raw from xa, with flush/mask on sign+exp only and an `sq` FF bit, gave fmax -1.5% and area -0.4%. Removing the 3 LUTs before the DSP didn't help.
- [r20260924-023208-s1] pb in LUT-RAM with registered tree operands still hit only 108 MHz (area -15.6%). A new RAM path, maybe `is_*` -> RAM -> `oa_q`/`ob_q`, becomes critical. Check the timing report before retrying.
- [r20260924-025450-s0] Registering the pb operands before the RSUM/RSSQ tree fadd (LT=LA+1) adds a cycle to every fold level, so attention_decode drops to 59.6% (<0.60 floor). Tree latency is perf-critical; cut timing elsewhere.
- [r20260924-025450-s1] NTB=4→2 (re-applying 52bfd3f) failed the new kernel perf gate: attention_decode fell to 55.7% of roofline (<60%) with VPU 96% busy. Fewer fold buffers serialize RSUM/RSSQ, so keep NTB=4.
- [r20260924-025910-s0] Registering fold-tree pb operands with a tb_w countdown instead of tb_inf made things worse: 104 MHz (champion 108), area +0.7%. The countdown/compare logic probably cost more than the mux path saved.
- [r20260924-025910-s1] vpu tree pb-mux pruning by invariants (oa rows<4, ob OR-for-add, const lanes for n<LANES) grew area +2.6%, fmax only +2.9%: synth already trims or extra select logic costs more; skip.
- [r20260924-030642-s0] Fold-tree operand mux moved into the select cycle (per-buffer candidates + one-hot AND-OR, same latency): +2.4% fmax, +9.1% area. Replicating the mux across 4 buffers costs too much, don't retry.
- [r20260924-030642-s1] Registering the fold-tree pb operands (LT=LA+1) and hiding the extra cycle by advancing the level at its last issue and pushing the root from the adder gave +2.4% fmax at +0.6% area, so no gain; the pb-mux/fadd path needs a deeper split.
- [r20260924-031822-s0] Fold-tree write-back staging of cross-lane ob into row 1 (4×8 ob / 4×4 oa mux from FFs, no adders) gave only +2.4% fmax, −0.7% area; the operand mux alone isn't enough, so pair it with an adder-side cut.
- [r20260924-031822-s1] fold-tree pb row pruning (tree writes only rows < RL/2, adder-free ia/ib) saved 5% area but fmax fell to 105 (-3%); area-only wins need fmax held ≥ champion, so pair it with a timing fix
- [r20260924-032708-s0] Win (112 MHz, area -1.4%): the long lanes' result mux ran every tap into the EXP2 adder, a false path. Fixed taps per composite + a fix to the fold-tree read path; both needed together.
- [r20260924-032708-s1] RSUM/RSSQ streaming fold tree (delay lines + fixed mod-RL slot schedule, no stall) replacing the 8192-FF pb buffers: area -20.8%, fmax only +1.2% (109 MHz). The area win is real, but the critical path is elsewhere.
- [r20260924-034325-s0] Replacing the SRL last stage of u_fb/u_pd/fmadd-c with real FFs (sync-clear prev) gave only +1.1% fmax at +1.0% area; SRL clk->Q wasn't the limiter, fp_add_s1 LUT/carry depth is.
- [r20260924-034325-s1] Accepted: level-2 lane fadds share the level-1 adders (level 2 fires at offset LA mod RL, when level 1 is idle; bit-exact, no added latency). Area -1.9%, but 110 MHz is only +0.6%.
- [r20260924-040202-s0] Fixed end taps (per-tap ends_at strobes replacing the 11-way st[wtap] mux) plus a pre-muxed B operand gave only +1.8% fmax and -0.4% area, so it was no gain. Removing the false fp_max->EXP2 path isn't enough by itself.
- [r20260924-040202-s1] Fixed end taps (EXP2@9/RECIP@6/RSQRT@10 instead of the 11-way st[wtap] mux) on the streaming-tree champion only gave fmax +1.8% and area -0.6%, so no gain. The old 112 MHz win came from the fold-tree path that is now gone.
- [r20260924-041000-s0] Fixed end taps and a LUT-free squarer operand (raw significand + `sq` bit) only helped together: 110→120 MHz, area -1.2%. Each alone failed because the other path stayed critical right behind it.
- [r20260924-041000-s1] RSUM/RSSQ on the slot-0 fmadd with a registered rprev and the squarer operands through the ia/ib mux into ra/rb gave -12.9% area, but fmax fell to 106. Merging g_red into the lane fmadd costs fmax even when pipelined.
- [r20260924-042251-s0] Sync reset on lane `rc` (to F_NZ) stopped shregmap from merging it with fmadd u_c's delay into an SRL16E (1.47ns clk→Q), so c now leaves an FDRE: +7.9% fmax. Check chains ≥3 for SRLs.
- [r20260924-042251-s1] Narrowing TMEM word addresses from 32 to AW=20 bits (regs, adders, and waddr in the keep-FF meta delay lines) gave area -1.1% at 120 MHz; the OOC build keeps dead upper bits, so trim them in RTL.
- [r20260924-043342-s0] Registering u_sq's B significand (xsm) instead of the sq&xa LUT2, plus narrowing the TMEM address to AW=20, gave 131 MHz and -1.3% area. About 4394 ps (FF→DSP→PCIN) is now the floor inside otpu_vpu.
- [r20260924-043342-s1] ACCEPTED area −13.1% @131MHz: RSUM/RSSQ reuse slot-0 fmadd (drop u_sq/u_acc, −16 DSP). Earlier tries only failed fmax because the SRL16E `c` fed it; with FDRE `rc` (r042251) sharing is free.
- [r20260924-044504-s0] Registering the fold-tree `oa` operand (built from pdd/tt[da-1]/lvn one granted cycle early, td cut to DMAX-1) plus 20-bit TMEM addresses stayed bit-exact: area -1.2%, 133 MHz; the DSP floor limits timing to ~+1.7%.
- [r20260924-044504-s1] otpu_vpu: time-multiplexing the 5 lane-level fadds onto 2 (L1 split across E/E+1 via existing td[1] taps, adder residues 5/6/2/7 kept distinct mod RL=8) cut area 4.1%, still at 131 MHz.
- [r20260924-045712-s0] Fold-tree operand muxes (level-2 moved to free residue 0, ≤1 mux after adder out) + AW=20 TMEM + narrow tap meta: accepted on area -1.8% @133MHz; timing alone is capped near the fmadd DSP floor.
- [r20260924-045712-s1] otpu_vpu: running the 7 RSUM/RSSQ lane adds on the u_tree adders' free residue-0 slots (L1/L2/L3 on disjoint adders 0-3/4-5/6) dropped both u_ln fadds: -2.0% area at 129 MHz.
