FeSens/openTPU/boards/ypcb-00338/litedram/otpu_litedram.xdc

################################################################################
# IO constraints
################################################################################
# ddram:0.a
set_property LOC AK27 [get_ports {ddram0_a[0]}]
set_property SLEW FAST [get_ports {ddram0_a[0]}]
set_property IOSTANDARD SSTL15 [get_ports {ddram0_a[0]}]

# ddram:0.a
set_property LOC AN23 [get_ports {ddram0_a[1]}]
set_property SLEW FAST [get_ports {ddram0_a[1]}]
set_property IOSTANDARD SSTL15 [get_ports {ddram0_a[1]}]

# ddram:0.a
set_property LOC AL24 [get_ports {ddram0_a[2]}]
set_property SLEW FAST [get_ports {ddram0_a[2]}]
set_property IOSTANDARD SSTL15 [get_ports {ddram0_a[2]}]

# ddram:0.a
set_property LOC AK26 [get_ports {ddram0_a[3]}]
set_property SLEW FAST [get_ports {ddram0_a[3]}]
set_property IOSTANDARD SSTL15 [get_ports {ddram0_a[3]}]

# ddram:0.a
set_property LOC AH24 [get_ports {ddram0_a[4]}]
set_property SLEW FAST [get_ports {ddram0_a[4]}]
set_property IOSTANDARD SSTL15 [get_ports {ddram0_a[4]}]

# ddram:0.a
set_property LOC AH25 [get_ports {ddram0_a[5]}]
set_property SLEW FAST [get_ports {ddram0_a[5]}]
set_property IOSTANDARD SSTL15 [get_ports {ddram0_a[5]}]

# ddram:0.a
set_property LOC AL26 [get_ports {ddram0_a[6]}]
set_property SLEW FAST [get_ports {ddram0_a[6]}]
set_property IOSTANDARD SSTL15 [get_ports {ddram0_a[6]}]

# ddram:0.a
set_property LOC AJ24 [get_ports {ddram0_a[7]}]
set_property SLEW FAST [get_ports {ddram0_a[7]}]
set_property IOSTANDARD SSTL15 [get_ports {ddram0_a[7]}]

# ddram:0.a
set_property LOC AJ25 [get_ports {ddram0_a[8]}]
set_property SLEW FAST [get_ports {ddram0_a[8]}]
set_property IOSTANDARD SSTL15 [get_ports {ddram0_a[8]}]

# ddram:0.a
set_property LOC AM23 [get_ports {ddram0_a[9]}]
set_property SLEW FAST [get_ports {ddram0_a[9]}]
set_property IOSTANDARD SSTL15 [get_ports {ddram0_a[9]}]

# ddram:0.a
set_property LOC AL28 [get_ports {ddram0_a[10]}]
set_property SLEW FAST [get_ports {ddram0_a[10]}]
set_property IOSTANDARD SSTL15 [get_ports {ddram0_a[10]}]

# ddram:0.a
set_property LOC AL25 [get_ports {ddram0_a[11]}]
set_property SLEW FAST [get_ports {ddram0_a[11]}]
set_property IOSTANDARD SSTL15 [get_ports {ddram0_a[11]}]

# ddram:0.a
set_property LOC AM25 [get_ports {ddram0_a[12]}]
set_property SLEW FAST [get_ports {ddram0_a[12]}]
set_property IOSTANDARD SSTL15 [get_ports {ddram0_a[12]}]

# ddram:0.a
set_property LOC AK24 [get_ports {ddram0_a[13]}]
set_property SLEW FAST [get_ports {ddram0_a[13]}]
set_property IOSTANDARD SSTL15 [get_ports {ddram0_a[13]}]

# ddram:0.a
set_property LOC AM27 [get_ports {ddram0_a[14]}]
set_property SLEW FAST [get_ports {ddram0_a[14]}]
set_property IOSTANDARD SSTL15 [get_ports {ddram0_a[14]}]

# ddram:0.ba
set_property LOC AM26 [get_ports {ddram0_ba[0]}]
set_property SLEW FAST [get_ports {ddram0_ba[0]}]
set_property IOSTANDARD SSTL15 [get_ports {ddram0_ba[0]}]

# ddram:0.ba
set_property LOC AP24 [get_ports {ddram0_ba[1]}]
set_property SLEW FAST [get_ports {ddram0_ba[1]}]
set_property IOSTANDARD SSTL15 [get_ports {ddram0_ba[1]}]

# ddram:0.ba
set_property LOC AN28 [get_ports {ddram0_ba[2]}]
set_property SLEW FAST [get_ports {ddram0_ba[2]}]
set_property IOSTANDARD SSTL15 [get_ports {ddram0_ba[2]}]

# ddram:0.ras_n
set_property LOC AJ29 [get_ports {ddram0_ras_n}]
set_property SLEW FAST [get_ports {ddram0_ras_n}]
set_property IOSTANDARD SSTL15 [get_ports {ddram0_ras_n}]

# ddram:0.cas_n
set_property LOC AP26 [get_ports {ddram0_cas_n}]
set_property SLEW FAST [get_ports {ddram0_cas_n}]
set_property IOSTANDARD SSTL15 [get_ports {ddram0_cas_n}]

# ddram:0.we_n
set_property LOC AN27 [get_ports {ddram0_we_n}]
set_property SLEW FAST [get_ports {ddram0_we_n}]
set_property IOSTANDARD SSTL15 [get_ports {ddram0_we_n}]

# ddram:0.cs_n
set_property LOC AK28 [get_ports {ddram0_cs_n}]
set_property SLEW FAST [get_ports {ddram0_cs_n}]
set_property IOSTANDARD SSTL15 [get_ports {ddram0_cs_n}]

# ddram:0.cke
set_property LOC AP27 [get_ports {ddram0_cke}]
set_property SLEW FAST [get_ports {ddram0_cke}]
set_property IOSTANDARD SSTL15 [get_ports {ddram0_cke}]

# ddram:0.odt
set_property LOC AK29 [get_ports {ddram0_odt}]
set_property SLEW FAST [get_ports {ddram0_odt}]
set_property IOSTANDARD SSTL15 [get_ports {ddram0_odt}]

# ddram:0.reset_n
set_property LOC AD31 [get_ports {ddram0_reset_n}]
set_property SLEW FAST [get_ports {ddram0_reset_n}]
set_property IOSTANDARD SSTL15 [get_ports {ddram0_reset_n}]

# ddram:0.dq
set_property LOC AG17 [get_ports {ddram0_dq[0]}]
set_property SLEW FAST [get_ports {ddram0_dq[0]}]
set_property IOSTANDARD SSTL15 [get_ports {ddram0_dq[0]}]
set_property IN_TERM UNTUNED_SPLIT_40 [get_ports {ddram0_dq[0]}]

# ddram:0.dq
set_property LOC AG16 [get_ports {ddram0_dq[1]}]
set_property SLEW FAST [get_ports {ddram0_dq[1]}]
set_property IOSTANDARD SSTL15 [get_ports {ddram0_dq[1]}]
set_property IN_TERM UNTUNED_SPLIT_40 [get_ports {ddram0_dq[1]}]

# ddram:0.dq
set_property LOC AH17 [get_ports {ddram0_dq[2]}]
set_property SLEW FAST [get_ports {ddram0_dq[2]}]
set_property IOSTANDARD SSTL15 [get_ports {ddram0_dq[2]}]
set_property IN_TERM UNTUNED_SPLIT_40 [get_ports {ddram0_dq[2]}]

# ddram:0.dq
set_property LOC AJ19 [get_ports {ddram0_dq[3]}]
set_property SLEW FAST [get_ports {ddram0_dq[3]}]
set_property IOSTANDARD SSTL15 [get_ports {ddram0_dq[3]}]
set_property IN_TERM UNTUNED_SPLIT_40 [get_ports {ddram0_dq[3]}]

# ddram:0.dq
set_property LOC AH18 [get_ports {ddram0_dq[4]}]
set_property SLEW FAST [get_ports {ddram0_dq[4]}]
set_property IOSTANDARD SSTL15 [get_ports {ddram0_dq[4]}]
set_property IN_TERM UNTUNED_SPLIT_40 [get_ports {ddram0_dq[4]}]

# ddram:0.dq
set_property LOC AH19 [get_ports {ddram0_dq[5]}]
set_property SLEW FAST [get_ports {ddram0_dq[5]}]
set_property IOSTANDARD SSTL15 [get_ports {ddram0_dq[5]}]
set_property IN_TERM UNTUNED_SPLIT_40 [get_ports {ddram0_dq[5]}]

# ddram:0.dq
set_property LOC AJ16 [get_ports {ddram0_dq[6]}]
set_property SLEW FAST [get_ports {ddram0_dq[6]}]
set_property IOSTANDARD SSTL15 [get_ports {ddram0_dq[6]}]
set_property IN_TERM UNTUNED_SPLIT_40 [get_ports {ddram0_dq[6]}]

# ddram:0.dq
set_property LOC AJ17 [get_ports {ddram0_dq[7]}]
set_property SLEW FAST [get_ports {ddram0_dq[7]}]
set_property IOSTANDARD SSTL15 [get_ports {ddram0_dq[7]}]
set_property IN_TERM UNTUNED_SPLIT_40 [get_ports {ddram0_dq[7]}]

# ddram:0.dq
set_property LOC AL20 [get_ports {ddram0_dq[8]}]
set_property SLEW FAST [get_ports {ddram0_dq[8]}]
set_property IOSTANDARD SSTL15 [get_ports {ddram0_dq[8]}]
set_property IN_TERM UNTUNED_SPLIT_40 [get_ports {ddram0_dq[8]}]

# ddram:0.dq
set_property LOC AN17 [get_ports {ddram0_dq[9]}]
set_property SLEW FAST [get_ports {ddram0_dq[9]}]
set_property IOSTANDARD SSTL15 [get_ports {ddram0_dq[9]}]
set_property IN_TERM UNTUNED_SPLIT_40 [get_ports {ddram0_dq[9]}]

# ddram:0.dq
set_property LOC AL19 [get_ports {ddram0_dq[10]}]
set_property SLEW FAST [get_ports {ddram0_dq[10]}]
set_property IOSTANDARD SSTL15 [get_ports {ddram0_dq[10]}]
set_property IN_TERM UNTUNED_SPLIT_40 [get_ports {ddram0_dq[10]}]

# ddram:0.dq
set_property LOC AM16 [get_ports {ddram0_dq[11]}]
set_property SLEW FAST [get_ports {ddram0_dq[11]}]
set_property IOSTANDARD SSTL15 [get_ports {ddram0_dq[11]}]
set_property IN_TERM UNTUNED_SPLIT_40 [get_ports {ddram0_dq[11]}]

# ddram:0.dq
set_property LOC AL18 [get_ports {ddram0_dq[12]}]
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

# ddram:0.dqs_p
set_property LOC AG33 [get_ports {ddram0_dqs_p[5]}]
set_property SLEW FAST [get_ports {ddram0_dqs_p[5]}]
set_property IOSTANDARD DIFF_SSTL15 [get_ports {ddram0_dqs_p[5]}]
set_property IN_TERM UNTUNED_SPLIT_40 [get_ports {ddram0_dqs_p[5]}]

# ddram:0.dqs_p
set_property LOC AE34 [get_ports {ddram0_dqs_p[6]}]
set_property SLEW FAST [get_ports {ddram0_dqs_p[6]}]
set_property IOSTANDARD DIFF_SSTL15 [get_ports {ddram0_dqs_p[6]}]
set_property IN_TERM UNTUNED_SPLIT_40 [get_ports {ddram0_dqs_p[6]}]

# ddram:0.dqs_p
set_property LOC AE27 [get_ports {ddram0_dqs_p[7]}]
set_property SLEW FAST [get_ports {ddram0_dqs_p[7]}]
set_property IOSTANDARD DIFF_SSTL15 [get_ports {ddram0_dqs_p[7]}]
set_property IN_TERM UNTUNED_SPLIT_40 [get_ports {ddram0_dqs_p[7]}]

# ddram:0.dqs_p
set_property LOC AN32 [get_ports {ddram0_dqs_p[8]}]
set_property SLEW FAST [get_ports {ddram0_dqs_p[8]}]
set_property IOSTANDARD DIFF_SSTL15 [get_ports {ddram0_dqs_p[8]}]
set_property IN_TERM UNTUNED_SPLIT_40 [get_ports {ddram0_dqs_p[8]}]

# ddram:0.dqs_n
set_property LOC AK17 [get_ports {ddram0_dqs_n[0]}]
set_property SLEW FAST [get_ports {ddram0_dqs_n[0]}]
set_property IOSTANDARD DIFF_SSTL15 [get_ports {ddram0_dqs_n[0]}]
set_property IN_TERM UNTUNED_SPLIT_40 [get_ports {ddram0_dqs_n[0]}]

# ddram:0.dqs_n
set_property LOC AM18 [get_ports {ddram0_dqs_n[1]}]
set_property SLEW FAST [get_ports {ddram0_dqs_n[1]}]
set_property IOSTANDARD DIFF_SSTL15 [get_ports {ddram0_dqs_n[1]}]
set_property IN_TERM UNTUNED_SPLIT_40 [get_ports {ddram0_dqs_n[1]}]

# ddram:0.dqs_n
set_property LOC AP22 [get_ports {ddram0_dqs_n[2]}]
set_property SLEW FAST [get_ports {ddram0_dqs_n[2]}]
set_property IOSTANDARD DIFF_SSTL15 [get_ports {ddram0_dqs_n[2]}]
set_property IN_TERM UNTUNED_SPLIT_40 [get_ports {ddram0_dqs_n[2]}]

# ddram:0.dqs_n
set_property LOC AJ20 [get_ports {ddram0_dqs_n[3]}]
set_property SLEW FAST [get_ports {ddram0_dqs_n[3]}]
set_property IOSTANDARD DIFF_SSTL15 [get_ports {ddram0_dqs_n[3]}]
set_property IN_TERM UNTUNED_SPLIT_40 [get_ports {ddram0_dqs_n[3]}]

# ddram:0.dqs_n
set_property LOC AL33 [get_ports {ddram0_dqs_n[4]}]
set_property SLEW FAST [get_ports {ddram0_dqs_n[4]}]
set_property IOSTANDARD DIFF_SSTL15 [get_ports {ddram0_dqs_n[4]}]
set_property IN_TERM UNTUNED_SPLIT_40 [get_ports {ddram0_dqs_n[4]}]

# ddram:0.dqs_n
set_property LOC AH33 [get_ports {ddram0_dqs_n[5]}]
set_property SLEW FAST [get_ports {ddram0_dqs_n[5]}]
set_property IOSTANDARD DIFF_SSTL15 [get_ports {ddram0_dqs_n[5]}]
set_property IN_TERM UNTUNED_SPLIT_40 [get_ports {ddram0_dqs_n[5]}]

# ddram:0.dqs_n
set_property LOC AF34 [get_ports {ddram0_dqs_n[6]}]
set_property SLEW FAST [get_ports {ddram0_dqs_n[6]}]
set_property IOSTANDARD DIFF_SSTL15 [get_ports {ddram0_dqs_n[6]}]
set_property IN_TERM UNTUNED_SPLIT_40 [get_ports {ddram0_dqs_n[6]}]

# ddram:0.dqs_n
set_property LOC AE28 [get_ports {ddram0_dqs_n[7]}]
set_property SLEW FAST [get_ports {ddram0_dqs_n[7]}]
set_property IOSTANDARD DIFF_SSTL15 [get_ports {ddram0_dqs_n[7]}]
set_property IN_TERM UNTUNED_SPLIT_40 [get_ports {ddram0_dqs_n[7]}]

# ddram:0.dqs_n
set_property LOC AP33 [get_ports {ddram0_dqs_n[8]}]
set_property SLEW FAST [get_ports {ddram0_dqs_n[8]}]
set_property IOSTANDARD DIFF_SSTL15 [get_ports {ddram0_dqs_n[8]}]
set_property IN_TERM UNTUNED_SPLIT_40 [get_ports {ddram0_dqs_n[8]}]

# ddram:0.clk_p
set_property LOC AN25 [get_ports {ddram0_clk_p}]
set_property SLEW FAST [get_ports {ddram0_clk_p}]
set_property IOSTANDARD DIFF_SSTL15 [get_ports {ddram0_clk_p}]

# ddram:0.clk_n
set_property LOC AP25 [get_ports {ddram0_clk_n}]
set_property SLEW FAST [get_ports {ddram0_clk_n}]
set_property IOSTANDARD DIFF_SSTL15 [get_ports {ddram0_clk_n}]

# ddram:1.a
set_property LOC E27 [get_ports {ddram1_a[0]}]
set_property SLEW FAST [get_ports {ddram1_a[0]}]
set_property IOSTANDARD SSTL15 [get_ports {ddram1_a[0]}]

# ddram:1.a
set_property LOC C27 [get_ports {ddram1_a[1]}]
set_property SLEW FAST [get_ports {ddram1_a[1]}]
set_property IOSTANDARD SSTL15 [get_ports {ddram1_a[1]}]

# ddram:1.a
set_property LOC B28 [get_ports {ddram1_a[2]}]
set_property SLEW FAST [get_ports {ddram1_a[2]}]
set_property IOSTANDARD SSTL15 [get_ports {ddram1_a[2]}]

# ddram:1.a
set_property LOC D27 [get_ports {ddram1_a[3]}]
set_property SLEW FAST [get_ports {ddram1_a[3]}]
set_property IOSTANDARD SSTL15 [get_ports {ddram1_a[3]}]

# ddram:1.a
set_property LOC C24 [get_ports {ddram1_a[4]}]
set_property SLEW FAST [get_ports {ddram1_a[4]}]
set_property IOSTANDARD SSTL15 [get_ports {ddram1_a[4]}]

# ddram:1.a
set_property LOC D24 [get_ports {ddram1_a[5]}]
set_property SLEW FAST [get_ports {ddram1_a[5]}]
set_property IOSTANDARD SSTL15 [get_ports {ddram1_a[5]}]

# ddram:1.a
set_property LOC C25 [get_ports {ddram1_a[6]}]
set_property SLEW FAST [get_ports {ddram1_a[6]}]
set_property IOSTANDARD SSTL15 [get_ports {ddram1_a[6]}]

# ddram:1.a
set_property LOC A24 [get_ports {ddram1_a[7]}]
set_property SLEW FAST [get_ports {ddram1_a[7]}]
set_property IOSTANDARD SSTL15 [get_ports {ddram1_a[7]}]

# ddram:1.a
set_property LOC A25 [get_ports {ddram1_a[8]}]
set_property SLEW FAST [get_ports {ddram1_a[8]}]
set_property IOSTANDARD SSTL15 [get_ports {ddram1_a[8]}]

# ddram:1.a
set_property LOC J24 [get_ports {ddram1_a[9]}]
set_property SLEW FAST [get_ports {ddram1_a[9]}]
set_property IOSTANDARD SSTL15 [get_ports {ddram1_a[9]}]

# ddram:1.a
set_property LOC F26 [get_ports {ddram1_a[10]}]
set_property SLEW FAST [get_ports {ddram1_a[10]}]
set_property IOSTANDARD SSTL15 [get_ports {ddram1_a[10]}]

# ddram:1.a
set_property LOC D26 [get_ports {ddram1_a[11]}]
set_property SLEW FAST [get_ports {ddram1_a[11]}]
set_property IOSTANDARD SSTL15 [get_ports {ddram1_a[11]}]

# ddram:1.a
set_property LOC H25 [get_ports {ddram1_a[12]}]
set_property SLEW FAST [get_ports {ddram1_a[12]}]
set_property IOSTANDARD SSTL15 [get_ports {ddram1_a[12]}]

# ddram:1.a
set_property LOC D25 [get_ports {ddram1_a[13]}]
set_property SLEW FAST [get_ports {ddram1_a[13]}]
set_property IOSTANDARD SSTL15 [get_ports {ddram1_a[13]}]

# ddram:1.a
set_property LOC B26 [get_ports {ddram1_a[14]}]
set_property SLEW FAST [get_ports {ddram1_a[14]}]
set_property IOSTANDARD SSTL15 [get_ports {ddram1_a[14]}]

# ddram:1.ba
set_property LOC F24 [get_ports {ddram1_ba[0]}]
set_property SLEW FAST [get_ports {ddram1_ba[0]}]
set_property IOSTANDARD SSTL15 [get_ports {ddram1_ba[0]}]

# ddram:1.ba
set_property LOC J25 [get_ports {ddram1_ba[1]}]
set_property SLEW FAST [get_ports {ddram1_ba[1]}]
set_property IOSTANDARD SSTL15 [get_ports {ddram1_ba[1]}]

# ddram:1.ba
set_property LOC E24 [get_ports {ddram1_ba[2]}]
set_property SLEW FAST [get_ports {ddram1_ba[2]}]
set_property IOSTANDARD SSTL15 [get_ports {ddram1_ba[2]}]

# ddram:1.ras_n
set_property LOC E28 [get_ports {ddram1_ras_n}]
set_property SLEW FAST [get_ports {ddram1_ras_n}]
set_property IOSTANDARD SSTL15 [get_ports {ddram1_ras_n}]

# ddram:1.cas_n
set_property LOC E26 [get_ports {ddram1_cas_n}]
set_property SLEW FAST [get_ports {ddram1_cas_n}]
set_property IOSTANDARD SSTL15 [get_ports {ddram1_cas_n}]

# ddram:1.we_n
set_property LOC F25 [get_ports {ddram1_we_n}]
set_property SLEW FAST [get_ports {ddram1_we_n}]
set_property IOSTANDARD SSTL15 [get_ports {ddram1_we_n}]

# ddram:1.cs_n
set_property LOC F28 [get_ports {ddram1_cs_n}]
set_property SLEW FAST [get_ports {ddram1_cs_n}]
set_property IOSTANDARD SSTL15 [get_ports {ddram1_cs_n}]

# ddram:1.cke
set_property LOC A28 [get_ports {ddram1_cke}]
set_property SLEW FAST [get_ports {ddram1_cke}]
set_property IOSTANDARD SSTL15 [get_ports {ddram1_cke}]

# ddram:1.odt
set_property LOC B27 [get_ports {ddram1_odt}]
set_property SLEW FAST [get_ports {ddram1_odt}]
set_property IOSTANDARD SSTL15 [get_ports {ddram1_odt}]

# ddram:1.reset_n
set_property LOC F18 [get_ports {ddram1_reset_n}]
set_property SLEW FAST [get_ports {ddram1_reset_n}]
set_property IOSTANDARD SSTL15 [get_ports {ddram1_reset_n}]

# ddram:1.dq
set_property LOC A29 [get_ports {ddram1_dq[0]}]
set_property SLEW FAST [get_ports {ddram1_dq[0]}]
set_property IOSTANDARD SSTL15 [get_ports {ddram1_dq[0]}]
set_property IN_TERM UNTUNED_SPLIT_40 [get_ports {ddram1_dq[0]}]

# ddram:1.dq
set_property LOC B33 [get_ports {ddram1_dq[1]}]
set_property SLEW FAST [get_ports {ddram1_dq[1]}]
set_property IOSTANDARD SSTL15 [get_ports {ddram1_dq[1]}]
set_property IN_TERM UNTUNED_SPLIT_40 [get_ports {ddram1_dq[1]}]

# ddram:1.dq
set_property LOC A31 [get_ports {ddram1_dq[2]}]
set_property SLEW FAST [get_ports {ddram1_dq[2]}]
set_property IOSTANDARD SSTL15 [get_ports {ddram1_dq[2]}]
set_property IN_TERM UNTUNED_SPLIT_40 [get_ports {ddram1_dq[2]}]

# ddram:1.dq
set_property LOC C33 [get_ports {ddram1_dq[3]}]
set_property SLEW FAST [get_ports {ddram1_dq[3]}]
set_property IOSTANDARD SSTL15 [get_ports {ddram1_dq[3]}]
set_property IN_TERM UNTUNED_SPLIT_40 [get_ports {ddram1_dq[3]}]

# ddram:1.dq
set_property LOC C32 [get_ports {ddram1_dq[4]}]
set_property SLEW FAST [get_ports {ddram1_dq[4]}]
set_property IOSTANDARD SSTL15 [get_ports {ddram1_dq[4]}]
set_property IN_TERM UNTUNED_SPLIT_40 [get_ports {ddram1_dq[4]}]

# ddram:1.dq
set_property LOC A30 [get_ports {ddram1_dq[5]}]
set_property SLEW FAST [get_ports {ddram1_dq[5]}]
set_property IOSTANDARD SSTL15 [get_ports {ddram1_dq[5]}]
set_property IN_TERM UNTUNED_SPLIT_40 [get_ports {ddram1_dq[5]}]

# ddram:1.dq
set_property LOC B30 [get_ports {ddram1_dq[6]}]
set_property SLEW FAST [get_ports {ddram1_dq[6]}]
set_property IOSTANDARD SSTL15 [get_ports {ddram1_dq[6]}]
set_property IN_TERM UNTUNED_SPLIT_40 [get_ports {ddram1_dq[6]}]

# ddram:1.dq
set_property LOC A33 [get_ports {ddram1_dq[7]}]
set_property SLEW FAST [get_ports {ddram1_dq[7]}]
set_property IOSTANDARD SSTL15 [get_ports {ddram1_dq[7]}]
set_property IN_TERM UNTUNED_SPLIT_40 [get_ports {ddram1_dq[7]}]

# ddram:1.dq
set_property LOC D31 [get_ports {ddram1_dq[8]}]
set_property SLEW FAST [get_ports {ddram1_dq[8]}]
set_property IOSTANDARD SSTL15 [get_ports {ddram1_dq[8]}]
set_property IN_TERM UNTUNED_SPLIT_40 [get_ports {ddram1_dq[8]}]

# ddram:1.dq
set_property LOC F33 [get_ports {ddram1_dq[9]}]
set_property SLEW FAST [get_ports {ddram1_dq[9]}]
set_property IOSTANDARD SSTL15 [get_ports {ddram1_dq[9]}]
set_property IN_TERM UNTUNED_SPLIT_40 [get_ports {ddram1_dq[9]}]

# ddram:1.dq
set_property LOC D30 [get_ports {ddram1_dq[10]}]
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

# ddram:1.dqs_p
set_property LOC H29 [get_ports {ddram1_dqs_p[3]}]
set_property SLEW FAST [get_ports {ddram1_dqs_p[3]}]
set_property IOSTANDARD DIFF_SSTL15 [get_ports {ddram1_dqs_p[3]}]
set_property IN_TERM UNTUNED_SPLIT_40 [get_ports {ddram1_dqs_p[3]}]

# ddram:1.dqs_p
set_property LOC D16 [get_ports {ddram1_dqs_p[4]}]
set_property SLEW FAST [get_ports {ddram1_dqs_p[4]}]
set_property IOSTANDARD DIFF_SSTL15 [get_ports {ddram1_dqs_p[4]}]
set_property IN_TERM UNTUNED_SPLIT_40 [get_ports {ddram1_dqs_p[4]}]

# ddram:1.dqs_p
set_property LOC K28 [get_ports {ddram1_dqs_p[5]}]
set_property SLEW FAST [get_ports {ddram1_dqs_p[5]}]
set_property IOSTANDARD DIFF_SSTL15 [get_ports {ddram1_dqs_p[5]}]
set_property IN_TERM UNTUNED_SPLIT_40 [get_ports {ddram1_dqs_p[5]}]

# ddram:1.dqs_p
set_property LOC G17 [get_ports {ddram1_dqs_p[6]}]
set_property SLEW FAST [get_ports {ddram1_dqs_p[6]}]
set_property IOSTANDARD DIFF_SSTL15 [get_ports {ddram1_dqs_p[6]}]
set_property IN_TERM UNTUNED_SPLIT_40 [get_ports {ddram1_dqs_p[6]}]

# ddram:1.dqs_p
set_property LOC G22 [get_ports {ddram1_dqs_p[7]}]
set_property SLEW FAST [get_ports {ddram1_dqs_p[7]}]
set_property IOSTANDARD DIFF_SSTL15 [get_ports {ddram1_dqs_p[7]}]
set_property IN_TERM UNTUNED_SPLIT_40 [get_ports {ddram1_dqs_p[7]}]

# ddram:1.dqs_p
set_property LOC K32 [get_ports {ddram1_dqs_p[8]}]
set_property SLEW FAST [get_ports {ddram1_dqs_p[8]}]
set_property IOSTANDARD DIFF_SSTL15 [get_ports {ddram1_dqs_p[8]}]
set_property IN_TERM UNTUNED_SPLIT_40 [get_ports {ddram1_dqs_p[8]}]

# ddram:1.dqs_n
set_property LOC B32 [get_ports {ddram1_dqs_n[0]}]
set_property SLEW FAST [get_ports {ddram1_dqs_n[0]}]
set_property IOSTANDARD DIFF_SSTL15 [get_ports {ddram1_dqs_n[0]}]
set_property IN_TERM UNTUNED_SPLIT_40 [get_ports {ddram1_dqs_n[0]}]

# ddram:1.dqs_n
set_property LOC C34 [get_ports {ddram1_dqs_n[1]}]
set_property SLEW FAST [get_ports {ddram1_dqs_n[1]}]
set_property IOSTANDARD DIFF_SSTL15 [get_ports {ddram1_dqs_n[1]}]
set_property IN_TERM UNTUNED_SPLIT_40 [get_ports {ddram1_dqs_n[1]}]

# ddram:1.dqs_n
set_property LOC A20 [get_ports {ddram1_dqs_n[2]}]
set_property SLEW FAST [get_ports {ddram1_dqs_n[2]}]
set_property IOSTANDARD DIFF_SSTL15 [get_ports {ddram1_dqs_n[2]}]
set_property IN_TERM UNTUNED_SPLIT_40 [get_ports {ddram1_dqs_n[2]}]

# ddram:1.dqs_n
set_property LOC H30 [get_ports {ddram1_dqs_n[3]}]
set_property SLEW FAST [get_ports {ddram1_dqs_n[3]}]
set_property IOSTANDARD DIFF_SSTL15 [get_ports {ddram1_dqs_n[3]}]
set_property IN_TERM UNTUNED_SPLIT_40 [get_ports {ddram1_dqs_n[3]}]

# ddram:1.dqs_n
set_property LOC D17 [get_ports {ddram1_dqs_n[4]}]
set_property SLEW FAST [get_ports {ddram1_dqs_n[4]}]
set_property IOSTANDARD DIFF_SSTL15 [get_ports {ddram1_dqs_n[4]}]
set_property IN_TERM UNTUNED_SPLIT_40 [get_ports {ddram1_dqs_n[4]}]

# ddram:1.dqs_n
set_property LOC K29 [get_ports {ddram1_dqs_n[5]}]
set_property SLEW FAST [get_ports {ddram1_dqs_n[5]}]
set_property IOSTANDARD DIFF_SSTL15 [get_ports {ddram1_dqs_n[5]}]
set_property IN_TERM UNTUNED_SPLIT_40 [get_ports {ddram1_dqs_n[5]}]

# ddram:1.dqs_n
set_property LOC G18 [get_ports {ddram1_dqs_n[6]}]
set_property SLEW FAST [get_ports {ddram1_dqs_n[6]}]
set_property IOSTANDARD DIFF_SSTL15 [get_ports {ddram1_dqs_n[6]}]
set_property IN_TERM UNTUNED_SPLIT_40 [get_ports {ddram1_dqs_n[6]}]

# ddram:1.dqs_n
set_property LOC G23 [get_ports {ddram1_dqs_n[7]}]
set_property SLEW FAST [get_ports {ddram1_dqs_n[7]}]
set_property IOSTANDARD DIFF_SSTL15 [get_ports {ddram1_dqs_n[7]}]
set_property IN_TERM UNTUNED_SPLIT_40 [get_ports {ddram1_dqs_n[7]}]

# ddram:1.dqs_n
set_property LOC J32 [get_ports {ddram1_dqs_n[8]}]
set_property SLEW FAST [get_ports {ddram1_dqs_n[8]}]
set_property IOSTANDARD DIFF_SSTL15 [get_ports {ddram1_dqs_n[8]}]
set_property IN_TERM UNTUNED_SPLIT_40 [get_ports {ddram1_dqs_n[8]}]

# ddram:1.clk_p
set_property LOC B25 [get_ports {ddram1_clk_p}]
set_property SLEW FAST [get_ports {ddram1_clk_p}]
set_property IOSTANDARD DIFF_SSTL15 [get_ports {ddram1_clk_p}]

# ddram:1.clk_n
set_property LOC A26 [get_ports {ddram1_clk_n}]
set_property SLEW FAST [get_ports {ddram1_clk_n}]
set_property IOSTANDARD DIFF_SSTL15 [get_ports {ddram1_clk_n}]

################################################################################
# Design constraints
################################################################################

set_property INTERNAL_VREF 0.750 [get_iobanks 11]

set_property INTERNAL_VREF 0.750 [get_iobanks 12]

set_property INTERNAL_VREF 0.750 [get_iobanks 13]

set_property INTERNAL_VREF 0.750 [get_iobanks 14]

set_property INTERNAL_VREF 0.750 [get_iobanks 15]

set_property INTERNAL_VREF 0.750 [get_iobanks 16]

set_property INTERNAL_VREF 0.750 [get_iobanks 17]

set_property INTERNAL_VREF 0.750 [get_iobanks 18]

set_clock_uncertainty -setup 1.000 -from [get_clocks -of_objects [get_pins -hierarchical -filter {NAME =~ */ldmmcm0/CLKIN1}]] -to [get_clocks -of_objects [get_pins -hierarchical -filter {NAME =~ */ldmmcm0/CLKOUT0}]]

set_clock_uncertainty -hold 1.000 -from [get_clocks -of_objects [get_pins -hierarchical -filter {NAME =~ */ldmmcm0/CLKIN1}]] -to [get_clocks -of_objects [get_pins -hierarchical -filter {NAME =~ */ldmmcm0/CLKOUT0}]]

set_clock_uncertainty -setup 1.000 -from [get_clocks -of_objects [get_pins -hierarchical -filter {NAME =~ */ldmmcm0/CLKOUT0}]] -to [get_clocks -of_objects [get_pins -hierarchical -filter {NAME =~ */ldmmcm0/CLKIN1}]]

set_clock_uncertainty -hold 1.000 -from [get_clocks -of_objects [get_pins -hierarchical -filter {NAME =~ */ldmmcm0/CLKOUT0}]] -to [get_clocks -of_objects [get_pins -hierarchical -filter {NAME =~ */ldmmcm0/CLKIN1}]]

set_max_delay 3.000 -from [get_cells -hierarchical -filter {NAME =~ *wlrst*}] -to [get_pins -of_objects [get_cells -hierarchical -filter {REF_NAME == OSERDESE2 || REF_NAME == ISERDESE2}] -filter {REF_PIN_NAME == RST}]

set_clock_uncertainty -setup 1.000 -from [get_clocks -of_objects [get_pins -hierarchical -filter {NAME =~ */ldmmcm1/CLKIN1}]] -to [get_clocks -of_objects [get_pins -hierarchical -filter {NAME =~ */ldmmcm1/CLKOUT0}]]

set_clock_uncertainty -hold 1.000 -from [get_clocks -of_objects [get_pins -hierarchical -filter {NAME =~ */ldmmcm1/CLKIN1}]] -to [get_clocks -of_objects [get_pins -hierarchical -filter {NAME =~ */ldmmcm1/CLKOUT0}]]

set_clock_uncertainty -setup 1.000 -from [get_clocks -of_objects [get_pins -hierarchical -filter {NAME =~ */ldmmcm1/CLKOUT0}]] -to [get_clocks -of_objects [get_pins -hierarchical -filter {NAME =~ */ldmmcm1/CLKIN1}]]

set_clock_uncertainty -hold 1.000 -from [get_clocks -of_objects [get_pins -hierarchical -filter {NAME =~ */ldmmcm1/CLKOUT0}]] -to [get_clocks -of_objects [get_pins -hierarchical -filter {NAME =~ */ldmmcm1/CLKIN1}]]

################################################################################
# Clock constraints
################################################################################


################################################################################
# False path constraints
################################################################################


set_false_path -quiet -to [get_cells -hierarchical -filter {mr_ff == TRUE}]

set_false_path -quiet -to [get_pins -filter {REF_PIN_NAME == PRE} -of_objects [get_cells -hierarchical -filter {ars_ff1 == TRUE || ars_ff2 == TRUE}]]

set_max_delay 2 -quiet -from [get_pins -filter {REF_PIN_NAME == C} -of_objects [get_cells -hierarchical -filter {ars_ff1 == TRUE}]] -to [get_pins -filter {REF_PIN_NAME == D} -of_objects [get_cells -hierarchical -filter {ars_ff2 == TRUE}]]
