FeSens/openTPU/boards/ypcb-00338/constraints/ddr3_ch0.pins.xdc

# DDR3 Channel 0 pin assignments for the Inspur YPCB-00338.
# Source: https://github.com/TiferKing/ypcb_00338_1p1_hack
# Source file: constraints/MEMORY_CH0.ucf
# Per-pin PACKAGE_PIN + IOSTANDARD lines only — nextpnr-xilinx 0.8.2's
# XDC parser rejects wildcard get_ports, get_iobanks, INTERNAL_VREF,
# and IN_TERM. The board-level VREF + termination knobs are folded
# into RTL primitives where the parser can't see them.

# ====================================================================
# Address bus (15 wires)
# ====================================================================
set_property PACKAGE_PIN AK27 [get_ports {ddr3_addr[0]}]
set_property IOSTANDARD SSTL15 [get_ports {ddr3_addr[0]}]
set_property PACKAGE_PIN AN23 [get_ports {ddr3_addr[1]}]
set_property IOSTANDARD SSTL15 [get_ports {ddr3_addr[1]}]
set_property PACKAGE_PIN AL24 [get_ports {ddr3_addr[2]}]
set_property IOSTANDARD SSTL15 [get_ports {ddr3_addr[2]}]
set_property PACKAGE_PIN AK26 [get_ports {ddr3_addr[3]}]
set_property IOSTANDARD SSTL15 [get_ports {ddr3_addr[3]}]
set_property PACKAGE_PIN AH24 [get_ports {ddr3_addr[4]}]
set_property IOSTANDARD SSTL15 [get_ports {ddr3_addr[4]}]
set_property PACKAGE_PIN AH25 [get_ports {ddr3_addr[5]}]
set_property IOSTANDARD SSTL15 [get_ports {ddr3_addr[5]}]
set_property PACKAGE_PIN AL26 [get_ports {ddr3_addr[6]}]
set_property IOSTANDARD SSTL15 [get_ports {ddr3_addr[6]}]
set_property PACKAGE_PIN AJ24 [get_ports {ddr3_addr[7]}]
set_property IOSTANDARD SSTL15 [get_ports {ddr3_addr[7]}]
set_property PACKAGE_PIN AJ25 [get_ports {ddr3_addr[8]}]
set_property IOSTANDARD SSTL15 [get_ports {ddr3_addr[8]}]
set_property PACKAGE_PIN AM23 [get_ports {ddr3_addr[9]}]
set_property IOSTANDARD SSTL15 [get_ports {ddr3_addr[9]}]
set_property PACKAGE_PIN AL28 [get_ports {ddr3_addr[10]}]
set_property IOSTANDARD SSTL15 [get_ports {ddr3_addr[10]}]
set_property PACKAGE_PIN AL25 [get_ports {ddr3_addr[11]}]
set_property IOSTANDARD SSTL15 [get_ports {ddr3_addr[11]}]
set_property PACKAGE_PIN AM25 [get_ports {ddr3_addr[12]}]
set_property IOSTANDARD SSTL15 [get_ports {ddr3_addr[12]}]
set_property PACKAGE_PIN AK24 [get_ports {ddr3_addr[13]}]
set_property IOSTANDARD SSTL15 [get_ports {ddr3_addr[13]}]
set_property PACKAGE_PIN AM27 [get_ports {ddr3_addr[14]}]
set_property IOSTANDARD SSTL15 [get_ports {ddr3_addr[14]}]

# ====================================================================
# Bank address (3 wires)
# ====================================================================
set_property PACKAGE_PIN AM26 [get_ports {ddr3_ba[0]}]
set_property IOSTANDARD SSTL15 [get_ports {ddr3_ba[0]}]
set_property PACKAGE_PIN AP24 [get_ports {ddr3_ba[1]}]
set_property IOSTANDARD SSTL15 [get_ports {ddr3_ba[1]}]
set_property PACKAGE_PIN AN28 [get_ports {ddr3_ba[2]}]
set_property IOSTANDARD SSTL15 [get_ports {ddr3_ba[2]}]

# ====================================================================
# Control + clock-enable + reset
# ====================================================================
set_property PACKAGE_PIN AJ29 [get_ports ddr3_ras_n]
set_property IOSTANDARD SSTL15 [get_ports ddr3_ras_n]
set_property PACKAGE_PIN AP26 [get_ports ddr3_cas_n]
set_property IOSTANDARD SSTL15 [get_ports ddr3_cas_n]
set_property PACKAGE_PIN AN27 [get_ports ddr3_we_n]
set_property IOSTANDARD SSTL15 [get_ports ddr3_we_n]
set_property PACKAGE_PIN AK28 [get_ports ddr3_cs_n]
set_property IOSTANDARD SSTL15 [get_ports ddr3_cs_n]
set_property PACKAGE_PIN AP27 [get_ports ddr3_cke]
set_property IOSTANDARD SSTL15 [get_ports ddr3_cke]
set_property PACKAGE_PIN AK29 [get_ports ddr3_odt]
set_property IOSTANDARD SSTL15 [get_ports ddr3_odt]
set_property PACKAGE_PIN AD31 [get_ports ddr3_reset_n]
set_property IOSTANDARD SSTL15 [get_ports ddr3_reset_n]

# ====================================================================
# Differential clock pair (OBUFDS instantiation in ddr3_phy.v)
# ====================================================================
set_property PACKAGE_PIN AN25 [get_ports ddr3_ck_p]
set_property IOSTANDARD DIFF_SSTL15 [get_ports ddr3_ck_p]
set_property PACKAGE_PIN AP25 [get_ports ddr3_ck_n]
set_property IOSTANDARD DIFF_SSTL15 [get_ports ddr3_ck_n]

# ====================================================================
# DQ — 72 data pins (8 byte lanes + 1 ECC lane)
# ====================================================================
set_property PACKAGE_PIN AG17 [get_ports {ddr3_dq[0]}]
set_property IOSTANDARD SSTL15 [get_ports {ddr3_dq[0]}]
set_property PACKAGE_PIN AG16 [get_ports {ddr3_dq[1]}]
set_property IOSTANDARD SSTL15 [get_ports {ddr3_dq[1]}]
set_property PACKAGE_PIN AH17 [get_ports {ddr3_dq[2]}]
set_property IOSTANDARD SSTL15 [get_ports {ddr3_dq[2]}]
set_property PACKAGE_PIN AJ19 [get_ports {ddr3_dq[3]}]
set_property IOSTANDARD SSTL15 [get_ports {ddr3_dq[3]}]
set_property PACKAGE_PIN AH18 [get_ports {ddr3_dq[4]}]
set_property IOSTANDARD SSTL15 [get_ports {ddr3_dq[4]}]
set_property PACKAGE_PIN AH19 [get_ports {ddr3_dq[5]}]
set_property IOSTANDARD SSTL15 [get_ports {ddr3_dq[5]}]
set_property PACKAGE_PIN AJ16 [get_ports {ddr3_dq[6]}]
set_property IOSTANDARD SSTL15 [get_ports {ddr3_dq[6]}]
set_property PACKAGE_PIN AJ17 [get_ports {ddr3_dq[7]}]
set_property IOSTANDARD SSTL15 [get_ports {ddr3_dq[7]}]
set_property PACKAGE_PIN AL20 [get_ports {ddr3_dq[8]}]
set_property IOSTANDARD SSTL15 [get_ports {ddr3_dq[8]}]
set_property PACKAGE_PIN AN17 [get_ports {ddr3_dq[9]}]
set_property IOSTANDARD SSTL15 [get_ports {ddr3_dq[9]}]
set_property PACKAGE_PIN AL19 [get_ports {ddr3_dq[10]}]
set_property IOSTANDARD SSTL15 [get_ports {ddr3_dq[10]}]
set_property PACKAGE_PIN AM16 [get_ports {ddr3_dq[11]}]
set_property IOSTANDARD SSTL15 [get_ports {ddr3_dq[11]}]
set_property PACKAGE_PIN AL18 [get_ports {ddr3_dq[12]}]
set_property IOSTANDARD SSTL15 [get_ports {ddr3_dq[12]}]
set_property PACKAGE_PIN AL16 [get_ports {ddr3_dq[13]}]
set_property IOSTANDARD SSTL15 [get_ports {ddr3_dq[13]}]
set_property PACKAGE_PIN AM20 [get_ports {ddr3_dq[14]}]
set_property IOSTANDARD SSTL15 [get_ports {ddr3_dq[14]}]
set_property PACKAGE_PIN AN18 [get_ports {ddr3_dq[15]}]
set_property IOSTANDARD SSTL15 [get_ports {ddr3_dq[15]}]
set_property PACKAGE_PIN AL23 [get_ports {ddr3_dq[16]}]
set_property IOSTANDARD SSTL15 [get_ports {ddr3_dq[16]}]
set_property PACKAGE_PIN AN20 [get_ports {ddr3_dq[17]}]
set_property IOSTANDARD SSTL15 [get_ports {ddr3_dq[17]}]
set_property PACKAGE_PIN AK23 [get_ports {ddr3_dq[18]}]
set_property IOSTANDARD SSTL15 [get_ports {ddr3_dq[18]}]
set_property PACKAGE_PIN AP19 [get_ports {ddr3_dq[19]}]
set_property IOSTANDARD SSTL15 [get_ports {ddr3_dq[19]}]
set_property PACKAGE_PIN AN22 [get_ports {ddr3_dq[20]}]
set_property IOSTANDARD SSTL15 [get_ports {ddr3_dq[20]}]
set_property PACKAGE_PIN AN19 [get_ports {ddr3_dq[21]}]
set_property IOSTANDARD SSTL15 [get_ports {ddr3_dq[21]}]
set_property PACKAGE_PIN AM22 [get_ports {ddr3_dq[22]}]
set_property IOSTANDARD SSTL15 [get_ports {ddr3_dq[22]}]
set_property PACKAGE_PIN AP20 [get_ports {ddr3_dq[23]}]
set_property IOSTANDARD SSTL15 [get_ports {ddr3_dq[23]}]
set_property PACKAGE_PIN AJ21 [get_ports {ddr3_dq[24]}]
set_property IOSTANDARD SSTL15 [get_ports {ddr3_dq[24]}]
set_property PACKAGE_PIN AH22 [get_ports {ddr3_dq[25]}]
set_property IOSTANDARD SSTL15 [get_ports {ddr3_dq[25]}]
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
set_property IOSTANDARD SSTL15 [get_ports {ddr3_dq[63]}]
set_property PACKAGE_PIN AN34 [get_ports {ddr3_dq[64]}]
set_property IOSTANDARD SSTL15 [get_ports {ddr3_dq[64]}]
set_property PACKAGE_PIN AP30 [get_ports {ddr3_dq[65]}]
set_property IOSTANDARD SSTL15 [get_ports {ddr3_dq[65]}]
set_property PACKAGE_PIN AM33 [get_ports {ddr3_dq[66]}]
set_property IOSTANDARD SSTL15 [get_ports {ddr3_dq[66]}]
set_property PACKAGE_PIN AN29 [get_ports {ddr3_dq[67]}]
set_property IOSTANDARD SSTL15 [get_ports {ddr3_dq[67]}]
set_property PACKAGE_PIN AP32 [get_ports {ddr3_dq[68]}]
set_property IOSTANDARD SSTL15 [get_ports {ddr3_dq[68]}]
set_property PACKAGE_PIN AP29 [get_ports {ddr3_dq[69]}]
set_property IOSTANDARD SSTL15 [get_ports {ddr3_dq[69]}]
set_property PACKAGE_PIN AM31 [get_ports {ddr3_dq[70]}]
set_property IOSTANDARD SSTL15 [get_ports {ddr3_dq[70]}]
set_property PACKAGE_PIN AP31 [get_ports {ddr3_dq[71]}]
set_property IOSTANDARD SSTL15 [get_ports {ddr3_dq[71]}]

# ====================================================================
# DQS — 9 differential strobe pairs (P + N per byte lane)
# ====================================================================
set_property PACKAGE_PIN AK16 [get_ports {ddr3_dqs_p[0]}]
set_property IOSTANDARD DIFF_SSTL15 [get_ports {ddr3_dqs_p[0]}]
set_property PACKAGE_PIN AK17 [get_ports {ddr3_dqs_n[0]}]
set_property IOSTANDARD DIFF_SSTL15 [get_ports {ddr3_dqs_n[0]}]
set_property PACKAGE_PIN AM17 [get_ports {ddr3_dqs_p[1]}]
set_property IOSTANDARD DIFF_SSTL15 [get_ports {ddr3_dqs_p[1]}]
set_property PACKAGE_PIN AM18 [get_ports {ddr3_dqs_n[1]}]
set_property IOSTANDARD DIFF_SSTL15 [get_ports {ddr3_dqs_n[1]}]
set_property PACKAGE_PIN AP21 [get_ports {ddr3_dqs_p[2]}]
set_property IOSTANDARD DIFF_SSTL15 [get_ports {ddr3_dqs_p[2]}]
set_property PACKAGE_PIN AP22 [get_ports {ddr3_dqs_n[2]}]
set_property IOSTANDARD DIFF_SSTL15 [get_ports {ddr3_dqs_n[2]}]
set_property PACKAGE_PIN AH20 [get_ports {ddr3_dqs_p[3]}]
set_property IOSTANDARD DIFF_SSTL15 [get_ports {ddr3_dqs_p[3]}]
set_property PACKAGE_PIN AJ20 [get_ports {ddr3_dqs_n[3]}]
set_property IOSTANDARD DIFF_SSTL15 [get_ports {ddr3_dqs_n[3]}]
set_property PACKAGE_PIN AK33 [get_ports {ddr3_dqs_p[4]}]
set_property IOSTANDARD DIFF_SSTL15 [get_ports {ddr3_dqs_p[4]}]
set_property PACKAGE_PIN AL33 [get_ports {ddr3_dqs_n[4]}]
set_property IOSTANDARD DIFF_SSTL15 [get_ports {ddr3_dqs_n[4]}]
set_property PACKAGE_PIN AG33 [get_ports {ddr3_dqs_p[5]}]
set_property IOSTANDARD DIFF_SSTL15 [get_ports {ddr3_dqs_p[5]}]
set_property PACKAGE_PIN AH33 [get_ports {ddr3_dqs_n[5]}]
set_property IOSTANDARD DIFF_SSTL15 [get_ports {ddr3_dqs_n[5]}]
set_property PACKAGE_PIN AE34 [get_ports {ddr3_dqs_p[6]}]
set_property IOSTANDARD DIFF_SSTL15 [get_ports {ddr3_dqs_p[6]}]
set_property PACKAGE_PIN AF34 [get_ports {ddr3_dqs_n[6]}]
set_property IOSTANDARD DIFF_SSTL15 [get_ports {ddr3_dqs_n[6]}]
set_property PACKAGE_PIN AE27 [get_ports {ddr3_dqs_p[7]}]
set_property IOSTANDARD DIFF_SSTL15 [get_ports {ddr3_dqs_p[7]}]
set_property PACKAGE_PIN AE28 [get_ports {ddr3_dqs_n[7]}]
set_property IOSTANDARD DIFF_SSTL15 [get_ports {ddr3_dqs_n[7]}]
set_property PACKAGE_PIN AN32 [get_ports {ddr3_dqs_p[8]}]
set_property IOSTANDARD DIFF_SSTL15 [get_ports {ddr3_dqs_p[8]}]
set_property PACKAGE_PIN AP33 [get_ports {ddr3_dqs_n[8]}]
set_property IOSTANDARD DIFF_SSTL15 [get_ports {ddr3_dqs_n[8]}]
