FeSens/openTPU/boards/ypcb-00338/constraints/ddr3_ch1.pins.xdc

# DDR3 Channel 1 pin assignments for the Inspur YPCB-00338.
#
# Source: TiferKing/ypcb_00338_1p1_hack constraints/MEMORY_CH1.ucf
# https://raw.githubusercontent.com/TiferKing/ypcb_00338_1p1_hack/main/constraints/MEMORY_CH1.ucf
#
# Port names are prefixed with ddr3_ch1_* so this file can coexist with
# the current CH0-only ddr3_ch0.xdc while the board top is expanded to
# two DDR3 controller/PHY instances.

set_property PACKAGE_PIN A29 [get_ports {ddr3_ch1_dq[0]}]
set_property IOSTANDARD SSTL15 [get_ports {ddr3_ch1_dq[0]}]
set_property PACKAGE_PIN B33 [get_ports {ddr3_ch1_dq[1]}]
set_property IOSTANDARD SSTL15 [get_ports {ddr3_ch1_dq[1]}]
set_property PACKAGE_PIN A31 [get_ports {ddr3_ch1_dq[2]}]
set_property IOSTANDARD SSTL15 [get_ports {ddr3_ch1_dq[2]}]
set_property PACKAGE_PIN C33 [get_ports {ddr3_ch1_dq[3]}]
set_property IOSTANDARD SSTL15 [get_ports {ddr3_ch1_dq[3]}]
set_property PACKAGE_PIN C32 [get_ports {ddr3_ch1_dq[4]}]
set_property IOSTANDARD SSTL15 [get_ports {ddr3_ch1_dq[4]}]
set_property PACKAGE_PIN A30 [get_ports {ddr3_ch1_dq[5]}]
set_property IOSTANDARD SSTL15 [get_ports {ddr3_ch1_dq[5]}]
set_property PACKAGE_PIN B30 [get_ports {ddr3_ch1_dq[6]}]
set_property IOSTANDARD SSTL15 [get_ports {ddr3_ch1_dq[6]}]
set_property PACKAGE_PIN A33 [get_ports {ddr3_ch1_dq[7]}]
set_property IOSTANDARD SSTL15 [get_ports {ddr3_ch1_dq[7]}]
set_property PACKAGE_PIN D31 [get_ports {ddr3_ch1_dq[8]}]
set_property IOSTANDARD SSTL15 [get_ports {ddr3_ch1_dq[8]}]
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
set_property PACKAGE_PIN J30 [get_ports {ddr3_ch1_dq[69]}]
set_property IOSTANDARD SSTL15 [get_ports {ddr3_ch1_dq[69]}]
set_property PACKAGE_PIN L33 [get_ports {ddr3_ch1_dq[70]}]
set_property IOSTANDARD SSTL15 [get_ports {ddr3_ch1_dq[70]}]
set_property PACKAGE_PIN J34 [get_ports {ddr3_ch1_dq[71]}]
set_property IOSTANDARD SSTL15 [get_ports {ddr3_ch1_dq[71]}]
set_property PACKAGE_PIN B31 [get_ports {ddr3_ch1_dqs_p[0]}]
set_property IOSTANDARD DIFF_SSTL15 [get_ports {ddr3_ch1_dqs_p[0]}]
set_property PACKAGE_PIN B32 [get_ports {ddr3_ch1_dqs_n[0]}]
set_property IOSTANDARD DIFF_SSTL15 [get_ports {ddr3_ch1_dqs_n[0]}]
set_property PACKAGE_PIN D34 [get_ports {ddr3_ch1_dqs_p[1]}]
set_property IOSTANDARD DIFF_SSTL15 [get_ports {ddr3_ch1_dqs_p[1]}]
set_property PACKAGE_PIN C34 [get_ports {ddr3_ch1_dqs_n[1]}]
set_property IOSTANDARD DIFF_SSTL15 [get_ports {ddr3_ch1_dqs_n[1]}]
set_property PACKAGE_PIN A19 [get_ports {ddr3_ch1_dqs_p[2]}]
set_property IOSTANDARD DIFF_SSTL15 [get_ports {ddr3_ch1_dqs_p[2]}]
set_property PACKAGE_PIN A20 [get_ports {ddr3_ch1_dqs_n[2]}]
set_property IOSTANDARD DIFF_SSTL15 [get_ports {ddr3_ch1_dqs_n[2]}]
set_property PACKAGE_PIN H29 [get_ports {ddr3_ch1_dqs_p[3]}]
set_property IOSTANDARD DIFF_SSTL15 [get_ports {ddr3_ch1_dqs_p[3]}]
set_property PACKAGE_PIN H30 [get_ports {ddr3_ch1_dqs_n[3]}]
set_property IOSTANDARD DIFF_SSTL15 [get_ports {ddr3_ch1_dqs_n[3]}]
set_property PACKAGE_PIN D16 [get_ports {ddr3_ch1_dqs_p[4]}]
set_property IOSTANDARD DIFF_SSTL15 [get_ports {ddr3_ch1_dqs_p[4]}]
set_property PACKAGE_PIN D17 [get_ports {ddr3_ch1_dqs_n[4]}]
set_property IOSTANDARD DIFF_SSTL15 [get_ports {ddr3_ch1_dqs_n[4]}]
set_property PACKAGE_PIN K28 [get_ports {ddr3_ch1_dqs_p[5]}]
set_property IOSTANDARD DIFF_SSTL15 [get_ports {ddr3_ch1_dqs_p[5]}]
set_property PACKAGE_PIN K29 [get_ports {ddr3_ch1_dqs_n[5]}]
set_property IOSTANDARD DIFF_SSTL15 [get_ports {ddr3_ch1_dqs_n[5]}]
set_property PACKAGE_PIN G17 [get_ports {ddr3_ch1_dqs_p[6]}]
set_property IOSTANDARD DIFF_SSTL15 [get_ports {ddr3_ch1_dqs_p[6]}]
set_property PACKAGE_PIN G18 [get_ports {ddr3_ch1_dqs_n[6]}]
set_property IOSTANDARD DIFF_SSTL15 [get_ports {ddr3_ch1_dqs_n[6]}]
set_property PACKAGE_PIN G22 [get_ports {ddr3_ch1_dqs_p[7]}]
set_property IOSTANDARD DIFF_SSTL15 [get_ports {ddr3_ch1_dqs_p[7]}]
set_property PACKAGE_PIN G23 [get_ports {ddr3_ch1_dqs_n[7]}]
set_property IOSTANDARD DIFF_SSTL15 [get_ports {ddr3_ch1_dqs_n[7]}]
set_property PACKAGE_PIN K32 [get_ports {ddr3_ch1_dqs_p[8]}]
set_property IOSTANDARD DIFF_SSTL15 [get_ports {ddr3_ch1_dqs_p[8]}]
set_property PACKAGE_PIN J32 [get_ports {ddr3_ch1_dqs_n[8]}]
set_property IOSTANDARD DIFF_SSTL15 [get_ports {ddr3_ch1_dqs_n[8]}]
set_property PACKAGE_PIN E27 [get_ports {ddr3_ch1_addr[0]}]
set_property IOSTANDARD SSTL15 [get_ports {ddr3_ch1_addr[0]}]
set_property PACKAGE_PIN C27 [get_ports {ddr3_ch1_addr[1]}]
set_property IOSTANDARD SSTL15 [get_ports {ddr3_ch1_addr[1]}]
set_property PACKAGE_PIN B28 [get_ports {ddr3_ch1_addr[2]}]
set_property IOSTANDARD SSTL15 [get_ports {ddr3_ch1_addr[2]}]
set_property PACKAGE_PIN D27 [get_ports {ddr3_ch1_addr[3]}]
set_property IOSTANDARD SSTL15 [get_ports {ddr3_ch1_addr[3]}]
set_property PACKAGE_PIN C24 [get_ports {ddr3_ch1_addr[4]}]
set_property IOSTANDARD SSTL15 [get_ports {ddr3_ch1_addr[4]}]
set_property PACKAGE_PIN D24 [get_ports {ddr3_ch1_addr[5]}]
set_property IOSTANDARD SSTL15 [get_ports {ddr3_ch1_addr[5]}]
set_property PACKAGE_PIN C25 [get_ports {ddr3_ch1_addr[6]}]
set_property IOSTANDARD SSTL15 [get_ports {ddr3_ch1_addr[6]}]
set_property PACKAGE_PIN A24 [get_ports {ddr3_ch1_addr[7]}]
set_property IOSTANDARD SSTL15 [get_ports {ddr3_ch1_addr[7]}]
set_property PACKAGE_PIN A25 [get_ports {ddr3_ch1_addr[8]}]
set_property IOSTANDARD SSTL15 [get_ports {ddr3_ch1_addr[8]}]
set_property PACKAGE_PIN J24 [get_ports {ddr3_ch1_addr[9]}]
set_property IOSTANDARD SSTL15 [get_ports {ddr3_ch1_addr[9]}]
set_property PACKAGE_PIN F26 [get_ports {ddr3_ch1_addr[10]}]
set_property IOSTANDARD SSTL15 [get_ports {ddr3_ch1_addr[10]}]
set_property PACKAGE_PIN D26 [get_ports {ddr3_ch1_addr[11]}]
set_property IOSTANDARD SSTL15 [get_ports {ddr3_ch1_addr[11]}]
set_property PACKAGE_PIN H25 [get_ports {ddr3_ch1_addr[12]}]
set_property IOSTANDARD SSTL15 [get_ports {ddr3_ch1_addr[12]}]
set_property PACKAGE_PIN D25 [get_ports {ddr3_ch1_addr[13]}]
set_property IOSTANDARD SSTL15 [get_ports {ddr3_ch1_addr[13]}]
set_property PACKAGE_PIN B26 [get_ports {ddr3_ch1_addr[14]}]
set_property IOSTANDARD SSTL15 [get_ports {ddr3_ch1_addr[14]}]
set_property PACKAGE_PIN F24 [get_ports {ddr3_ch1_ba[0]}]
set_property IOSTANDARD SSTL15 [get_ports {ddr3_ch1_ba[0]}]
set_property PACKAGE_PIN J25 [get_ports {ddr3_ch1_ba[1]}]
set_property IOSTANDARD SSTL15 [get_ports {ddr3_ch1_ba[1]}]
set_property PACKAGE_PIN E24 [get_ports {ddr3_ch1_ba[2]}]
set_property IOSTANDARD SSTL15 [get_ports {ddr3_ch1_ba[2]}]
set_property PACKAGE_PIN E26 [get_ports {ddr3_ch1_cas_n}]
set_property IOSTANDARD SSTL15 [get_ports {ddr3_ch1_cas_n}]
set_property PACKAGE_PIN A26 [get_ports {ddr3_ch1_ck_n}]
set_property IOSTANDARD DIFF_SSTL15 [get_ports {ddr3_ch1_ck_n}]
set_property PACKAGE_PIN B25 [get_ports {ddr3_ch1_ck_p}]
set_property IOSTANDARD DIFF_SSTL15 [get_ports {ddr3_ch1_ck_p}]
set_property PACKAGE_PIN A28 [get_ports {ddr3_ch1_cke}]
set_property IOSTANDARD SSTL15 [get_ports {ddr3_ch1_cke}]
set_property PACKAGE_PIN F28 [get_ports {ddr3_ch1_cs_n}]
set_property IOSTANDARD SSTL15 [get_ports {ddr3_ch1_cs_n}]
set_property PACKAGE_PIN B27 [get_ports {ddr3_ch1_odt}]
set_property IOSTANDARD SSTL15 [get_ports {ddr3_ch1_odt}]
set_property PACKAGE_PIN E28 [get_ports {ddr3_ch1_ras_n}]
set_property IOSTANDARD SSTL15 [get_ports {ddr3_ch1_ras_n}]
set_property PACKAGE_PIN F18 [get_ports {ddr3_ch1_reset_n}]
set_property IOSTANDARD SSTL15 [get_ports {ddr3_ch1_reset_n}]
set_property PACKAGE_PIN F25 [get_ports {ddr3_ch1_we_n}]
set_property IOSTANDARD SSTL15 [get_ports {ddr3_ch1_we_n}]
