FeSens/openTPU/boards/bcu1525/x2/pins_x2.xdc

# QSFP28 pads as in Corundum's AU200 / VCU1525 constraints (fpga_au200.xdc; https://github.com/corundum/corundum,
# Copyright The Regents of the University of California, BSD-2-Clause-Views; see THIRD_PARTY.md).
# Only U9 / QSFP0 MGTREFCLK1 is buffered. No U12 or SI5335 control port.
set_property PACKAGE_PIN N4 [get_ports {qsfp0_rx_p[0]}]
set_property PACKAGE_PIN N3 [get_ports {qsfp0_rx_n[0]}]
set_property PACKAGE_PIN N9 [get_ports {qsfp0_tx_p[0]}]
set_property PACKAGE_PIN N8 [get_ports {qsfp0_tx_n[0]}]
set_property PACKAGE_PIN M2 [get_ports {qsfp0_rx_p[1]}]
set_property PACKAGE_PIN M1 [get_ports {qsfp0_rx_n[1]}]
set_property PACKAGE_PIN M7 [get_ports {qsfp0_tx_p[1]}]
set_property PACKAGE_PIN M6 [get_ports {qsfp0_tx_n[1]}]
set_property PACKAGE_PIN L4 [get_ports {qsfp0_rx_p[2]}]
set_property PACKAGE_PIN L3 [get_ports {qsfp0_rx_n[2]}]
set_property PACKAGE_PIN L9 [get_ports {qsfp0_tx_p[2]}]
set_property PACKAGE_PIN L8 [get_ports {qsfp0_tx_n[2]}]
set_property PACKAGE_PIN K2 [get_ports {qsfp0_rx_p[3]}]
set_property PACKAGE_PIN K1 [get_ports {qsfp0_rx_n[3]}]
set_property PACKAGE_PIN K7 [get_ports {qsfp0_tx_p[3]}]
set_property PACKAGE_PIN K6 [get_ports {qsfp0_tx_n[3]}]
set_property PACKAGE_PIN K11 [get_ports qsfp0_mgt_refclk_1_p]
set_property PACKAGE_PIN K10 [get_ports qsfp0_mgt_refclk_1_n]
set_property PACKAGE_PIN U4 [get_ports {qsfp1_rx_p[0]}]
set_property PACKAGE_PIN U3 [get_ports {qsfp1_rx_n[0]}]
set_property PACKAGE_PIN U9 [get_ports {qsfp1_tx_p[0]}]
set_property PACKAGE_PIN U8 [get_ports {qsfp1_tx_n[0]}]
set_property PACKAGE_PIN T2 [get_ports {qsfp1_rx_p[1]}]
set_property PACKAGE_PIN T1 [get_ports {qsfp1_rx_n[1]}]
set_property PACKAGE_PIN T7 [get_ports {qsfp1_tx_p[1]}]
set_property PACKAGE_PIN T6 [get_ports {qsfp1_tx_n[1]}]
set_property PACKAGE_PIN R4 [get_ports {qsfp1_rx_p[2]}]
set_property PACKAGE_PIN R3 [get_ports {qsfp1_rx_n[2]}]
set_property PACKAGE_PIN R9 [get_ports {qsfp1_tx_p[2]}]
set_property PACKAGE_PIN R8 [get_ports {qsfp1_tx_n[2]}]
set_property PACKAGE_PIN P2 [get_ports {qsfp1_rx_p[3]}]
set_property PACKAGE_PIN P1 [get_ports {qsfp1_rx_n[3]}]
set_property PACKAGE_PIN P7 [get_ports {qsfp1_tx_p[3]}]
set_property PACKAGE_PIN P6 [get_ports {qsfp1_tx_n[3]}]
set_property -dict {PACKAGE_PIN BE16 IOSTANDARD LVCMOS12 SLEW SLOW DRIVE 8} [get_ports qsfp0_modsell]
set_property -dict {PACKAGE_PIN BE17 IOSTANDARD LVCMOS12 SLEW SLOW DRIVE 8} [get_ports qsfp0_resetl]
set_property -dict {PACKAGE_PIN BD18 IOSTANDARD LVCMOS12 SLEW SLOW DRIVE 8} [get_ports qsfp0_lpmode]
set_property -dict {PACKAGE_PIN AY20 IOSTANDARD LVCMOS12 SLEW SLOW DRIVE 8} [get_ports qsfp1_modsell]
set_property -dict {PACKAGE_PIN BC18 IOSTANDARD LVCMOS12 SLEW SLOW DRIVE 8} [get_ports qsfp1_resetl]
set_property -dict {PACKAGE_PIN AV22 IOSTANDARD LVCMOS12 SLEW SLOW DRIVE 8} [get_ports qsfp1_lpmode]
set_false_path -to [get_ports {qsfp*_modsell qsfp*_resetl qsfp*_lpmode}]
set_output_delay 0 [get_ports {qsfp*_modsell qsfp*_resetl qsfp*_lpmode}]
