FeSens/openTPU/(commit log)

2026-09-23 openTPU v0.1: Qwen3-0.6B bit-exact on ISA sim and RTL, board memory path
    - Qwen3-0.6B end to end: ISA simulator matches HF greedy; one real token bit-exact on RTL
    at the board configuration through the AXI DDR3 adapter and DRAM program loader
    - Pipelined fp32 (fmul 2, fadd 4 stages), split-lane VPU, BRAM TMEM replicated per read port
    - AXI adapter onto two interleaved DDR3 channels, backpressure and write-ack in the slice
    - Board wrapper, AXI-Lite control registers, host driver with XDMA and simulation transports
2026-09-23 host: board-model tests; one flush per run; LOADING covers loader start
    - tests/test_board.py: address map / unaligned RMW, a program (LD/VOP/EXP2/QACT/MM/QST/ST) and
    tiny Qwen3 through BoardBackend on tb_board, bit-exact vs the ISA simulator
    - host/board.py: reg_read_many so a run's counters are read in the same simulation
    - otpu_ctrl: STATUS.LOADING is set from the LOAD write until the loader is visibly busy
2026-09-23 host: staged bring-up self-test, board backends in the chat CLI
    - tools/board_selftest.py: link, config, DDR calibration, registers, walking address bits,
    interleave pattern test, DMA bandwidth, a program on every unit vs the ISA simulator, and
    Qwen3 greedy decoding vs the ISA simulator; --sim runs it on the board model
    - host/checks.py: the checks, shared with tests/test_board.py
    - tools/chat.py: --backend board (XDMA, board_config) and board-sim; device cycles and
    tokens/s from the board counters
    - host/board.py: sim_config (board configuration sized for a model)
2026-09-23 ypcb-00338: Vivado flow for the board (block design, MIG, XDC, build, program, docs)
    - otpu_fpga_top: block design wrapper (XDMA Gen2 x8, 2x MIG DDR3, clocks) + otpu_board
    - bd.tcl: XDMA, two MIGs (72-bit ECC, no DM), SmartConnects, clk_wiz 50->100/200/267 MHz,
    address map MIG0 0x0 / MIG1 0x8000_0000 for XDMA and the core's two masters
    - gen_mig_prj.py: MIG .prj + pin XDCs from the board pin lists, byte-group check
    - constraints: board pins, PCIe refclk/PERST#, BPI config; DDR3 locations
    - create_project/build.tcl, run_vivado.sh (native or Docker), program.sh (openFPGALoader,
    Vivado, BPI flash), Makefile, offline checks, hardware self-test, docs/board.md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
2026-09-23 host: one self-test (tools/board_selftest.py), partial-write checks, docs/host.md
    - partial DRAM writes: sub-beat host DMA writes and an accelerator program of QST byte writes
    and short word-masked stores (the board's DDR3 has no DM pins: MIG read-modify-write)
    - raw per-channel patterns (from the Vivado workstream's self-test, now removed; board.md
    points to tools/board_selftest.py)
    - docs/host.md: host PC, XDMA driver, lspci checks, self-test, chat, registers, troubleshooting
    [checks.py, test_board.py]
2026-09-23 Synthesis tooling for the board build; VPU fold buffer as rows x lanes (narrow muxes); DMA declaration order
2026-09-23 Lens: profile files, recorder CLI and a browser app with a replayable floorplan
    - .otpuprof: versioned gzip JSON (rtl / isa / board profiles): config, programs, dynamic
    instructions, bucketed counters, roofline, sources, notes, board counters
    - python -m opentpu.lens record|open|html|info|list (also the 'lens' console script);
    workloads include one traced Qwen3 token (tiny or real) at the design or board config,
    with the board's AXI memory path
    - RTL: a sim-only Q trace line per bucket (DRAM port A/B waiting for memory, MXU starved or
    not consuming, MXU FIFO level, loader traffic); rtlsim.run(plusargs=...)
    - App (single self-contained HTML, opens files by drag and drop, local server,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
2026-09-23 Lens floorplan: explanations on every element, help panel and guided tour
    - hover / click-to-pin cards on every floorplan element (units, window slots, MXU FIFO and
    columns, TMEM banks, VPU lanes, DRAM ports A/B and channels, control, data paths, state
    legend, roofline-gap bar, unit list, playback controls) and on the timeline strips: what it
    is, how it works here (config numbers), live state at the current cycle (instruction,
    operands, source, what it waits for, occupancy, stalls so far) and roofline advice
    - profiles now carry instruction operand fields and the memory model (MEM, FIFO_DEPTH, ...)
    - 'How to read' panel, first-visit guided tour (remembered in localStorage), deep link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
    [lens.py]
2026-09-23 Sequencer timing: age-matrix oldest-ready select, 5-stage in-order dispatch (footprint products on single DSPs), two-cycle LOOP
2026-09-23 perf: AXI model bandwidth/latency knobs, board FIFO 1024, Qwen3 token profiler
    - otpu_axi_mem: +axi_bw (percent, per-channel beat credit) and +axi_lat plusargs
    - rtlsim: OTPU_BW/OTPU_LAT, run(bw=, lat=); BOARD_UARCH FIFO_DEPTH 1024
    - tb_top: FIFO_DEPTH parameter
    - tools/perf_qwen.py: one Qwen3 token at board config over AXI with boot,
    chunk and useful-bytes rooflines, port-B idle analysis, ISA bit-exact check
    Claude-Session: https://claude.ai/code/session_01L9Z1aY6tsxQA6NseQ6dgyA
2026-09-23 rtl: separate scalar-write (QST) DRAM port; board FIFO depth 1024
    Quantizer byte stores no longer share port A with MXU scale reads.
    otpu_axi_dram gets a per-channel SW write queue (priority over A/B writes,
    invalidates A-beat reuse); behavioural otpu_dram gets a byte-enabled SW port.
    Board ctrl 0x30 now counts SW write requests.
    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
    [otpu_board.sv, otpu_ctrl.sv, otpu_dram.sv, otpu_slice.sv, otpu_top.sv]
2026-09-23 qwen3: interleave per-head Q with batched flash attention, block 256, W_down column parts
    - attention: _attend_heads runs all KV heads in one pipelined stream (score
    prefetch primes the next head; q emitted lazily 2 heads ahead)
    - qwen3: q projection split per KV head, ATTN_BLOCK 256, W_down stored as
    per-column-part QTensors so scales are contiguous (one beat per 16 rows)
    - compiler: Tile.reshape, QTensor parts, and loop_uses only pins
    stationaries from outer loops (fixes ACT RAM exhaustion)
    Full 28-layer token, pos 9, lat 30: 5,225,080 -> 4,945,002 cycles at 100% bw,
    6,450,013 -> 6,161,605 at 80%; bit-exact vs ISA sim.
    Claude-Session: https://claude.ai/code/session_01L9Z1aY6tsxQA6N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
    [compiler.py]
2026-09-23 Timing: quantizer scale-unit input register, collective addresses by stride adds, VPU EXP2 range reduction in three stages
2026-09-23 Delay lines end in a flip-flop (shreg_extract=no on the last stage); synth runner: MXU at board FIFO depth 1024
    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
    [otpu_fpipe.sv]
2026-09-23 Quantizer timing: QST address products in three stages, registered writer selection, registered reciprocal seed, two-stage chunk amax
    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
2026-09-23 tools/tourney: per-component architecture tournament
    Hypothesis and implementation agents (claude or codex, per-role model/effort) in per-slot
    worktrees, gated by sandbox, lint, bit-exact fast and board subsets, the Qwen3 perf proxy and
    component synthesis (yosys; vivado backend untested), accept rule on area-eq / est fmax, champion
    branch tourney/<comp>, LESSONS.md + log.jsonl + report. Smoke round on otpu_coll accepted
    (area -28%, est fmax 75 -> 128 MHz; champion b3af1b5).
    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
2026-09-23 LLM: batched decode and chunked prefill (qwen3_rows), tools/bench_llm.py
    qwen3_rows runs R token rows per device run, each (sequence, position): b
    sequences decoding together (one KV cache per sequence) or a prefill chunk of
    one sequence (causal: all K/V appended first, each row attends over its own
    prefix). Every projection streams its weights once for all rows. Bit-identical
    to token-by-token decode. Engine: prefill(tokens, seq, chunk), step_batch,
    generate_batch. bench_llm.py measures prefill / decode / TTFT on the board RTL
    from 1-2 layer proxies (validated against full 28-layer runs); results and
    method in docs/benchmarks.md.
    Claude-Session: https://claude.ai/code/session_01L9Z1aY6tsxQ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
2026-09-23 AXI adapter: outstanding-write count from one summed delta (no adder chain); VPU: registered fold-tree issue, two-stage RMAX lane tree; synth tools: SYNTH_OUT / SYNTH_OPTS overrides
    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
    [otpu_vpu.sv]
2026-09-23 MXU: DSP-cascade dot product (MXU_IMPL=1, bit-exact), MCOLS > LANES, registered RMAX compare; mxu_bench and sta.sh
    otpu_mxu IMPL=1 reduces each column's 128 products in D/CL skewed chains
    (product register + running sum: DSP48E1 M and PCIN->P) and a small registered
    tree; latency CL+1+levels, the scale delays follow it. Plumbed as
    MXU_IMPL/MXU_CL through slice/top/board/tb, OTPU_MXU=cascade in rtlsim.
    ASCALE alpha load and RMAX write-back loop over LANES lanes, so MCOLS may
    exceed LANES. The RMAX compare is registered after the drain lane selection
    (the MCOLS>=8 critical path). tools/mxu_bench.py measures an MLP layer per
    MCOLS/rows on the RTL and projects prefill/decode/TTFT.
    Claude-Sessio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
2026-09-23 docs/mxu_study.md: MXU width / implementation study for the board; mxu_bench runs the LM head once per prompt
    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
2026-09-24 slice: write-mask TMEM arbiter for the board build (no per-bank counters)
    With TMEM replicated per read port (RPB >= NRP*LANES) reads never conflict, and with WPB = 1
    a unit is granted when none of its write banks was taken by a higher-priority unit. Removes
    the full-board critical path (unit requests -> counting arbiter -> grant -> TMEM write, 14.9 ns).
    Grants are identical to the counting arbiter; other configurations keep it.
    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
2026-09-24 Board build switches (MCOLS, CORE_MHZ) and a Pareto tournament accept rule
    make bit MCOLS=4 / CORE_MHZ=80 select the MXU columns and the accelerator clock; the host and
    the board simulation follow OTPU_MCOLS. The tournament now accepts an area win that does not
    lose fmax even while the component is below its target frequency.
    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
2026-09-24 quant: per-lane block-buffer RAMs, flip-flop tails on the scale unit's operand delays
    Tournament candidate r20260923-234940-s1 (Opus): area_eq 38545 -> 16939 (-56%: LUTRAM
    17099 -> 1069, LUT 16014 -> 10351), est. fmax 94 -> 96 MHz. Rejected by the old accept rule
    (below the 110 MHz target); accepted under the Pareto rule.
    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
    [otpu_quant.sv]
2026-09-24 VPU: register the TMEM writes (no read -> lanes -> write path in one cycle)
    The full-board critical path ran from a TMEM BRAM read through the 0-slot functions
    (MAX/MIN/COPY/ABS/FILL) and the EXP2 exponent add into a TMEM BRAM write. Writes are now
    performed one granted cycle after they are computed; done follows the last write.
    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
2026-09-24 host: setup_pcie.sh (driver, udev, rescan, ID check in one command)
    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
2026-09-24 tourney otpu_quant: Scale unit: the "+(-0)" Newton adds become plain delays ending in a flip-flop, and no ftz LUTs in front of the multiplier DSPs
    fmax +9.4% (96 -> 105 MHz), area -7.2%
    Slot r20260924-001302-s0, agent claude, eval yosys.
    [otpu_quant.sv]
2026-09-24 tourney otpu_fp: fp_add: zeros ride the datapath, special value shrinks from 32 bits to 3 (x3 pipeline stages)
    area -12.9% at 114 MHz (>= 110)
    Slot r20260924-001644-s1, agent claude, eval yosys.
2026-09-24 tourney otpu_fp: Round without the post-round shift: mantissa straight from the carry chain, exponent flags off the carry-out
    area -2.5% at 123 MHz (>= 110)
    Slot r20260924-002708-s1, agent claude, eval yosys.
2026-09-24 tourney otpu_quant: Carry-free sticky bits: take the `(1<<k)-1` mask subtract and the `-mb` negation off the fadd align/add stage (and the q8 shift stage)
    area -4.1%, fmax +1.9% (105 -> 107 MHz, below target)
    Slot r20260924-002052-s0, agent claude, eval yosys.
2026-09-24 tourney otpu_fp: fmul s1: feed the DSP mantissa product from the raw inputs (FTZ off the DSP operands)
    area -6.3% at 145 MHz (>= 110)
    Slot r20260924-003650-s0, agent claude, eval yosys.
2026-09-24 tourney otpu_quant: fmul round stage: rounding overflow from an all-ones test, exponent/range off the carry chain, no `mr>>1` mux
    area -1.9%, fmax +1.5% (107 -> 109 MHz, below target)
    Slot r20260924-003919-s1, agent claude, eval yosys.
2026-09-24 tourney otpu_quant: Scale unit: drop the Newton multiply's 4-cycle pad so y[i] leaves a real flip-flop (and every scale-unit delay line gets shorter)
    fmax +6.5% (109 -> 116 MHz), area -0.7%
    Slot r20260924-004705-s1, agent claude, eval yosys.
    [otpu_quant.sv]
2026-09-24 tourney otpu_fp: fadd s3: one normalize shifter for add and sub (a 28-bit LZC replaces the add/sub mantissa mux)
    area -4.2% at 145 MHz (>= 110)
    Slot r20260924-004426-s1, agent claude, eval yosys.
    [otpu_fp.sv]
2026-09-24 Cross-unit timing: TMEM read addresses from the requests, MXU RMAX base precomputed
    The full-board path ran MXU q_M -> a DSP multiply (c_M * ors) -> the arbiter's bank masks ->
    the VPU grant -> the TMEM read-address merge -> BRAM ADDRB. The RMAX output base is now
    computed when the command is queued, and the TMEM merges each port's bank addresses from the
    unit's requests (a port belongs to one unit, grants are all-or-nothing per unit), so the grant
    only reaches the block RAM enables.
    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
2026-09-24 tourney otpu_seq: Scoreboard with 5 footprint ranges (MM ASCALE shares rd[1]) + registered instruction word
    area -10.6% at 113 MHz (>= 110)
    Slot r20260924-004406-s1, agent claude, eval yosys.
2026-09-24 tourney otpu_quant: amax path on magnitudes: 31-bit unsigned compares, no redundant ftz, one shared running-max compare
    area -3.1% at 133 MHz (>= 110)
    Slot r20260924-005428-s1, agent claude, eval yosys.
2026-09-24 tourney otpu_fp: fadd s3: normalize while counting (the LZC's shift stages become the normalize shifter)
    area -1.1% at 141 MHz (>= 110)
    Slot r20260924-005536-s1, agent claude, eval yosys.
2026-09-24 tourney otpu_seq: One-hot oldest-ready select: can_start without the start_slot encode -> sdep/sdepd mux
    fmax +20.2% (113 -> 136 MHz), area +0.1%
    Slot r20260924-005905-s0, agent claude, eval yosys.
2026-09-24 tourney otpu_fp: fadd s2: sticky collected at each alignment-shift stage (no thermometer mask)
    area -2.3% at 141 MHz (>= 110)
    Slot r20260924-010507-s1, agent claude, eval yosys.
2026-09-24 tourney otpu_quant: QST byte address from running sums in the reader, not from four DSP multiplies per chunk
    area -1.1% at 133 MHz (>= 110)
    Slot r20260924-010050-s1, agent claude, eval yosys.
2026-09-24 tourney otpu_seq: Per-unit command read straight from the window's LUT-RAM (drop the 5 x 240-bit ucmd registers)
    area -2.4% at 133 MHz (>= 110)
    Slot r20260924-010905-s1, agent claude, eval yosys.
2026-09-24 tourney: no private fp operators; champions follow the base branch
    The quantizer champion built its own fmul/fadd from otpu_fp's stage functions; the fp
    tournament then changed those internals and the two champions, each green alone, computed
    wrong results together. The sandbox gate now rejects fp stage internals outside the fp files,
    and every round first merges the base branch into the champion (kept only if the component's
    fast tests pass on the merge).
    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
2026-09-24 quant: use the shared fp operators (drop the private otpu_qfmul/qfadd/qfmadd)
    The private copies were built from otpu_fp's stage internals, which the fp tournament has
    since changed (and made faster for every user).
    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
2026-09-24 tourney otpu_vpu: Carry only live state through the VPU delay lines (+ one compare level per RMAX stage)
    area -6.1%, fmax +1.3% (107 -> 108 MHz, below target)
    Slot r20260924-011716-s1, agent claude, eval yosys.
2026-09-24 tourney otpu_seq: Space-segregated scoreboard footprint on the current champion: 13 cells instead of 16, no space compares, valid bits folded into `hi`
    area -8.8% at 125 MHz (>= 110)
    Slot r20260924-011856-s1, agent claude, eval yosys.
2026-09-24 VPU: register the TMEM read data at the input (no BRAM -> lanes -> DSP path in one cycle)
    The full-board critical path (8.27 ns logic) ran from a TMEM BRAM output through the slot-0
    operand select into the multiplier's DSP cascade. The issue register now feeds a stage that
    captures the chunk's meta and its TMEM data together; every consumer moves by one cycle.
    Also: no typed net initializer (Vivado front end).
    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
    [otpu_vpu.sv]
2026-09-24 tourney otpu_mxu: Two int8 products per DSP48E1: pack column pairs that share a weight byte
    area -12.6%, fmax +0.0% (106 -> 106 MHz, below target)
    Slot r20260924-012715-s1, agent claude, eval yosys.
2026-09-24 tourney otpu_seq: Narrow the scoreboard's TMEM ranges to 16/17 bits; anything outside falls back to `all`
    area -14.0% at 113 MHz (>= 110)
    Slot r20260924-013720-s1, agent claude, eval yosys.
2026-09-24 coll: register the write stage's address base and lane mask (off the TMEM arbiter path)
    The full-board critical path ran from pcl through the write address add and the lane compare
    into the arbiter, the MXU grant and the TMEM write-data merge.
    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
2026-09-24 DMA: register the LD lane mask (the in-range compares are off the TMEM arbiter path)
    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
2026-09-24 tourney otpu_axi_dram: Count accepted writes from the take strobes, not the queue pushes (take a_reuse off the wr_n path)
    fmax +23.5% (139 -> 172 MHz), area +0.0%
    Slot r20260924-020918-s0, agent claude, eval yosys.
2026-09-24 tourney otpu_mxu: Latch the combine operands into pset at the row's last block (no mux in front of u_c01/u_c23)
    fmax +3.0% (106 -> 109 MHz), area -0.4%
    Slot r20260924-015733-s0, agent claude, eval yosys.
2026-09-24 tourney otpu_axi_dram: Register the write-accept strobes before they reach the wr_n adder (exact wr_idle kept)
    fmax +23.3% (172 -> 212 MHz), area +0.1%
    Slot r20260924-021537-s0, agent claude, eval yosys.
2026-09-24 tourney otpu_mxu: Size the drain's read-modify-write and RMAX lanes to NL = min(LANES, MCOLS)
    area -1.5%, fmax +0.0% (109 -> 109 MHz, below target)
    Slot r20260924-022514-s1, agent claude, eval yosys.
2026-09-24 quant: register the TMEM read data before the prescale multipliers
    The full-board critical path (7.25 ns) ran from a TMEM BRAM output into the prescale fmul's
    DSP cascade. m0 and the byte address are delayed one more cycle to match (QL).
    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
2026-09-24 tourney: every component gates on the kernel perf tests; MLP floor 0.945
    A VPU candidate (2 RSUM tree buffers instead of 4) passed the Qwen3 token proxy but cost
    10-15% on attention with 4-6 query rows per KV head (batched decode); the kernel perf tests
    catch it. The MLP decode floor moves from 0.95 to 0.945 (fixed per-instruction latency of the
    board timing registers, see the test).
    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
2026-09-24 MXU: register the accumulate path's TMEM read data before the fmadd
    The full-board critical path (7.25 ns) ran from a TMEM BRAM output into the drain's
    read-modify-write fmadd DSP cascade. rmw_n counts the new stage (drain issue to write).
    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
    [otpu_mxu.sv]
2026-09-24 tourney otpu_mxu: Put the int8 product register into the DSP48 (MREG): make `pp` a packed register, not a memory; end the fp-multiplier operand SRLs in flops
    area -7.4% at 122 MHz (>= 110)
    Slot r20260924-030158-s0, agent claude, eval yosys.
2026-09-24 tourney otpu_mxu: Share one fadd per column for both isum_4 pair sums (p0+p2, p1+p3): they happen at different advances
    area -4.7% at 122 MHz (>= 110)
    Slot r20260924-031957-s1, agent claude, eval yosys.
2026-09-24 MXU: drain addresses kept per column in registers (no adder in front of the TMEM arbiter)
    The full-board critical path ran from the drain index dj through q_jo[dj+k] + d_row into the
    arbiter's bank masks, the grants and the TMEM write-address merge.
    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
2026-09-24 tourney otpu_mxu: Register the drain fmadd's ASCALE factor (al) one stage early, with r1: no mux in front of the DSP B port
    fmax +3.8% (122 -> 127 MHz), area +0.0%
    Slot r20260924-033026-s0, agent claude, eval yosys.
2026-09-24 tourney otpu_vpu: RSUM/RSSQ: streaming fold tree (delay lines + fixed slot schedule) replaces the pb buffers
    area -20.8%, fmax +1.2% (108 -> 109 MHz, below target)
    Slot r20260924-032708-s1, agent claude, eval yosys.
    [otpu_vpu.sv]
2026-09-24 tourney otpu_mxu: Let the DSP48 post-adder make the first adder-tree level (pair sums of packed products)
    area -13.1% at 123 MHz (>= 110)
    Slot r20260924-034118-s1, agent claude, eval yosys.
2026-09-24 DMA: LD write address kept in a register (tm + rw - dw), off the TMEM arbiter path
    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
2026-09-24 tourney otpu_vpu: Lane-level fold: level 2 runs on the level-1 adders (-2 fadds, same latency) + FF-fed RSUM loop/tree operands
    area -1.9%, fmax +0.6% (109 -> 110 MHz, below target)
    Slot r20260924-034325-s1, agent claude, eval yosys.
2026-09-24 tourney otpu_mxu: Size the dot-product result (s4) and its int->fp32 conversion to the exact SW = 16 + clog2(D) bits, with an i2f that has no rounding step
    area -1.5% at 123 MHz (>= 110)
    Slot r20260924-035327-s1, agent claude, eval yosys.
2026-09-24 TMEM: merge each write port's lanes from the requests, the grants only at the last level
    The full-board path ran grant -> every lane's write enable -> a 7-deep AND-OR chain -> the
    BRAM write address. Each port's lanes are now merged per bank without the grant (a port is one
    unit, its lanes hit distinct banks) and the ports are combined by their grants (the arbiter
    admits one granted writer per bank).
    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
2026-09-24 tourney otpu_mxu: Drain control off the carry chains: MW-bit drain column counters + RMAX kept as ordered keys
    fmax +8.1% (123 -> 133 MHz), area -0.6%
    Slot r20260924-040207-s0, agent claude, eval yosys.
2026-09-24 tourney otpu_vpu: Cut the two stacked critical paths together: fixed end taps for the long-lane results + a LUT-free squarer operand (raw significand, `sq` meta bit)
    area -1.2% at 120 MHz (>= 110)
    Slot r20260924-041000-s0, agent claude, eval yosys.
    [otpu_vpu.sv]
2026-09-24 DMA: LD TMEM writes registered, done one cycle later
    The full-board path ran from the AXI adapter's response FIFO state through b_rvalid into the
    DMA's TMEM write request, the arbiter (the DMA outranks every unit), the grants and the VPU's
    clock enables. The write lands one cycle after its data; the LD's done follows it.
    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
2026-09-24 tourney otpu_vpu: Take the SRL clock-to-out off every lane adder's `c` operand: a sync reset on `rc` breaks the rc→u_c shift chain
    fmax +7.9% (120 -> 130 MHz), area +0.7%
    Slot r20260924-042251-s0, agent claude, eval yosys.
    [otpu_vpu.sv]
2026-09-24 tourney otpu_vpu: RSUM/RSSQ partial loop on the lanes' slot-0 multiply-add, now that `c` leaves a flip-flop
    area -13.1% at 131 MHz (>= 110)
    Slot r20260924-043342-s1, agent claude, eval yosys.
    [otpu_vpu.sv]
2026-09-24 slice: mask arbiter as pairwise conflicts + single-bit priority
    Same grants as accumulating the admitted groups' banks in priority order; the per-bank
    reductions leave the priority chain.
    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
2026-09-24 tourney otpu_vpu: Fold the RSUM/RSSQ tree's three lane levels onto two adders (5 lane fadds -> 2)
    area -4.1% at 131 MHz (>= 110)
    Slot r20260924-044504-s1, agent claude, eval yosys.
2026-09-24 tourney otpu_vpu: Fold-tree adder operands: at most one 2:1 mux after an adder output (level-2 row fold moved to the free residue 0), plus 20-bit TMEM addresses and narrow lane-tap meta
    area -1.8% at 133 MHz (>= 110)
    Slot r20260924-045712-s0, agent claude, eval yosys.
2026-09-24 coll: a registered write stage (the TMEM read data does not reach the write port in one cycle)
    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
2026-09-24 quant: the write-stage delay line ends in a flip-flop (no SRL clock-to-out into the ACT RAM write)
    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
    [otpu_quant.sv]
2026-09-24 docs: observability contract (register map v2, free-running counters, hardware trace)
    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
2026-09-24 README rewrite with the Lens floorplan GIF; lens: speed deep-link param
    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
2026-09-24 host: opentpu/host package, otpu-smi, otpu-lens (hardware trace), device lock and status file
    - opentpu/host: board (driver), checks, regs (register map v1/v2), runstate (flock on
    /tmp/otpu/<dev>.lock naming the holder's pid; atomic status file /tmp/otpu/<dev>.json),
    fake (FakeTransport with register map 2), power (Vivado report_power text/XML ->
    power.json, and the estimate), smi, hwlens, selftest, chat. host/ is a shim
    (host.board is opentpu.host.board); tools/chat.py and tools/board_selftest.py wrap the
    package. Console scripts otpu-smi, otpu-lens, otpu-selftest, otpu-chat.
    - Driver: Board.info (REGMAP, CAPS, CORE_KHZ, BUILD_ID, temperature), snapshot (SNAP +
    64-bit shadows),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
    [board.py, chat.py, checks.py, compiler.py, fake.py, hwlens.py, power.py]
2026-09-24 board: register map v2, free-running counters, hardware trace, die temperature
    otpu_ctrl decodes 12 address bits: REGMAP, CAPS, CORE_KHZ, BUILD_ID, TEMP, SNAP, twelve
    64-bit free-running counters with snapshot shadows (0x100..0x15F) and the trace registers
    (0x200..0x214, TRACE_CTRL bit3 BUSY). otpu_trace records the slice's trace events as 64-bit
    records (docs/observability.md) in a 16384-record block-RAM ring; opentpu/hwtrace.py rebuilds
    the simulator's +trace lines from them. The slice exports its activity and trace events (perf_t,
    a cycle late, from flip-flops); the H/P/Q counters are synthesizable and the simulator prints
    the trace from the same signals, in a fixed order within a cycle.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
    [board.py, hwtrace.py, otpu_bd_wrapper_stub.sv, otpu_board.sv, otpu_ctrl.sv, otpu_mxu.sv, otpu_pkg.sv, otpu_quant.sv]
2026-09-24 trace: count a cycle's events with adds (no $countones); docs touch-ups
    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
2026-09-24 host: drop the host/ and tools/ shims; opentpu.host and the otpu-* commands are the only entry points
    host/board.py, host/checks.py, tools/chat.py, tools/board_selftest.py and tools/lens.py are
    gone (with lens.write_report and the generic 'lens' script); setup_pcie.sh moves to
    opentpu/host/. Tests, docs and comments point at the new paths. docs/status: v0.3 synth.
    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
2026-09-24 Address review: fix rst_core reset polarity, current perf numbers, honest README
    - bd.tcl: rst_core's ext_reset_in took the MMCM locked signal as an active-high reset, which
    would hold the core in reset on hardware. C_EXT_RESET_HIGH 0; check_offline.py (make lint)
    now requires every proc_sys_reset to state its polarity.
    - README: say plainly that this is a simulation-only prototype; current RTL efficiency
    (attention 78-83%, not ~98%, since the VPU split); yosys numbers are accelerator logic only
    (no XDMA/MIG) and estimates; tok/s is a projection; what the board model does not cover.
    - Accuracy: W8A8 greedy decoding diverges from HF fp32 on 6 of 8 prompts at near-ties; a
    float64 int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
2026-09-24 README: board-model limits without the reset-bug anecdote
    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
2026-09-24 README: measured numbers at the board configuration on Qwen3-0.6B shapes; 16-entry window
    The table was from the larger design configuration (2 slices, 8 MXU columns, 16 lanes,
    32-entry window), which is not what the board builds. WIN 16 vs 32 changes these by <2%.
    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
2026-09-25 Board: 100 MHz bitstream closes timing on the xc7k480t (PCIe Gen1 x8, 2x DDR3-800)
    First real Vivado 2026.1 implementation of the YPCB-00338 build, all constraints met:
    WNS +0.082 ns, WHS +0.016 ns; 187,852 LUT (62.9%), 635 BRAM36, 267 DSP.
    RTL timing fixes, cycle-identical on Qwen3-0.6B:
    - TMEM: selected writes are registered and land a cycle later; reads of a word still in
    that register take it (bypass); block RAM read enables come from the requests.
    tb_tmem checks it against a reference model under random traffic.
    - MXU: registered remaining-work counter (c_left); FIFO data and scales in block RAM.
    - otpu_axi_dram: 128 read beats in flight per channel (was 64): the decode stays at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
    [otpu_mxu.sv, otpu_tmem.sv, smi.py, tb_tmem.sv]
2026-09-25 LFM2.5-230M as a second model (ISA simulator, RTL, board model, card)
    LiquidAI LFM2.5-230M runs next to Qwen3-0.6B with no ISA or RTL change: 14 layers
    (8 gated short-conv, 6 GQA attention), head_dim 64 padded to 128 (q and cached K/V),
    the conv state in a 3-slot fp32 ring in DRAM, and a hybrid layer loop (c + 6 x (c, A) + c).
    - opentpu/llm/lfm2.py; the Qwen3 Engine and Image are now model-generic (the Qwen3
    programs assemble identically).
    - otpu-chat / otpu-selftest / compare_hf.py / perf_qwen.py / bench_llm.py take
    --model qwen3|lfm2; otpu-selftest --qwen DIR became --model DIR.
    - otpu-chat uses each model's sampling defaults (LFM2: temperature 0.1, top-k 50,
    repetition penalty 1.05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
    [board.py, chat.py, compiler.py, hwlens.py]
2026-09-25 board.md: MCOLS=4 VPU_CL=4 closes timing at 100 MHz (WNS +0.003 ns, 70.9% LUT, 443 DSP)
2026-09-25 DMA: request each DRAM chunk once (LD chunk buffer, ST gather)
    LD requests every chunk it touches once into a 32-chunk block-RAM buffer (slots reserved at
    request) and delivers it to TMEM one W-word segment per cycle; ST gathers a chunk's segments
    and writes it once, word-masked. Previously every segment cost a whole port-B chunk request
    (4x at D=128, LANES=8). Same results; directed test_dma_alignment_stress (alignments, partial
    segments/chunks, buffer wrap, AXI stalls). profile.py counts LD/ST port-B transfers in chunks.
    Board RTL, bw 80: Qwen3 2 layers pos 128 1914915 -> 1905923 cycles, LFM2 928860 -> 924090;
    1 MiB LD+ST through TMEM 75052 -> 66890 cycles, DMA port-B requests 71732 -> 16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
    [otpu_dma.sv, profile.py]
2026-09-25 VPU: RDOT, OUTER and LOG2 for linear-recurrence models (proposal A, Tier 1)
    RDOT (func 19): isum_64 of A*B, B in any bmode; RSSQ keeps its encoding (RDOT with B = A).
    RDOT holds up to 256 row sums and writes them after the last row, so it runs beside a DMA LD.
    OUTER (func 6): dst = dst * D + B(r) * C(c) in place (D scalar, per column or 1.0), column
    vectors buffered per lane; slot 0 becomes a*b + c*e (otpu_fmma, e = 1.0 otherwise). VOP w7 is
    register-relative (+R[rd]); the scoreboard tracks OUTER's column-vector range.
    LOG2 (func 15): degree-8 Horner composite on the CL lanes, within 2.3 ulp.
    Language: x @ v (RDOT), ol.sum(a * b) -> RDOT, ol.outer(x, y, acc=, decay=), ol.log2,
    lib.softplus,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
2026-09-25 board.md: 4&4 with the DMA chunk buffer and the new VPU ops closes timing at 100 MHz (WNS +0.028 ns)
2026-09-25 Qwen3.5-0.8B as a third model: Gated DeltaNet state streamed through TMEM, gated attention (ISA simulator, RTL, board model)
    The tournament baseline on the existing ISA and RTL (eb29dd3): 11.5 M cycles per token on the
    board configuration (80% bandwidth, context 128), 69% of the DRAM roofline; the DeltaNet
    recurrence is VPU-bound and takes half the token (docs/qwen35.md). Without a logarithm, softplus
    is max(x, 0) + log1p(2^(-|x| log2 e)) with log1p a degree-8 polynomial.
2026-09-25 Qwen3.5: the DeltaNet layers on RDOT / OUTER / LOG2 (87.6% of the DRAM roofline)
    The layers call kernels/deltanet.py's head_step (3 passes over each head's fp32 state instead
    of 7) and softplus uses LOG2; the port's own outer-product, in-place and scalar-broadcast
    compiler additions are dropped (the new ops cover them).
    Measured on the RTL at the board configuration (bit-exact vs the ISA simulator), 80% DRAM
    bandwidth, context 128: 9,130,829 cycles/token, 87.6% of the roofline, 11.0 tok/s at 100 MHz
    (was 11,535,257, 69.3%, 8.7 tok/s). The DeltaNet mixer is 3.41 M cycles (was 5.83 M) and
    still VPU-bound (busy 96%): about half is the per-head small vector ops. HF greedy: 5 of 8
    chat prompts i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
2026-09-25 rtlsim: reject short DRAM/TMEM dumps; perf_qwen: refuse --pos at or past --cap (default cap above pos)
    A truncated simulator dump (e.g. a full disk) used to read as zeros and look like an RTL vs ISA
    mismatch; a position at or past the KV capacity writes the cache out of bounds and does not
    match the ISA simulator by construction (it made Qwen3 at pos 1023 with the default cap 256
    report a mismatch).
    [rtlsim.py]
2026-09-25 Board: RPB covers every read lane (8 x LANES), so LANES=16 keeps the shallow write-mask TMEM arbiter (RPB 64 fell back to the per-bank counting arbiter: a 109-level path)
2026-09-25 TMEM: the quantizer's row-factor port and the collective's read port share the DMA's copy (6 copies instead of 8: -128 BRAM36, a quarter less TMEM wiring); cycles unchanged
2026-09-26 board.md: the measured builds had the MXU chunk FIFO in distributed RAM (fixed in 54045fa)
2026-09-26 board.md: the default build of 3c270c9 closes timing at 100 MHz (WNS +0.065 ns, 61.7% LUT)
2026-09-26 host: configuration from the bitstream's VERSION register (device_config), selftest vops stage, bring-up doc and script fixes
    - opentpu.host.board.device_config(info): board_config with MCOLS / LANES from VERSION; OTPU_MCOLS /
    OTPU_LANES, when set, must agree (ConfigMismatch names both). selftest, otpu-chat --backend board
    and otpu-lens record use it; BoardBackend's own check raises ConfigMismatch; the unused
    BoardBackend.config is gone. sim_config takes the base configuration (the ISA reference of the
    selftest model stage now follows the card's).
    - SimTransport builds the board model with LANES, VPU_CL (default 2, as make bit) and ULANES 8 as
    the bitstream does (tb_board passes UL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
    [board.py, chat.py, checks.py, hwlens.py, isasim.py, tb_board.sv, test_board.py]
2026-09-26 board.md: the primary bring-up image (build/deploy_default_3c270c9) in the bitstream table
2026-09-26 board.md: LANES=16 does not route on the xc7k480t (congestion level 6, measured)
2026-09-26 otpu-diag: the full hardware diagnostic (every check, no stopping, a works / does-not-work matrix, diagnosis hints, JSON)
    - opentpu/host/diag.py: platform (PCIe link, driver, ID, configuration, per-channel calibration,
    STATUS errors, temperature, power estimate), regs (68 write / read patterns per RW register,
    read-only sanity, SNAP and counters), mem (per channel: walking 1 / 0 over the 512-bit beat,
    address bits, random blocks, partial writes, DMA bandwidth; the interleave; --mem full march
    C-), isa, system (demo, masked writes, vops, cycle counters, --soak N), model (--model).
    A check whose prerequisite failed is SKIP with the reason; exit 1 on any FAIL.
    - opentpu/host/opchecks.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
    [checks.py, diag.py, opchecks.py, test_board.py]
2026-09-26 board.md: 4&4 build of 550aa35 meets timing (WNS +0.086 ns, 179K LUT), replaces the ddec900 4&4 image
2026-09-27 First light on the card (build 74d48591): Qwen3-0.6B token for token with the ISA simulator; host fixes found at bring-up
    - XdmaTransport: register access as one 32-bit load / store (a slice of the mmap is copied
    byte by byte in CPython 3.14: four 1-byte AXI-Lite writes, otpu_ctrl kept the last byte);
    DMA reads with lseek + readinto, not preadv (the XDMA driver's read_iter queues every request
    as asynchronous I/O: kernel 7.1 BUG in do_iter_readv_writev, then a NULL completion oops).
    - Board.scrub: zeros over the whole DRAM once per configuration (SCRATCH = DRAM_INIT marks it).
    With ECC the check bits are random after power-up and a read of a never-written beat hangs
    (DMA timeout).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
    [board.py, checks.py, diag.py, regs.py]
2026-09-27 board.md: first light on the card, measured (all three models token for token; decode 3.2x the simulated cycles, port B single-beat reads)
2026-09-27 otpu-smi 0.2.0: nvidia-smi style layout (device box with column headers, utilization table, processes table; bus id, PCIe generation)
2026-09-27 AXI read bursts on port B: contiguous chunk reads go out as INCR bursts of up to 8 beats per channel (not across 4 KB)
    On the card, single-beat reads reached 0.23 beats/cycle per channel (per-transaction cost in
    SmartConnect / the MIG AXI front end); decode was 3.1-3.3x slower than simulated.
    - otpu_axi_dram: a queued B read that continues the previous one (next chunk, same channel page)
    joins its run; a run issues at 8 beats, when the next queued request breaks it, after 4 idle
    cycles, or at once with no B read in flight. Response room is reserved per beat (<= RD). An
    AR shown on the bus is held until taken. Request queues 4 -> 16 (same LUT RAM).
    - otpu_axi_mem (sim): read bursts (rl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
    [otpu_board.sv, otpu_top.sv, rtlsim.py, tb_board.sv]
2026-09-27 otpu-smi 0.2.1: labelled rows per device (value next to its label), utilization bars, process lines
2026-09-27 otpu-chat: full-screen Textual interface with live TTFT, prefill/decode tok/s (wall and device), KV context, DRAM and session totals; --plain keeps the REPL; per-turn metrics in one Turn dataclass
2026-09-27 otpu-chat: no Mcycles/token without a device clock (ISA backend)
2026-09-27 otpu-chat TUI: hand tokens to the interface without blocking the generation thread (merged updates via call_next); KV under 10 MiB with decimals
2026-09-27 otpu-smi: the power estimate uses the Vivado report of the loaded bitstream (build/*<BUILD_ID>*/reports/power.json)
2026-09-27 otpu-chat TUI restyled after Claude Code: one column on the terminal's background, header box, accent bullet replies, spinner line, rounded input, one width-adaptive status line (TTFT, prefill/decode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
    [chat.py, chat_tui.py]
2026-09-27 otpu-chat TUI: do not override App._flush and App._loop (a print during a run crashed the app); test that ChatApp's private methods do not shadow App's
    [chat_tui.py]
2026-09-27 bd.tcl: PCI identity -- class 12 00 00 (processing accelerator, not a 16450 UART), subsystem 10ee:4f54, revision 01; device ID 7028 kept
2026-09-27 MXU_STARVE counter (register map 3); AXI_BL knob for single-beat vs burst reads in the sims
    - otpu_ctrl: free-running counter 12, MXU_STARVE at 0x160: cycles the MXU streams a command and
    its chunk FIFO is empty (the Q line's ms, now also perf_t.starve). DRAM_WAIT counts only
    requests the adapter has not taken and stays ~0 while the MXU waits for data. REGMAP 3.
    - host: regs.counters(regmap) (MXU_STARVE from version 3); snapshots, rates, otpu-smi (stall
    row: MXU-starve), diag and the fake card read what the bitstream has; version 2 still works.
    - otpu_top / otpu_board / tb_top / tb_board: AXI_BL parameter (port B read burst, default 8);
    perf_qwen --bl.
    - tests: MXU_STARVE on the boar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
    [board.py, diag.py, fake.py, otpu_board.sv, otpu_ctrl.sv, otpu_pkg.sv, otpu_slice.sv, otpu_top.sv]
2026-09-27 otpu-setup: setup_pcie.sh installs the pinned XDMA driver (patched for kernels >= 6.13, DKMS when present, updates/ over the in-tree xdma), the udev rules and the driver mode; --check, --rescan (no a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
2026-09-27 XDMA interrupt mode by default (measured solid now that the DRAM is scrubbed: selftest, diag, full march + soak, models; same tok/s, +5 us per call, ~1 core less than polling); tools/dma_bench.py; re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
2026-09-27 docs: host setup around otpu-setup (distributions, DKMS, name clash, PCI identity, poll vs interrupts measured), board bring-up checklist, JTAG cables (FT232H digilent_hs2, Platform Cable), flash path
2026-09-27 ypcb-00338: DDR3-1333 and DDR3-1600 MIG configurations
    gen_mig_prj.py takes CL / CWL / VCCAUX_IO per speed (MT41K256M8-125 speed bins: 1333 CL9/CWL7,
    1600 CL11/CWL8); both use the 200 MHz MMCM output as the MIG input. 1600 needs VCCAUX_IO 2.0 V
    per MIG's -2 FFG HP table. 800 and 1066 .prj output unchanged.
2026-09-27 chat TUI: the spinner timer returns when the screen is gone (a tick during app exit raised NoMatches)
2026-09-27 ypcb-00338: DDR3-1333 from a 333.333 MHz MIG input (MMCM VCO 1000); drop the VCCAUX_IO option
    The DDR3 banks are HR banks: VCCAUX_IO does not apply, and MIG's HR limit (tCK >= 1875 ps at
    1.5 V) puts both 1333 and 1600 outside its supported range (critical warning 79-155). MIG
    rejects a 200 MHz input at 1333 (79-144, rounds to 205.128); 333.333 MHz is accepted as is.
    The MMCM's third output (clk_mig, VCO / 3) is the MIG system clock at 1066 and 1333.
2026-09-27 ypcb-00338: out-of-spec DDR3-1333 and 1600 builds
    1333: MIG input 333.333 MHz from the MMCM at VCO 1000 (clk_mig = VCO / 3; core 100 MHz = /10).
    1600: 200 MHz input, PLL x8, CL11 / CWL8. At tCK <= 1500 ps MIG's byte groups use
    IDELAYE2_FINEDELAY, a black box in this design (DRC INBB-3); build.tcl patches the generated PHY
    to IDELAYE2 for those speeds only and prints a critical warning. 800 / 1066 / 1300 unchanged.
2026-09-27 docs: out-of-spec DDR3-1300 / 1333 / 1600, the MIG PHY patch, the DDR3 voltage question
2026-09-27 otpu-chat: a turn's prompt runs through Engine.prefill_chunks; the Engine compiles the next prefill chunk (after the last one: the first decode step) while the device runs the current one; selftest m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
2026-09-27 Device lock: OTPU_LOCK_WAIT makes runners wait for a busy card; otpu-lock -- CMD holds the lock around a JTAG / driver reload (pgrep waiters matched each other and deadlocked at bring-up)
2026-09-27 tools/decode_profile.py: timeline of otpu-chat's per-token host work (program upload, run vs device cycles, poll overshoot, logits read, sampling, detokenize, UI; compile thread)
2026-09-27 Host overhead per token: compile the next program only after the card started (the compile thread starved the program upload of the GIL: 16-39 ms/token), poll with the previous run's time as a hint, 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
2026-09-27 I2C pins: open-drain I2C_CTRL / I2C_IN (0x220 / 0x224, CAPS bit2) on the LM73 bus and the PCIe SMBus; host bit-bang master (read only), otpu-i2c, otpu-diag i2c section, otpu-smi measured power via PM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
2026-09-27 host: take the device lock before opening the XDMA files
    A process waiting for a busy card (OTPU_LOCK_WAIT) held h2c/c2h/user open while it
    queued, which made otpu-setup --rescan by the lock holder refuse. XdmaTransport now
    takes the DeviceLock first and gains close().
2026-09-27 board.md: DDR3-1300 passes the full-memory soak and the three model token checks
2026-09-27 board.md: DDR3-1066 (in spec) passes soak and model checks, -18 to -22% cycles/token
2026-09-27 Engine: on the board, compile the next program in a spawned worker process (a 10-30 ms trace in a thread competed with the step's host work for the GIL); hwlens keeps the thread (it needs the program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
2026-09-27 docs: PCI identity and I2C verified on the card (b11bb679); no power monitor on the card's buses
2026-09-27 DDR_MTS register: the DDR3 data rate of the build, shown by otpu-smi / selftest / diag
    otpu_ctrl 0x54 DDR_MTS (RO, build parameter from create_project.tcl's DDR_SPEED), announced by
    CAPS bit3 so no register map bump: older bitstreams leave the bit clear (and read 0xDEADBEEF
    at 0x54), and the host reports the speed as unknown. otpu-smi's DDR3 row reads
    "DDR3-1066 ch0 ok ch1 ok"; the selftest and diag config lines add ", DDR3-1066"; diag's
    read-only check bounds it. The board model has none (DDR_MTS 0) unless a test sets it.
2026-09-27 Sampler: top-k on the float32 logits over a block-max prefilter (picks as the float64 argpartition path; ties fall back to it), seen tokens kept incrementally; measured on the card 0.66/0.67/1.13 -> 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
2026-09-27 board.md: DDR3-1066 wall vs device tok/s with the 7f9cec1 host (96-97%)
2026-09-27 board.md: DDR3 supply measured at 1.5 V; DDR3-1066 is in spec
2026-09-27 board.md: DDR3-1600 not pursued (1333 already fails on the card)
2026-09-27 DDR3 model: controller clock in ticks (+axi_tpc / +axi_tpu: DDR3-1066's 133 MHz ui_clk), +axi_afree what-if; perf_qwen prints MXU blocked cycles
2026-09-27 board: ACT_ROWS build parameter (make bit ACT_ROWS=8), the ACT_ROWS register (0x58, CAPS bit4), the host's device_config follows it
2026-09-27 board: keep the MIG projects as generated for the default DDR rate
2026-09-27 board.md: e58ecb65 (ROW_BANK_COLUMN + gathered QST writes) measured: Qwen3 6.49 (-24%), LFM2 2.33 (-26%), Qwen3.5 8.44 (-29%) Mcycles/token at DDR3-800; the bank model's projection and fit
2026-09-27 host CLIs: a busy card ends otpu-chat / -selftest / -diag / -lens with one line naming the holder and OTPU_LOCK_WAIT (exit 3), not a traceback
2026-09-27 ACT_ROWS capability is CAPS bit6 (bit4 / bit5 are the fp4 work's 4-bit MM / PAIR); the register in docs/observability.md; device_config keeps ACT_ROWS 0 on a bitstream without replay; host / observab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
2026-09-27 host DMA: buffers placed for full speed (writes need host - card = 0 mod 64, reads not within 16 B of it mod 4096: 0.77 -> 1.5 GB/s, scrub 5.6 -> 2.6 s), pipelined Board.write/read; XdmaTransport sen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
2026-09-27 MXU: sub-block sum and multiplier in one stage (the pair-field bias moves into the group sums): the tree is two stages longer than int8's instead of three; docs/quant.md, quant_eval --report
2026-09-27 CAPS bit2: the MXU runs 4-bit weights; the board backend refuses a 4-bit image on an older bitstream; otpu-chat --wformat / --head-format; test_perf small-batch MLP pin 0.92 -> 0.915 (two more MXU st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
2026-09-27 bd.tcl: core_clk FREQ_HZ truncated as clk_wiz reports it (112.28 MHz failed BD validation by 1 Hz)
2026-09-27 CAPS: the 4-bit MM capability is bit4 (main uses bit2 for I2C and bit3 for DDR_MTS)
2026-09-27 MXU: only PAIR MMs pass through the pair adder (4 stages); int8 and half-rate 4-bit MMs keep their latency (the MLP perf pins: 94.1% -> 94.5%, 91.5% -> 91.9% of roofline)
2026-09-27 AXI adapter: SW queue 16 -> 64 beats per channel (WQD; its slots, beats and read data in LUT RAM), read-after-write hazards by per-bucket counters of the live beats past the read point instead of a C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
2026-09-27 ACT RAM: writes registered (bytes in place, row selects), landing a cycle later; the quantizer reports done a cycle after its last write. Its grant -> lane placement -> block RAM DI path (6 LUT level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
    [otpu_actram.sv, otpu_quant.sv]
2026-09-27 Slice: a reset register per unit (DMA, MXU, QUANT, VPU; max_fanout 256): the board's replicated core_rst ran 8.4 ns routes into the MXU and quantizer at 114 MHz
    [otpu_slice.sv]
2026-09-27 Compiler: a quantized operand of several MCOLS chunks holds each chunk's ACT blocks as it allocates them (a later chunk could wrap onto an earlier one: 'stationary operand was overwritten' at 8 prefi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
    [checks.py, compiler.py]
2026-09-27 README: openTPU runs on the card; measured decode on the production image (LFM2 40.7 / Qwen3 14.6 / Qwen3.5 10.3 tok/s device at DDR3-1066, 100 MHz), the Vivado build, and a recording of otpu-chat wi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
2026-09-27 TMEM: the registered write stage (pw_v / pw_a / pw_d) replicated by synthesis (max_fanout 16): at 120.755 MHz (met, WNS +0.080) its nets to the copies' block RAM address pins were the worst core_clk 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
2026-09-27 VPU WBUF (board arbiter): the TMEM grant only takes the head of a two-entry write buffer; the lanes, the tree and the issue advance on a registered enable (buffer room, max_fanout 64) instead of the 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
    [otpu_slice.sv, otpu_vpu.sv]
2026-09-27 DMA: LD chunk buffer 32 -> 128 chunks: a 32 KB state LD beside MXU streaming was latency-bound at ~3.5 words/cycle (2.3K cycles); now 1.2K (Qwen3.5 fp4 DeltaNet layer, DDR3-1066 bank model, simulated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
2026-09-27 DRAM efficiency: bytes a token moves / (its time x the DDR3 peak, 17.07 GB/s at 1066), next to the core-port efficiency; perf_qwen --ddr MTS --mhz F runs the card-calibrated DDR3 bank model at that r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
2026-09-27 Long contexts: decode programs compiled two positions ahead on two worker processes (LFM2's trace at position 1900 is 30-33 ms on a busy host, over its 27 ms run); otpu-chat's interface holds its CPU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
2026-09-27 otpu_vtree: the VPU's RSUM/RSSQ/RDOT folding tree as its own module (unchanged logic), so the DMA's DeltaNet step can reuse it
2026-09-27 Hashed channel interleave (CHASH, CAPS bit7): chunk m's two beats swap channels when m has odd parity, so a column at a power-of-two stride (the transposed V cache) is spread over both channels; adap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
    [board.py, checks.py, otpu_board.sv, otpu_ctrl.sv, regs.py, test_board.py]
2026-09-27 Slice: unit resets replicated at max_fanout 64 (was 256): rst_vpu -> the VPU lanes' c registers had 0.25 ns slack at 125.49 MHz
    [otpu_slice.sv]
2026-09-27 DSTEP: one Gated DeltaNet head step run by the DMA on the DRAM state (ISA, sims, compiler, RTL, host)
    The DMA streams a head's fp32 state from DRAM through a datapath (rtl/dma/otpu_dstep.sv, 8 lanes)
    and back in place: kv = RDOT(St, k), d = beta (v - e kv), St = OUTER(St, e, d, k), o = RDOT(St, q),
    bit-identical to the VOP sequence it replaces. The state never enters TMEM, so the VPU drops its
    3 state passes and TMEM its 16K-word loads.
    - isa/isasim: DSTEP = 0x12 (flag ZERO), Config.DSTEP (OTPU_DSTEP); tests vs the VOP sequence and
    float64. compiler/language: deltanet_step, has_dstep. qwen35: _deltanet_dstep when the config has
    it, the VOP path otherwise (older bitstreams).
    - RTL: otpu_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
    [board.py, compiler.py, fake.py, isa.py, isasim.py, language.py, lens.py, otpu_ctrl.sv]
2026-09-27 Streamed logits: the host reads the LM head's 32 KiB chunks while the run goes on (a sentinel word the device never stores marks the unwritten ones; the last beat is probed from 0.3 ms before last to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
2026-09-27 Host critical path: decode_profile measures HALTED seen -> next RUN per token, split into its steps with every transport operation filed as critical or overlapped (no copies of Board.start / wait; --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
2026-09-27 XdmaTransport.streams: the card streams the logits (the flag was missing: only the test cards streamed)
    [board.py]
2026-09-27 otpu-selftest vops stage: after the vops program, otpu-diag's reduction and RDOT / OUTER / LOG2 op checks back to back (12 programs, each result read right after it): a 125 MHz build passed the vops 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
2026-09-27 Revert "Merge branch 'fmax-vgrant' into integ"
    This reverts commit f7d608b430cbf0668ca3e9177df8b0e0418870f0, reversing
    changes made to d1a49da7c98acc2c3a9319299aeb7130c1407191.
    [otpu_slice.sv, otpu_vpu.sv]
2026-09-27 README: rewrite around the project's goal (an AI accelerator developed by AI), a learning monorepo, and device decode results; plain-text stack diagram instead of Mermaid
2026-09-27 MXU: the row registered before the result FIFO (u_c's output ran into the FIFO's LUT RAM in one cycle, 0.19 ns slack at 125.49 MHz). Qwen3 2-layer decode 1660628 -> 1660721 cycles (simulated); small-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
2026-09-27 otpu-selftest vops stage: wrong RDOT / OUTER / LOG2 results fail on a bitstream that has them (register map >= 3, which came after ddec900) instead of passing as 'built before them' (the vg125 image 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
    [checks.py, diag.py, regs.py]
2026-09-27 README / docs/board.md: production image deploy_prod120_b01b8acb (120.755 MHz, DDR3-1066) measured on the card: Qwen3 19.1 / LFM2 52.4 / Qwen3.5 14.4 device tok/s, diag and warm soak pass; the 100 MH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
2026-09-27 Collective: the read stage's TMEM address (rrow + c) and lane mask registered with c and rrow (c -> TMEM block RAM address had 0.24 ns slack at 125.49 MHz)
2026-09-27 Hardware trace: the slice's events registered once more on the way in (with the enable; busy covers them): the sequencer's start-event ready-cycle lookup ran into S0 with 0.27 ns slack at 125.49 MHz
2026-09-27 V^T cache in tiles of 256 tokens (KVDesc, VT_TILE: the attention block) when the capacity is a multiple of 256: P.V of a block streams one contiguous 32 KB tile in full bursts instead of 128 separate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
2026-09-27 Resident decode programs: the token and position as run arguments (ARG0..7 -> R8..R15 at the start), one program per 256-token attention bucket (the last block masked by a table row at -4 x position)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
2026-09-27 Resident decode on the board model: SimTransport starts every flush from reset (keeps_state False), so BoardBackend loads the program and writes every ARG word each run there; perf_qwen --resident
    [board.py]
2026-09-27 Resident decode: CAPS bit24 in the host tests (info caps, the board model's CAPS and an ARG register read back), decode_profile's test on the resident path; docs: FakeTransport critical path 0.215 vs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
2026-09-27 README / docs/board.md: 4-bit weights measured on the card (fp4f125 test image, 125.49 MHz, full-rate MXU): Qwen3 28.0 (int8 head) / 32.8 (all fp4) and LFM2 77.6 / 94.1 device tok/s, token-exact vs t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
2026-09-27 Qwen3.5 chunked prefill with DSTEP: a DSTEP per row and head instead of the VPU recurrence, and the pairs software pipelined (the next pair's projections stream while a pair's DSTEPs run). Bit-exact 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
2026-09-27 test_perf: MLP decode pin 0.945 -> 0.94 (the VPU write buffer and the MXU row register: 26082 -> 26114 cycles, 94.5% -> 94.4%)
2026-09-27 Poll: sleeps past the expected end proportional to the lateness (20 us .. 1 ms), the expected run time calibrated against the seen run times (CORE_KHZ vs the clock), no sleep once the streamed wait s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
2026-09-27 Build flag DSTEP=0 (run_vivado / create_project -> otpu_fpga_top / otpu_board DSTEP -> slice / DMA HAS_DSTEP): the DMA's DSTEP datapath left out, CAPS bit6 = 0 (the host then compiles DeltaNet steps 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
2026-09-27 board.py: drop the unused subprocess import
2026-09-28 Streamed wait: HALTED read after every sleep slice (a piece time learned on a delayed token may lie past the run's end: 2.2 ms overshoot on the busy card host); COMPILE_AHEAD 3 (per-position programs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
    [board.py]
2026-09-28 Reapply "Merge branch 'fmax-vgrant' into integ"
    This reverts commit 401c5908189fe1348fe4713975b7fc4b056b73a3.
    [otpu_slice.sv, otpu_vpu.sv]
2026-09-28 README: results on the production image deploy_prod120fp4_ea3bc560 (120.755 MHz, 4-bit MXU): decode device/wall, 512-token prefill and DRAM reads from the card's counters for all three models at int8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
2026-09-28 docs/board.md: production image deploy_prod120fp4_ea3bc560 (fp4-fx ea3bc56, 120.755 MHz, 4-bit MXU with PAIR, RDOT row buffer fix): the card qualification (selftest with op checks, diag cold and warm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
2026-09-28 Streamed logits: the tail after HALTED goes to the sampler in one feed; greedy sampling skips the block maxima (top-k only)
    [board.py, chat.py]
2026-09-28 test_perf: MLP decode pin 0.945 -> 0.94 (the 120 MHz image's WBUF and MXU row register cost this small kernel 0.06 points: 94.44%)
2026-09-28 tools/omarchy_test.sh: run pytest for the current worktree on omarchy (tree shipped with tar, models linked, Verilator 5.046 in ~/.local, at most 3 concurrent runs, niced) to keep test load off the M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
2026-09-28 tourney: test gates on omarchy (EXEC=remote, default) through tools/omarchy_test.sh
    tools/omarchy_test.sh --exec runs any command in the shipped tree (venv + Verilator 5.046 on
    PATH); OTPU_REMOTE_NAME names the tree, OTPU_REMOTE_BUILD shares a Verilator cache. gates.py
    dispatches lint / fast / board / perf (and the sync's fast tests) through execute(): remote argv
    with the board env via env, or local as before (EXEC=local); fcntl slot locks cap the tournament
    at 2 concurrent test gates on omarchy (shared with up to 2 Vivado jobs), 1 locally; per-gate
    timing and output tails unchanged. Slot trees are removed with their worktrees and cache
    entries older than a day pruned after each round. Meas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
2026-09-28 HALTED before the last stores land: Board.wait waits for WR_IDLE after HALTED (bounded 2 ms, not on the board model), the streamed tail reads again for up to 5 ms before calling a piece unwritten (th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
    [board.py, fake.py]
2026-09-28 compiler: named values are not temporaries on Python 3.14 (locals load as borrowed references, so the reference count of a named argument equals a temporary's; unnamed() also checks the calling frame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
2026-09-28 docs/board.md: production image deploy_prod120hp_aebb0bf0 (host-path-fx aebb0bf, 120.755 MHz: 4-bit PAIR, r7 DRAM path, replay, resident decode ARG registers, DSTEP, WBUF): qualification, the streame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
2026-09-28 README: results on the new production image (deploy_prod120hp_aebb0bf0, host main): LFM2 4-bit 83.1 device / 80.8 wall tok/s, Qwen3 31.7 / 30.7, Qwen3.5 21.2 / 20.8, decode DRAM reads 72-78% of peak;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
2026-09-28 perf_qwen --dump (the run's Lens profile data, to compare with a card trace instruction by instruction); otpu-lens record --wformat / --head-format
2026-09-28 DDR3 model: +axi_tgap, the data bus's loss per AXI read transaction (1.7 controller cycles fitted on the card at DDR3-1066 / 120.755 MHz: LFM2 4-bit pos 50 1.418 Mcycles card, 1.42 sim); board build 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
2026-09-28 DDR3 model: +axi_wgap (per write transaction); perf_qwen --plus overrides the calibrated plusargs; docs/board.md: the tgap fit
2026-09-28 board build: MIG_BANK_MACHINES / MIG_ORDERING knobs (gen_mig_prj.py --bank-machines / --ordering; defaults unchanged)
2026-09-28 tools: q35_split (decode-step counters of a model cut to its first N layers, on the card), q35_trace (one step instruction by instruction, card trace or RTL + DDR3-1066 model, to JSON), rw_bench (the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
2026-09-28 Qwen3.5 resident decode: Image(lookup=True) and compile_decode (one program per attention bucket, the token and position as run arguments, embedding and RoPE rows from the image's tables); the DeltaN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
2026-09-28 docs/board.md: the tgap fit's Qwen3.5 check with DSTEP, as the image runs it (-2.7% to -3.4%; the DeltaNet layer's write mixing is not modelled yet)
2026-09-28 AXI adapter: a port-B write (DMA ST, DSTEP write-back) drops the scale runs / reused beat only when its chunk is in them; all runs dropped once every B write has its response (test: scale runs beside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
2026-09-28 DDR3 model: +axi_bgap (per read beat); read cost refitted with the card's 16-beat bursts (tgap 1.22 + bgap 0.06 per beat); docs/board.md: BL16 on the card (unqualified image, WNS -0.294): LFM2 1.455 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
2026-09-28 AXI adapter: port A requests registered on the way in (a one-entry register, taken when empty or drained) and the A read data registered on the way out: the grant chain DMA busy -> port arbitration -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
    [otpu_board.sv, otpu_top.sv]
2026-09-28 DMA: DSTEP fill steps registered a cycle ahead (fs_*, from fk + 1; a DSTEP primes step 0 for one cycle): the compare / subtract chain on fk and ds_nq was on the TMEM read address (clk125 at 125.49 MH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
2026-09-28 DMA: ST chunks buffered in the LD chunk buffer and written in runs of SRUN=32 on consecutive cycles (one read/write turnaround per run instead of one per chunk beside the MXU's weight reads); DSTEP R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
2026-09-28 AXI write bursts: port B writes that follow each other on a channel go out as INCR bursts of up to WBL beats (AWLEN/WLAST; one response per burst, counted back by its length); the sim memory model ta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
    [otpu_board.sv, otpu_top.sv, rtlsim.py, tb_board.sv, tb_top.sv]
2026-09-28 BL16 candidate deploy_bl16mx120_be388a1f qualified on the card (docs/board.md: device numbers +4-5%, LFM2 4-bit 87.4 device tok/s, DRAM 81%); poll: back-to-back reads from 1.5 ms + 3% before the expe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
2026-09-28 docs/board.md: LFM2 4-bit +5.1%
2026-09-28 boards/ypcb-00338: AXI_BL defaults to 16, the production image's port B read burst (deploy_bl16mx120_be388a1f), so make bit rebuilds it
2026-09-28 streamed logits: short sleep slices from POLL_EARLY (+ 3%) before the expected end while a piece is awaited, so a run that ends then is seen within ~POLL_MIN_SLEEP (Qwen3 on the card: its next-to-las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
    [board.py]
2026-09-28 tools/qual: the card qualification in the repo (qual.sh fast / full profiles with per-phase times; perf.py prefill + decode counters; refs.py ISA references cached by content -- opentpu sources witho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
2026-09-28 docs/board.md: references on the Mac: the six in 6.4 min, equal to omarchy's
2026-09-28 Production image deploy_bl32mx120_be388a32 (be388a1, AXI_BL=32, WNS +0.066): qualified on the card, the BL16 / BL32 A/B (+1.8-2.6% device), prefill and DRAM (80-84% of peak for LFM2 / Qwen3); make bi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
2026-09-28 README: results on the new production image deploy_bl32mx120_be388a32 (32-beat DRAM read bursts): LFM2 4-bit 89.3 device / 85.4 wall tok/s, Qwen3 34.0 / 33.8, Qwen3.5 22.4 / 22.2; decode DRAM reads 7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
2026-09-28 LFM2 wall: the sampler warmed once when the Chat starts (the first pick of a process took 2-10 ms: numpy's first union1d / top-k / choice), the next pick's begin() after the run's start, the status f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
2026-09-28 docs/board.md: the DDR3 model against the card at BL 8 / 16 / 32, like for like (the resident program at pos 70: within 0-1.3% of decode, 0.1-0.6% of rw_bench); the bgap refit candidates are worse
2026-09-28 tourney: remote test-gate slots follow OTPU_REMOTE_JOBS (default 2), the omarchy_test.sh cap
2026-09-28 docs/board.md: production image deploy_pnbl32_e2521032 (prod-next e252101, AXI_BL=32, AXI_WBL=8, WNS +0.013 ns): qual.sh full on the card (0 FAIL; phase times), decode (Qwen3.5 4-bit 4.899 Mcycles, 2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
2026-09-28 runner status: one writer thread woken by an event instead of a threading.Timer per rewrite (starting a Timer cost the caller 0.1-0.2 ms on the card's host, between HALTED and the next RUN every ~20 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
2026-09-28 streamed logits: near the expected end a piece that is not complete yet is probed again after POLL_MIN_SLEEP, not STREAM_RETRY (0.1 ms: LFM2 on the card saw HALTED 0.15 ms after the run's end on most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
2026-09-28 BoardBackend: the expected run time per program length (the first LFM2 decode run after the prompt was expected to take the prefill chunk's time and was seen 14 ms late: the 0.15 ms per token of 'pol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
    [board.py]
2026-09-28 tourney: area in the full-design score (timing win at <= +1% area, or area_eq -0.5% at WNS >= -0.05 ns; rank by fmax change - area change), per-resource deltas and WINNERS.jsonl; full results cached 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
2026-09-28 docs/board.md, production image deploy_pnbl32_e2521032: the host path with main 59a9f06 (LFM2 4-bit + int8 head, 5 runs: median 88.76 wall / 90.16 device tok/s, token-identical; the other configurati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
2026-09-28 docs/board.md: the fine timing's time and host
2026-09-28 README: results on the new production image deploy_pnbl32_e2521032 (32-beat reads, 8-beat write bursts, stores in runs): LFM2 4-bit 90.2 device / 88.8 wall tok/s (median of 5), Qwen3 34.0 wall, Qwen3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
2026-09-28 Qwen3.5 chunked prefill with DSTEP: a pair's two heads do their VPU work (convolution, SiLU, norms) before their DSTEPs and their outputs after, and a pair's window store follows its DSTEPs (a store 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
2026-09-28 tests: the three real checkpoints in the board's 4-bit configuration (4-bit layers, int8 LM head, PAIR) on MCOLS=2 and MCOLS=4, a token on the RTL through the board's memory path (AXI adapter, boot l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
2026-09-28 tourney runs: MXU round r20260928-113015 (s0 no_gain: WNS -0.431 -> -0.408, Route 35-447; s1 not built); stream Q's MCOLS=4 critical paths and congestion as notes in the lessons of mxu, axi_dram, dma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
2026-09-28 MCOLS=4 timing (b6df595 at 120.755 MHz: WNS -0.114 ns, 96.9% of slices; the worst paths ~97% wire): the DSTEP's o values land in ob a cycle later, through a registered one-hot entry enable and a regi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
2026-09-28 tools/qual/qual.sh: LOAD=0 qualifies the bitstream the card runs, with no JTAG load (REST alone only skipped the final load; on opentpu a hot rescan after a reload does not bring the link back); docs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
2026-09-28 docs/flash.md (draft): the card's BPI flash; over JTAG now with Vivado (boards/ypcb-00338/flash_jtag.sh: detect, backup, program with verify, boot from flash; not run on the card), and a proposal for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
    [bpi_image.py, test_bpi_image.py]
2026-09-28 README, docs/board.md: the card's host. README: the Results table was measured with the card in omarchy (i5-12600KF); on opentpu (i7-4790) the device numbers are the same within 0.3%, the host path a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
2026-09-29 tourney: a round full-builds as many candidates at once as the build hosts have free slots (caps in /tmp/otpu-tourney-hosts less anyone's Vivado jobs; at least one), so both boxes work; the builds th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
2026-09-29 tourney: otpu_dstep (the DSTEP datapath on its own) and otpu_full (whole-design RTL: any rtl/ file, judged by the full build; its prompt lists the files instead of quoting them); every fmax prompt gr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
2026-09-29 tools/qual/qual.sh: every rescan step kept in rescan.log (which link-recovery step brought the card back); the end line counts FAIL lines once (grep -c's exit status printed a second 0)
2026-09-29 docs/litedram.md (draft): LiteDRAM instead of the MIG, assessed. The memory path today is 60.3K LUT / 50.0K FF (2 MIGs, sc_mem, otpu_axi_dram; MIG OOC: 15.0K LUT AXI, 12.7K native, 5.9K of it hardwar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
2026-09-29 docs/stream.md (draft, M1): the stream engine SE -- one unit in the VPU's place for every VOP and DSTEP-style kernel; STREAM (0x13) with a float-safe TMEM descriptor; DSTEP's dot A on the VPU's slot-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
2026-09-29 rtl/vpu/otpu_se_tail.sv: the stream engine's tail (docs/stream.md piece 2), otpu_dstep without dot A (A runs on the VPU's slot-0 loop and u_vt; kv/kv_v in, the X registers xd/xa/xm out) plus the mode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
    [otpu_pkg.sv, otpu_se_tail.sv]
2026-09-29 Stage 1 (paused, the fallback): otpu_mig_ch, one DDR3 channel's user side on the MIG native UI -- the accelerator's AXI master (core clock, 512b) and XDMA's (axi_aclk, 128b, 16-byte beats packed into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
    [otpu_afifo.sv, otpu_axi_split2.sv]
2026-09-29 otpu_vpu: the stream engine's front (docs/stream.md piece 1), HAS_SE (LANES 8). ss_req drops rdy; once nothing is starting (the sequencer's start follows rdy a cycle late), queued, issuing, reducing,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
    [otpu_vpu.sv, rtlsim.py]
2026-09-29 otpu_slice: u_vpu with the stream engine (HAS_SE = HAS_DSTEP), its ss_* ports idle (no stream asks) until the DMA's side is wired (piece 3 replaces this)
    [otpu_slice.sv]
2026-09-29 tests/test_vops.py: test_direct_vops_rtl_bit_exact, EXP2SUB, MIN, RSUB, ABS, FILL and COPY on the RTL against the ISA simulator bit for bit (they had no dedicated test): every B mode, row strides, od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
2026-09-29 tests/test_se_vpu.py + sim/verilator/tb_se_vpu.sv: the stream engine's front on its own, otpu_vpu with its tail driven like the DMA drives it (ss_req, the grant, the fills, streams with random pe sta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
    [tb_se_vpu.sv]
2026-09-29 STREAM (0x13) at the ISA level: isasim runs it with full semantics (docs/stream.md 3: the descriptor, slots, row scalars and constants read first; rows in order, a later row sees an earlier row's wri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
2026-09-29 MXU: the pair sums in the DSPs' post-adders, as a systolic pair (DSP 2q: M + PK, PREG; DSP 2q+1: operands a stage later through ADREG / BREG 2, M + PCIN, PREG), instead of a one-cycle M + M + PK that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
    [otpu_mxu.sv]
2026-09-29 WIP piece 3: otpu_dma streams through SE (ss_*), STREAM decode and fill generalisation, seq/pkg STREAM, slice wiring, CAPS bit26
2026-09-29 otpu_vpu: rdy and the grant read ss_req registered (ss_rq), so no path runs from the DMA's register through rdy into the sequencer's start; the grant also needs ss_req itself, so ss_gnt still falls t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
    [otpu_vpu.sv]
2026-09-29 tests/test_stream.py: test_stream_rtl_bit_exact, the board's subset on the RTL (every dmode x gate x A slot x Q, the zero flag, DSTEPs among them, descriptors FILLed at the start as the compiler does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
2026-09-29 rtl/vpu/otpu_se_comp.sv (SE v2, standalone): EXP2, EXP2SUB, RECIP, RSQRT and LOG2 on all LANES lanes, microcoded over NS generic multiply-add stages per lane (in SE: VPU slot 0, the tail's U and Q). 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
2026-09-29 tests/test_qwen35.py: the tiny board-model test also runs each DeltaNet head step as a STREAM (Config.STREAM without DSTEP) on the RTL
2026-09-29 STREAM's ks from w1[31:16] (the DMA's K1 address; the footprint's constants [k, k + ks + 1)); otpu_seq: a fifth TMEM range t4 (read, STREAM's constants) so STREAM's footprint is exact where the instr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
2026-09-29 docs/stream.md: STREAM's sequencer footprint (the subset's largest shape; ks from w1)
2026-09-29 MXU IMPL 2: a 2D systolic array (docs/mxu_systolic.md). The chunk is decoded once and skewed per chain stage, then the weights move one register hop per column instead of a broadcast (both streams: t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
2026-09-29 docs/stream.md 11.1: otpu_se_comp's ports as built (u_sel/u_a/u_b/u_c/u_y per stage, in_x/in_y, MW, HA), T = 25, passes per function
2026-09-29 otpu_se_comp: the ports of docs/stream.md 11.1 (in_a/in_b, the lane mask in_m/out_m carried beside in_meta/out_meta, st_sel/st_a/st_b/st_c/st_e/st_y; EXT = 1 by default: the units are SE's slot 0, U 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
2026-09-29 otpu_se_tail: without O (q_en 0) no valid row enters Q. The DMA stops pe once the last Y is out, so a row still in Q's partial loop or tree came out as the next stream's first O (test_stream_rtl_bit_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
    [otpu_se_tail.sv]
2026-09-29 tourney: slot patches saved as git writes them (git() strips its output, which cut a hunk's trailing empty context line: patches/*.patch did not apply, e.g. r20260928-213703-s1)
2026-09-29 docs/isa.md: DSTEP runs on the stream engine on the board; STREAM (0x13) summarized with a pointer to docs/stream.md
2026-09-29 otpu_dstep.sv goes (the DMA streams through SE; the tail is otpu_se_tail in the VPU): out of the file lists (rtlsim, the board Makefile, create_project.tcl, tools/synth); the tourney's otpu_dstep com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
2026-09-29 COMP8 (docs/stream.md 11): the composites on otpu_se_comp over slot 0 and the tail's U and Q. otpu_vpu (COMP8, with HAS_SE and LANES 8): no long lanes (their ten-slot chains and the taps past 1 go); 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
    [otpu_se_tail.sv, otpu_slice.sv, otpu_top.sv, otpu_vpu.sv, rtlsim.py, tb_se_vpu.sv, tb_top.sv]
2026-09-29 tools/litedram: the LiteDRAM test image (DDR3 channel 0 at 72 bits, A7DDRPHY, CL7/CWL6 at 1066; XDMA as an RTL IP, BAR0 onto the CPU-less SoC's CSR bus; a 576-bit BIST with per-lane error counts; the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
2026-09-29 otpu-selftest: a stream stage (bitstreams with CAPS bit26): checks.stream_program -- every dmode with each gate, A on slot 1 or 2, Q on or off, the ZERO flag, 64..256 columns, and a DSTEP, descriptor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
2026-09-29 otpu_dma: pad64 (ONE_TREE, docs/stream.md 11.3): a stream of cols = 64 runs as ns = 16 with cfg.pad64, each row its 8 segments then 8 of +0 (no chunk read or consumed), the Y of the padded ones dropp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
    [otpu_dma.sv, otpu_slice.sv]
2026-09-29 rtlsim: OTPU_SE_COMP8=1 / OTPU_SE_ONE_TREE=1 knobs beside OTPU_SE=v2|comp8|onetree. tb_se_vpu: half the streams stop pe right after their last output, as the DMA does (the next stream must not see an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
2026-09-29 MXU IMPL 2: control travels with the data. Row-gated pops (a row's first advance pops once all of its chunks and scales are in the FIFOs), so a row never stalls in its middle and the compute pipeline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
    [otpu_mxu.sv]
2026-09-29 MXU IMPL 2: use_dsp on the products, their chain sums and the sub-block multipliers (Vivado built the 8 x 8 products in fabric: 26 DSPs, 70.8K LUT at MCOLS 4)
2026-09-29 otpu_se_comp.sv in the board Makefile, create_project.tcl, tools/synth and the otpu_vpu tourney component (test_tourney: every module has a component)
2026-09-29 SE v2 on se-vpu's COMP8/ONE_TREE (a473412): otpu_vpu ew_n 7 bits -- an elementwise VOP may start every other cycle, so with COMP8's 100-cycle RSQRT/LOG2 (75 EXP2) up to ~50 are in flight, and a 4-bit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
    [board.py, otpu_board.sv, otpu_se_comp.sv, otpu_vpu.sv, tb_board.sv]
2026-09-29 MXU IMPL 2: each position a DSP48E1 (otpu_pe) with the stream select in its pre-adder (A = low, D = high, INMODE by hi0[j]) instead of a fabric mux per position and column, and the activation's last 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
2026-09-29 otpu_se_comp: area -- each stage's operand and destination muxes keep only the inputs its ops use over every function and pass (computed at elaboration: at NS = 3 Q's c is always a constant, Q writes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
    [otpu_se_comp.sv]
2026-09-29 MXU_IMPL through the build and the board model: make bit's create_project.tcl takes MXU (systolic, the default on this branch, or tree) as otpu_fpga_top's new MXU_IMPL generic; tb_board and SimTransp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
2026-09-29 tourney otpu_mxu: MXU command queue as head / next registers: no q_h mux in front of the consumer and the drain
    timing: full fmax 116.89 -> 124.94 MHz (+6.88%), WNS -0.586 -> -0.035 ns, area_eq -0.17% (LUT -1201, LUTRAM -141, FF +1447), score +7.06%; confirmed: WNS -0.035 / -0.224 ns (build / confirmation)
    Slot r20260928-213703-s1, agent claude, eval vivado-remote.
2026-09-29 otpu_vpu: SE registers the ss_* inputs twice, so the enable's replicas (en_r) are a copy of a flop (en_q, computed a cycle ahead) with no logic in front (v2 OOC WNS +0.08: ss_act -> en_r replica, 7.8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
2026-09-29 otpu_se_comp: timing -- each stage's control is a ROM over (function, pass) built from ucode with constant arguments (k = pass*NS + s, k % 2 and (k-1) % 3 had become an adder and mod-3 logic in front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
2026-09-29 LiteDRAM test image on the card (DDR3-1066, channel 0, 72 bits): calibrated from the host on all 9 lanes; read windows 9-11 taps (8-9 under traffic); per-lane write windows 650-800 ps but only 234 ps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
2026-09-29 tests/test_vops.py: test_many_small_composites_rtl_bit_exact -- runs of independent tiny composite VOPs, so more than 15 elementwise instructions are in flight in the VPU at once (at the board's WIN 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
2026-09-29 otpu_vpu: ew_n (elementwise instructions issued, not done) 7 bits instead of 4. One may start every other cycle and a composite takes ~70 cycles, so more than 15 can be in flight (at the board's WIN 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
    [otpu_vpu.sv]
2026-09-29 docs/litedram.md section 7: the write scan corrected (DQS moves alone, so a lane's window is the DQ-DQS eye, common to all lanes to ~6 steps, cut by that lane's tDQSS crossing; the crossings give the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
2026-09-29 docs/stream.md 12: results so far, measured vs simulated. Tests: v2 bit-exact across R-A's, R-B's and se-v2's suites; the 202856d RTL suite pending. Cycles (Verilator): v2 +341 on Qwen3.5 4 layers (+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
2026-09-29 otpu_se_comp: timing -- the output side's control (destination, negate, the constant into v) and RR's flags are registered from a copy of (function, pass) delayed SL - 1, so a stage's result path (y,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
    [otpu_se_comp.sv]
2026-09-29 LiteDRAM test image, both channels: channel 1 on the second DDR3 (pins checked against the MIG project's, all 117), its DQS clock on a second MMCM's fine-phase output (one MMCM shifts all its fine-ph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
2026-09-29 opentpu/host/ddrcal.py: the LiteDRAM calibration core moved out of ld_host.py into the host library (stdlib only, no package imports, so a copy next to ld_host.py serves a card host whose installed o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
    [csr.csv]
2026-09-29 tools/litedram/gen_core.py: the production LiteDRAM core, otpu_litedram (both channels, A7DDRPHY at DDR3-1066, one 512-bit native port per channel through LiteDRAM's ECC, in sys_clk; a BIST port per 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
2026-09-29 otpu-memcal (opentpu/host/memcal.py): the host's DDR3 calibration for LiteDRAM bitstreams (CAPS bit26, CAP_HOSTCAL): through the controllers' CSRs in the BAR0 window at 0x10000 (R_MEMCAL), each chann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
    [csr.csv]
2026-09-29 CAPS: the LiteDRAM (host calibration) flag is bit27, not bit26: bit26 is the stream engine's (se-main / se-int); bits 27-31 were free on every branch
2026-09-29 docs/stream.md 12.3-12.4: the 600c087 full build, routed. VPU + DMA 51.9K LUT / 86 DSP against pn32's 66.7K / 138 (-22.3%), slices 86.3% against 94.8%. Timing fails: WNS -0.199 ns, TNS -8.9 ns over 1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
2026-09-29 timing (the SE v2 build's paths 4 and 5), no change in behaviour - otpu_dma: cleft != 0 and cleft == 1 are registers (cl_nz, cl_one) loaded with cleft, so b_req (ld_req) and the read run's end see a 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
    [otpu_dma.sv, otpu_slice.sv]
2026-09-29 otpu_mem_ch: one DDR3 channel's user side in front of either controller (generalizes stage 1, otpu_mig_ch). The accelerator side is a native slave (otpu_native_dram's contract: commands of 64-byte be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
    [otpu_afifo.sv, otpu_axi_split2.sv, otpu_ldn_model.sv, otpu_mem_ch.sv, tb_memch.sv]
2026-09-29 docs/mxu_systolic.md: the MCOLS 4 full build of se-sys 2f80230: WNS -0.381 (115.4 MHz), 210.8K LUT, 92.3% of slices, 713 DSP; MCOLS 2 -> 4 costs +4.7K LUT, but the failing paths (MXU drain control, T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
2026-09-29 otpu_mem_ch CDC constraints: boards/ypcb-00338/constraints/otpu_mem_ch.xdc, scoped to the module and read unmanaged after the clocks exist (as xpm_cdc's): set_max_delay -datapath_only of one source p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
    [otpu_mem_ch.sv]
2026-09-29 otpu_dma: ST reads through a two-stage pipeline: TMEM's read data is registered (t_rq) before it is merged into the chunk (st_cd) and written into the buffer, so lb's write data comes from flip-flops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
    [otpu_dma.sv]
2026-09-29 otpu_mxu (IMPL 2): pop_q loads from the entries (h / n with this cycle's release), never from the command being accepted: a command that becomes the head as it is accepted gets its pop entry a cycle 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
    [otpu_mxu.sv]
2026-09-29 otpu_native_dram: the slice's DRAM ports on the channels' native ports (one command per 64-byte beat, for otpu_mem_ch), behind otpu_board's MEM_NATIVE (default 0: production unchanged)
    Same slice side, address map (CHASH) and behaviour as otpu_axi_dram; gone: AXI bursts, gather timers, 4 KB splits, IDs, write responses, err. Kept: SW gather and read-fill with its queue and hazard buckets, A prefetch runs and beat reuse, reserved read room, B tags, in-order returns, wr_idle (now on n_wdone). A tag FIFO per channel routes the in-order read data. Ordering by the command stream: an SW fill read waits for older writes of its beat to enter the stream, not to be answered; a write drops the A run /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
2026-09-29 otpu_mem_ch resets: two holes a short reset or a stalled controller opened. (1) A master's reset shorter than the round trip through the synchronizers released its side of the bridge before the hold 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
    [otpu_mem_ch.sv, tb_memch.sv]
2026-09-29 otpu_coll: the TMEM read requests from flip-flops: rd_on (st == C_RUN && issuing) and ssel (the one-hot of s) are registers kept with st, issuing and s, so r_en / r_addr are rd_on && ssel[k] && rm[l]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
    [otpu_coll.sv]
2026-09-29 boards/ypcb-00338/litedram/: the production LiteDRAM core, otpu_litedram.v and its XDC, as tools/litedram/gen_core.py makes them (both DDR3 channels at 72 bits, DDR3-1066 CL7 / CWL6, sys 133.33 MHz, 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
2026-09-29 otpu_axi_dram: the registered runs from a parallel scan: qc rotated to the head once, then the run is a priority encoder over the first entry that does not continue (every term in parallel), for the 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
2026-09-29 check_native.tcl (mig_native): the generated MIGs' parameters, read from each otpu_bd_mig_<c>_0_mig.v after generate_target: ECC "ON" (the native UI then takes app_cmd 011, wr_bytes, as the read-modi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
2026-09-29 MEM=mig_native: the two MIGs as RTL-level IP (IP integrator takes the MIG with AXI only: 'MIG supports only AXI designs in IPI flow'). create_project.tcl makes mig_ddr3_ch0/1 with create_ip from the 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
2026-09-29 LiteDRAM write leveling by clock groups (test image, ld_test.py --phy wl): WL7DDRPHY (tools/litedram/wl7ddrphy.py), A7DDRPHY with each byte lane's write side (DQ, DQS, their CLKDIV) on its group's cl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
    [csr.csv]
2026-09-29 WL7DDRPHY: the host keeps the write clocks within half a tCK of sys (ddrcal.DqsPhase wraps targets into [-56, +56) steps: the same phase against CK a tCK away, absorbed by the write latency), so the 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
    [ddrcal.py]
2026-09-29 docs/litedram.md: channel 0's 35-min run in the two-channel image (3578 BIST passes of 2 GiB, 0 wrong beats, window 201 ps at every one of 7 rescans, but the FPGA only went 54.4 -> 55.0 C: a stabilit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
2026-09-29 ddrcal.calibrate_groups: check the write clock MMCM's DRP encoding before the first write
2026-09-29 ddrcal.calibrate_channel (otpu-memcal's entry): a WL7DDRPHY core (phy wl, groups per channel) goes through calibrate_groups (group 1's offset, then the common phase); the result carries the offset an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
2026-09-29 WL7DDRPHY: the phase shift moves CK, the commands and the read capture (sysc / sys4xc, both 0 deg) instead of the write side: the first build routed (WNS +0.069, WHS +0.016) but bitgen refused it (DR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
    [csr.csv]
2026-09-29 Board model on the native-channel builds' channels, and HOSTCAL (CAPS bit27). tb_board MEM_NATIVE is now an int: 1 otpu_native_mem as before; 2 / 3 the new sim/verilator/otpu_chmem.sv (otpu_native_me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
    [board.py, otpu_board.sv, otpu_chmem.sv, otpu_ctrl.sv, otpu_native_sys.sv, rtlsim.py, tb_board.sv]
2026-09-29 docs/flash.md: the flash proposal's CAPS bits are 28/29; 26 is the stream engine's and 27 LiteDRAM's host calibration (both on branches)
2026-09-29 create_project.tcl (MEM=mig_native): create_ip_run once per MIG, on its .xci (IP_FILE); on both IPs at once it stopped: '[Vivado 12-3445] A collection of objects is currently not supported at this ti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
2026-09-29 docs/stream.md 12: the outcome. se-cand3 (02569bc) closes at 120.755 MHz (WNS +0.031, WHS +0.016) and is qualified on the card (0 FAIL, 12/12 token-exact, selftest with the stream stage); decode devi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
2026-09-29 docs: deploy_secand3_02569bc is the production image (board.md: the bitstream table and its build / qualification record, pn32 kept as the previous one; README: the new image's measured decode and pr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
2026-09-29 tourney otpu_quant: ACT RAM write index LANES-aligned by construction: the ACT RAM's byte rotator folds to a one-hot chunk decode
    timing: full fmax 119.12 -> 120.48 MHz (+1.14%), WNS -0.426 -> -0.331 ns, area_eq -3.15% (LUT -11525, LUTRAM -17, FF +537), score +4.29%; confirmed: WNS -0.331 / +0.004 ns (build / confirmation)
    Slot r20260929-070224-s1, agent claude, eval vivado-remote.
2026-09-29 MEM=litedram: the production LiteDRAM core regenerated with WL7DDRPHY (gen_core.py --phy wl at litedram-int 05613dd: per channel a WriteClocks MMCM cascaded from sys, the host shifting CK / commands 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
    [csr.csv]
2026-09-29 WL7DDRPHY: the read ISERDES on the static write clocks (sys4x_w0 / sys_w), as the stock PHY's reads; only CK and the commands shift. ldtest3 captured on the shifted pair and lost a lane per channel: 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
    [ddrcal.py, test_ddrcal.py]
2026-09-29 The stream engine's v1 is removed: v2 (COMP8 + ONE_TREE), qualified on the card, is the only configuration - RTL: no SE_COMP8 / SE_ONE_TREE (otpu_slice, otpu_top, otpu_board, otpu_fpga_top, tb_top, t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
2026-09-29 MEM=litedram: the production core regenerated at litedram-int d2c1ede (WL7DDRPHY's read ISERDES on the static write clocks, sys4x_w0 / sys_w, as the stock PHY's reads: ldtest3's one-late-bit-per-chan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
    [csr.csv]
2026-09-29 MEM=litedram: the core's identifier ROM file, otpu_litedram_mem.init ('openTPU LiteDRAM'), committed with the core and added to the project (Memory Initialization Files): the Verilog $readmemh's it b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
    [csr.csv]
2026-09-29 MEM=litedram: the serializer resets' set_max_delay in the core's XDC 2.0 ns instead of 1.2 (gen_core.py: WL7DDRPHY.constraints(ns=2.0)); ldtest3d (same PHY) routed those paths at 1.66 ns, WNS -0.967 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
    [csr.csv]
2026-09-29 WL7DDRPHY + ddrcal: per-bit read framing. ldtest3d (reads on the static clocks) calibrated channel 0 (all 9 lanes, 45 steps / 753 ps common, 300 s soak clean) but not channel 1: dq27 read at its lane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
    [csr.csv]
2026-09-29 MEM=litedram: the production core regenerated at litedram-int 8cbfd3b (WL7DDRPHY per-bit read framing): csr.csv adds ddrphy_dly_sel_bits at 0x2834 and ddrphy1_dly_sel_bits at 0x3034 (8 bits, reset 0x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
    [csr.csv]
2026-09-29 ld_host --fused: the same calibration, scans, BIST, soak and temperature run on the production image (MEM=litedram): the core's CSRs through BAR0's window at 0x10000 (a 128 KiB map), BUILD_DIR its ho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
2026-09-29 XdmaTransport maps BAR0 through the LiteDRAM CSR window (R_MEMCAL + 64 KiB; 4 KiB left memcal's reg_read / reg_write at R_MEMCAL + a an IndexError, found by ldphy), with a test on a 1 MiB file standi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
    [board.py, fake.py]
2026-09-29 test_mxu_starve_counter asserts what MXU_STARVE measures, per MXU_IMPL: the cycles with work and an empty chunk FIFO, exactly the Q records' ms summed (+trace). The wait for chunks (ms + mb) is most 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
2026-09-29 XdmaTransport maps BAR0's four 64 KiB windows (0x40000): the control registers, the LiteDRAM CSRs (R_MEMCAL) and the XADC (0x30000), which ldphy's fused bring-up reads too; the test writes and reads 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
2026-09-29 MEM=litedram timing, from the routed 14875bf: the serializer resets' max delay 3.0 ns (WL7DDRPHY.constraints()'s default; 2.0 missed by placement alone, 162 of 358 paths, -0.514 at 0 LUT levels and 1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
    [otpu_litedram.xdc]
2026-09-29 otpu_native_dram: the SW hazard counts (whb, 2 x 64 x (WW+1) flip-flops) have no reset; core_rst reached them on 9.1 ns of route and missed 100 MHz on the routed 14875bf (-0.066, whb_reg/R). The rese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
    [otpu_native_dram.sv]
2026-09-29 WL7DDRPHY: a register after each DQ bit's read bitslip mux (rd_reg, default on), the read latency one sys cycle longer to match (settings.read_latency cl_sys_latency + 7: the PHY's rddata_valid delay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
2026-09-29 docs/litedram.md section 8: the checkpoint. ldtest3e (8cbfd3b) on the card: GO on both channels - common windows 45 steps / 753 ps (channel 0, CK +50, every lane at write bitslip 6) and 73 / 1222 ps 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
2026-09-29 otpu-selftest calibrates a LiteDRAM bitstream (CAPS bit27) in its calib stage: it opens its Board without check (the link stage reads the ID), so memcal.ensure never ran and the stage failed on every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
    [test_ddrcal.py]
2026-09-29 docs/litedram.md section 8: the fused production image (ld-top 14875bf) on the card - ld_host --fused: common windows 737 / 1222 ps, BIST and 300 s soaks clean on both channels; HOSTCAL (otpu-memcal 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
2026-09-29 The fused design is the default everywhere: make bit / run_vivado.sh / create_project.tcl build the LiteDRAM core (MEM=litedram, DDR3-1066), MCOLS=4 and the systolic MXU without arguments (MEM=mig / 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
2026-09-29 ld_host --fused: the FPGA temperature from the XADC's own register (BAR0 0x30200, the 12-bit code in [15:4]; the map grows to 0x40000). The board's TEMP register (0x4C) is valid only once channel 0's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
2026-09-29 docs/litedram.md section 8: the merge candidate ld-top 5e5a58ab qualified on the card - ld_host --fused: common windows 737 / 1222 ps, BIST and 300 s soaks clean; channel 1 reads one bit (lane 3 bit 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
2026-09-29 The MIG fallbacks are removed: the LiteDRAM build is the only board build ("once the ambitious path passes, drop the fallback"). RTL: otpu_axi_dram, otpu_fpga_top (the MIG AXI build's top), otpu_fpga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
2026-09-29 The tournament on the fused design: TARGET_MHZ 133.33 (800 / 6, an MMCM step: 128 B x f = 17.07 GB/s, both DDR3-1066 channels' peak; Makefile, forever.sh, the orchestrator's default, otpu_full / otpu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
2026-09-29 LiteDRAM calibration on the card: a VexRiscv (LiteX minimal, RV32I) in the core calibrates both DDR3 channels at reset with ddrcal's algorithm, raising cal_ready / cal1_ready itself (docs/litedram.md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
    - tools/litedram/calcpu.py: the CPU subsystem. 16 KB true dual-port firmware memory (instruction port with a read-ahead), a 256-word result mailbox, a 64-bit cycle counter, and a window onto the core's CSR bus as a second master beside the host's (round-robin; one free cycle after each CPU access). CSRs selfcal_hold (the CPU held in reset between two of its bus accesses; released, it starts over), selfcal_config (channels, stride), selfcal_status (magic 0x5CA1, held), selfcal_state (w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
    [csr.csv]
2026-09-29 card_session.sh selfcal DIR: an image with the calibration CPU on the card - info, the CPU's calibration since configuration (result, BIST, --soak SOAK s per channel), the host's calibration with the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
2026-09-29 selfcal.release clears selfcal_state before the CPU restarts: the firmware writes it only a millisecond on, and until then wait() found the last run done (ld_host selfcal --rerun, otpu-memcal selfcal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
    [ddrcal.py, selfcal.py]
2026-09-29 The calibration CPU takes a new firmware from the host, without a new bitstream: while it is held its memory's data port is the host's (selfcal_mem_adr / selfcal_mem_dat write a word, selfcal_mem_rda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
    [csr.csv]
2026-09-29 The production LiteDRAM core with the calibration CPU: main's core (14875bf's, wlrst max_delay 3.0 ns) regenerated by gen_core.py --phy wl --selfcal --fw-id 4461c052 (core.json: args, settings, the f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
    [csr.csv]
2026-09-29 docs/litedram.md section 10: the test image with the calibration CPU on the card (ldcpu-d5eb5270, rd_reg on, stride 1; measured): the CPU calibrates channel 0 in 6.28 s and channel 1 in 5.83 s at con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
2026-09-29 otpu_mxu at 133.33 MHz: the two worst path families of the full-effort reference build (fix-bdclk 959b425, tv-full-959b425cf6b1: WNS -0.479, 2844 failing endpoints) fixed in RTL, bit- and cycle-exact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
    [otpu_mxu.sv]
2026-09-29 calcpu: the firmware memory's data port READ_FIRST. LiteX writes a byte-writable WRITE_FIRST port as an asynchronous read of a registered address; Vivado made it a block RAM whose collisions differ f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
    [csr.csv]
2026-09-29 otpu_actram: the quantizer's ACT write is registered as it arrives, before the lane placement. On the routed 959b425 at 133.33 MHz the quantizer (with its TMEM copies, X1Y2-3) sat 634 RPM units from 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
    [otpu_actram.sv, otpu_quant.sv, otpu_slice.sv]
2026-09-29 Timing of the DMA -> native memory paths (the 959b425 build's largest failing family at 133.33 MHz, dma>nmem: 1381 endpoints, 11 levels, 90% route, -0.390) and of the adapter's SW hazard counts (nmem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
    [otpu_board.sv, otpu_dma.sv, otpu_mxu.sv, otpu_native_dram.sv, otpu_slice.sv, otpu_top.sv]
2026-09-29 otpu-selftest's calib stage names the core's CPU: '(calibrated by the core's CPU)' when a self-calibrating core's channels are done (it said 'host calibration: done before' on the fused 08b898d5), '(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
2026-09-29 tourney otpu_seq: Window command store in distributed RAM, one 1W1R copy per unit
    timing: full fmax 125.33 -> 133.46 MHz (+6.49%), WNS -0.479 -> +0.007 ns, area_eq -1.46% (LUT -3633, LUTRAM +749, FF -3872), score +7.95%; confirmed: WNS +0.007 / -0.038 ns (build / confirmation)
    Slot r20260929-161407-s0, agent claude, eval vivado-remote.
2026-09-29 docs/litedram.md section 10: the fused image with the calibration CPU (08b898d5: main f1f635a + ld-cpu2, MEM=litedram, MCOLS=4, FAST=1 at 100 MHz; WNS +0.043) qualified on the card: the CPU calibrate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
2026-09-29 qual.sh: a crashed step is a FAIL line. Every step's output goes to $OUT/logs/NNN-step.txt; a non-zero exit (timeout's 124 too) or a Python exception in it adds '[FAIL] <phase>: <step>: exit N, <the 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
2026-09-29 docs/litedram.md section 10: the temperature rescans as a follow-up (not built). Why: one calibration at configuration; covered so far 54-55 C (ldtest3e's 35 min run) and 60-67 C (the fused qual), no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
2026-09-29 otpu_vpu at 133.33 MHz: the vpu>vpu and vpu>tmem families of the full-effort reference build (fix-bdclk 959b425: 92 and 153 failing endpoints) and the 100 MHz fused placement's m0.func family (5e5a58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
    [otpu_fp.sv, otpu_pkg.sv, otpu_se_comp.sv, otpu_vpu.sv, tb_fp.sv, tb_se_comp.sv]
2026-09-29 DMA -> native memory: the stream write's address as a register, and the SW gather data a cycle after the take, off the late strobes that 23ee14c left on the DMA -> memory paths (no change in behaviou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
    [otpu_dma.sv, otpu_native_dram.sv]
2026-09-30 otpu_native_mem: the image's words in two arrays (mem_lo / mem_hi, WORDS / 2 each; a beat is in one of them), as Verilator takes at most 2^28 entries in one unpacked array whatever their width (lint: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
    [otpu_native_mem.sv]
2026-09-30 The board build's default core clock is 133.33 MHz (800 / 6: the 128-byte port matches both DDR3-1066 channels, 17.07 GB/s), the production image's: make bit / run_vivado.sh / create_project.tcl. FAS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
2026-09-30 Docs: the 133.33 MHz production image (deploy_champ_e698dcd7, main e698dcd), qualified on the card 2026-09-29 - README Results: the new table (tools/qual/perf.py for all six: decode device / wall tok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
2026-09-30 Tournament cleanup and gate output: a run removes the worktrees (and slot branches) an earlier run of the same component and objective left behind when killed or crashed mid-round, unless that run is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
2026-09-30 On-device table gather with no new hardware (kernels/gather.py): a row of a quantized table in DRAM (int8 or 4-bit, block-scaled, an MXU operand) gathered and dequantized at a run-time row index by t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
2026-09-30 Kernels for Gemma 4: attention.Blocks, attention over an explicit list of cache blocks [(t0, n, mask row | None)] (a sliding window over a KV ring: its first block masked at its start, its last at it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
2026-09-30 Gemma 4 E2B (the text decoder) on openTPU (opentpu/llm/gemma4.py): 35 layers, sliding (window 512, 256-wide heads) and every fifth global (512-wide heads, proportional RoPE), 8 query heads on 1 KV he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
2026-09-30 omarchy_test.sh: a third test slot while omarchy has memory to spare (MemAvailable above OTPU_REMOTE_EXTRA_KB, 16 GB by default, i.e. no second full build placing). Two slots were held for over an ho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
2026-09-30 Tournament gates and omarchy's test queue: a gate's timeout counts from when tools/omarchy_test.sh holds one of omarchy's test slots (with OTPU_REMOTE_SLOT_MARK set, which the tournament sets, it say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
2026-09-30 docs/offload.md, phase 1 of bigger-than-DRAM models: MoE expert offloading, a design study with its measurements. The hierarchy on opentpu: card DRAM 14.1 GB/s, a host fp4 kernel with the card's MM a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
2026-09-30 docs/offload.md for path (a), the user's rule that openTPU does all the computing: the card routes (the router MM, autodecode's ARGMAX knock-out), posts its k expert ids to a DRAM mailbox, computes t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
2026-09-30 Gemma 4 programs 2.4x smaller, prefill 4 rows a run: a unit's repeated part loops inside the unit's loop (the 4 sliding layers of (4 sliding + 1 global) x 3 and x 4: nested hardware loops, Image.subs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
2026-09-30 docs/offload.md: the card-side protocol as phase 2 built it (branch offload-p2): the fence before the post (WAITW served >= seq, one request row), each expert's slot address read by WAITW from its di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
2026-09-30 docs/offload.md: the token's embedding row from the card, not the host (section 5.9): gather it from the tied int8 LM head with an MM against a one-hot operand (models3's kernels.lib.gather_row, gemm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
2026-09-30 The card's channels in simulation: LiteDRAM's own controller co-simulated behind the adapter (rtlsim OTPU_LDC=1066 / ldc=, otpu_top AXI = 2). tools/litedram/gen_ldc.py generates one channel of the pr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
2026-09-30 The full-build cache key is what the board build reads: the blobs of the RTL files create_project.tcl lists (its `set rtl [list ...]`; all of rtl/ if it lists none) and the boards/ tree (Tcl, constra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
2026-09-30 133.33 MHz: the three worst path families of the champion build 61e015ff4 (WNS -0.504), fixed in RTL, bit- and cycle-exact. (1) otpu_seq registers each unit's command as the unit starts (q <= m[start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
    [otpu_mxu.sv, otpu_seq.sv]
2026-09-30 The decode loop on the card, in the ISA simulator: one run generates a reply, the card picks and feeds back every token and the host only reads them (docs/autodecode.md). ISA (docs/isa.md): RLD (0x06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
2026-09-30 otpu-diag's checks for the decode loop's instructions (opchecks group gen, run on a bitstream with CAPS bit28; op_checks(cfg, gen)): RLD truncation, inf, RAW bits, register offsets and rd 0 (each val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
2026-09-30 docs/autodecode.md: the RTL plan as it will be built: the CHAIN reload in the slice (writes idle, the units held in reset, the program loader from the chain address; HALTED stays low), so otpu_top, o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
2026-09-30 The decode loop's capability is CAPS bit30, not 28 (docs/observability.md and docs/flash.md propose 28 / 29 for the flash controller and the reboot); docs/isa.md reserves 0x07 WAITW for the MoE exper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
    [board.py, fake.py, opchecks.py, regs.py]
2026-09-30 The decode loop on the card in RTL: RLD, VOP ARGMAX and HALT CHAIN, CAPS bit30 (docs/autodecode.md). otpu_seq holds the R stage until an RLD's value is in R[rd] (rl_wait, a flip-flop; fetch and dispa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
    [board.py, isa.py, isasim.py, opchecks.py, otpu_ctrl.sv, otpu_pkg.sv, otpu_seq.sv]
2026-09-30 Card qualification of the decode loop (CAPS bit30): tools/qual/refs.py card --card-loop runs Engine.generate's tokens with every one after the first picked and fed back on the card (Engine.generate_c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
2026-09-30 Path (a) of docs/offload.md in the ISA simulator: MoE experts streamed into DRAM slots while the card routes and computes every expert. WAITW (0x07, docs/isa.md): wait until M32[R[ra]+w1] & w3 compar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
2026-09-30 Two native ports per channel, split on beat bit 7 (the bank's parity under ROW_BANK_COLUMN): LiteDRAM's crossbar keeps a master's commands in one bank at a time, so one port idled the channel at ever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
    Core (a r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
    [board.py, otpu_afifo.sv, otpu_board.sv, otpu_chmem.sv, otpu_ctrl.sv]
2026-09-30 Kernels for Gemma 4: attention.Blocks, attention over an explicit list of cache blocks [(t0, n, mask row | None)] (a sliding window over a KV ring: its first block masked at its start, its last at it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
    (cherry picked from commit ceae3e4bfd951c410c8259ab2f7cd149356371fb)
2026-09-30 Gemma 4 on the RTL (checkpoint 2) and in the tools. tools/perf_qwen.py: --model gemma4, --layers a list of checkpoint layers (Spec.truncated; shared layers attend to the last own layer of their kind 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
2026-09-30 qual.sh's decode-loop phase profiles each decode_profile run twice on the card loop, greedy and sampled (the model's chat defaults, chat.SAMPLING), device against wall tok/s for both. tests/test_qual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
2026-09-30 WAITW in the RTL (docs/isa.md "WAITW", CAPS bit31), offload's DMA-side encoding (offload-p2 7846937: isa.waitw, the ISA simulator's WAITW with Machine.host, profile.py, taken here as they are there):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
    [diag.py, isa.py, isasim.py, opchecks.py, otpu_ctrl.sv, otpu_dma.sv, otpu_dram.sv, otpu_pkg.sv]
2026-09-30 WAITW in autodecode's DMA-side form: the DMA polls M32[R[ra] + w1] until (word & w4) compares (EQ / NE / GE) with R[rc] + w3, then writes the word's bits to T[R[rb] + w2] (the fields follow LD's; w5 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
2026-09-30 Qwen3.5-MoE on the card with its experts streamed into DRAM slots (docs/offload.md, path (a)), for Qwen3.5-35B-A3B. moe.py: MoESpec.rule, the router rule per model on one card kernel: sigmoid_bias (L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
2026-09-30 moe_card.py --host-loop: decode with the resident step programs and the argmax on the host, for a model whose generate program does not fit IMEM yet (Qwen3.5-35B-A3B: generate bucket 1 is 4135 instru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
2026-09-30 Card check of WAITW on the host's writes (CAPS bit31): the host writes data, then a flag, while the card waits on the flag, and the card's LD after its WAITW must read the new data. On the card that 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
    [checks.py, diag.py, test_board.py]
2026-09-30 STATUS bit8 WAIT_TO: a WAITW timeout is its own status (offload's proposal), set with ERROR while the slice is stopped at the timeout, and cleared with ERROR when RUN falls (the core's reset). otpu_s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
    Tests (Mac, mac_heavy.sh): tests/test_waitw_rtl.py, tests/test_board.py and tests/tes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
    [board.py, checks.py, otpu_board.sv, otpu_ctrl.sv, otpu_slice.sv, otpu_top.sv, regs.py, test_board.py]
2026-09-30 The resident decode's embedding row gathered on the device (main's kernels/gather.py) instead of read from an fp32 table: Engine(embed="gather"), Image(lookup="gather") for Qwen3, LFM2 and Qwen3.5. O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
2026-09-30 Gemma 4 without host math (the user's rule): prefill runs and per-position programs gather their inputs on the device, the run's token ids compiled in (Image.compile_rows(tokens=), compile_step(tok=)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
2026-09-30 kernels.lib.softcap: the logit soft cap c tanh(x / c) on the device, 2c / (1 + 2^(-2 log2(e) x / c)) - c, 5 VOPs from existing ops (Gemma's final_logit_softcapping, for a sampler on the card: the LM 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
2026-09-30 Gemma 4: the soft cap for a sampler moves to the LM head (autodecode: the split generate programs call the head without the step, so a wrapper in gemma4_step would be skipped): gemma4_step no longer 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
2026-09-30 Generate programs for models whose loop does not fit, for Qwen3.5-35B-A3B and the like (offload's measurement: compile_generate(1) 4135 instructions > IMEM's 4096, and at bucket 16 "out of address re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
    (1) Registers. In a generate program (compiler Builder.run_words: the state block's TMEM words) a register that starts at c * var and steps with the step's loops (the K/V appends at the layer loop's layer) starts with its own RLD MUL of var's word, before the outermost of those loops. It no longer uses an ADDI from an argument register held from the program's start. Only an address of c * var alone keeps an argument register (R15 down, loaded at the to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
    [compiler.py, test_autodecode.py]
2026-09-30 The LM head soft-caps the sampler's chunks for a spec with a softcap (Gemma's final_logit_softcapping; team-lead / gemma4, main 4e2ef9d): y = kernels.lib.softcap(y, spec.softcap) before sink(y, col),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
2026-09-30 tools/offload/moe_card.py: every token picked on the card (the prompt's last token fed by the generate loop: before, the host took the argmax of the prefill's logits for the first one); HF's 8 best l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
2026-09-30 tests/test_lfm2_moe.py: the MoE block on the RTL through the host driver (the Verilator board model, WAITW: CAPS bit31; skipped on an RTL without it). Every expert resident and `served` past any requ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
2026-09-30 docs/offload.md: phase 2's status: the 8B runs (16 tokens token-exact at 20 slots with the fp32 table; 144 tokens at 28 slots with the gathered embedding, 97.8% hits, 1.54 misses per decode token, ca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
2026-09-30 Split generate programs: the second part updates every run-time variable of the state block (tok, tpos, ring), not only those its own program's addresses use. The step runs in the first part, so the 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
    [test_autodecode.py]
2026-09-30 tools/offload/moe_card.py --host-loop: the device's 8 best logits per step in the result, and beside HF's at the first different pick (a diagnostic: where a run parts from HF's greedy tokens)
2026-09-30 Path (a)'s host on the card's backend, and a 4 GiB image held once on the ISA simulator. BoardBackend.host (set by the Engine to the expert server's poll): called over and over while a run is in flig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
2026-09-30 docs/offload.md, host/offload.py: the card's host is BoardBackend.host, polled while a run is in flight on the one host thread (not a thread beside run_generate), checked against a fake card that com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
2026-09-30 133.33 MHz, the slice-side families of 812bb01 (WNS +0.074) below +0.3, in RTL, cycle-exact. (1) otpu_actram: the quantizer's ACT write crosses in two narrow registers (_i as it arrives, then _h), no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
    [otpu_actram.sv, otpu_quant.sv, otpu_slice.sv]
2026-09-30 otpu_native_dram: the SW gather data's write (gw_wdata) as a copy per channel, the 812bb01 build's worst native memory path at 133.33 MHz (gw_wdata -> gd, 0 levels, 96% route, +0.175): each of its bi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
    [otpu_native_dram.sv]
2026-09-30 ld-2port's new timing paths, cut in the bridge (ldimpl: the core and both bridges placed and routed on the board's pins, the production strategy; within each clock, without the wrapper's LiteX reset 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
    [otpu_afifo.sv, otpu_ldn_model.sv, otpu_mem_ch.sv]
2026-09-30 LFM2-2.6B (LiquidAI/LFM2-2.6B, short name lfm2-2.6b) on the LFM2 code, and weights read lazily. lfm2.Spec.from_hf takes the tied head from tie_embedding too (the 2.6B config has no tie_word_embedding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
2026-09-30 The int8 embedding of the Llama-likes, gathered on the device with the shared table gather (kernels.gather.gather_row): Spec.embed = "int8" (llama.py) makes the embedding rows int8 with one scale per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
2026-09-30 tools/qual/refs.py: the prompt's chat template gets a pinned date (DATE, 2026-09-29, as strftime_now: SmolLM3-3B's system header states today's date, so a reference computed one day would not match t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
2026-09-30 tools/compare_hf.py --backend board: the device side on the card through the host driver (chat.make_backend, as otpu-chat --backend board; a card session), --resident with the resident decode program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
2026-09-30 No model math on the host: with the image's tables (Image(lookup=True): the resident engine, and always for a model with an int8 embedding) the prefill runs and per-position programs read their input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
2026-09-30 Qwen3.5-2B and Qwen3.5-4B for the tools: short names qwen35-2b and qwen35-4b (opentpu.llm.MODELS: perf_qwen, compare_hf, otpu-chat, the qual runs), and refs.py's memory guesses for their references (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
2026-09-30 The int8 embedding (Spec.embed "int8", the rows gathered on the device: qwen3._embed) for Qwen3.5 and LFM2 too. qwen35.Spec.from_hf sets it when the fp32 table would be over EMBED_F32_MAX = 2 GiB, ha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
2026-09-30 otpu_coll: the write lanes' addresses registered each (qwl[l] <= pwa + l, as the write stage takes its row, in place of qwa <= pwa and w_addr[l] = qwa + l), so the collective's TMEM write requests le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
    [otpu_coll.sv]
2026-09-30 tests/test_autodecode.py: the generate loop with Spec.embed "int8" (main 2a04beb: the token's row gathered on the device, qwen3._embed, at the run-time token), in one program and split, gives the hos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
    [test_autodecode.py]
2026-09-30 ld-2port's arbiter: each master's room (its head's port's command queue and, for a write, the port's write-data FIFO) is found from its own head, alongside the pick, so go and the counts of an issued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
    ldimpl (within each clock, without the wrapper's LiteX reset net and the clocks' crossings;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
    [otpu_mem_ch.sv]
2026-09-30 LiteDRAM core at 133.33 MHz: the three sys-domain families of the 812bb01 full build (+0.077 to +0.127 ns, the core's worst), all the die's scale (the two channels at its two ends, one register drivi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
2026-09-30 docs/litedram.md section 12: ld-memch's ldimpl harness on eb5beed and with ld-fmax (the core and both bridges on the board's pins, the board build's strategies, Vivado 2026.1), each sys endpoint belo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
2026-09-30 133.33 MHz, two families of 812bb01 (WNS +0.074) below +0.2, in RTL, bit- and cycle-exact. (1) otpu_seq: the collective's command copy (g_cmd[U_COLL].q) loads on every cycle the collective is ready a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
    [otpu_mxu.sv, otpu_seq.sv]
2026-09-30 133.33 MHz, two cross-unit wires of 110ec6d (WNS +0.088), in RTL, bit- and cycle-exact. (1) The stream engine's O path leaves the VPU from a copy of the tree root's register: otpu_fadd2 (otpu_fadd, L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
2026-09-30 Qwen3.5: the DeltaNet pair loop at a run-time position too, on group-major DeltaNet layer blocks (Image.grouped, Spec.pair_loop; by default when a slice has more than PAIR_LOOP = 8 pairs of heads: th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
2026-09-30 docs/qwen35.md: the 0.8B's program set on main 2a04beb and after the pair loop is 64,069 instructions, sha256 661913fb (the 64,511 / 7ee567e0 quoted in 70c46e4, 9ce57ad and this file was the set on 1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
2026-09-30 Gemma 4 E2B on the card (production image deploy_champ_e698dcd7, 133.33 MHz, 2026-09-30; the prompt fed by resident decode steps, the device gathering every input): 3 prompts x 24 greedy tokens equal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
2026-09-30 otpu_native_dram: the B read-data FIFO's memory (rbm, 512 bits x RD per channel, LUT RAM) in eight 64-bit pieces, each written at its own copy of the tail (rb_tq[c][k], keep, each incremented with rb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
    [otpu_native_dram.sv]
2026-09-30 tools/decode_profile.py --card-loop: also the rate from the first token the card picked to its last (when each token landed in out[], BoardBackend.run_generate's on_token), against the device's, and 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
2026-09-30 docs/autodecode.md: the dev build's card qual (be824d57 at 100 MHz on opentpu, qual.sh fast: 42 PASS, 0 FAIL in 61 min): the decode loop on the card token-exact in 6/6 runs, WAITW 200 rounds on the h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
2026-09-30 docs/offload.md: phase 2's 8B runs, the longer answer too (160 tokens, the first 4 HF's, 98.5% hits, 0.87 misses per decode token), and both first different picks weighed: fp4's, not the device's (to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
2026-09-30 tools/gemma4_quant_eval.py: gemma4.emulated_logits over the whole sequence at once (float64, the device's quantization points, none of its rounding), the points switched one at a time (--quant act,kv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
2026-09-30 otpu_dma: the row output buffer (ob, the DSTEP / STREAM o values on their way to TMEM) is a LUT RAM per lane, not 256 x 32 flip-flops with one-hot entry enables. o value i goes to entry i / W of lane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
    [otpu_dma.sv]
2026-09-30 133.33 MHz, fused-133 c2830d6's (core +0.092) VPU family, in RTL, bit- and cycle-exact: otpu_vpu's TMEM read addresses on ports A and B follow the mode alone (an OUTER fill: od_a / oc_a; else a_row, 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
    [otpu_vpu.sv]
2026-09-30 133.33 MHz, otpu_quant's read enables off the adder and compare, in RTL, bit- and cycle-exact: the elements left in the group, rem = Gr - e, are a register kept alongside e (the group size at a start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
2026-09-30 docs/gemma4.md: prefill runs of 4 rows with device inputs on the ISA simulator (the production configuration, main's Engine.device_inputs): the int8 head's 72 greedy tokens equal HF's; the fp4 head t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
2026-09-30 otpu_seq: one TMEM write range per footprint, MM's RMAX range folded into its output range (the scoreboard's TMEM range pairs 16 -> 9). Tournament round r20260930-123216-s0 (fmax loop, on main bb7f84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
    [otpu_seq.sv]
2026-09-30 docs/gemma4_e4b.md: the design of Gemma 4 E4B with its per-layer embeddings from the host. E4B (42 layers, hidden 2560, 8 / 2 heads, 18 KV-shared layers, a 10240 MLP; 4.64 B parameters beside a 2.82 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
2026-09-30 Gemma 4: the PLE table on the host (docs/gemma4_e4b.md, step 1). Image(ple_host=True) (Spec.image, OTPU_PLE_HOST) holds a slot of `rows` PLE records in place of the table; build fills Image.ple_store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
2026-09-30 test_e4b_programs_fit: 5 argument words (the host PLE slot's gather takes no token), 4-row prefill runs compile
2026-09-30 133.33 MHz, two families of 110ec6d (WNS +0.088) in my units below +0.2, in RTL, bit- and cycle-exact. (1) otpu_mxu: the drain lanes' TMEM addresses (dad[dj + k], the head row's result addresses at t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
    [otpu_board.sv, otpu_mxu.sv]
2026-09-30 133.33 MHz, the core's worst path of bb7f844 (core_clk +0.081), in RTL, bit- and cycle-exact: otpu_mxu's chunk FIFO is FG = 4 block RAM column groups (u_fd per group, whole 36-bit BRAM columns each: 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
    [otpu_mxu.sv]
2026-09-30 otpu_mem_ch: the controller's reset registered once per bridge (urq <= urst, keep), which the bridge's whole controller side takes (the output command queues u_oq and their registers oc_v, the write-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
    [otpu_mem_ch.sv]
2026-09-30 otpu_dma: the stream gather's write is registered in the DMA, cycle-exact. SE's updated segment (y) went from the VPU's registers straight into the gather RAMs' data inputs (4 positions x 256 bits of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
2026-09-30 otpu_fp's adder without two redundant steps (the unit tournament's otpu_fp candidate r20260929-232720-s0, finished by hand): fp_add_s2 no longer pre-increments the exponent for s3's 28-bit normalize 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
    [otpu_fp.sv]
2026-09-30 sim_config sizes the DRAM for the run's formats where the int8 image is over 4 GiB (Qwen3.5-4B: 4257 MiB in int8 with the lookup tables, 4591 at a 2048-token capacity): its int8 probe raised MemoryEr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
    [board.py, checks.py]
2026-09-30 tools/offload/moe_card.py --card: the run on the card (/dev/xdma0, BoardBackend: the host's expert server polled while each run is in flight) instead of the ISA simulator, and --cfg: the configuratio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
2026-10-01 The Engine's compile worker builds its image with the engine's own keywords (Engine._image_kw: weight formats, lookup tables and a MoE's expert slots), not the formats and lookup alone: a MoE engine'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
2026-10-01 docs/offload.md section 10: path (a) on the card (build B 79c5707a, 2026-09-30, opentpu). LFM2.5-8B-A1B and Qwen3.5-35B-A3B, fp4 + int8 head, the experts streamed from a packed pool file into per-lay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
2026-10-01 memeff: the adapter's A runs of 32 beats, and the controller's refresh postponing 2 and read / write times 256 / 128, the three low-risk fixes from the whole-model co-simulation's breakdown of the tw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
    - otpu_native_dram: APF 8 -> 32. The run counters (a_iss, pfl) and the A order's drop field are log2(APF) bits (RNW), and the A read FIFO AD goes 32 -> 64 beats (>= 2 APF - 1). APF 16 gave half of the gain; 64 no more than 32.
    - tools/litedram/ctl_settings.py: refresh_postponing 2, read_time 256, write_time 128.
    - gen_core.py uses it, inside main's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
    [otpu_native_dram.sv]
2026-10-01 BoardDram: the expert server's DMA at the link's rate on the card (docs/offload.md 10.1). Board.write, which BackendDram calls, copied an expert four times (the pool's tobytes, CHASH's swaps, the two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
    [offload.py]
2026-10-01 Gemma 4's decode loop on the card: gemma4.Image allocates the generate area last in its lookup tables (generate.alloc; G.build and G.desc beside the RoPE rows and the gathers' one-hot operands) and c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
2026-10-01 Docs for LFM2-2.6B, SmolLM3-3B and Phi-4-mini on the card, and for Qwen3.5-2B / 4B. README: the three models' rows and streamed decode, measured on production build B (deploy_fused133c_79c5707a, tree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
2026-10-01 Gemma 4 E4B's generate loop with the PLE table on the host (docs/gemma4_e4b.md): after sampling, the loop posts the token's id to the image's PLE mailbox (offload's format: seq, the id, served on the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
2026-10-01 docs/gemma4_e4b.md: the generate loop's PLE requests as built (the mailbox in offload's format, the post after sampling, the fence before the slot gather, RowServer, the host's serve before its own w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
2026-10-01 PLE mailbox: the fence's WAITW times out after 2^30 cycles (8 s at 133.33 MHz: a host that stopped serving is WAIT_TO, an error, not a run that never ends), and RowLayout pads the mailbox to 256 byte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
    [offload.py]
2026-10-01 The expert server's staging under the DMA: a split pool format read straight into the channel runs, the pool's RAM tier (docs/offload.md 10.1). Session 2 on the card (BoardDram, 8f43a1d): Qwen3.5-35B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
2026-10-01 The pool's read into the page cache during the image build, its residency logged; a request's first miss in parts (docs/offload.md 10.1). moe.open_pool opens the pool file (sidecars, the memmap for p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
2026-10-01 Qwen3.5-2B and 4B on the card (slot 3, production build B deploy_fused133c_79c5707a, tree 1ea8951, 2026-10-01): all six token-exact checks pass against the cached ISA references (refs.py card, 32 tok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
2026-10-01 docs/autodecode.md and generate.py's module docstring: the loop's post of the sampled token (m.post_token, Gemma 4 E4B's PLE requests): the post before the out[] store (in the split form, in the seco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
2026-10-01 docs/offload.md section 11: the Gemma 4 26B-A4B design note (the model from its config and transformers' code: sliding 8-KV / full 2-KV K=V attention, a dense MLP beside a 128-expert top-8 GELU MoE, 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
2026-10-01 docs/offload.md 10.2 and README: session 3 on the card (2026-10-01, build B 79c5707a, offload-dma 4ae8dac): Qwen3.5-35B-A3B 3.79 tok/s wall, 3.87 device (2.75 / 2.80 in session 2), the 8B 10.64 / 10.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
2026-10-01 Gemma 4 26B-A4B, step (a): its attention and MLP width on the device, the MoE block in the reference. Spec.from_hf takes attention_k_eq_v and enable_moe_block. Global layers have their own KV heads (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
2026-10-01 The 4-bit quantizer's results cached on disk (opentpu/qcache.py), and tools/qual/prebuild.py to fill the cache before a card session, outside otpu-lock. On 2026-10-01 most of slot 3's 95 minutes unde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
2026-10-01 moe.py for Gemma 4 26B-A4B (docs/offload.md 11.2, part (b) of the split with gemma4): MoESpec.act (silu, gelu_tanh: the experts' gate); ExpertFormat pads a width that is not a whole number of its for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
2026-10-01 BoardDram: a write of the host's words within one 64-byte beat (a directory entry, served) goes to the card as that beat alone, one DMA call on its channel (CHASH: beat b of chunk m on channel b ^ pa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
    [offload.py]
2026-10-01 Card sessions prebuild their 4-bit images outside the card lock. qual.sh started without the lock (OTPU_LOCK_HELD unset) quantizes its 4-bit runs into the image cache first (opentpu.host.prebuild at 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
    [prebuild.py, runstate.py]
2026-10-01 tools/gemma4_quant_eval.py: Gemma 4 26B-A4B's emulation. Global layers' own KV heads and K = V, no PLE, MLP widths padded to whole D-blocks (weights and the activation), and the MoE block as the devi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
2026-10-01 docs/offload.md 11.3: the 26B with int8 experts (event model): 351 slots, 107.5 misses, 1.55 tok/s with the int8 head; 406 / 97.0 / 1.75 with an fp4 head, against fp4 experts' 3.51 / 4.19; the choice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
2026-10-01 Prebuild keeps the host quiet while a session measures. A session that measures host-sensitive performance (wall tok/s; offload's MoE streaming, bound by the page cache and the host's DMA) writes its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
2026-10-01 Gemma 4 26B-A4B, step (c): the MoE block on the device. Every layer calls moe.moe_ffn (offload's part (b), offload-g26: the softmax rule over the top k, gelu_tanh experts in ExpertFormat slots padded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
2026-10-01 gemma4's image build quantizes its 4-bit matrices through opentpu.qcache (models3's per-matrix disk cache, keyed by the matrix's content: ~/otpu-build/qcache/mxu, OTPU_IMAGE_CACHE, its 30 GB cap and 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
2026-10-01 chat.SAMPLING: Gemma 4's defaults (temperature 1.0, top_k 64, top_p 0.95: the model card's; the device sampler takes top_k up to 64). decode_profile --card-loop and otpu-chat raised KeyError 'gemma4'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
2026-10-01 Prebuild removes the image cache's temporary files of killed builds: qcache._store writes `.<key>.<pid>.npz` and renames it, so a build killed mid-write leaves the dot-file, which _evict neither coun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
    [prebuild.py]
2026-10-01 chat.Chat: a tokenizer without a chat template (a base model: Gemma 4 E2B / E4B's checkpoints) feeds the turns' text as is, tokenized with its BOS. decode_profile --card-loop raised ValueError (no ch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
2026-10-01 ExpertServer(policy="lfu", half=32): the victim is the cached expert, not in the request, of least decayed use (each use halving every 32 requests of its layer; a warm expert one use before the first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
2026-10-01 MTP phase 0, the offline acceptance study (docs/mtp.md 7.1, tools/mtp_accept.py): nine prompts (3 chat, 3 code with one code edit, 3 summaries of a given text) through each model's chat template, up 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
2026-10-01 The multiplexer's chooser and turnarounds, measured and parked (docs/litedram.md section 11, "The chooser and the turnarounds"): tools/litedram/fastmux.py, LiteDRAM's multiplexer with three options t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
2026-10-01 Gemma 4: sliding layers' K rows at their own stride (Spec.k_rows, from_hf: MoE models), a row and its block scales (26B-A4B: 384 bytes) instead of the RoPE row's (1536): the 26B's sliding KV, 8 heads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
2026-10-01 docs/offload.md section 6: PCIe Gen2 x8 feasibility (no build yet). opentpu's root port (00:01.0, Haswell PEG) takes 8.0 GT/s and runs the card x8 at 2.5 GT/s, the card advertising Gen1 only; what ru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
2026-10-01 boards/ypcb-00338: PCIE_GEN (environment, run_vivado.sh / bd_native.tcl): 1, Gen1 x8 (the default, unchanged), or 2, Gen2 x8: XDMA at 5.0 GT/s with its AXI side at 250 MHz (axisten_freq, xdma_aclk's 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
2026-10-01 chat.Chat's base-model fallback only for a tokenizer whose chat_template is None (Hugging Face's without one), not for one without the attribute (test_host's StubTok: 3 chat tests failed on 9e78e80).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
    [chat.py]
2026-10-01 Gemma 4's MoE layer calls moe_ffn with y_first=True (offload-g26 2c57dc2): the experts' [k, H] outputs take their TMEM before the router's input, which a 26B decode step needs (8 x 2816 words against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
2026-10-01 Card session 4 (docs/offload.md 10.3): the one-beat writes and the decayed-use slots on the card, and decayed use the default. On build B (79c5707a), Qwen3.5-35B-A3B 16 tokens: LRU 3.90 / 3.98 tok/s 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
2026-10-01 PCIe Gen2's RTL fixes, all under the top's PCIE_GEN (create_project.tcl passes the environment's; Gen1, the default, unchanged): otpu_dma_split (otpu_axi_split2.sv), XDMA's DMA master onto the two br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
    [otpu_axi_split2.sv, otpu_native_sys.sv, tb_memch.sv]
2026-10-01 gemma4_quant_eval: the MoE block quantizes its experts THREADS (4) at a time (numpy's 4-bit search releases the GIL: 2.8x on 4 threads for 704 x 2816 fp4 matrices on the Mac; the 26B's fp4-expert ppl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
2026-10-01 Gemma 4 card numbers on build B (deploy_fused133c_79c5707a, 2026-10-01): README's E2B rows and a new E4B row, docs/gemma4.md's card tables, docs/gemma4_e4b.md's new section "On the card". perf.py: E2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
2026-10-01 gemma4: the build's worker processes return the opentpu.qcache counts of their jobs, and the parent adds them to its own, so prebuild prints gemma4's hits and misses (models3's note: qcache.stats is 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
2026-10-01 Gemma 4 26B-A4B's end-to-end checks on the tiny MoE (tests/test_gemma4_moe.py), and the 35B's head formats (docs/offload.md 10.3). test_moe_lfu_policy_is_bit_exact: the slots replaced by least decaye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
2026-10-01 otpu_mem_ch's XDMA side at 250 MHz (PCIe Gen2), cycle for cycle as before: the four XDMA-side queues (u_xai, u_xwi, u_xrq, u_xbq) give their head from a register (otpu_sfifo RO: on a pop the entry af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
    [otpu_afifo.sv, otpu_mem_ch.sv]
2026-10-01 boards/ypcb-00338/vivado/userclk1_reroute.tcl (build.tcl, on the routed design): at PCIE_GEN 2, if a path of the PCIe block's 500 MHz user clock (userclk1) fails setup, the nets of the failing paths 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
2026-10-01 PCIe Gen2, from the FAST build 7b1cc919 (WNS -4.050): the LiteDRAM CSR crossing constrained, and the split's last 250 MHz paths. otpu_top_native.tcl took the core's CSR clock from the pin u_ld/ctl_cl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
2026-10-01 opentpu/llm/formats.py: the weight-format rules ("kind=fmt,kind@a-b=fmt") as shared code, gemma4's parser and lookup moved out of gemma4.py (rules, pick, plain; each model names its kinds). gemma4's 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
2026-10-01 embed_host: an untied int8 embedding table on the host (docs/offload.md 5.9), any model with lookup tables (Qwen3, LFM2, Qwen3.5)
    The card holds a slot of the run's rows (embed_record: each row's H int8 values, then its H / D
    scale words, whole 128-byte chunks) and a RowLayout mailbox; the host keeps the table in that
    format (embed_store, quantized as the on-card table) and writes a run's rows before it
    (host_rows). In the generate loop the card posts each sampled token (MB.post) and the host's
    RowServer writes its row to slot row 0; _embed waits for served, then gathers row 0. With an
    expert server both servers share its memory (BoardDram: one queue, in order).
    Default: on for a MoE model'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
2026-10-01 Router hints (docs/offload.md 12): before its mixer each Qwen3.5-MoE layer runs its router on the layer's input and posts the k best as a hint; the host gives them slots at once and moves them on the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
    The card (moe.moe_hint, MoESpec.hint, on in Qwen3.5's from_hf): the RMSNorm with the router's
    gain, QACT, the router MM, the route's ARGMAX knock-out loop without the weights, the global
    ids plus layers x E posted after the fence (MB.post). No ISA change, no new word.
    The host (ExpertServer): a request at G = layers x E and above is a hint. With "lfu" each
    hinted expert not in a slot gets one at once (a free slot, or the victim by decayed use, its
    entry cleared), joins `pending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
2026-10-01 tools/gemma4_moe_check.py: the 26B's MoE block (moe.moe_ffn alone, one program per token and layer, the experts served into the slots) on the ISA simulator against float, layer by layer, on the float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
2026-10-01 Phase A of per-kind weight formats on the device: qwen3, lfm2 and qwen35 Images (and Spec.image) take formats (None: OTPU_FORMATS, else Spec.formats; formats.resolver over the family's KINDS), one fo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
    [test_board.py]
2026-10-01 ExpertServer: drop (a request withdraws its layer's hinted experts it does not name that have not landed: their slots free again, the link kept for the next layer's hints) and an event timeline (when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
2026-10-01 memch_test: PCIe Gen2's clocks (xdma_aclk 250 MHz, core and controller 133.33) in four xreg scenarios (gen2, gen2xres, gen2part, gen2full); tb_memch's XDMA master takes +outs (bursts in flight per di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
2026-10-01 Phase B of weight formats on qwen3 (and the Llama-likes): formats per layer range. Each layer's formats (attention, gate / up, down: Image.lf) choose its layer block's layout (Image.bofs / bsize per 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
2026-10-01 tb_memch: XDMA-side checks every xclk cycle -- each otpu_sfifo RO (the split's three order FIFOs, both bridges' u_xai / u_xwi / u_xrq / u_xbq) has rvalid = not empty and wready = not full of its poin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
    [tb_memch.sv]
2026-10-01 BoardDram.read: bytes within one 64-byte beat (a poll's seq, a request's row) as that beat alone, one c2h DMA call on its channel (Board.read reads the whole 128-byte chunk, a call per channel: card 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
2026-10-01 wformat "mix", the named choice of a model's recommended weight formats: int8 with Spec.mix (formats.named; Spec.mix from formats.MIXES by the checkpoint's model type, layers, hidden size and vocabul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
    [chat.py, hwlens.py, prebuild.py]
2026-10-01 docs/gemma4.md, "26B-A4B: accuracy": the reference against Hugging Face; the experts' input (g2 ~0 on the residual's outlier channels: folded into gate / up it cost 0.18-0.51 block error in int8, 0.6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
2026-10-01 docs/gemma4.md 26B: the slots by dense and head format from gemma4.Image (fp4 experts, cap 4096, lookup tables: int8 dense 420 / 540 with the int8 / fp4 head, fp4 dense 660 / 780; offload.md 11.3's 6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
2026-10-01 docs/offload.md 10.4: card sessions 5-7 (the whole pool, the page cache, 16-token noise; at 128 tokens, twice each, the embedding table on the host +7.2%: 3.86 against 3.60 tok/s, 14% fewer misses; t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
2026-10-01 XdmaTransport: one DMA call per card at a time in the process (a lock per card around each mem_write / mem_read chunk, its staging copy included), so a host->card call never overlaps a card->host one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
    [board.py]
2026-10-01 XdmaTransport's DMA lock across processes too: flock on <run dir>/<card>.dma (the device lock does not keep processes apart inside one otpu-lock), with the thread lock for the process's own threads (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
    [board.py]
2026-10-01 memch_test: builds ldc / ldcx run otpu_mem_ch against LiteDRAM's own controller (otpu_ldc_model: otpu_ldc_ch.v, the production core's settings, with otpu_ldn_model's ports; the data per port in the c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
    [tb_memch.sv]
2026-10-01 docs/gemma4.md 26B: the formats on a text no model has seen (docs/offload.md's first 900 tokens, float ppl 10.02; Austen's 1.235 is memorized): int8 +0.013, int8 dense + fp4 experts +0.033 (int8 head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
2026-10-01 docs/offload.md 11.5: card session 8, Gemma 4 26B-A4B streamed (int8 dense, fp4 experts and head, 540 slots, Gen1 B, main 2a0b962): token-exact against the ISA simulator (16 tokens, prefill sha 28a40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
2026-10-01 BoardDram.read raises while its worker's DMA is queued or in flight (the server's reads never meet its writes: ExpertServer flushes before poll returns; a card->host call beside a host->card one slip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
    [offload.py]
2026-10-01 moe_ffn: the experts' MMs run paired (PAIR, column reuse) as the layers' own. An expert's slot address is a register (DevVar), and the compiler paired a 4-bit MM only when every term of its scale add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
2026-10-01 tools/moe_prefill_cosim.py: co-simulated card time of a MoE model's prefill parts at R rows a program (RTL + the card's LiteDRAM controllers, DDR3-1066, 133.33 MHz, build B's MCOLS 4 / PAIR / DSTEP /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
2026-10-01 MTP phase 2 (docs/mtp.md 9, 9.1): Qwen3.5's MTP drafter and the k = 1 speculative loop on the ISA simulator, host-driven. Greedy tokens equal plain greedy decode's on the real 0.8B and 2B.
    The image (Spec.mtp):
    - The MTP layer (the checkpoint's mtp.*, load_weights(path, mtp=True)) as one more attention layer block, with its own KV cache.
    - Its norms, fc and the draft head: fp4 rows of the 32K lowest ids.
    - Two slots of every DeltaNet state and conv window (DeltaNetParts.slot / state(slot) / window).
    - hid and draft rows in the I/O area.
    The kernels:
    - qwen35_rows fork: row 0 steps slot c in place; row 1 is a STREAM from slot c into slot 1-c (deltanet_step / Builder.stream dst: a destination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
2026-10-01 tools/mtp_decode.py --card: the MTP loop and plain greedy decode on the card, for the phase 2 card measurement (docs/mtp.md 9). Plain greedy is the production loop (prefill, then Engine.generate_card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
    The JSON holds:
    - each loop's device cycles and wall seconds;
    - the host's compile seconds;
    - each verify run's slot parity (MTPStats.slots, compile_s, prefill_s).
    --summary prints device and wall tok/s.
    --want checks the tokens against an ISA simulator run's JSON.
    --prebuild fills the image cache with both images, outside the lock. It waits while a session holds the quiet file.
    Engine._co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
2026-10-01 Layer-major MoE prefill (docs/offload.md 13): a MoE model's prompt a layer at a time, so that the expert slots serve one layer while the whole chunk passes it. Gemma 4 (the 26B first): Image.compile_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
2026-10-01 Host->card DMA never more than 4 KiB a call while a run is in flight (XDMA's H2C overrun, docs/host.md).
    XMON (2026-10-01) found the card DMA fault inside XDMA's H2C engine: a host->card call of more than 4 KiB that meets other traffic on its channel (a run's, or a card->host read) writes data from 8 KiB further on or stale data, or wedges, and the engine keeps the slip until the bitstream is reloaded; calls of 4 KiB were clean under both (accwr 120 s, overlap 300 s).
    - BoardBackend: the streamed logits' SENTINEL marks (4 x vocab bytes, 0.26-1 MB) were written right after RUN, during the run. Now _stream_tail submits them to the board's DMA worker once the run has ended (whole calls, while t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
    [board.py, test_board.py]
2026-10-01 XDMA: 8 outstanding H2C read requests (xdma_rnum_rids 8: 4 KiB at the driver's 512-byte MRRS; the IP's default 32 is 16 KiB). At 32 the H2C engine laps its read buffer when the card holds up its writ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
2026-10-01 docs/offload.md 13.5: the card session (build B, Gen1, layer_major.sh at 678b976): the 26B's 124-token prompt token by token, layer-major R = 1 and R = 2 give the same prefill logits (90e6b6e06e19da9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
2026-10-01 Streamed logits: the SENTINEL marks go back right after RUN again, on the DMA worker in 4 KiB calls (RUN_H2C), not after the run.
    h2c-run (ba3137b) wrote them after the run, on the DMA worker while the host takes the token, with start() waiting for them. The host's work after the tail is ~0.1 ms, so nearly all of it landed on the critical path. Card, B, decode_profile fp4 + int8 head, greedy, 96 tokens, main 6ee87f8 vs 1629f44, two runs each:
    - Qwen3: critical 0.41 / 0.54 -> 1.55 / 1.47 ms per token; wall 36.3 -> 35.1 tok/s.
    - Qwen3.5: critical 1.07 / 0.94 -> 2.50 / 2.61 ms; wall 26.0 -> 25.2 tok/s (-3.3% both).
    - The marks' DMA alone was 0.55 / 0.83 ms (601 / 983 KB); device time 0.17-0.26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
2026-10-01 tools/formats_scan.py: each variant's KL divergence from the float model's next-token distribution (kl_float, per token kl_tok) and from int8's (kl_int8), a second pass over the head (emulate's kl_to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
2026-10-01 docs/lfm2.md, docs/qwen35.md: layer blocks sized by their kind (Image.layouts, Image.loc / _off) instead of one size LS: LFM2.5-230M int8 at 4096 tokens 334 -> 276 MiB, LFM2-2.6B 2639 -> 2595; Qwen3.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
2026-10-01 MTP phase 3 (docs/mtp.md 10): Qwen3.5's MTP loop on the device. One run verifies, drafts and chains through the attention buckets' programs; the host only prefills, writes the state block and reads o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
    Programs per bucket, in an MTP chain area of the image:
    - V[b][c] (verify, parity c): rows (t, d) at a run-time position, with an ARGMAX per row on the device. It emits a0 and, if the draft holds, a1; then stop, max tokens, the commit, and CHAIN to D.
    - E[b][c] (the bucket's last position): one row.
    - D (the MTP layer over two rows) and D1 (one row): the next draft d = draft[n]; then CHAIN to V or E by bucket and parity, from fp32 arithmetic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
2026-10-01 MTP phase 3: MTPDecoder.loop_card (generate_card after its prefill: the device's loop from a0, d and the committed slot) and test_mtp_loop_on_rtl: from the same 251-token prefill, one run of the loop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
2026-10-01 ExpertServer: pooled slots for a layer-major prefill and the 2-line request. begin_prefill(): a missing expert takes a free slot of any layer, else the least recently used expert's of any layer the r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
    [offload.py]
2026-10-01 Revert mark-in-run (8d3c37e): the SENTINEL marks back after the run (h2c-run's), on the DMA worker, settled before RUN.
    The in-run marks raced the LM head on the card. In the Gen1 xfix qual (2026-10-01 17:57 opentpu, host 8d3c37e), token-exact lfm2 fp4 int8 failed: "the run left words unwritten (2048, bytes 16448..32767 of the region): ... or a marking raced it". That is one channel's 4 KiB mark call landing after the head had written the words.
    - The marks run on a Python thread: about 150-250 calls, ch0's then ch1's.
    - That thread waits for the GIL after every pwrite. Under a CPU-bound thread (the Engine's compile; the switch interval is 5 ms) it can fall behind the run, so an early piece'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
    [board.py]
2026-10-01 Compiler: a moved run-time argument goes into a released register at that register's own release, not at the first one. On the real 0.8B and 2B the device loop's verify (V) moved an argument into the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
    - Builder.release_at is kept per released register (the last instruction and the registers taken at its release). _move_arg takes a free released register whose release came before r was taken and copies there. Registers released at the same point are kept after the copy.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
    [compiler.py]
2026-10-01 RunPos.row -> RunPos.offset: a RunPos attribute named row shadowed gemma4's per-row mask pair (_slide_seq / _full_seq read getattr(p, "row", 0): a method, TypeError in every gemma4 run-time program; 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
2026-10-01 Engine.prefill_layers pools the expert slots (offload's ExpertServer.begin_prefill / end_prefill: every slot serves the running layer; each layer its own number back before the head runs, restore laz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
2026-10-01 moe_card --per-layer-slots (layer-major with each layer's own slots; default pooled; the result's pooled). layer_major.sh: the 35B's q35t16 / lm1 / lm2 (pooled) / lm2s (per-layer) and the 26B's poole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
2026-10-01 docs/offload.md 13.4: prefill_layers pools the slots (Engine(pooled, restore), moe_card --per-layer-slots, the test).
2026-10-01 layer_major.sh: the base runs first (q35t16, q35lm1 / lm2 with each layer's own slots), the pooled ones last (q35lmp2, g26lmp2; card_moe.sh: lm1 / lm2 --per-layer-slots, lmp2 pooled); one run at a ti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
2026-10-01 docs/mtp.md 10.1: milestone 1 on the ISA simulator. The device loop gives plain greedy's tokens on the 2B and 0.8B, 3 prompts x 48 tokens each, including a run past position 256. Iterations and accep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
2026-10-01 MTP loop on the card: a deadline and a stop at the first mismatch, for milestone 2's canary runs.
    - generate_card / loop_card(deadline=seconds) passes run_generate a stop callback. Past the deadline the host writes the stop word (st.timed_out) and the card halts at its next verify. 10 s after that, a run still going raises TimeoutError instead of polling forever.
    - tools/mtp_decode.py:
    - --deadline (default 10 + 0.5 s per token) for --loop device on the card.
    - --stop-on-mismatch exits 3 at the first prompt whose tokens differ from plain greedy's, and 4 at a timeout.
    - Checked with a stand-in run_generate on the tiny model, deadline 0.3 s: a run that answers the stop word returns at 0.3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
2026-10-01 Session 9's script and the programs' hashes. tools/offload/sessions/session9.sh: moe-pair's paired experts (tree B, d29bfe9 + this) against unpaired (tree A, main 7d879e6) in one session, A B A B: th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
2026-10-01 Streamed logits: the step programs fill their logits region on the card (fill_logits); the host writes nothing there.
    On a bitstream with RLD (CAPS bit30, BoardBackend.fills), Engine compiles its step programs with image.stream_fill. Their first instructions after the address registers' LIs:
    - a FILL of a TMEM tile with -inf (FILL_SENTINEL 0xFF800000: FILL keeps it, ftz changes only denormals and NaN; the LM head's logits are finite);
    - its stores over the slice's logits;
    - the last word loaded back (it waits for the last ST, which completes once the DRAM has taken every write);
    - an RLD of it, which holds every later instruction.
    Once ICOUNT has counted the instruction after the RLD (qwen3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
2026-10-01 docs/offload.md 10.5: card session 9 (build 72256074, Gen1), moe-pair's A/B in one session (A 7d879e6, B d29bfe9, A B A B; the first run of the repo's card_moe.sh): all 12 runs bit-exact against thei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
2026-10-01 moe_card records where the host's staging goes (docs/offload.md 10.6), after session 9's 35B (the same misses and DMA, staging 10.5 -> 20-32 s): host_decode_s.reads, the decode's pool reads by where 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
    [offload.py]
2026-10-02 docs/mtp.md 10.2: milestone 2, the MTP loop on the card (build 72256074, Gen1, 133.33 MHz). Every prompt gives plain greedy's tokens on the 0.8B, 2B and 4B (3 x 48 tokens each). Device tok/s, plain a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
2026-10-02 moe_card --release-weights and --willneed, the staging plan's levers (docs/offload.md 10.6). LazyWeights.release: the checkpoint's files closed (safe_open maps each whole; the pages the image build r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
    [offload.py]
2026-10-02 Layout.pitch: expert slots whole RUN blocks apart (docs/offload.md 10.6). gemma-4-26B-A4B's expert is 3,446,784 bytes (841.5 RUN blocks), so every other slot was off a 4 KiB block and BoardDram stage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
2026-10-02 test_layer_major_prefill_is_bit_exact (Qwen3.5-MoE): a case with the 35B's DeltaNet layout, its pairs sharing q and k (4 key heads) and group-major (pair_loop), R = 1 with build B's features; _tiny(n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
2026-10-02 The Engine releases the checkpoint itself when its experts stream from a pool file (docs/offload.md 10.6), so every user gets session 10's fix, not moe_card's alone: Engine(release_weights=True), the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
2026-10-02 Card sessions 11 and 12's results (docs/offload.md 10.6, 10.7) and tools/offload/sessions/session12.sh. 11: the 26B's slots whole RUN blocks apart, 2.65 / 2.69 tok/s against 2.39 / 2.42 (every expert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
2026-10-02 Program cache: the bucket programs once per process and image layout, and on disk for the next process (opentpu/progcache.py).
    - Engine(prog_cache=...), default on when OTPU_PROG_CACHE is set: a directory, or 1 for ~/otpu-build/qcache/prog. These go through the cache:
    - the generate loop's bucket programs (_generate_prog);
    - the resident decode's (_decode; _prefetch submits no compile the cache holds);
    - MTP's loop programs (MTPDecoder._gen_programs).
    - The key hashes the layout (Engine.layout: Spec, Config, cap, batch, rows, block, the image's keywords and choices), what is compiled, the source of opentpu but opentpu/host, and the OTPU_* environment.
    - On disk each program is its asse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
2026-10-02 docs/mtp.md 11: phase 4 design, sampled decoding on the card (a note, no code).
    - The plain loop already samples on the card (generate.Sampler; host uniforms once per run). What phase 4 adds is MTP's sampled mode.
    - With a one-hot draft (the MTP head's argmax), speculative sampling is "sample, then compare": a0 is the Sampler's pick with u[p + 1], and the draft is accepted when a0 == d. That gives P(accept) = p(d), and a rejection's token follows the residual.
    - V and E take a Sampler per row in place of Greedy; D and D1 are unchanged.
    - The tokens then equal the plain sampled loop's for the same uniforms, bit for bit, so phase 3's test carries over.
    - Section 5.2's two-uniform scheme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
2026-10-02 mtp.py loop_card: one deadline callback, passed only with a deadline (pyflakes: redefinition of unused 'late'). Same behaviour: the stand-in run_generate check gives timed_out at 0.3 s and the Timeou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
2026-10-02 Each request's own cost (docs/offload.md 10.8): the decode's windows ran ~5 s over the DMA thread per 128 tokens on both models. tools/offload/serve_emu.py runs the host side alone on the card's host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
2026-10-02 Session 13's result (docs/offload.md 10.8): the new serving against --legacy-serve on the card, bit for bit: 35B 3.74 / 3.75 -> 4.01 / 4.04 tok/s, 26B 2.62 -> 2.78 (predicted ~4.0 and ~2.8); the link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
2026-10-02 test_moe_layer_major_prefill_on_a_live_card: no card.waits > 0 check, misses > 0 stays. The waits count is timing: the host can write an expert's directory entry before the fake card's thread reaches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
2026-10-02 PCIe Gen2 x8 the build default (PCIE_GEN 2 in run_vivado.sh, bd_native.tcl and userclk1_reroute.tcl; PCIE_GEN=1 builds Gen1 x8): g2fix 0885d436 qualified on the card 2026-10-01 (2.29 GB/s host to car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
    [diag.py]
2026-10-02 Layer-major prefill without embed runs when the embedding rows come from the host's table (docs/offload.md 13.6): the card's port A (otpu_native_dram) keeps the beat of its last read and its 32-beat 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
2026-10-02 Gen2 x8's prediction for offload (docs/offload.md 10.9): session 13's DMA calls give the Gen1 link as offload uses it (an expert's record 1183 us for the 35B, 2360 for the 26B; a 64-byte call 49-61 u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
2026-10-02 PollPacer (docs/offload.md 10.10): the decode's polls sleep 0.75 x the shortest of each request kind's last 8 served -> next gaps (cap 5 ms, minus 100 us), then spin; never with hints pending, a hint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
    [offload.py]
2026-10-02 MTP phase 4 step 1: the sampled MTP loop on the ISA simulator and the RTL (docs/mtp.md 11.5)
    _verify_gen(samp=): a generate.Sampler per row (row 0: u[p+1], the loop's lg; row 1: u[p+2],
    a second lg in the MTP area), accept iff a0 == d, after(a0) / after(a1) for the penalty's
    context; E one Sampler. Row 1's draft penalty (_penalize_draft): an exact select by min/max
    against +-2^127 between the stored logit (d in the context) and min(x/R, x*R). Row 1 takes row
    0's penalty factors per chunk (Sampler(pen_from=)): 8 instructions a chunk for both rows instead
    of 10. Host: MTPDecoder.generate_card(sampling=, rng=, context=) (a0 = reference_pick with the
    generator's first uniform, then Engine._gener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
2026-10-02 docs/offload.md 13.6: the 35B on the card with the workaround (session lm3, g2fix 0885d436, tree bc546a4): token by token, layer-major R = 1 and 2 per-layer slots and R = 2 pooled all give 88225ff781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
2026-10-02 docs/offload.md 10.9: Gen2 x8 on the card (g2check.sh, 2026-10-02 00:31-00:37, production g2fix 0885d436, session 13's tree b40fc6f, all bit-exact): 35B 4.04 -> 5.07 / 5.10 tok/s (+25.5 / +26.2%, pre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
2026-10-02 Port A's held beats dropped where the host may have written (gemma4's 35B card mismatch): otpu_native_dram's reused beat (al_v) and A runs (pv) survived runs, program loads and WAITWs, and the host's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
    [otpu_board.sv, otpu_dma.sv, otpu_native_dram.sv, otpu_native_mem.sv, otpu_slice.sv, otpu_top.sv, rtlsim.py]
2026-10-02 docs/offload.md 10.11: one call per request, a design. The request's answer (its misses' slots by rank, one 64-byte beat before the first data), each missing expert's tag in a chunk after its record 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
2026-10-02 docs/offload.md 10.10: card session 14 (2026-10-02 00:47-01:04, tree 17e99eb, g2fix 0885d436, all 7 runs bit-exact): the poll's reads don't cost the MXU (the pacer cut them 57%, a 50 us sleep 82%; MX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
2026-10-02 One call per request (docs/offload.md 10.11, design A): a request's answer (its missing experts' slots at each id's first place, one 64-byte beat before their bytes) and each slot's tag (a 128-byte c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
    [beat_link.py, checks.py, offload.py]
2026-10-02 session15.sh: design A's card session: waitw.py --tag-rounds 2000 on the bitstream, then A against its parent (main e389dc1) A B A B, q35e128s and g26s with traces
2026-10-02 MTP phase 4 step 4: otpu-chat --mtp, the loop's last D before the HALT, prefill from Engine.pos (docs/mtp.md 11.6)
    The MTP loop's V records its end in S_END and always chains to D / D1, which halt there: the MTP
    layer's KV cache then holds every position before Engine.pos and MTPDecoder.draft the draft after
    the last token. MTPDecoder.prefill feeds new tokens from Engine.pos (the committed slot; on_run per
    run, which can stop it between runs); loop_card(halt=) polls a stop. Chat on an MTP engine
    (otpu-chat --mtp) prefills through the decoder (the host's first pick inside it), runs each reply
    as one loop_card from that token and the kept draft, resumes with /continue the same way, and
    shows t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
2026-10-02 test_qwen35_moe: test_moe_card_streams_as_the_resident_run: moe_card end to end on the ISA simulator (the tiny Qwen3.5-MoE checkpoint): 2 slots a layer from a split pool with --hint-trace, and --lega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
2026-10-02 docs/mtp.md 11.6-11.7: phase 4 on the card (e4db91c9, 2026-10-02 02:58-03:17 opentpu): sampled MTP equals plain sampled 9/9 at chat's default and 3/3 with penalty 1.1 (2B); device speedups 1.242x / 1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
2026-10-02 moe_card: the prompt's time split (prefill_time) and its timeline (--prefill-trace). prefill_time: the prompt's wall, runs, run_s (each run's start .. its wait's return), device_s (cycles), halted_s 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
2026-10-02 The controller's cycle breakdown after memeff (docs/litedram.md 11, "What is left after memeff"): otpu_ldc_mem +ldc_break classifies each controller cycle, from a channel's first command to its last,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
2026-10-02 docs/offload.md 13.7: where the prompt's time goes, measured on the card (pa e4db91c9, Gen2 x8, sessions pftime / pfpool, tree 333a6c1): the 35B on 134 tokens 23.14 s (R = 1) / 18.50 s (R = 2) / 14.6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
2026-10-02 boards/ypcb-00338/litedram/core.json: otpu_litedram.v's sha256 after porta-flush's crg_rst1 max_fanout 64 (d86549b changed the core and ld_test.py, which gen_core.py builds from, but not the recorded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
2026-10-02 otpu-chat keeps the bucket programs in the program cache by default (Engine prog_cache=True; --no-prog-cache opts out, OTPU_PROG_CACHE=0 keeps it in memory only): a new process no longer compiles bef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
    [chat.py]
2026-10-02 otpu-chat --mtp on the simulators (isa, rtl: no card configuration): a one-slice device configuration (the simulators' default has two; MTPDecoder runs on one)
2026-10-02 Layer-major prefill: the layer runs' programs compile in the worker processes ahead of their runs. prefill_layers now plans every run of the prompt first (key, run arguments, the host's rows written 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
2026-10-02 docs/offload.md 10.12: alternative B as a host window onto DRAM (design, ld-memch). A 32 KiB window in the CTL aperture's aliases (0x8000-0xFFFF of BAR0, split by address bit 15 in the board top; WIN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
2026-10-02 docs/offload.md 13.7: the lazy restore's cost as a fixed time per prompt: the decode's re-warming of its slots, 0.16 s (35B) and 0.24 s (26B) over the 16 tokens after the prompt (3.52 against 3.36 s,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
2026-10-02 otpu-chat --mtp on the simulators: the card's configuration (board_config: one slice, MCOLS 4, DSTEP, STREAM, PAIR; DRAM for the MTP image), not the design's: the sampled verify did not compile there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
2026-10-02 docs/offload.md 10.12: alternative B parked. offload's serve_emu (Gen2 traces, link calibrated to the card's calls, window write 3 us CPU / load 1.5 us): B after A gains 0 +- 0.05 s per 128 tokens (a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
2026-10-02 Session 15's result (docs/offload.md 10.11): design A against its parent main cb3dce5 on the card (production pa e4db91c9, A B A B, every run bit for bit against its own ISA reference; waitw tag 2000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
2026-10-02 fastmux in the core, ready to fuse with the next full build (docs/litedram.md 11, "The chooser and the turnarounds"): ctl_settings.py MULTIPLEXER = FASTMUX (rtw 3, same_cycle, direct_wtr; decode -0.7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
2026-10-02 docs/prefill.md: prefill at run-time positions, the design (1b, approved): the prompt's tokens through out[] (one LD per run, port B), tpos's six run arguments for any R (compile_rows_run fails on th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
2026-10-02 Layer-ahead streaming, the Engine side (docs/offload.md 13.8): Engine(layer_ahead=True | per MoE layer its expert order) gives the expert server the next MoE layer's experts to send while a layer run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
2026-10-02 (1b) step 2, host-started prompt runs (docs/prefill.md): Engine(prompt_runs=True) and MTPDecoder.prefill run a dense Qwen3.5's prompt from programs at run-time positions, compiled once per bucket, ki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
    - qwen3: RunRows(toks_at) and OutTokens: a run's tokens from the generate area's out[] (one LD per run), each embedding row (fp32, or int8 with its scales) gathered from scratch registers (_embed_word: RLD MUL into a DevVar), no run argument per token.
    - qwen35: qwen35_prompt_run / Image.compile_prompt_run: rows (P, L with the last row's logits, h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
2026-10-02 prefill.programs: on the card (backend runs_words, one slice) keep each prompt program assembled once, as the layer runs do: a run of another program (MTP's rows and M runs alternate, P -> L, a new b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
2026-10-02 ExpertServer.settle: begin_prefill and end_prefill first serve the card's last request if it is still unserved (docs/offload.md 10.11). A request whose experts are all present does not wait for the h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
    [offload.py]
2026-10-02 mtp_decode: plain card runs record the prefill's device cycles and runs (prefill_cycles, prefill_runs), for the per-run host overhead of prompt runs (wall minus device time, docs/prefill.md).
2026-10-02 TMEM arbiter: the VPU ahead of the MXU drain (docs/litedram.md 11, "The core's own gaps")
    Decode's core-side idle is attention's softmax: a head's PV MM waits for EXP2SUB (2 x 256 scores) and its
    QACT, and the in-order MXU holds the next head's MMs behind it. EXP2SUB averaged 501 cycles per op against
    about 270 for its three composite passes: the VPU writes all its lanes' banks at once and was last in the
    TMEM write priority, so an MXU drain write in any bank froze it for the cycle (395k VPU cycles per Qwen3
    token). otpu_slice's order is now DMA, COLL, VPU, MXU drain, QUANT. Co-simulated whole token (main RTL,
    133.33 MHz, DDR3-1066, pos 544): Qwen3 4-bit 3,844,073 -> 3,729,744 (-2.97%), LFM2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
2026-10-02 docs/offload.md 10.12: B after A on the card (offload, session 15): at most 0.3% on the emulator's model, but A's answer is not hidden on the card yet (232-246 us after seen, a cold first call of 75-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
2026-10-02 otpu-chat --wformat auto, the new default: the model's recommended mix (wformat "mix", formats.MIXES) where it has one (Phi-4-mini, SmolLM3-3B, LFM2-2.6B, Qwen3.5-4B), else int8 (formats.auto); Engin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
2026-10-02 Layer-ahead: prefill_layers tells the server with begin_prefill(ahead=True) (offload's contract: replace semantics, slots taken when an expert's first part goes out, end_prefill drops the queue); the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
2026-10-02 ExpertServer.ahead_layer(j, ids): a layer-major prefill's next layer streamed on the link's idle polls (docs/offload.md 13.4, gemma4's schedule). Called between runs; it settles first (the card's las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
    [offload.py]
2026-10-02 docs/litedram.md 11, the fused build (fastmux 5a088e5 + vpu-first ed66aba on main 5372244): the slice's OOC at 7.5 ns (main WNS +0.052, VPU-first +0.081, neither the arbiter; the new path, the VPU's 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
2026-10-02 docs/prefill.md 6: the checkpoint measured on the card and the chain parked (lead's rule: host-started per-run overhead <= ~3% of TTFT). Card (pa e4db91c9, 2026-10-02 07:18-07:37 opentpu, tree 76ef74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
2026-10-02 docs/formats.md: session mix3 (production pa, tree chat-auto d6a29e4): the decode loop on the card (refs.py card --card-loop, wformat mix) gives the ISA simulator's tokens for the 4B's and LFM2-2.6B'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
2026-10-02 docs/formats.md: the 4B mix's MTP comparison is a single-prompt observation (acceptance 0.61 against fp4's 0.67 is about 1 SE at 160 tokens; fp4's 1.53x here against mtp.md's 1.62x is the prompt's ef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
2026-10-02 The request's head (docs/offload.md 10.13), host only: seen to the first data call was 1.4-2.1 s per 128 tokens on the card (session 15), and A's answer, the window's cold first call, made it 0.35-0.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
2026-10-02 docs/offload.md 13.9, design: a card-side predictor for the layer ahead: layer j's runs end with layer j + 1's router on their output rows (moe_hint's route), posted as a hint the server appends to t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
2026-10-02 (1b) step 5, Qwen3-family prompt runs (docs/prefill.md 5): qwen3_prompt_run / qwen3.Image.compile_prompt_run (qwen3_rows over a RunRows, its tokens from out[]), so Qwen3, SmolLM3, Phi-4-mini and the 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
    Evidence: tests/test_prefill.py 12 passed (Mac, ISA simulator): Qwen3 with the second prompt across the bucket end at 256, two slices (8 rows a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
2026-10-02 prefill.r_max per bucket (the bucket's L program's fit, kept by the engine) instead of the last bucket's for every run: a later bucket's attention makes a longer program, so a short context ran at th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
2026-10-02 (1b) step 5, LFM2 prompt runs (docs/prefill.md 5): lfm2_prompt_run / lfm2.Image.compile_prompt_run (lfm2_rows over a RunRows, its tokens from out[]; the rows before conv_k - 1 at compile-time positio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
2026-10-02 docs/offload.md 10.13: session 16 on the card (pa e4db91c9, all bit-exact): the 35B 5.10 -> 5.26 tok/s (+3.2%, predicted 5.20-5.27), the 26B 3.57 -> 3.60 (+0.7%, predicted 3.63-3.65). The head fell a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
2026-10-02 ExpertServer: a hint for ahead_layer's layer adds to the end of its queue (docs/offload.md 13.4; gemma4's card-side predictor, 13.9): the card's router on the layer before it, posted as a hint line i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
2026-10-02 docs/offload.md 10.13: the answer's call, a design note: bound 0.22-0.28 s per 128 tokens on the 35B (+0.9-1.2%), 0.14-0.16 s on the 26B (+0.4%), from session 16's H runs capped by the W model's slac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
2026-10-02 docs/litedram.md 11, the fused build on the card (542fc43a, opentpu 2026-10-02 09:40-10:15, one lock, production pa restored): qual.sh fast 0 FAIL / 44 PASS; the six decode counters on their co-sim p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
2026-10-02 serve_emu in the repo as the predictions run it (docs/offload.md 10.13): the card models (--post-c: the card's time from the critical end, per request; --card-w F,m:W: also its own compute, no post s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
2026-10-02 Decode after the fused build, the controller's share (docs/litedram.md 11): on the fused RTL decode is controller-bound (busy 99.2-99.4% of the token; data 94.0 / 94.6 / 94.4%, refresh 2.7, rows 1.2-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
2026-10-02 (1b) step 5: prompt runs only where they take today's rows (prefill.covers), bucket 1's programs warmed at engine start, R_max kept in the program cache. docs/prefill.md 7: on 12 real layouts (cap 40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
2026-10-02 (1b) step 5, Gemma 4 E2B prompt runs (docs/prefill.md 7): gemma4_prompt_run / gemma4.Image.compile_prompt_run (gemma4_step's rows over a RunRows: each row a _RowPos, its KV slot, sliding window and m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
2026-10-02 docs/litedram.md 11, refresh in the idle time: the tREFI the core and the model use (LiteDRAM's DDR3 7.8 us = 64 ms / 8192, 1042 cycles at 133.33 MHz, the normal temperature range; 3.9 us is not conf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
2026-10-02 docs/prefill.md 7: a looped attention as a later item (the lead's): bucket 16's programs grow with the rows times the blocks (attention unrolled per row, KV head and block), so Phi-4-mini's mix (prom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
2026-10-02 Capped hints (docs/offload.md 12.7): ExpertServer.hint_n / hint_top (moe_card --hint-n / --hint-top): of a hint's first hint_top ids the first hint_n not in a slot get one, the others no slot and no 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
2026-10-02 tools/h2c_sweep.py: the host->card DMA rate sweep for the H2C item (what holds XDMA's writes at ~2.3 GB/s on Gen2 x8). Per point (call size 64 KiB-8 MiB with offload's record halves 0.83 / 1.72 MB, D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
2026-10-02 tools/offload/sessions/session17.sh: one lock on production fmvf 542fc43a (EXPECT): (b) LFM2.5-8B-A1B token-exact (8b16, 8b160 with LFM160=1) from a /dev/shm pool behind links in O, deleted right aft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
2026-10-02 docs/prefill.md 7: the card session (fmvf 542fc43a, 2026-10-02 11:04-11:13 and E2B 11:16-11:28 opentpu, tree ce0f3b1): prompt runs on (cold) / off / on (warm), tokens equal in every phase for Qwen3-0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
2026-10-02 h2c_sweep: the host buffers' pages in three kinds: private on THP (madvise HUGEPAGE), private on 4 KiB pages (NOHUGEPAGE), and shared anonymous (shm: board.placed's and the staging buffer's, shmem on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
2026-10-02 docs/offload.md 13.10 rewritten around both sessions: pfhint2 (2026-10-02 11:29-11:48 opentpu, fmvf 542fc43a, tree ca913e4, 12 runs bit-exact, base / hint 1 MiB / hint 4 MiB twice a model): on the me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
2026-10-02 Idle parts read ahead, one DMA call each (docs/offload.md 13.10): ExpertServer.read_ahead (default on; moe_card --no-read-ahead): before a poll flushes, the part the next idle poll would send is read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
2026-10-02 Selftest, otpu-diag and dma_bench measure the link from placed host buffers (board.DMA_PLACE), with the staging copy's H2C rate on the side: they wrote from unplaced buffers, so their 2.3 GB/s was Xd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
2026-10-02 prefill.r_max in fit_chunk's run sizes (the lead's follow-up to the step-5 card session): one MXU pass, then whole passes of MCOLS rows up to the image's rows, where the bucket's L program fits; Qwen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
2026-10-02 An expert landing as its request is posted (docs/offload.md 12.8): an idle poll reads seq, then lands a hinted / ahead expert (last part with its tag, then its entry); a request the card posts after 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
    [offload.py]
2026-10-02 Idle parts opt-in (moe_card --idle-parts v1|ra|halt|v2, default v1 as before): read_ahead (fa3a514) and halt_aware: no idle part starts while the running program's expected end (BoardBackend.time_lef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
2026-10-02 docs/offload.md 13.11, design: expert-major MoE in layer-major prefill (ld-memch's idea; the lead's B). Each layer of a chunk: mixer runs (the previous layer's combine, the mixer, the router's k best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
2026-10-02 halt_aware's expected end from the run's own clock (gemma4): BoardBackend.run_clock gives the started run's start and its time with no waits (the least of its program length's last RUN_CLOCK_N = 16 r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
    [board.py, offload.py]
2026-10-02 Gemma 4 E2B's recommended mix attn@15-34=fp4,mlp@15-34=fp4 (the KV-shared layers' attention and MLP in fp4: an estimated 8.88 tok/s, 35% over int8, dKL +3.34% (SE 0.08) against int8 with the int8 PLE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
2026-10-02 prefill: a new context's first run sized on its own, R_max(0) (split's rm(0) for the runs before conv_k - 1, probed at position 0, warm's first run). The card's recheck of 666b2ef (fmvf 542fc43a, 13: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
2026-10-02 Expert-major MoE in layer-major prefill, the card and Engine side (docs/offload.md 13.11, 13.12): Engine(expert_major=True)
    Each MoE layer of a chunk: its layer runs (moe.moe_prologue_rows: the norm with its 1 / rms kept, the router and the k best as moe_ffn_rows', the ids / weights / 1 / rms to the row's record tail, the R k ids posted as a need line at 2 x layers x E, then the shared expert or Gemma 4's normed dense MLP to SH), then one expert run (moe.moe_expert_run, a program a layer, run arguments rows and entries): the tables (each entry's row and place), ld-memch's bucketing (an opening entry sets B = A: an odd count's last pass computes its row twice, no sink), and the passes (WAITW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
2026-10-02 docs/prefill.md 7, the device's part, co-sim levers: the 0.8B DeltaNet rows' VOPs measured below the bar and not merged (gates over the R rows at once and the q/k L2 norms' sums side by side, the sam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
2026-10-02 Gemma 4 E2B's default mix is attn@15-24=fp4,mlp@15-34=fp4 (was attn@15-34=fp4,mlp@15-34=fp4). Session mix4 (fmvf 542fc43a) measured the first pick at 8.47 tok/s, 32.5% over int8 with the host's int8 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
2026-10-02 prefill: R_max holds every run a prompt asks for, and an odd R takes R - 1 rows where PAIR makes them cheaper (the lead's two items after the card's rechecks). (1) _probe: the largest size at which e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
2026-10-02 docs: E2B's long prompt, the lead's points: formats.md's session mix5 gives the 1500-token TTFT (100.3 s warm on today's route, 536 runs, 31 s host compiles; the first pick an estimated 62 s on promp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
2026-10-02 docs/prefill.md 7: the row choice on the card (fmvf 542fc43a, 2026-10-02 14:15-14:18 opentpu, tree 5dd7823; ABBA after warm-ups, tokens equal in every phase): the 4B at R = 2 against 3, 237 tokens 18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
2026-10-02 docs: gemma4's review: gemma4.md's long prompt says the 58 ms a run on the host are in series with the device (today's route compiles each run's program before it starts: 31 s), why the cold run is n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
2026-10-02 The expert-major prefill's need path on the host (docs/offload.md 13.11, 13.13; the server's share). Layout.need_off (2 x layers x E): a need line, served at once with no answer and no use; ExpertSer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
    [offload.py]
2026-10-02 The scratch from the slot region's first slots (Layout.scratch as gemma4's moe.em_slots: compile-time from layout.slots[0][0]; 13.11 said the last). The live-card tests' card.waits made robust to the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
    [offload.py]
2026-10-02 formats_scan: Gemma 4 26B-A4B's dense layers on the card's experts and head (--base experts=fp4,head=fp4: formats every row starts from, the int8 row's own; no head row where the base sets the head).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
2026-10-02 prefill: PREFER_MARGIN 10% (was 5%), after ld-memch's RTL co-sim: mxu_time overstates R - 1's gain (Phi-4-mini's fp4-MLP layer 6.1% cheaper a row at 2 rows by mxu_time, 0.5% dearer in the co-sim, 2 r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
2026-10-02 moe_card --expert-major: Engine(expert_major=True) with --layer-major and pooled slots (docs/offload.md 13.11, 13.13); the result's expert_major and prefill_time.need (the server's need_lines, needs_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
2026-10-02 docs/prefill.md 8, rows a run, R = 3 against R = 2 (RTL co-sim, 4 to 8-layer slopes, a mix's layer types apart): Qwen3.5-4B fp4 -13.8% at R = 2 (card -13.3%, MXU time -25%); Phi-4-mini mix at bucket 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
2026-10-02 Prompt runs: the additive mask (docs/prefill.md 9). A prompt run's masked attention block loads its row's mask tile into the score buffer and accumulates q.K^T into it with the row maxima (MM ACC + R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
    [compiler.py]
2026-10-02 The halt-aware hold on the card (pfv2: holds 0 in every v2 run): BoardBackend.wait cleared the running programs before it served the run, so run_clock() was None at every poll of it; now cleared once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
    [board.py, offload.py, test_board.py]
2026-10-02 Simulator temp dirs go on any exit and stay off RAM-backed /tmp (opentpu/simtmp.py): rtlsim's runs (otpu_*), the board model's (otpu_board_*) and bench_llm / perf_prefill / perf_ddr's (otpu_bench_, o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
2026-10-02 Qwen3.5-35B-A3B's fp4 LM head fails its bar: tools/head_proxy.py scores the head alone on a Hugging Face model's own final states (bf16, CPU; the float head against the int8 and fp4 heads on the stat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
2026-10-02 v2 idle parts the default (session 18: the lead's ruling): ExpertServer.halt_aware on, moe_card --idle-parts v2. Session 18 (2026-10-02 16:09-16:28 opentpu, 542fc43a, 651876c, 12 runs bit for bit, wa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
2026-10-02 simtmp off the card's path, and a forked child forgets its parent's runs: host.board imports simtmp in SimTransport.flush (the board model's run) instead of at module level, so the card's own process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
2026-10-02 Expert-major against the real ExpertServer (docs/offload.md 13.13): the tests' stand-in _need_server goes; the needs in idle-poll parts of Engine.ahead_part; an expert run's timeout names need_report
    - tests: test_qwen35_moe's 4 and test_gemma4_moe's 3 expert-major cases run on offload's ExpertServer (13.14) through qwen3._isa_host: logits, states, KV and decode bit for bit as before; the scratch is the first slot's address and moe.em_slots' slots, need_lines a layer run, needs_landed == needs_queued > 0, drained 0, the scratch handed back. The Qwen3.5 case also has the embedding rows from the host's table (the 35B's --embed-table host).
    - Engine.prefill_layers: expert-major passes part=ahea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
2026-10-02 docs/prefill.md 9: the card (window3, fmvf 542fc43a, 2026-10-02 16:36-16:54 opentpu; prompt runs cold, warm, then today's route; tokens equal in every phase): E2B's mix 1500 tokens at cap 2048 in pro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
2026-10-02 docs/formats.md: Gemma 4 26B-A4B's dense layers. The scan (formats_scan scan --base experts=fp4,head=fp4, groups 0-11 and 12-29) stopped for the wrap-up after three variants (omarchy, 2026-10-02, 900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
2026-10-02 docs/offload.md 13.13: expert-major's status (merged, dormant, bit for bit on the ISA with the real ExpertServer, not run on the card) and the pfB card A/B plan: A today's default (layer-major pooled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
2026-10-02 docs/offload.md: 12.10 hints closed (17, pfv2, 18 on the card; -22% misses, contention and polls); 13.12 the gain is halts seen sooner (wall - device - between 1.18 / 1.14 -> 0.44 / 0.45 s), the 26B 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
2026-10-06 fp32 fixes: multiply flush boundary, recip/rsqrt range scaling, q8(NaN), MM -0 partials, ARGMAX ties in a chunk, NaN model = RTL
    RTL (bit-exactness and correctness):
    - otpu_fp fp_mul_s2: a product in [2^-127, 2^-126) is kept as 2^-126 when IEEE rounding on the
    subnormal grid gives it (mm all ones), not only when 24-bit rounding carries
    (0.5 * 0x00FFFFFF: RTL 0, model 2^-126). Every multiplier (VPU, SE, MXU scales, quantizer).
    - recip / rsqrt (otpu_se_comp = the board's composites, the VPU long lanes, the quantizer's
    recip of amax, otpu_fp's reference): out-of-range inputs run scaled by 2^+-4 and the result's
    exponent is adjusted back (carried in ii; finish's EXP2 adder). Unscaled, rs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
    [fp32.py, isasim.py, otpu_fp.sv, otpu_quant.sv, otpu_se_comp.sv, otpu_vpu.sv, quant.py, test_autodecode.py]
2026-10-06 tools/qual/fpcard.py: the fp32 corners on the card against the ISA simulator (test_fp_rtl's programs at the board's configuration: MUL / ADD / SUB at the flush boundary, the composites on their scale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
2026-10-06 test_fp / fpcard: the multiply's boundary products at e1 + e2 = 127 (2^-126 (1 - 2^-24) and one exponent either side); e1 + e2 = 253 put them near 1, so only the three written-out vectors reached the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
2026-10-07 fpcard: scrub the DRAM once per configuration first (Board.scrub): run right after production's JTAG load in the fp-fix session, before any scrub, it read beats not written since configuration and th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
2026-10-07 otpu_mem_ch: the write-accept counts cross per controller port (n_wdone, XDMA's B)
    The two ports can each take a write in the same uclk cycle, so the per-master count of both
    stepped by two, two bits of its gray code: a sample caught between them read one beat ahead
    (from an even count) or one back (from an odd one), and XDMA's B, an unsigned compare, then came
    before its beats were taken, and every queued burst's B after it (x_wacc_c - x_wdone = -1).
    Now one count per port and master (g_port[p]: at most one a cycle, one gray bit), synchronized
    and decoded per port in the master's clock and summed there (n_wdone and x_wacc_c a cycle later);
    B compares the difference as signed (no B when nega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
2026-10-07 generate.Sampling: top_p <= 0 keeps the first token, as Hugging Face's top-p (min_tokens_to_keep 1) and chat.sampler. Sampler's rule keeps the first i with sum(p[:i]) < P * sum(p): none at P = 0 or a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
2026-10-07 chat.sampler(softcap=): the host's sampler caps the logits with Gemma's final_logit_softcapping before the penalty and the warpers, as Hugging Face's model does (Engine.step / prefill return raw logi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
    [chat.py]
2026-10-07 otpu-chat sampling defaults: the checkpoint's generation_config.json when it samples (do_sample; Hugging Face's defaults for the keys it leaves out: temperature 1, top-k 50, top-p 1, no penalty), els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
2026-10-07 tools/validate.py: the device's greedy tokens and logits (ISA simulator, Verilator RTL or the card) against a CPU golden, Hugging Face in fp32 with openTPU's quantization: the weights the MXU multipl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
2026-10-07 MM: N and KB must be at least 1 (docs/isa.md; isasim raises SimError)
    An MM with KB = 0 (N, M > 0) wrote +0 into its M x N outputs (old + 0 with ACC) and +0 RMAX
    words in the ISA simulator, while the RTL's MXU skips it (cmd_tz: no issue, no drain, no RMAX)
    and its scoreboard footprint is empty; N = 0 with RMAX failed in the simulator with numpy's
    ValueError (argmax of empty rows). isa.mm already asserts both, so no compiled program has
    them: the ISA now requires N >= 1 and KB >= 1 (the simplest rule; matching the simulator's +0
    writes in the RTL would add MXU logic for an MM nothing emits), and the simulator raises
    SimError("MM: N and KB must be at least 1").
    Test: test_isa.py::test_mm_need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
    [isasim.py]
2026-10-07 Register-relative fields only where docs/isa.md writes R[x] + w; GATHER's dst checked resolved
    The sequencer added R[rb] to every w2 and R[rc] to every w3 (STREAM aside), so LD's and ST's n,
    QACT's (rows, ab, KB) and srs, and GATHER's (rows, cols) moved with registers the instructions
    do not name, where the ISA simulator and docs/isa.md take them as immediates (the assembler
    encodes 0 there, so no compiled program differs). otpu_seq now adds R[rb] to w2 except QACT's
    and R[rc] to w3 except LD's, ST's, QACT's and GATHER's (two opcode-decode enables on the
    R stage's operand muxes, beside the register reads; R -> P register).
    GATHER: otpu_coll writes every slice's TMEM at slice 0's resolved ds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
    [isasim.py, otpu_coll.sv, otpu_seq.sv]
2026-10-07 Scoreboard: STREAM's DRAM destination in its footprint
    A STREAM writes Y to dst = R[ra] + w3 (otpu_dma su_dst), which the RTL runs whenever dst equals
    src or does not overlap it, and which the compiler emits (compiler.stream's dst, deltanet_step
    into another state: Qwen3.5's MTP verify writes the last row's state to the other slot), but
    the footprint marked only [src, src + 256 KiB) written. A younger LD, ST, MM, DSTEP, STREAM or
    QST touching dst could start first (the DMA starts its oldest ready instruction, the MXU
    streams once its DRAM dependencies clear). The footprint's third write range, wr[2] =
    [dst, dst + 256 KiB), goes into the segregated footprint's second DRAM range (d[1], unused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
2026-10-07 Scoreboard: a QST's DRAM footprint covers every word of the 64-byte beats it writes
    otpu_native_dram writes a QST's partial beat whole after a fill read of it (so the controller's
    read-modify-write, a channel read latency per beat, never runs for a V^T column), which is not
    atomic: a port-B write (DMA ST, DSTEP / STREAM write-back) to the beat's other bytes between the
    fill read and the write was lost. The scoreboard did not order the two: a QST's footprint was
    its byte hull, and an ST into the words of its first or last beat outside the hull, or of its
    scales' beats, could run beside it. Byte masks on the SW writes would make every partial QST
    beat a channel RMW (what the fill read avoids),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
    [otpu_native_dram.sv, otpu_pkg.sv]
2026-10-07 Scoreboard: a DRAM range reaching 2^32 ends at the last byte instead of wrapping to 0
    otpu_pkg mk() computed hi = lo + len in 32 bits, so a range ending exactly at 2^32 (the board's
    DRAM is 4 GiB: its top words, or a STREAM's 256 KiB near the top, which wrapped to a low hi)
    got hi <= lo and overlapped nothing: no dependency either way, and WAITW's [0, 0xFFFFFFFF)
    missed it too. mk() now saturates hi to 0xFFFFFFFF on the add's carry (Q stage; the select
    joins the valid-bit mask fp_seg already applies, and the scoreboard's 32-bit compares are
    unchanged). The lost top byte never decides an overlap: every DRAM range starts at a word
    (DMA, MXU, WAITW) or covers its beats' words (QST, beats()), so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
    [otpu_pkg.sv]
2026-10-07 refs.py: references of format 2 (32 greedy tokens past EOS, every logits vector's sha256 and top 5), a long prompt and prompt runs; key gaps
    The card check compared argmax tokens only, and every reference ended at the one-sentence
    answer's EOS after 8 tokens, at positions below 32 (no bucket crossing, no low-order bits, no
    prompt runs). Now a reference holds NTOK = 32 tokens decoded past EOS (no stop ids) and the
    digest of every logits vector a token was picked from; the card check compares the tokens and
    the logits bit for bit (per position and resident: all 32; the decode loop: the prefill's).
    --long: LONG_TEXT cut to 240 tokens, so the decode crosses position 256 (CAP 512);
    --prompt-runs: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
2026-10-07 qual.sh: the card must run the candidate's build; exit status, early exits, the probe, dmesg and the references' job are FAIL lines; the token-exact checks of refs.py v2
    load() lost openFPGALoader's exit status in a pipe, and the rescan only grepped the ID every
    openTPU bitstream answers with: a busy cable left the old bitstream up and the qual passed it
    under the candidate's name. Now the loader's status counts, and Board.info's BUILD_ID must be
    EXPECT (default: the deploy's name's last 8 hex digits) after the load (LOAD=0: at the start)
    and at the end; after REST's load REST's (REST_EXPECT, else its resolved directory's). A
    failed load, another build or a failed probe of BUILD_ID and CAPS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
2026-10-07 omarchy_test.sh: ship the script's own worktree, say which (tree, commit, uncommitted edits), delete what it no longer tracks
    top came from the current directory: agents' cwd resets to the main worktree, so bash
    /path/to/tree/tools/omarchy_test.sh shipped and tested main's code. And the untar went over a
    persistent ~/otpu-test/<name>: a module or test deleted here stayed there and kept passing.
    Now top is the script's tree, stderr names it with its commit, and after the untar the files
    the tree does not track go (build/, models, obj_dir and __pycache__ stay; a package whose
    sources all went loses its __pycache__ too, else it imports as a namespace package).
    Test: tests/test_omarchy_test.py (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
2026-10-07 tests: the skips by reason at the end of every run; the board model's WAITW and trace buffer are asserted, not skip conditions
    A gate's "36 skipped" did not say which coverage it lacked (missing checkpoints, no
    Verilator, slow tests). conftest.pytest_terminal_summary now prints the skips grouped by
    reason with their counts. test_moe_on_board_model skipped when the board model had no WAITW
    (CAPS bit31), and test_otpu_lens_record_on_board_model when it had no trace buffer: the tree's
    RTL has both (otpu_ctrl.sv's CAPS, otpu_trace.sv), so either missing is a regression and now
    fails; without Verilator they skip through have_verilator as the other RTL tests do.
    Test: tests/test_skip_summary.py
2026-10-07 attention: a partial last bucket's masked block ends at the cache's end (cap - t0 tokens): with cap a multiple of D but not of the attention block (640, 384, 896) resident decode and prompt runs read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
    [compiler.py]
2026-10-07 compiler: address registers never start a run-time value where an earlier use counts on 0, nor count on a value set inside a guard. (1) _free_for: a key with a run-time term (RunVar, DevVar, a run_wo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
2026-10-07 progcache: the key hashes opentpu/host/offload.py too (HOST_KEYED): compiled programs take its LINE, TAG, RUN, Layout and RowLayout (the expert and row mailboxes', slots' and tags' places: kernels/ma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
    [progcache.py]
2026-10-07 LOOP: nested bodies ending on the same instruction are refused at issue whatever the count (isasim checked it only for a count other than 0, where a 0-count inner loop jumps past the enclosing body's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
    [compiler.py, isasim.py, test_compiler.py]
2026-10-07 isa / isasim / compiler: the checks docs/isa.md asks for. isa.py's field-width and flag checks raise ValueError (asserts let python -O truncate a word silently); GATHER and DSTEP check their packed r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
    [compiler.py, isa.py, isasim.py, test_compiler.py]
2026-10-07 tests/test_validate.py: the golden on tiny random Qwen3 / LFM2 / Qwen3.5 against the ISA simulator (int8 and fp4: every top-1 the device's, KL 5x below fp32's at least; a golden with the emulation's 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
2026-10-07 Board ends runs before anything writes the card: quiesce on a locked open, stop on errors, signals and exit; the stop word's beat alone; bounded waits; SNAP and CHASH probe fixes
    Host review aa2006fb items 1, 3, 4, 8, 9 (and the qual review's "Board() never quiesces").
    1. Board.stop(wait): up to `wait` s for HALTED, CTRL = 0, 1 ms for a cut-short run's port B reads,
    then STATUS QUIET (board.QUIET = WR_IDLE; fix-board may add a bit) polled up to 1 s; nothing with
    RUN clear, nothing on a card whose otpu-lock has gone (LockLost). A locked Board() quiesces first
    (before calibration and before BoardBackend's scrub / image write): a run another process left
    going is waited for up to Q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
    [board.py, ddrcal.py, fake.py, test_ddrcal.py]
2026-10-07 otpu_mem_ch +cdc_skew: a bit once seen new stays new
    The skew model let a faster destination (xclk 250 MHz against uclk) sample a bit new, then old
    again on its next edge (each sample chose now or a source cycle earlier at random): a per-port
    count read 1 ahead and then 1 back, x_wd went negative and the RTL's $error fired (gen2skew,
    gen2skewx ABORT on the fixed code). A wire's change arrives once: the mask now spares the bits
    the first stage has already seen new. The two-bit step of a count summed over both ports (the
    bug mutations 33-35 restore) still mixes old and new bits in one sample.
    [otpu_mem_ch.sv]
2026-10-07 Offload: the mailbox's seq goes back to 0 between runs before fp32's 2^24; BoardDram writes a directory span's beats only
    Host review aa2006fb items 5 and 7.
    5. The card posts seq + 1.0 in fp32 (moe.py, kernels/mailbox.py): at 2^24 the sum rounds back, the
    post repeats the last seq, the host takes it for no request and every miss after waits out its
    WAITW (~22 h of the 35B's decode in one process). ExpertServer.rebase / RowServer.rebase: from
    SEQ_REBASE (2^23) on, between runs, the request still unserved is served (settle / poll) and the
    mailbox's seq and served are set back to 0. BoardBackend.start calls them before each run
    (BoardBackend.servers, set by the Engine beside Bo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
2026-10-07 Run stops: the loader and RUN wait for the memory path, WAITW's timeout between reads, DSTEP / STREAM without SE illegal
    The board's DRAM adapter (otpu_native_dram) does not reset with RUN, so a run the host stopped
    (CTRL = 0) left its reads coming back and its writes going:
    - the loader took an old read's data for the first rows of the next LOAD (or HALT CHAIN): it now
    starts its reads once the adapter has no read in flight (rd_idle, new output of otpu_dram /
    otpu_native_dram through otpu_top / otpu_slice; ld_go), and a rst ends a CHAIN reload (ld_ch)
    while a LOAD the host writes restarts the loader;
    - the next run's units took old reads' data: otpu_board holds core_rst until rd_idle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
    [otpu_board.sv, otpu_dma.sv, otpu_dram.sv, otpu_native_dram.sv, otpu_seq.sv, otpu_slice.sv, otpu_top.sv, rtlsim.py]
2026-10-07 Board resets and status: control / CSR ports across a hot reset (otpu_axil_iso), STATUS ECC_DED, RUN and LOAD only while calibrated, TEMP without the calibration
    - The LiteDRAM core's CSR crossing (AXILiteClockDomainCrossing, async FIFOs ctl <-> sys) had its
    ctl side reset with xrst (PERST#, hot reset, link down) and its sys side with the core's own
    reset only: a ctl reset alone left the sys side's pointers ahead (old CSR accesses replayed).
    Its ctl side now resets with the core's sys reset brought into the CSR clock (ld_crs1/2), so
    both sides reset together. The SmartConnect (the CSR port's and the control registers'
    master) resets with axi_aresetn, which the control registers (co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
    [board.py, diag.py, memcal.py, otpu_board.sv, otpu_ctrl.sv]
2026-10-07 otpu_trace: TRACE_COUNT saturates in its high bits only, so a ring past 2^32 records still reads oldest first
    The count stuck at 2^32 - 1 while the ring's write slot went on: past 2^32 records the host's
    oldest record (TRACE_COUNT mod DEPTH, Board._trace_out / hwtrace.ring_order) was anywhere. The
    low log2(DEPTH) bits now always count (they are the write slot, sim check), the high bits stop
    at ones; count stays >= DEPTH, so STOP_WHEN_FULL and the host's wrapped / lost are unchanged.
    Board's trace stats add saturated (count's high bits at ones: lost is a lower bound), which
    hwlens's note says. Sim only: +trace_count0=<hex> starts a clear's count there.
    Test: test_observability.py test_trace_r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
    [board.py, hwlens.py, otpu_ctrl.sv, otpu_trace.sv]
2026-10-07 tools/qual/runend.py: the card check of how runs end (Board.stop, quiesce, SIGTERM)
    Three checks for the lead's card session (not run: no card access here), each a [PASS] / [FAIL]
    line: a run with 16 KiB LD / ST in flight cut short by Board.stop leaves STATUS RUN clear and QUIET
    set, and the demo then runs bit for bit as the ISA simulator (checks.run_demo: no stale port B read
    in IMEM, no late write over it); a holder SIGKILLed mid-run leaves its run to the next open, which
    refuses it after QUIESCE_WAIT (2 s here) and cuts it short with OTPU_STOP_RUN=1, the demo passing
    after; a holder sent SIGTERM mid-run exits 143 with RUN clear. Run under otpu-lock.
2026-10-07 otpu-lock: OTPU_LOCK_HELD stays the bare device name, its pid goes in OTPU_LOCK_PID
    <dev>:<pid> broke mixing trees: an older tree's tools under the new otpu-lock compared the
    variable with the device name and took the lock (DeviceBusy), and the new tools under an older
    otpu-lock (the card host's installed one) saw no pid. A tool now checks the pid the lock file
    names (every otpu-lock writes its own there; OTPU_LOCK_PID's when set): an ancestor that holds
    the flock. Checked both ways with 982d668's tree.
    [runstate.py]
2026-10-07 memch_test: a synchronized count's sample is never ahead of its count; write-only skew scenarios
    otpu_mem_ch's skew model (sim only) now errors when a first-stage sample decodes ahead of the
    count it samples, the invariant one-bit steps keep. New scenarios skeww (ldn) and gen2skeww
    (xreg): XDMA writing only, unstalled, the controller model busy half the time, so both ports
    take XDMA writes in one cycle more often. On the fixed RTL skew, skewsh, skeww, gen2skew,
    gen2skewx and gen2skeww pass. Mutations 33-35 (a count summed over both ports before it crosses,
    the bug dc5b486 fixed) are caught: xreg gen2skeww "XDMA's beats taken (144) behind its answered
    bursts' (145)" (a B before its beat was t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
    [otpu_mem_ch.sv]
2026-10-07 test_run_dropped_then_load_and_run_at_once: drops at 600, 1300 and 2500 cycles
    On main's RTL the drops at 600 and 1300 (during the first LD's reads) hang the second program
    (STATUS 0xe8: RUN, no HALTED, at the board model's cycle cap); 2500 and 4000 pass there (no read
    in flight). The fixed RTL passes all.
    [test_board.py]
2026-10-07 validate.py's bound is the floor: the device's mean KL from the quantized golden at most 3x the golden's own against a 1-ulp nudge of its inputs (--kl-ratio; or --max-kl, 1e-3), top-1 at least 80% (-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
2026-10-07 test_autodecode: the decode loop on the device at a partial last bucket (cap 384: bucket 2's masked block the cache's last 128 tokens) gives the per-position programs' tokens across 256 for Qwen3, LF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
2026-10-07 otpu_tmem: the simulation's TMEM dump is the memory itself (the first copy's block RAMs, every other copy checked against them), not a shadow of the write requests
    The tmem_<SID>.hex that assert_same_state, test_fp_rtl and test_vops compare was a flat shadow
    written from bw_* (the selected writes, before the registered write stage): a defect in pw_*,
    the RAM's addressing or a replica's write showed only if a later instruction read the word, and
    test_rtl's fuzzers write fresh TMEM destinations nothing reads again. Now on dump the first
    copy's banks (DP) copy their words into img; a cycle later every other copy is compared with
    them (a difference stops the simulation with the copy, word and bo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
2026-10-07 validate.py --no-golden: the device's run alone (--save; and --against), so that a card session is the card's run only; --against a saved card run runs the simulators in the configuration the card ra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
2026-10-07 validate.py on the RTL (omarchy, the lead's go): LFM2.5-230M int8, 'The capital of France is', 3 tokens, --backend rtl --against isa: the RTL's logits bit for bit the ISA simulator's over the 3 steps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
2026-10-07 emulated_logits: P V as the device's flash attention takes it (kernels/attention.py _attend_heads): V as int8 values and one scale per token, the scales folded into the softmax numerators before P is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
2026-10-07 tests/conftest.py IsaCard: a late piece that ends inside a 128-byte beat pair carries the bytes after it as the run left them, not zeros. A late region of one row of logits (4 * vocab bytes, vocab no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
2026-10-07 turnaround.py: the ECC counters count since the last scrub (fix-board's Board.scrub clears them), not since the configuration
2026-10-07 emulated_logits: an exact rounding tie rounds as the device's quantizer rounds it (_fake_q: fp32.quantize on the block in fp32, x * 127 recip(amax)), not half to even. Gemma 4's emulation was 0.5-1% 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
2026-10-07 tests: a temporary root per pytest session (pytest-of-<user>/pid-<pid>, removed at the end) unless --basetemp is given: gates side by side on omarchy removed each other's default directories mid-run 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
2026-10-07 Board on fix-board's RTL: start() checks that the card took RUN, wait() raises on an ECC error during the run, stop()'s 1 ms only for older bitstreams
    - start(): STATUS after RUN; RUN still clear (CTRL takes neither RUN nor LOAD while CALIB0 /
    CALIB1 are not both set) raises, naming the uncalibrated channel, instead of a wait that
    polls HALTED until its timeout (RUN_TIMEOUT). One register read per run; not on the board
    model (a script).
    - wait(): STATUS ECC_DED (bit 9, sticky until the ECC counters' clear: Board.scrub) set
    during the run raises after the run is stopped (after ERROR and AXI_ERR); set before it
    (the same STATUS read as start's), stats["ecc_ded"] says so and the Board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
    [board.py, fake.py, test_board.py]
2026-10-07 tools/validate.py: Gemma 4 (E2B, E4B) against Hugging Face. The golden takes the device image's formats (gemma4.Image follows the card's fit: E2B's int8 image has its PLE table in 4-bit; image_format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
2026-10-07 qual.sh: the host tree's sha from its COMMIT file when the tree is a staged copy without .git (deploy_fixall_84989047's qual printed git's 'fatal: not a git repository' and an empty sha)
2026-10-07 exp2: minimax coefficients instead of Taylor (same degree, Horner and op count; C0 = 1)
    EXP2_COEFFS were ln2^k/k! rounded to fp32: the degree-7 Taylor truncation is 11 ulp at f = 1,
    so exp2 was up to 13.1 ulp off near f -> 1 (mean 2.7 ulp over [0.5, 1), 27% of uniform x in
    [-126, 128) above 1 ulp). The new C0..C7 (3F800000 3F317218 3E75FDE9 3D63593E 3C1D8534 3AAFE2F6
    3916C07C 37B3C7D6) are a Lawson minimax fit of the relative error with C0 = 1, rounded to fp32,
    then a coordinate search on the fp32 bits for the smallest error through the fp32 Horner steps.
    Measured: max 1.258 ulp over every fp32 f in [0, 1] (mean 0.32 over [0.5, 1)), max 1.600 over
    every fp32 x in (-0.5, 0) where x + 1 rounds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
    [fp32.py, language.py, otpu_fp.sv]
2026-10-07 recip and rsqrt: the last Newton step in correction form (y*e + y), recip on the significand
    Without a fused multiply-add, y = y*(2 - a*y) has a fixed point an ulp below 1/a: recip was up to
    1.99 ulp off (9.8% of inputs above 1 ulp) and an ulp low at every power of two (recip(1) =
    0.99999994); rsqrt likewise (1.95 ulp, rsqrt(1) = 0.99999994). Same op counts (RECIP 6, RSQRT 10):
    - recip runs on the significand a = bits(127 << 23 | frac(x)) in [1, 2): the seed, two Newton
    steps, then e = 1 - a*y, y = y*e + y, and y (in [0.5, 1]) gets 127 - (x's field) added to its
    exponent field. This replaces the |x| / 16 scaling of fields >= 250. Measured: max 1.153 ulp in
    every binade (mean 0.30, 0.2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
    [fp32.py, language.py, otpu_fp.sv, otpu_quant.sv, otpu_se_comp.sv, otpu_vpu.sv]
2026-10-07 fpcard.py: the composites at every power of two, every field and exp2's limits; the quantizer's recip on every exponent
    The card check for the exp2 / recip / rsqrt definitions (de72e8c, 42cef8b): composites' corner
    words as tests/test_fp_rtl.py's (powers of two and their neighbours, random words of every
    exponent field, rsqrt's scaled ranges, exp2 near 128 / -126 and where x + 1 rounds to 1, NaNs;
    40 rows of 64), and quantizer_recip: QST of an amax at every power of two, a neighbour and a
    random one of every few fields, the largest below 2^126 and across the point where
    127 * recip(amax) overflows (232 rows of 2 x 128 at the board's D).
2026-10-07 test_validate: the quantized golden's top-1 on every step but near ties (the tiny Gemma 4 flips one under the new recip / rsqrt)
    test_quantized_golden_follows_the_isa_simulator[gemma4-int8 / fp4] and
    test_the_command_line_on_a_tiny_gemma4 asked for every top-1 and the same greedy tokens. The tiny
    Gemma 4 has steps whose top two logits are 4e-4 apart, inside the golden's own rounding noise:
    with 42cef8b its device flips 2 of 16 (int8) and 3 of 16 (fp4) top-1 on the Mac, at the
    golden's floor (KL 1.0x and 0.6x the floor's; validate.py passes it: top-1 83% >= 80%). It is
    a coin toss, not a drift: the floor itself flips 1 and 2 of those steps, and over 12 model seeds
    main and the branch tie (Mac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
2026-10-07 Qwen3: K's outlier channels smoothed into the q_norm / k_norm gains (qwen3.qk_gains), weights only. Qwen3's k_norm gains have outlier channels (Qwen3-0.6B: up to 42x their layer's median) where q_nor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
2026-10-07 Expert pools get a key, <pool>.key (moe.pool_key: the quantizer's code, quant.py and for int8 fp32.py; the experts' format, D, the pool's and the slot's layout, the checkpoint's config.json), written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
2026-10-07 test_qwen35_moe: the device against HF routed as the card routed (every step but the last); a choice within the quantization's reach flips under the new recip / rsqrt (token sequence 1: 8 of 12 steps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
2026-10-07 docs: K smoothing (docs/quant.md, a new section: why Qwen3's K needs it, the rule, the measured KL before and after: Qwen3-0.6B's W+A golden vs fp32 on two fixed texts, 2,046 positions, int8 0.059 ->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
2026-10-07 fp32 zero signs pinned, and docs/isa.md says how far the arithmetic follows IEEE 754 (a review asked whether A - B with A == B gives -0 and whether rounding modes are missing). The adders are right: 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
2026-10-09 lens summary: terminal overview of a profile (roofline, units, classes)
    info is one line. The browser app already has the overview: roofline, where
    DRAM port B cycles went, unit utilisation, findings and instruction classes.
    summary prints that on the terminal from the same profile JSON, so a ssh
    session or a script can read a run without opening the app.
    RTL and hardware traces attribute every DRAM port-B cycle (streaming vs idle
    causes, same order as the app). ISA profiles skip that (no P/Q buckets) and
    still show units, findings and classes. --json writes the numbers; --slice
    selects a slice. otpu-lens summary passes through.
    Tests: ISA mlp-small and a synthetic bucketed profile.
    [hwlens.py, lens.py]
2026-10-09 otpu-smi: CAPS row, CSV log, Watch sparklines in -l mode
    The default table now names the bitstream's capability bits (trace depth,
    4-bit weights, stream engine, decode loop, and the rest of CAPS). They
    were already in --json and -q.
    -l keeps a short history of MAC, DRAM and RUN and draws a sparkline after
    the second sample. --csv FILE writes one row per sample (util, DRAM GB/s,
    tokens/s when a process is running). --samples N stops a loop after N
    samples, so a CSV log does not need Ctrl-C.
    Tests: FakeTransport, --samples 3 --csv, one-shot CSV, sparkline helpers.
    [smi.py]
2026-10-09 lens summary: reject out-of-range slices and tidy columns and JSON
    --slice outside the profile now exits with the valid range. The class
    column widens to the longest class name, list-valued board counters print
    as plain numbers, and --json serializes numpy scalars with .item() and
    raises TypeError for anything else.
2026-10-09 otpu-smi: the Caps row wraps instead of cutting names off
    PR #4's Caps row is one _kv line, 73 characters of value; the card's bitstream (1025907f) sets every CAPS bit, 94 characters, so the table cut off 'ddr act-rows temp' (the board model: 'act-row'). caps_rows() splits the names into lines of the value column's width, continued under an empty label. test_smi_caps_csv_and_watch: every bit set gives two rows, nothing lost.
2026-10-15 litepcie: the driver (opentpu/host/pcie/otpu: otpu_pcie, XDMA's node names and calls, zero-copy DMA in 256 KiB commands, completion record + MSI), tools/litepcie/sim_core.py (the core's DMA and otpu_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
2026-10-15 litepcie host: card_transport opens whichever driver has the card (LitePcieTransport on /dev/otpuN: XDMA's calls, 16-byte DMA alignment, no in-run H2C limit), card_dev / card_nodes / card_sysfs for e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
2026-10-15 litepcie: the stream slices reset with otpu_pcie_mm (sim_core.py: after a timeout's recovery a held beat led the next transfer); the driver's recovery halts both engines, lets every transfer leave an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
2026-10-15 docs: host.md and board.md with the LitePCIe bridge and its driver beside XDMA's
2026-10-15 litepcie: the 133.33 MHz full build's 250 MHz paths (dbf3dcfc: clkout3 -0.531 ns, 2504 endpoints). The PHY's TLP streams through register slices (RegisteredPHY: the TLP layer drove the hard block wra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
2026-10-15 litepcie: otpu_pcie_mm in the card's RTL list (opentpu.target BOARDS ypcb-00338: create_project.tcl and the Makefile had it, test_rtl_file_lists_agree failed) and in otpu_xunit's files and board test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
2026-10-15 litepcie: the last 250 MHz paths of 72da3027's full build (clkout3 -0.033 ns; core_clk +0.011, every other clock met): both DMA tables' retire registered (RetireRegTable: the writer's default retire,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
2026-10-15 litepcie: the card's idle checks see either driver's nodes (flash_jtag.sh, the offload sessions hostr21 / mtps: /dev/otpu0_* beside /dev/xdma0_*), ld_host.py's --dev the LitePCIe node when it is ther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
2026-10-15 otpu_mem_ch: XRD 32, the host DMA's read credits (its read-data FIFO is LUTRAM 32 deep at 16 too; the read tags' FIFO stays 128): tb_pcie_mm's C2H 0.713 -> 0.981 beats a cycle (3.9 GB/s at 250 MHz: 1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
2026-10-15 memch_test: the cred build at XRD 16 (ARD 16: otpu_mem_ch refuses XRD > ARD, the read tag's slot; XRD is 32 since 265cdfb8)
2026-11-10 rtl, sim: the core's wide-group (WG) memory path, a wider MXU option and multi-slice hubs for the BCU1525 targets; the two-card link's RTL and its test benches; board models for the BCU1525 builds
2026-11-10 boards/bcu1525, targets: the BCU1525 (Virtex UltraScale+ VU9P) builds: one card with four DDR4 DIMMs, two slices a card, and two cards over QSFP28; constraints, build scripts, the LiteDRAM and MIG me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
2026-11-10 tests: the BCU1525 targets, their board models and host paths
2026-11-10 BCU1525 chat: the caches say when they do not keep, the wrappers follow the image the cards hold
    The program cache's free-disk floor is 4 GiB (OTPU_PROG_CACHE_FREE_GB) and otpu-chat says when
    its disk is under it; the image cache does not write an entry larger than its size and otpu-chat
    prints why an image was not cached. otpu-chat runs a dense model on both cards of the two-card
    image (BCU_IMAGE) and refuses --card 0|1 there at once; BCU_RESUME is every wrapper's bring-up's
    --resume, with the wait for GO shown; a BCU_* variable in the environment wins over the host
    file; otpu-smi's Cards row before a bring-up reads as not set yet.
